cqframework/clinical_quality_language/Src/dotnet/readme.txt

Clinical Quality Language
.NET Tooling Support

This solution provides prototype implementations for:

* Visual Studio .NET 2013 Plugin to provide syntax highlighting for CQL libraries
* CQL-ELM Translator

For more information on these tools, refer to the Specification Overview document included with the specification materials.

Refer to the license.txt file for the license covering this software.
