cqframework/clinical_quality_language/Src/coffeescript/cql-execution/README.md

# New Location

The cql-execution framework has moved to its own repository.  You can now find the cql-execution framework here:
https://github.com/cqframework/cql-execution/
