cqframework/clinical_quality_language/Src/coffeescript/cql-execution/OVERVIEW.md

# New Location

The cql-execution framework has moved to its own repository.  You can now find the overview here:
https://github.com/cqframework/cql-execution/blob/master/OVERVIEW.md
