cqframework/clinical_quality_language/Documents/CQLUpdate_AllHands_20140904.pptx

## Clinical Quality Language Update

Clinical Quality Framework S&I Initiative
HL7 Clinical Decision Support
HL7 Clinical Quality Information
HL7 Implementable Technology Specifications

## Current Status

- CQL-ELM Translator
- Type Resolution
  - Model Info Structures
  - Primitive Type Resolution
  - Using Quick schema generated from UML
- Identifier Resolution
  - Libraries
  - Expressions
  - Functions
- Timing/Interval Operations
- Changes to ELM (from balloted spec) to match CQL

## Translation/Execution Overview

## Translation Example

exists ([Condition: "Chlamydia"])

<operand xsi:type="Exists">
<operand xsi:type="ClinicalRequest"
dataType="quick:ConditionOccurrence"
codeProperty="code" >
<codes name="Chlamydia" xsi:type="ValueSetRef"/>
</operand>
</operand>
