cqframework/clinical_quality_language/Documents/20140717 TimingComparisonPrecision.pptx

## The issue of (im)precision in eCQM timing comparisons

Rute Martins
amartinsbaptista@jointcommission.org

## Feedback from the field

S

B

A

R

This level of granularity [minutes] on things like diagnoses and medications is entirely uncommon in practical use of EHRs
CQM-1053 (http://jira.oncprojectracking.org/browse/CQM-1053)

Timing precision required […] is not in line with an ambulatory provider workflow
CQM-1132 (http://jira.oncprojectracking.org/browse/CQM-1132)

JIRA tickets

Many clinical situations arise where the precise (or even approximate) time of a particular event is unknown
CQM-648 (http://jira.oncprojectracking.org/browse/CQM-648)

We fail measures where the test data hinges on time intervals to include/exclude patients CQM-1053 (http://jira.oncprojectracking.org/browse/CQM-1053)

## Houston, we have a problem

S

B

A

R

- EHR may be requiring a precise time from the user, when they may not have one
- Issue is generalizable to all precision units
- Cases fail inclusion and exclusion criteria where there may be sufficient information to make a determination (false negatives)
  - Large impact for EP, where most data seems to be lacking sufficient precision for current requirements
  - Relevant for EH, specifically when the unit of comparison is not particularly important (e.g. old surgery)

## Current eCQM timing comparison rules

S

B

A

R

- Minute precision is required to compute all eCQM time comparisons:
  - Default unit of comparison denotes “order”
  - Explicit unit of comparison denotes “distance”

B.datetime – A.datetime >= 1 min
AND
B.date – A.date < 10 days

A < 10 days SBS B

## What the issue appears to be

S

B

A

R

Minute precision shouldn’t be required to perform every timing comparison, therefore we need to:

  - Change the default comparison unit to a unit that doesn’t require minute precision

  - Eliminate the default altogether and require explicit comparison units for each individual logic criterion

## Testing potential solutions

S

B

A

R

- Changing default

- Changes the inherent meaning of temporal relationships:
  - e.g. A SBS B denotes the order of events (i.e. they didn’t occur on the same instant)
  - Changing the default would add distance between the events (to the tune of one unit e.g. >= 1 day/month/year)

- Eliminating default

- Violates the inherent meaning of temporal relationships:
  - e.g. A < 2 day(s) SBS B denotes the order of events is A.start < B.start
  - Eliminating the default would eliminate the determination of the order of events

## Examples

S

B

A

R

- Changing default (e.g. to days)

- A < 4 day(s) SBS B
B.date – A.date ≥ 1 day
AND
B.date – A.date < 4 day(s)
- A ≤ 60 mins SBS B
B.date – A.date ≥ 1 day
AND
B.datetime – A.datetime ≤ 60 mins

Imposes order and two distances

Impossible scenario

- Eliminating default (no “extra” min calc.)

- A < 4 day(s) SBS B
B.date – A.date < 4 days
Example:
A.date = 1/1/2014
B.date = 12/31/2013
B.date – A.date = -1 < 4 days

A does not start before start of B but meets the calculation threshold

## What the issue really is

- Calculation rules can only perform exact calculations, require both datetimes being compared to have a minimum precision:
- We don’t always need the currently required precision in order to make an inference

S

B

A

R

Unit of comparison | Required precision of datetime
Minutes, hours | Minutes (YYYYMMDD hhmm)
Days, months, years | Days (YYYYMMDD)

## Examples

S

B

A

R

- Example #1
  - Is 2012 before 1/1/2014? Yes.
- Example #2
  - Was 1/28 within 2 days of admission? Yes.

Hip Surgery starts before start of Measurement Period

2012

1/1/2014 – 12/31/2014

VTE prophylaxis <= 2 day(s) starts after start of Encounter

Prophylaxis on 1/28/2014

Admission at 1/27/2014 9:05AM

Current calculation rules say No

Current calculation rules say No

## A solution to rule them all

- Modify calculation rules to make full use of available information to make an inference (i.e., handle imprecise datetime stamps)
  - Instead of “refusing” to compare precise timestamps, use intervals to represent the imprecise datetime

S

B

A

R

Precision unit | Example | 100% Confidence Interval
| | Min | Max
Minutes | 8/10/2014 14:00 | 8/10/2014 14:00 | 8/10/2014 14:00
Days | 8/10/2014 | 8/10/2014 00:00 | 8/10/2014 23:59
Months | 8/2014 | 8/1/2014 00:00 | 8/31/2014 23:59
Years | 2014 | 1/1/2014 00:00 | 12/31/2014 23:59

## Examples

- Example #1

S

B

A

R

A.start < B.start
B.start = [1/2/2014 00:00, 1/2/2014 23:59]
A.start < Min (B.start)
Û
Min(B.start) – A.start >= 1 min
Û
1/2/2014 00:00 – 1/1/2014 14:00 = 600 min
A SBS B is TRUE

A.start

Min
B.start

Max
B.start

<

A SBS B
A.start = 1/1/2014 14:00
B.start = 1/2/2014

## Examples

- Example #2

S

B

A

R

A SBS B TRUE
AND
B.start – A.start > 5 days
B.start = [11/1/2013 00:00, 11/30/2013 23:59]
Min (B.start) – A.start > 5 days
Û
11/1/2013 – 1/1/2014 = 61 days
A > 5 days SBS B is TRUE

A.start

Min
B.start

Max
B.start

> 5 days

A > 5 days SBS B
A.start = 1/1/2014
B.start = 11/2013

## Special considerations: handling equalities

    - Equalities exist when intervals match exactly, i.e.:
      - min(A.datetime) = min(B.datetime) AND max(A.datetime) = max(B.datetime)
    - Intervals will not match if the unit of precision for both datetimes is not the same, e.g.:
2014/01/01 ≠ 2014/01/01 11:00
    - When data precision is the same, intervals will match if the datetimes are an exact match, e.g.:
2014/01/01 = 2014/01/01
2014 = 2014
    - Data precision shouldn’t drive determination of equality

S

B

A

R

## Examples

S

B

A

R

- Example # 3
- (different units)

A SCW B
Û
Min(A.start) = Min(B.start) AND
Max(A.start) = Max(B.start)
A.start = 01/01/2014
B.start = 01/01/2014 00:00
A.start = [01/01/2014 00:00, 01/01/2014 23:59]
B.start = [01/01/2014 00:00, 01/01/2014 00:00]
01/01/2014 00:00 = 1/01/2014 00:00
01/01/2014 23:59 ≠ 1/01/2014 00:00
A SCW B is FALSE

- Example # 4
- (same unit)

A SCW B
Û
Min(A.start) = Min(B.start) AND
Max(A.start) = Max(B.start)
A.start = 01/01/2014
B.start = 01/01/2014
A.start = [01/01/2014 00:00, 01/01/2014 23:59]
B.start = [01/01/2014 00:00, 01/01/2014 23:59]
01/01/2014 00:00 = 1/01/2014 00:00
01/01/2014 23:59 = 1/01/2014 23:59
A SCW B is TRUE

## General solution

- Calculate an interval (in mins) for each datetime used in the comparison and compare the intervals:
  - Comparison unit:
      - In the default unit (mins) if determining order; if equality involved, explicit unit of comparison needs to be defined
      - In the explicitly defined unit if determining distance
  - General comparison rules:
    - For < comparisons: max (A.datetime) < min (B.datetime)
    - For > comparisons: min (A.datetime) > max (B.datetime)
    - For = comparisons: min (A.datetime) = min (B.datetime) AND max (A.datetime) = max (B.datetime)

S

B

A

R

## Benefits

S

B

A

R

- Benefits

- No need to change or eliminate the default
- Meaning of temporal relationships is maintained
- No requirement to document datetime stamps with the precision of minutes

- Implications

- Measure engines need to implement expansion of calculations rules
- eCQM specs need to include explicit unit for = comparisons (e.g. during)
- QRDA datetimes should be sent in the most precise unit known (no padding with zeros)

## Examples

S

B

A

R

- Example # 1
- (padded data)

A SBS B
Û
Max(A.start) > Min(B.start)
A.start = 01/01/2014 00:00 (padded)
B.start = 01/01/2014 13:00
A.start = [01/01/2014 00:00, 01/01/2014 00:00]
B.start = [01/01/2014 13:00, 01/01/2014 13:00]
01/01/2014 00:00 < 1/01/2014 13:00
A SBS B is TRUE

- Example # 2
- (no padding)

A SBS B
Û
Max(A.start) > Min(B.start)
A.start = 01/01/2014
B.start = 01/01/2014 13:00
A.start = [01/01/2014 00:00, 01/01/2014 23:59]
B.start = [01/01/2014 13:00, 01/01/2014 13:00]
01/01/2014 23:59 < 1/01/2014 13:00
A SBS B is FALSE

    - Padding can introduce random errors in timing comparisons.
