cqframework/clinical_quality_language/Documents/CQLUpdate_AllHands_20140604.pptx

## Clinical Quality Language (CQL)

Bryn Rhodes
Chris Moesel
Mark Kramer

## CQL Background

- Part of CQM-CDS harmonization project
- Objective is to define an author-friendly and human-readable language to define quality measures and decision support rules (QDM heritage)
- Must be computable and implementable (HeD heritage)
- Functional requirements defined in “Harmonization of Health Quality Artifact Reasoning and Expression Logic”

## Slide 3

Overview of CQL Conceptual Architecture

Initial Population Definition

Chlamydia Test Recommended

Defined by Rule/Measure authors using CQL

Probably Sexually Active

Intermediate inference

Concepts defined in Quality Logical Model (QUICK)

Condition, Occurrence

Patient

Medication Treatment, Ordered

Mappings from quality logical model to underlying data models

Integration with back-end data stores

FHIR Logic

FHIR API

EHR

…

Custom EHR Logic

EHR

…

CCDA Logic

CCDA Generator

EHR

REST API

e.g. SQL

## CQL File Structure

- Each library is a readable, plain text file
- May include other libraries by reference
- Logic in each file is potentially reusable by other libraries

Inputs
(parameters)

Declarations

Data Retrieval

Computation

May be comingled

Outputs

## CQL Declarations

- using declaration
  - Define the data model(s) in use in file
- include declaration
  - Define other libraries (CQL files) referenced
- context declaration
  - Define the overall context for the library (e.g. PATIENT or ENCOUNTER)
  - Anchors references in the file
- parameter declaration
  - Define available “inputs”
- valueset declaration
  - Define user-friendly labels for value sets within the library

## Simple Example

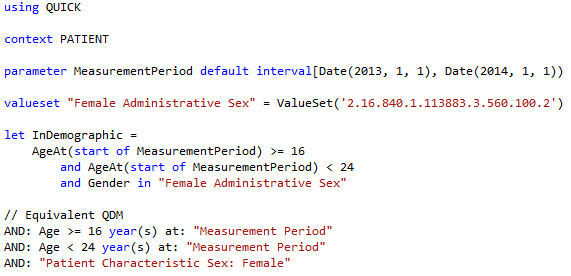
[picture p16: figure]

## Population Criteria

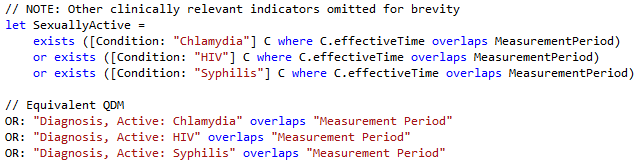
[picture p17: figure]

## Timing Phrases

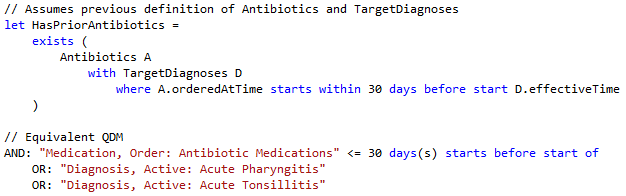
[picture p18: figure]

## Chlamydia Screening, CQM

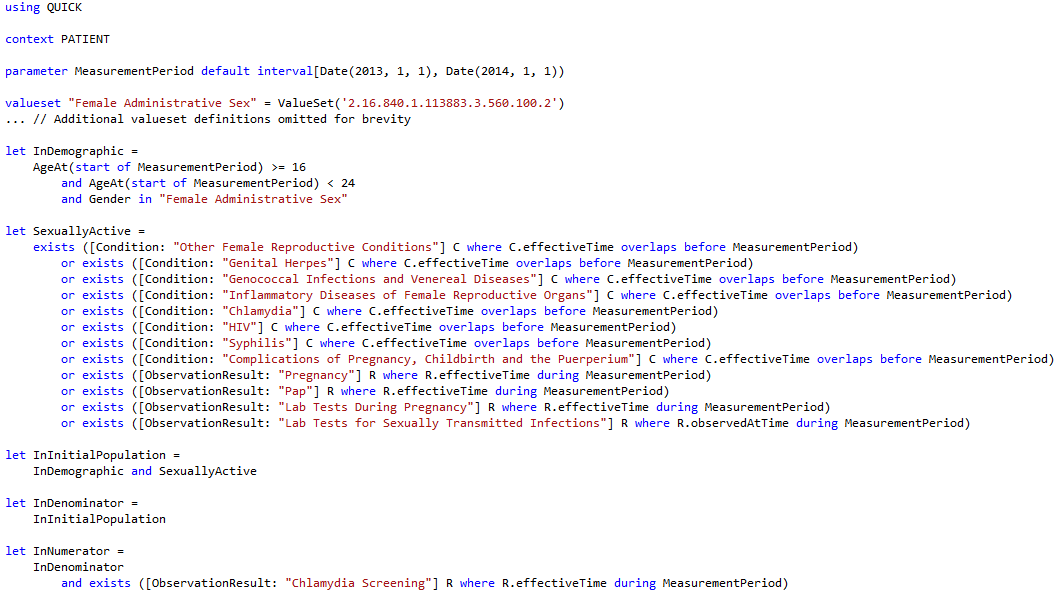
[picture p19: figure]

## Chlamydia Screening, CDS

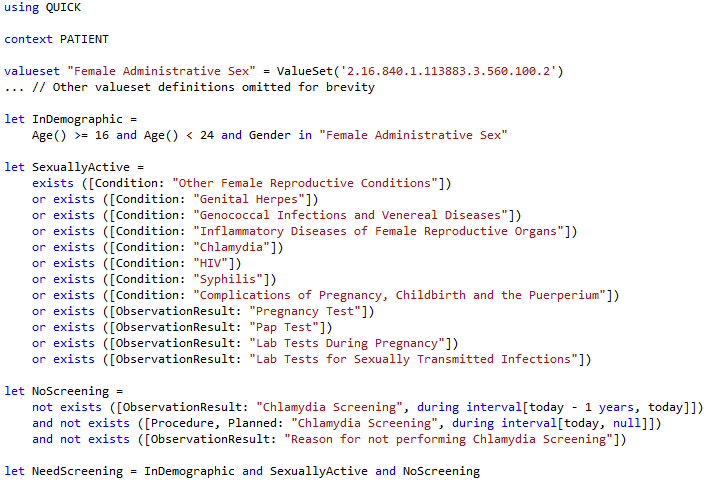
[picture p20: figure]

## Chlamydia Screening, Common


## Chlamydia Screening, CQM 2


## Chlamydia Screening, CDS 2


## Next Steps

- Still very much a work in progress
  - Completing/Refining the syntax
  - Mapping QUICK to FHIR
  - Performance/Implementation implications
  - Representation in XML artifacts
  - Clinical Quality Language Specification (ballot materials)
- Sub-team meets weekly, Wed 11:00 Eastern
  - https:// (https://global.gotomeeting.com/meeting/join/554237525)global.gotomeeting.com/meeting/join/554237525
  - Dial +1 770-657-9270, Participant Code: 6870541
- Using a common cqframework repository
  - https:// (https://github.com/cqframework/OneModel)github.com/cqframework/OneModel
