cqframework/clinical_quality_language/Documents/DataAccessSeparation_SideBySide.pptx

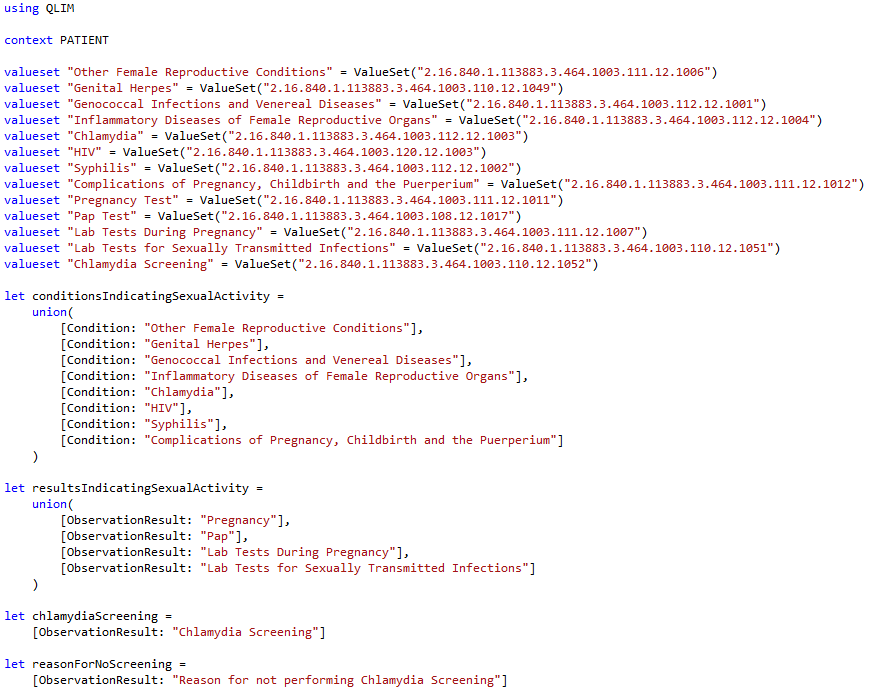
[picture p21: figure]

## Slide 2

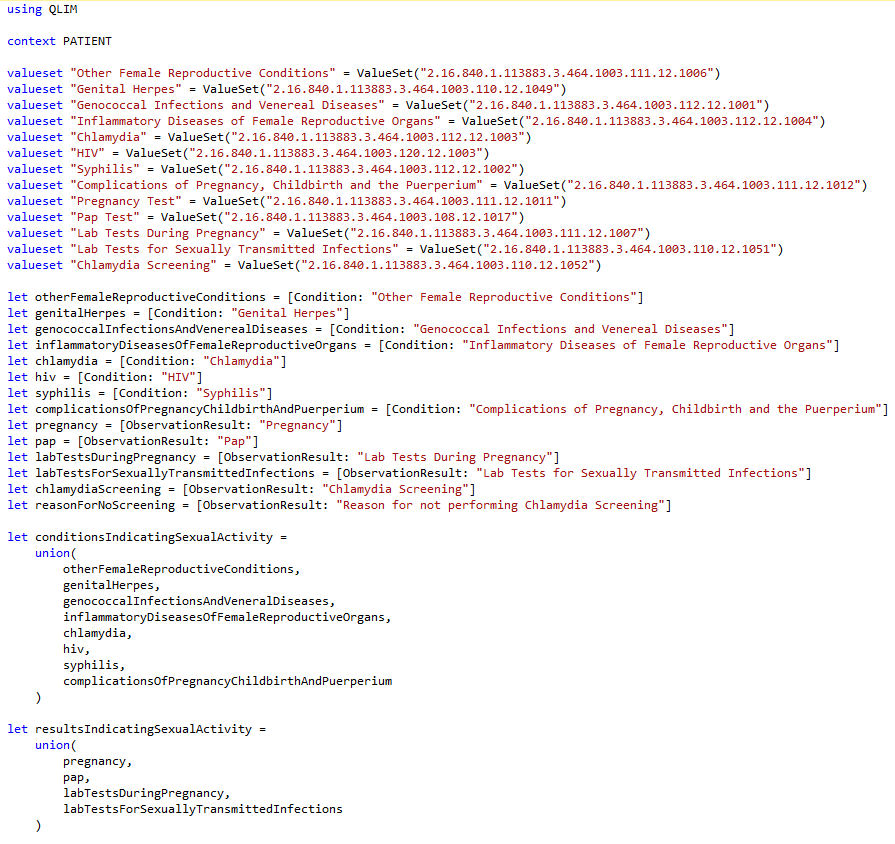
[picture p22: figure]
