cqframework/clinical_quality_language/Documents/WithAndCombine.pptx

## With Operator

The “with” filters the first operand (encounters in this case), by elements in the second operand (conditions) that match the criteria specified in the where. The result is the same type as the first operand (list<EncounterPerformed>).

## Combine Operator

The “combine” also returns only those rows that match in each operand, but it returns both sides of the operation.
So the result of this is of type list<tuple<E: Encounter, Performed, P: Condition>>
The problem is that because we don’t have a “select” clause we can’t name the attributes of the result, so we have to just use the aliases that were given in query. But that means…

## Subsequent Filtering

Subsequent operations have to deal with the “combined context” as it was labeled when the combine was defined. So in the first example, accessing the providerType attribute has to use E.E, instead of just E. We could allow implicit resolution, so the user could say E.providerType, but that would allow potentially ambiguous references.
In addition, we would have to make it illegal semantically to introduce an alias that was already present in a “combined context”, and we would have no way to perform a “rename” to get over that issue, it would force the users to understand this notion and write the queries accordingly. It’s not insoluble, I’m just concerned that it’s very complicated.

## Potential Solution

Allow an option “return” clause to be included in a query. This would allow the user to specify the names for each attribute.
If the clause was omitted, we would default the attribute names to the aliases used in the query.

## Potential Solution (cont.)

This would also allow a flattened result to be described as part of the query.
Thoughts?
