cqframework/clinical_quality_language/Documents/CQLUpdate_AllHands_20140529.pptx

## Clinical Quality Language

- Builds on functional requirements defined in:
  - Harmonization of Health Quality Artifact Reasoning and Expression Logic
- Leverages
  - Computability achieved by HeD
  - Measure Author understanding (QDM Heritage)
- Focus of the high-level syntax is on authoring
  - While providing a clear/automatic path to computable logic

## Slide 2

Underlying Language and Data Source are both variable

There are ways device use could be inferred - if not, return “unknown”

Some Population Definition

Chlamydia Test Recommended

BLUE = available concepts

DSL can reference high-level concept of “ChlamydiaTest”

In the same way that lower-level concepts can be referenced

Uses Device

Sexually Active

Condition

Procedure

Medication

Including the concepts explicitly defined in the “logical model”

e.g. Condition.evaluate (DataSource, Occurrence, Filter)

We implement at least this
e.g. as Java library

FHIR Logic

FHIR API

…

Custom EHR Logic

EHR

…

CCDA Logic

As well as Data Format Specific concepts that implement a common “data provider” interface in terms of the logical model

Back end data stores

REST API

e.g. SQL

## Anatomy of a Library

- using statements
  - Define the data model(s) in use by the library
- include statements
  - Define other libraries referenced by the library
- context definition
  - Define the overall context for the library (e.g. PATIENT or ENCOUNTER)
  - system-understood
  - in terms of the model
- parameter definitions
  - Define available “inputs”
- concept definitions
  - Define user-friendly labels for value sets within the library
- let statements
  - Define the expressions that are available within the library
  - Can be used by the containing artifact or other referencing libraries

## Simple Example

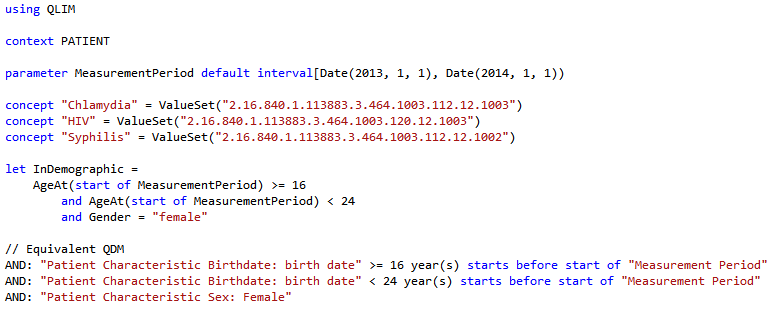
[picture p23: figure]

## Population Criteria

## Timing Phrases

## Chlamydia Screening, CQM

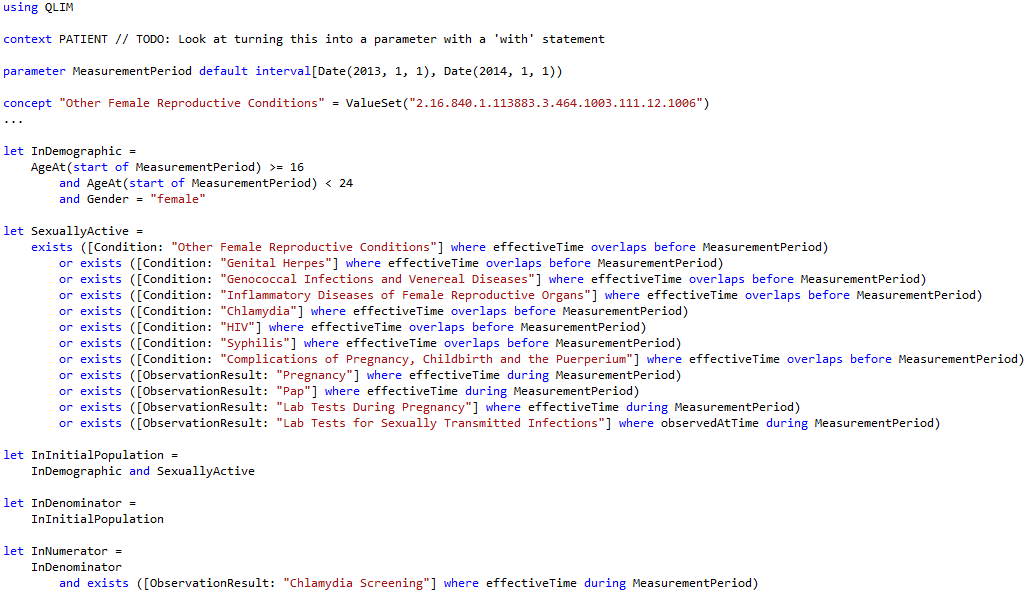
[picture p24: figure]

## Chlamydia Screening, CDS

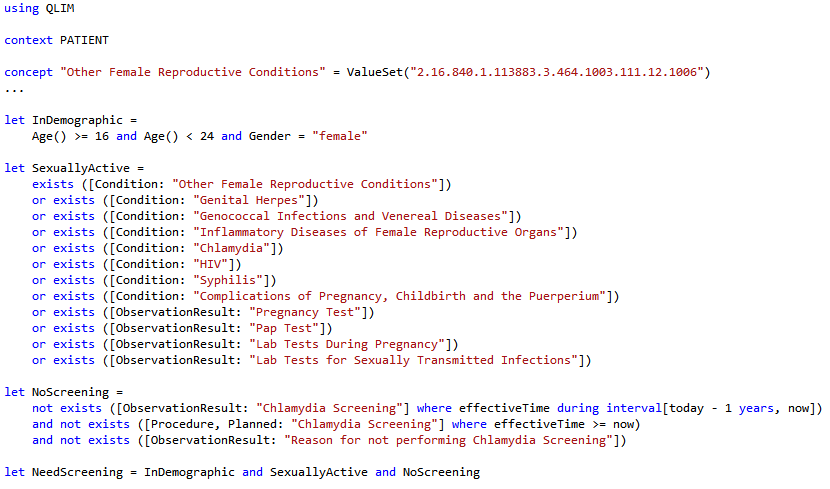
[picture p25: figure]

## Next Steps

- Still very much a work in progress
  - Completing/Refining the syntax
  - Mapping QLIM to FHIR
  - Performance/Implementation implications
  - Representation in XML artifacts
  - Clinical Quality Language Specification (ballot materials)
- Sub-team meets weekly, Wed 11:00 Eastern
- Will use the same Git repository as QLIM team
