cqframework/clinical_quality_language/engine-fhir/src/jvmTest/resources/org/opencds/cqf/cql/engine/fhir/data/EvaluatedResourcesMultiLibComplexDepsTest.md

# Test CQL Dependencies Flowchart

```mermaid
flowchart BT
    Level1A.cql --> Level2.cql
    Level1B.cql --> Level2.cql
    Level2.cql --> Level3A.cql
    Level3A.cql --> Level5.cql
    Level1B.cql --> Level3B.cql
    Level3B.cql --> Level4.cql
    Level4.cql --> Level5.cql
```
