cqframework/clinical_quality_language/(threads)

Thread 53 (2016-06-14):

need to specify version requirements for java files

ErichBSchulz, 2016-06-14:
in Src/java/README.md

ErichBSchulz, 2016-06-14:
fyi I just tried to build in java 6, 7, 8 and 9

6 and 7 both seemed to go furtherest but failed with

```:cql:test FAILED

FAILURE: Build failed with an exception.

* What went wrong:
Execution failed for task ':cql:test'.
> There were failing tests. See the report at: file:///usr/src/myapp/cql/build/repor
ts/tests/index.html

* Try:
Run with --stacktrace option to get the stack trace. Run with --info or --debug opti
on to get more log output.

BUILD FAILED
```

java8 failed with

```FAILURE: Build failed with an exception.

* Where:
Build file '/usr/src/myapp/elm/build.gradle' line: 12

* What went wrong:
Execution failed for task ':elm:generateSources'.
> unable to parse the schema. Error messages should have been provided
```

this was all using vanilla java dockers as specified here: https://hub.docker.com/_/java/

cmoesel, 2016-06-14:
As noted in the other issue (#54), JDK 1.8 is required -- and it's only been tested using the official Oracle JDK (not OpenJDK).  I wouldn't _expect_ OpenJDK to cause problems, but if we can't trace the problems to anything else, then it certainly _might_ be OpenJDK.

cmoesel, 2016-06-14:
I've updated the README to reflect that JDK 1.8 is required and to provide a link to the Oracle downloads for JDK 1.8.

ErichBSchulz, 2016-06-14:
thanks Chris - I'll see if I can get an oracle 1.8 Dockerfile up

worth noting [this](http://blog.takipi.com/running-java-on-docker-youre-breaking-the-law/) and the comments [here](https://hub.docker.com/_/java/) regarding oracle licencing tho.

ErichBSchulz, 2016-06-14:
fyi this is my dockerfile:

https://bitbucket.org/erichbschulz/cql_java/src/347dea68e43e69b54650c5fbd874a53ecbdef8e9/Dockerfile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

(because it was a shiny new docker vm this was a completely clean build)

I tried it again with the --info and --debug ...

this seems to be when the wheels fall off:

```
21:20:33.350 [DEBUG] [org.gradle.api.internal.project.ant.AntLoggingAdapter] Class com.sun.org.apac
he.xerces.internal.impl.dv.xs.SchemaDVFactoryImpl loaded from parent loader (parentFirst)
21:20:33.359 [DEBUG] [org.gradle.api.internal.project.ant.AntLoggingAdapter] Couldn't load Resource
Stream for META-INF/services/org.xml.sax.driver
21:20:33.360 [DEBUG] [org.gradle.api.internal.project.ant.AntLoggingAdapter] Couldn't load Resource
Stream for META-INF/services/org.xml.sax.driver
21:20:33.363 [ERROR] [org.gradle.api.internal.project.ant.AntLoggingAdapter] [ant:xjc] [ERROR] sche
ma_reference.4: Failed to read schema document 'file:/usr/src/cql-lm/schema/elm/library.xsd', becau
se 1) could not find the document; 2) the document could not be read; 3) the root element of the do
cument is not <xsd:schema>.
21:20:33.364 [ERROR] [org.gradle.api.internal.project.ant.AntLoggingAdapter] [ant:xjc] unknown loca
tion
21:20:33.364 [ERROR] [org.gradle.api.internal.project.ant.AntLoggingAdapter] [ant:xjc]
21:20:33.365 [INFO] [org.gradle.api.internal.project.ant.AntLoggingAdapter] [ant:xjc] failure in th
e XJC task. Use the Ant -verbose switch for more details
21:20:33.366 [DEBUG] [org.gradle.api.internal.tasks.execution.ExecuteAtMostOnceTaskExecuter] Finish
ed executing task ':elm:generateSources'
21:20:33.366 [LIFECYCLE] [class org.gradle.TaskExecutionLogger] :elm:generateSources FAILED
21:20:33.366 [INFO] [org.gradle.execution.taskgraph.AbstractTaskPlanExecutor] :elm:generateSources
(Thread[main,5,main]) completed. Took 3.439 secs.
21:20:33.367 [DEBUG] [org.gradle.execution.taskgraph.AbstractTaskPlanExecutor] Task worker [Thread[
main,5,main]] finished, busy: 4.23 secs, idle: 0.01 secs
21:20:33.373 [ERROR] [org.gradle.BuildExceptionReporter]
21:20:33.373 [ERROR] [org.gradle.BuildExceptionReporter] FAILURE: Build failed with an exception.

```

Closed 2016-06-14.

Thread 54 (2016-06-14):

build failing

ErichBSchulz, 2016-06-14:
I just tried to build in java 6, 7, 8 and 9 (using vanilla java dockers as specified here: https://hub.docker.com/_/java/)

6 and 7 both seemed to go furtherest but failed with

```
:cql:test FAILED

FAILURE: Build failed with an exception.

* What went wrong:
Execution failed for task ':cql:test'.
> There were failing tests. See the report at: file:///usr/src/myapp/cql/build/repor
ts/tests/index.html

* Try:
Run with --stacktrace option to get the stack trace. Run with --info or --debug opti
on to get more log output.

BUILD FAILED
```

java8 failed with

```
FAILURE: Build failed with an exception.

* Where:
Build file '/usr/src/myapp/elm/build.gradle' line: 12

* What went wrong:
Execution failed for task ':elm:generateSources'.
> unable to parse the schema. Error messages should have been provided
```

cmoesel, 2016-06-14:
We've never tested this using the Docker java, nor have we tested it using OpenJDK (which is what Docker is using).  It's possible that there's an issue somewhere in there, although it's hard to say.

It should work fine using the official Oracle Java SDK 1.8.0_x.  I am using 1.8.0_92 on Mac OS X and can build cleanly.  In addition, the [Travis builds](https://travis-ci.org/cqframework/clinical_quality_language) pass with Oracle JDK 1.8.0_31 (which actually run on a Linux Docker container of some sort).

I'd suggest you use 1.8 and try a clean build (in case there are build remnants messing things up):
```
./gradlew clean build
```

If it still doesn't work, might you be able to use a natively installed Oracle JDK rather than the dockerized OpenJDK?

ErichBSchulz, 2016-06-14:
Thanks Chris

I'm now on a dockerised oracle java 8 and I'm getting this:

```
:elm:generateSources FAILED

FAILURE: Build failed with an exception.

* Where:
Build file '/usr/src/myapp/elm/build.gradle' line: 12

* What went wrong:
Execution failed for task ':elm:generateSources'.
> unable to parse the schema. Error messages should have been provided

* Try:
Run with --stacktrace option to get the stack trace. Run with --info or --debug option to get more log output.

BUILD FAILED
```

`java -version ` gives:

```
java version "1.8.0_91"
Java(TM) SE Runtime Environment (build 1.8.0_91-b14)
Java HotSpot(TM) 64-Bit Server VM (build 25.91-b14, mixed mode)
```

brynrhodes, 2016-06-14:
Can you add the --debug option and see if we get more information about the error?

ErichBSchulz, 2016-06-14:
here we go:
```
23:37:16.124 [DEBUG] [org.gradle.api.internal.tasks.execution.ExecuteActionsTaskExecut
er                                                                                   ]
                                                                                     E
xecuting actions for task ':cql:compileJava'.
23:37:16.127 [INFO] [org.gradle.api.internal.changedetection.changes.RebuildIncrementa
lTaskInputs                                                                          ]
                                                                                     A
ll input files are considered out-of-date for incremental task ':cql:compileJava'.
23:37:16.136 [DEBUG] [org.gradle.api.internal.tasks.compile.NormalizingJavaCompiler] C
ompiler arguments: -d /usr/src/myapp/cql/build/classes/main -g -sourcepath /usr/src/my
app/cql/build/tmp/compileJava/emptySourcePathRef -classpath /root/.gradle/caches/modul
es-2/files-2.1/org.antlr/antlr4/4.5/af4a530e3cd7fa03636645d8077145eefac12907/antlr4-4.
5.jar:/root/.gradle/caches/modules-2/files-2.1/org.antlr/antlr4-runtime/4.5/29e48af049
f17dd89153b83a7ad5d01b3b4bcdda/antlr4-runtime-4.5.jar:/root/.gradle/caches/modules-2/f
iles-2.1/org.antlr/antlr-runtime/3.5.2/cd9cd41361c155f3af0f653009dcecb08d8b4afd/antlr-
runtime-3.5.2.jar:/root/.gradle/caches/modules-2/files-2.1/org.antlr/ST4/4.0.8/a1c55e9
74f8a94d78e2348fa6ff63f4fa1fae64/ST4-4.0.8.jar:/root/.gradle/caches/modules-2/files-2.
1/org.abego.treelayout/org.abego.treelayout.core/1.0.1/e31e79cba7a5414cf18fa69f3f0a2cf
9ee997b61/org.abego.treelayout.core-1.0.1.jar /usr/src/myapp/cql/src/main/java/org/cqf
ramework/cql/Main.java -XDuseUnsharedTable=true
23:37:16.136 [INFO] [org.gradle.api.internal.tasks.compile.JdkJavaCompiler] Compiling
with JDK Java compiler API.
23:37:16.333 [ERROR] [system.err] /usr/src/myapp/cql/src/main/java/org/cqframework/cql
/Main.java:6: error: package org.cqframework.cql.gen does not exist
23:37:16.333 [ERROR] [system.err] import org.cqframework.cql.gen.cqlLexer;
23:37:16.333 [ERROR] [system.err]                               ^
23:37:16.334 [ERROR] [system.err] /usr/src/myapp/cql/src/main/java/org/cqframework/cql
/Main.java:7: error: package org.cqframework.cql.gen does not exist
23:37:16.334 [ERROR] [system.err] import org.cqframework.cql.gen.cqlParser;
23:37:16.334 [ERROR] [system.err]                               ^
23:37:16.357 [ERROR] [system.err] /usr/src/myapp/cql/src/main/java/org/cqframework/cql
/Main.java:25: error: cannot find symbol
23:37:16.357 [ERROR] [system.err]         cqlLexer lexer = new cqlLexer(input);
23:37:16.357 [ERROR] [system.err]         ^
23:37:16.358 [ERROR] [system.err]   symbol:   class cqlLexer
23:37:16.358 [ERROR] [system.err]   location: class Main
23:37:16.358 [ERROR] [system.err] /usr/src/myapp/cql/src/main/java/org/cqframework/cql
/Main.java:25: error: cannot find symbol
23:37:16.358 [ERROR] [system.err]         cqlLexer lexer = new cqlLexer(input);
23:37:16.358 [ERROR] [system.err]                              ^
23:37:16.358 [ERROR] [system.err]   symbol:   class cqlLexer
23:37:16.358 [ERROR] [system.err]   location: class Main
23:37:16.359 [ERROR] [system.err] /usr/src/myapp/cql/src/main/java/org/cqframework/cql
/Main.java:27: error: cannot find symbol
23:37:16.360 [ERROR] [system.err]         cqlParser parser = new cqlParser(tokens);
23:37:16.360 [ERROR] [system.err]         ^
23:37:16.360 [ERROR] [system.err]   symbol:   class cqlParser
23:37:16.360 [ERROR] [system.err]   location: class Main
23:37:16.360 [ERROR] [system.err] /usr/src/myapp/cql/src/main/java/org/cqframework/cql
/Main.java:27: error: cannot find symbol
23:37:16.361 [ERROR] [system.err]         cqlParser parser = new cqlParser(tokens);
23:37:16.361 [ERROR] [system.err]                                ^
23:37:16.361 [ERROR] [system.err]   symbol:   class cqlParser
23:37:16.361 [ERROR] [system.err]   location: class Main
23:37:16.376 [ERROR] [system.err] 6 errors
23:37:16.378 [DEBUG] [org.gradle.api.internal.tasks.execution.ExecuteAtMostOnceTaskExe
cuter                                                                                ]
                                                                                     F
inished executing task ':cql:compileJava'
23:37:16.378 [LIFECYCLE] [class org.gradle.TaskExecutionLogger] :cql:compileJava FAILE
D
23:37:16.379 [INFO] [org.gradle.execution.taskgraph.AbstractTaskPlanExecutor] :cql:com
pileJava (Thread[main,5,main]) completed. Took 14.68 secs.
23:37:16.379 [DEBUG] [org.gradle.execution.taskgraph.AbstractTaskPlanExecutor] Task wo
rker [Thread[main,5,main]] finished, busy: 14.694 secs, idle: 0.002 secs
23:37:16.385 [ERROR] [org.gradle.BuildExceptionReporter]
23:37:16.385 [ERROR] [org.gradle.BuildExceptionReporter] FAILURE: Build failed with an
 exception.
23:37:16.386 [ERROR] [org.gradle.BuildExceptionReporter]
23:37:16.386 [ERROR] [org.gradle.BuildExceptionReporter] * What went wrong:
23:37:16.386 [ERROR] [org.gradle.BuildExceptionReporter] Execution failed for task ':c
ql:compileJava'.
23:37:16.386 [ERROR] [org.gradle.BuildExceptionReporter] > Compilation failed; see the
 compiler error output for details.
23:37:16.386 [ERROR] [org.gradle.BuildExceptionReporter]
23:37:16.387 [ERROR] [org.gradle.BuildExceptionReporter] * Try:
23:37:16.387 [ERROR] [org.gradle.BuildExceptionReporter] Run with --stacktrace option
to get the stack trace.
23:37:16.387 [LIFECYCLE] [org.gradle.BuildResultLogger]
23:37:16.388 [LIFECYCLE] [org.gradle.BuildResultLogger] BUILD FAILED
23:37:16.388 [LIFECYCLE] [org.gradle.BuildResultLogger]
```

ErichBSchulz, 2016-06-15:
here is full log of build in case you need that:

[build.txt](https://github.com/cqframework/clinical_quality_language/files/315193/build.txt)

brynrhodes, 2016-06-15:
It looks like the generateSources step didn't run for the cql project (that's where the Antlr4 generation is happening). That's the only thing I can see that would cause that error in the debug. Not sure why it wouldn't be running (and I don't see anything in the build.txt that indicates anything went wrong with downloading the Antlr dependency). Can you try running just the generateGrammarSource task? Maybe something's going wrong there that isn't showing up in the build logs here.

ErichBSchulz, 2016-06-15:
Happy too, but how do I do that?

Sent from pad please excuse brevity
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

ErichBSchulz, 2016-06-16:
ok different error now after manually firing `./gradlew generateGrammarSource`

```
00:04:45.892 [ERROR] [org.gradle.api.internal.project.ant.AntLoggingAdapte
r] [ant:xjc] [ERROR] schema_reference.4: Failed to read schema document 'f
ile:/usr/src/cql-lm/schema/elm/library.xsd', because 1) could not find the
 document; 2) the document could not be read; 3) the root element of the d
ocument is not <xsd:schema>.
00:04:45.894 [ERROR] [org.gradle.api.internal.project.ant.AntLoggingAdapte
r] [ant:xjc] unknown location
00:04:45.895 [ERROR] [org.gradle.api.internal.project.ant.AntLoggingAdapte
r] [ant:xjc]
00:04:45.903 [ERROR] [org.gradle.BuildExceptionReporter]
00:04:45.904 [ERROR] [org.gradle.BuildExceptionReporter] FAILURE: Build fa
iled with an exception.
00:04:45.904 [ERROR] [org.gradle.BuildExceptionReporter]
00:04:45.905 [ERROR] [org.gradle.BuildExceptionReporter] * Where:
00:04:45.905 [ERROR] [org.gradle.BuildExceptionReporter] Build file '/usr/
src/myapp/elm/build.gradle' line: 12
00:04:45.905 [ERROR] [org.gradle.BuildExceptionReporter]
00:04:45.905 [ERROR] [org.gradle.BuildExceptionReporter] * What went wrong
:
00:04:45.905 [ERROR] [org.gradle.BuildExceptionReporter] Execution failed
for task ':elm:generateSources'.
00:04:45.906 [ERROR] [org.gradle.BuildExceptionReporter] > unable to parse
 the schema. Error messages should have been provided
00:04:45.906 [ERROR] [org.gradle.BuildExceptionReporter]
00:04:45.906 [ERROR] [org.gradle.BuildExceptionReporter] * Try:
00:04:45.906 [ERROR] [org.gradle.BuildExceptionReporter] Run with --stackt
race option to get the stack trace.
```
[log1.txt](https://github.com/cqframework/clinical_quality_language/files/317416/log1.txt)

cmoesel, 2016-06-16:
Interesting.  It says it is not able to find the ELM XSD.  I remember seeing a previous error in one of your logs that looked like it couldn't find the CQL grammar.  So... it seems like it is having trouble finding some of the files in other source paths.  Is this possibly a docker thing with the file paths?

Did you checkout the whole _clinical-quality-language_ repository and leave it in-tact?  It looks like you may have modified some paths.  I noticed in the log above that it references a build file at `'/usr/
src/myapp/elm/build.gradle'`.   That's not a valid path in our repo (it _should_ be `'clinical-quality-language/Src/java/elm/build.gradle'`).  Are you trying to embed this code into a different codebase?  If so, that's probably your problem -- the elm module is expecting to find specific files and projects using relative paths within the _whole_ repo.  If you just copied out part of the repo, those parts of the build would fail.  Is that possibly what's going on?

Do you actually need/want to build the source code, or do you really just need to use it (unmodified) in your project?  If the latter, then you might be better off just using our jars from Maven Central: http://search.maven.org/#search%7Cga%7C1%7Cg%3A%22info.cqframework%22

ErichBSchulz, 2016-06-16:
ah thanks Chris - I just need to shift my mount point higher up the tree - I'm only mounting from Src/java down

standby :-)

cmoesel, 2016-06-16:
Great.  Let me know how it goes.  If successful, I wouldn't be surprised if you can also switch back to OpenJDK 8.  The mount point has probably been the problem all along.  Sorry I didn't notice it earlier!

ErichBSchulz, 2016-06-16:
ah that would be nice

its running now

would you like a nice docker image for the project to run in?

cmoesel, 2016-06-16:
Woot indeed!  Sorry it took so long to get here, but I'm glad we finally made it!  Thanks @brynrhodes for your help too!  Regarding a docker image, I'm (sadly) not really in this project much anymore -- so I'll let Bryn decide if he wants to pursue that.

I'm closing this issue, but please do come back and let us know if you try OpenJDK and it works!

ErichBSchulz, 2016-06-16:
all good - thanks for the help :-)

Closed 2016-06-16.

Thread 60 (2016-07-29):

Unable to Union different QDM Types

JSRankins, 2016-07-29:
Several eCQMs published in 2015 and 2016 have used "union" to group events that are of different types (CMS 100 v5, CMS 102 v5, CMS 107 v5, etc.). However, something like the following is causing an error to be thrown in the CQL-to-ELM validation:

define "Interventions":
      ["Intervention, Order"] union ["Intervention, Performed"]

The following error is being thrown:
Could not resolve call to operator Union with signature (list&lt;QDM.InterventionOrder&gt;,list&lt;QDM.InterventionPerformed&gt;).

Is this by design, or is this an issue in the current code?

cmoesel, 2016-07-29:
I believe that this is by design, in order to ensure type safety.  If you look at the signature for union in the appendix of the specification, you'll see:

```
union(left List<T>, right List<T>) List<T>
```

The arguments as well as the return are all lists of `T` -- meaning that the contained objects must have the same type.

It's probably worth looking at the measure to see if creating a union of these different types really is the best approach.  It may be that CQL provides a better path to achieve what the measure needs.  That's the first thing I'd do.

If that isn't possible, or if creating a union like this is really best, then you may be able to union these together by casting the list elements to `QDM.QDMBaseType` first.  I can't remember if you can cast a whole list at once, or if you'd have to use a query to transform the list into a list of casted objects.  Either way, you'd end up unioning two lists of `QDM.QDMBaseType`, resulting in a list of `QDM.QDMBaseType`.

JSRankins, 2016-07-29:
Thanks Chris. I'll try both approaches. Ultimately, I think the Measure Stewards are going to need to know this for their measures. It might be a good thing to send to @brynrhodes for one of the Cooking With CQL trainings. Bryn, what do you think?

brynrhodes, 2016-08-15:
Yep, this would be a great example for inclusion in a measure training, I'll add it to my list. As far as casting, there isn't a list-based cast, you'd have to do a query and return the resulting type. Another option is to shape each operand so that they both contain the same columns, then you wouldn't need to cast. Am I okay to close this issue?

JSRankins, 2016-08-15:
Yes.

>>> Bryn Rhodes <notifications@github.com> 8/15/2016 1:44 PM >>>

Yep, this would be a great example for inclusion in a measure training, I'll add it to my list. As far as casting, there isn't a list-based cast, you'd have to do a query and return the resulting type. Another option is to shape each operand so that they both contain the same columns, then you wouldn't need to cast. Am I okay to close this issue?

—
You are receiving this because you authored the thread.
Reply to this email directly, view it on GitHub, or mute the thread.

 {"api_version":"1.0","publisher":{"api_key":"05dde50f1d1a384dd78767c55493e4bb","name":"GitHub"},"entity":{"external_key":"github/cqframework/clinical_quality_language","title":"cqframework/clinical_quality_language","subtitle":"GitHub repository","main_image_url":"https://cloud.githubusercontent.com/assets/143418/17495839/a5054eac-5d88-11e6-95fc-7290892c7bb5.png","avatar_image_url":"https://cloud.githubusercontent.com/assets/143418/15842166/7c72db34-2c0b-11e6-9aed-b52498112777.png","action":{"name":"Open in GitHub","url":"https://github.com/cqframework/clinical_quality_language"}},"updates":{"snippets":[{"icon":"PERSON","message":"@brynrhodes in #60: Yep, this would be a great example for inclusion in a measure training, I'll add it to my list. As far as casting, there isn't a list-based cast, you'd have to do a query and return the resulting type. Another option is to shape each operand so that they both contain the same columns, then you wouldn't need to cast. Am I okay to close this issue?"}],"action":{"name":"View Issue","url":"https://github.com/cqframework/clinical_quality_language/issues/60#issuecomment-239890653"}}}

JSRankins, 2016-08-24:
Sorry for just responding. You can close this issue.

Closed 2016-08-18.

Thread 61 (2016-08-19):

Annotations in JSON

brynrhodes, 2016-08-19:
Annotations in XML work as expected because the content of the annotation is an html fragment. However, when the ELM is output as JSON, the rendering is very difficult to reconstruct. There needs to be a better way to communicate the content of the annotation when the output is formatted using JSON.

pkmitre, 2016-08-29:
The current XML annotation is difficult to represent in JSON because the XML uses mixed content, ie

    <annotation xsi:type="a:Annotation">
      <a:s r="27">
        define PatientAge:
        <a:s r="26">
          AgeInYearsAt(
          <a:s r="25">
            start of
            <a:s r="24">MeasurementPeriod</a:s>
          </a:s>
          )
        </a:s>
      </a:s>
    </annotation>

In the JSON, all of the text strings within a tag, regardless of ordering relationship to other neighbor tags, are simply represented as an array of strings, ie

                    "value": [
                      "AgeInYearsAt",
                      "(",
                      ")"
                    ]

The relationship of the strings to the other tags is not preserved. Would it work to simply avoid the use of mixed content? For example, something like

    <annotation xsi:type="a:Annotation">
      <a:s r="27">
        <a:s>define PatientAge:</a:s>
        <a:s r="26">
          <a:s>AgeInYearsAt(</a:s>
          <a:s r="25">
            <a:s>start of</a:s>
            <a:s r="24">MeasurementPeriod</a:s>
          </a:s>
          <a:s>)</a:s>
        </a:s>
      </a:s>
    </annotation>

This could be represented in unambiguous JSON.

brynrhodes, 2017-03-23:
This issue was corrected by pull request #94 and the fix will be included in the next release.

Closed 2017-03-23.

Thread 63 (2016-08-24):

QDM 5.0 Model Info

JSRankins, 2016-08-24:
Questions about the following file: https://github.com/cqframework/clinical_quality_language/tree/modelinfo-profiles/Src/java/qdm/src/main/resources/gov/healthit/qdm/qdm-modelinfo-5.0.xml

**First:** The file contains the following label values for the patient characteristic datatypes:

- Patient Characteristic: Birthdate
- Patient Characteristic: Clinical Trial Participant
- Patient Characteristic: Ethnicity
- Patient Characteristic: Expired
- Patient Characteristic: Payer
- Patient Characteristic: Race
- Patient Characteristic: Sex

Based on the draft QDM 5.0 document (https://ecqi.healthit.gov/system/files/qdm_5_0_draft_.pdf), none of these datatypes contain colons.

**Second:** It appears that the generic "Patient Characteristic" datatype is missing from the model info file. Since this datatype is part of QDM 5.0, how is this datatype being handled?

**Third:** There is a typo for the DeviceApplied element anatomialLocationSite - should be anatomi**c**alLocationSite

brynrhodes, 2016-09-06:
Agreed on all counts, thank you for the detailed review. These changes have been made to the 5.0 and 5.0.1 xsd and model info files.

Closed 2016-09-06.

Thread 65 (2016-08-30):

Minimum date test case

brynrhodes, 2016-08-30:
[Minimum Date Test Case CQLIT-17](https://oncprojectracking.healthit.gov/support/browse/CQLIT-17)

i note the spec says (p154):

Description:
The DateTime type represents date and time values with potential uncertainty within CQL.
CQL supports date and time values in the range @0001-01-01T00:00:00.0 to @9999-12-
31T23:59:59.999 with a 1 millisecond step size.

however there there is a test case defined which suggest this should throw:

define Predecessor_min_date: predecessor of DateTime(1900,01,01,0,0,0,0)

https://github.com/cqframework/clinical_quality_language/blob/master/Src/coffeescript/cql-execution/test/elm/arithmetic/test.coffee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

cmoesel, 2016-08-30:
I can't say for sure, but I suspect that this is due to the fact that the execution framework was written while the spec was still evolving.  Perhaps when this test was written (Dec 2014), the minimum date _was_ 1900.  At any rate, hopefully it's a single line fix here:

https://github.com/cqframework/clinical_quality_language/blob/dd0c71ce148652242ec0f6bc3493db1a07a30527/Src/coffeescript/cql-execution/src/util/math.coffee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

and here:

https://github.com/cqframework/clinical_quality_language/blob/dd0c71ce148652242ec0f6bc3493db1a07a30527/Src/coffeescript/cql-execution/src/datatypes/datetime.coffee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

(plus whatever tests need to be modified to compensate).

cmoesel, 2017-06-12:
Fixed in #121

Closed 2017-06-12.

Thread 76 (2016-09-28):

Issue with code declarations

jackcmeyer, 2016-09-28:
@brynrhodes When running the following file through the updated CQL-to-ELM translator, I get the following errors:

```
Translation failed due to errors:
[23:1, 23:63] Type name Code is ambiguous between Code and System.Code.
[25:1, 25:65] Type name Code is ambiguous between Code and System.Code.
[39:19, 39:60] Could not resolve identifier Dead in the current library.
[41:20, 41:68] Could not resolve identifier Birthdate in the current library.
```

```
library Test0709282016 version '0.0.000'

using QDM version '5.0'

codesystem "CDCREC:1.0": 'urn:oid:2.16.840.1.113883.6.238' version 'urn:hl7:version:1.0'

codesystem "AdministrativeGender:HL7V3.0_2014-08": 'urn:oid:2.16.840.1.113883.5.1' version 'urn:hl7:version:HL7V3.0_2014-08'

codesystem "SOP:5.0": 'urn:oid:2.16.840.1.113883.3.221.5' version 'urn:hl7:version:5.0'

codesystem "LOINC:2.46": 'urn:oid:2.16.840.1.113883.6.1' version 'urn:hl7:version:2.46'

codesystem "SNOMEDCT:2016-03": 'urn:oid:2.16.840.1.113883.6.96' version 'urn:hl7:version:2016-03'

valueset "ONC Administrative Sex": 'urn:oid:2.16.840.1.113762.1.4.1' codesystems {"AdministrativeGender:HL7V3.0_2014-08"}

valueset "Race": 'urn:oid:2.16.840.1.114222.4.11.836' codesystems {"CDCREC:1.0"}

valueset "Ethnicity": 'urn:oid:2.16.840.1.114222.4.11.837' codesystems {"CDCREC:1.0"}

valueset "Payer": 'urn:oid:2.16.840.1.114222.4.11.3591' codesystems {"SOP:5.0"}

code "Dead": '419099009' from "SNOMEDCT:2016-03" display 'Dead'

code "Birthdate": '21112-8' from "LOINC:2.46" display 'Birthdate'

parameter "Measurement Period" Interval<DateTime>

context Patient

define "SDE Ethnicity": ["Patient Characteristic Ethnicity": "Ethnicity"]

define "SDE Payer": ["Patient Characteristic Payer": "Payer"]

define "SDE Race": ["Patient Characteristic Race": "Race"]

define "SDE Sex": ["Patient Characteristic Sex": "ONC Administrative Sex"]

define "TestDef": ["Patient Characteristic Expired": "Dead"]

define "TestDef2": ["Patient Characteristic Birthdate": "Birthdate"]
```

Thoughts?

brynrhodes, 2016-09-29:
This error was due to an invalid type declaration in the QDM model info. It mistakenly included a "Code" type, which the compiler then confused with the "System.Code" type.

I've corrected the issue for both QDM 5.0 and 5.0.1 (and a few others), and am updating the snapshots now.

Closed 2016-09-29.

Thread 82 (2017-02-10):

Escaped chars not translated to ELM correctly?

cmoesel, 2017-02-10:
Given the following CQL:
```
define EscapeExample: 'Hello \'World\''
```
the CQL-to-ELM translator produces:
```json
{
  "name" : "EscapeExample",
  "context" : "Patient",
  "accessLevel" : "Public",
  "expression" : {
    "valueType" : "{urn:hl7-org:elm-types:r1}String",
    "value" : "Hello \\'World\\'",
    "type" : "Literal"
  }
}
```

Is this intentional?  I would have expected the ELM to remove the escape characters since they're no longer necessary (rather than double-escaping them).  In other words, I expected `"value" : "Hello 'World'"`, not `"value" : "Hello \\'World\\'"`.

brynrhodes, 2017-03-22:
So, this was quite the rabbit-hole :) Yes, the CQL-to-ELM translator was not correctly dealing with escape sequences in strings and identifiers, so I added logic to escape/unescape CQL literals and identifiers, and a unit test to verify it. Along the way, I found an issue with the CQL grammar itself, the way strings and identifiers are defined slightly too greedily, which results in an edge case with escape characters, specifically the backslash escape (`\\`) isn't handled properly. Because that's a specification change, I can't fix that until the grammar changes in the spec, so I've submitted an STU comment to address that, and until then, I've commented out the affected tests in the unit test.

However, having fixed all that and verified that escape sequences are being handled correctly for all possible escape sequences in both strings and identifiers, the output in the XML is still `Hello \'World\'` instead of the simpler `Hello 'World'`. In the JSON, the value is the simpler, but apparently, the escape logic for XML escapes single-quotes.

So I'm committing the fix I have so far, but leaving this issue open until the full fix can be applied based on the spec change.

cmoesel, 2017-03-22:
That's a reasonable approach.  Thanks for looking into this.  If it works in JSON, I'm happy for now!

brynrhodes, 2017-03-29:
Submitted CQL STU comment #1317 to address the STRING and QUOTEDIDENTIFIER lexical rules. (A similar fix was applied to the FHIRPath specification).

brynrhodes, 2017-03-29:
Released in v1.1.1-SNAPSHOT

Closed 2017-03-29.

Thread 88 (2017-03-06):

CQL-to-ELM DSTU2 translator fails with choice properties

nkarip, 2017-03-06:
CQL-to-ELM translator for DSTU2 Observation “Obs.effectiveDateTime” does not work, error is "Member effectiveDateTime not found for type FHIR.Observation". The parent choice element “Obs.effective" does not cause errors. The effectiveDateTime property exists in DSTU2 Observation and the equivalent path works in ELM.

brynrhodes, 2017-03-23:
Could not reproduce on 1.1 translator, will try with 1.2 translator.

brynrhodes, 2018-01-09:
@sotty, the patch you've proposed is for this issue. Can you post a reproduction for the specific issue you are seeing?

Thread 89 (2017-03-06):

FHIRHelpers source should be included by default as part of the FHIR model

nkarip, 2017-03-06:
CQL-to-ELM translation fails with error "Could not resolve library name FHIRHelpers" if library is not included in current working directory. Per Bryn, FHIRHelpers source should be included by default as part of the FHIR model so that the libraries don't have to be distributed.

brynrhodes, 2017-03-29:
Released in v1.1.1-SNAPSHOT

Closed 2017-03-29.

Thread 109 (2017-04-22):

Unintuitive interpretation of some interval operator phrases

brynrhodes, 2017-04-22:
There is an ambiguity in the specification related to the interpretation of timing relationships. Specifically, given this example:

    define Interval1: Interval[@2012-01-01T09:00:00.0, @2012-01-01T10:30:00.0]
    define Interval2: Interval[@2012-01-01T11:00:00.0, @2012-01-01T18:00:00.0]
    define Within1: Interval1 ends 1 hour or less before start of Interval2

The specification implies in the definition of timing relationships (2.5.5.3) that this should return `true`, but then describes in 5.5.3.2 that it should be interpreted as a duration between that would return `false`.

The problem is that there are two boundaries involved in the comparison "X 1 hour or less before Y":

1) The boundary specified by the "before", which is exclusive by the definition of the "before" operator.
2) The boundary specified by the relative qualifier, "1 hour or less", which is clearly inclusive.

In this particular case, those boundaries meet and so the interpretation is ambiguous. (In the case of "1 hour or more" the boundaries don't meet, so there is no ambiguity and you get the intuitive behavior).

The translator should be updated to provide the intuitively correct behavior by having the inclusive boundary of the relative qualifier override the exclusive boundary of the comparison operator.

An STU comment has been submitted to the specification to clarify the ambiguity:
http://www.hl7.org/dstucomments/showdetail_comment.cfm?commentid=1336

cmoesel, 2017-04-24:
If the inclusive boundary overrides the exclusive boundary, then does that mean that if `X` was _at the same exact time_ as `Y`, then `X 1 hour or less before Y` would be `true`?  I think that's _better_ than the current behavior, but now it violates the `before` part of the relationship (since happening at the same time is _not_ before).

A more correct translation might be a logical `and` of `X before Y` and `hours between X and Y <= 1`.  Its more complex, but I _think_ more semantically correct -- because we really mean to capture the interval from 1 hour before Y right up until (and including) the _millisecond before_ Y.  Would you agree?

brynrhodes, 2017-04-24:
So, I think that `X 1 hour or less before Y` _would_ be `true` if `X` is at the exact same time as `Y` (because I said an hour or less, and 0 hours is less than 1 hour). The more that I think about this case, the more that I think it overrides the exclusive definition of the before. In fact, I think it's even broader than I initially proposed above; consider `X 1 hour before Y`. Intuitively, if `X` is exactly 1 hour before `Y`, it should return true, but based on the exclusive definition of before, it should return false.

In other words, I think the relative qualifiers should override the exclusivity of the before/after comparison operator in all cases, not just where the two boundaries meet. Thoughts?

cmoesel, 2017-04-24:
I'm afraid I don't agree that if `X` is the same as `Y`, that `X 1 hour or less before Y` _should_ be true.  I see `1 hour or less` as a qualifier of `X before Y` ("how much before Y?").  It shouldn't change the general relationship of `X before Y`.  If you consider it a qualifier, then it follows that the set of `X` that fulfills `X 1 hour or less before Y` should be a _subset_ of the set of `X` that fulfills `X before Y`.  If we allow `X same as Y`, then that's not true.

I probably come with this set of assumptions because this is how QDM execution of timing relationships works.  _First_ it checks that the general relationship is true (`X before Y`) and _then_ it checks that the delta fits within the specified range.  This is described in section 3.8 of the QDM 4.3 specification:

> Note that when filtering out data elements that do not meet temporal constraints (Step 6), first the timing relationship is evaluated using minute granularity and then the delta (if specified) is evaluated using the granularity of the specified timing unit. For example, `< 3 day(s) starts before start of` would first evaluate if the `starts before start of` constraint is met. If so, it would then determine if the delta is less than 3 days.

In QDM, if you wanted to include the RHS (instead of excluding it), there is a special `or concurrent with` construct for that: `< 3 days(s) start before or concurrent with start of`.

brynrhodes, 2017-04-24:
So, I agree there ought to be a way to say `X before or at Y`, but I see that as a different issue, and I think it's both unintuitive and unnecessarily complicated to use that mechanism to get the desired behavior here; that would mean you'd have to say: 'X 1 hour or less before or at Y`, which feels pretty unnatural to me. If I say, I'll pick you up an hour or less before 8:00, would you be surprised if I showed up at 8:00 exactly?

cmoesel, 2017-04-24:
I might not be surprised if you showed up at 8:00, but I'd consider you late since you said you'd be here before 8:00. ;-)

I think that the expectation of things really depends on the use case.  But I expect there are many cases where authors really want to ensure the _order_ of things, and establish that X did occur _before_ y within a certain window.  For example, I want to ensure that a patient was diagnosed with `X` 6 weeks or less before Encounter `Y` -- if the patient is diagnosed _at_ Encounter `Y`, then the CQM/CDS does not apply.  If we make the `X 6 weeks or less before Y` _include_ `Y`, then an author would have to say:  `X before Y and X 6 weeks or less before Y`.  That's awkward as well (seemingly redundant to me).

Clearly there is room for interpretation here -- and we need to do whatever is most consistent with the rest of CQL and least surprising to authors.  I just happen to think that overriding an exclusive boundary is less consistent w/ the spec, and that it will be surprising to QDM authors who are familiar w/ how QDM works.  But perhaps it would make sense to bring this up with real authors who will use the spec?

This is a total aside, but it also strikes me that the current way ELM does duration (by counting _whole_ units of time) almost implies that the correct phrase would be "6 weeks or fewer" (since it's countable units) rather than "6 weeks or less" (which implies more of a continuum).  But now I'm just getting nerdy.

brynrhodes, 2017-04-24:
I didn't say "before" though, I said "an hour or less before" :)

I agree it would definitely be awkward to have to state the before again in the case where you really do want exclusive behavior.

I agree it needs discussion with the authors, it's on the agenda already for an upcoming meeting. I'll bring the results of that discussion back here.

brynrhodes, 2017-04-27:
Quite apart from whether the expression returns true for events occurring at the same time, the result that an event occurring 30 minutes before doesn't return true either is pretty surprising. So it seems worth revisiting, should "X 1 hour or less before Y" return true if X is 30 minutes before Y? You can get that behavior by saying "X 1 hour or less before minute of Y", of course, but then, what about if X is 30 seconds before Y? Thoughts?

cmoesel, 2017-04-27:
Oh -- I totally agree that "X 1 hour or less before Y" _should_ return `true` when X is 30 minutes before Y.  The way it currently works is definitely surprising.  I think it is because we think of time as a continuum -- so when I say "less than an hour", I mean _every single moment_ less than an hour.

brynrhodes, 2017-04-27:
So, looking through the specified interpretations, I think this can be corrected quite simply by saying the timing phrases should be interpreted in terms of comparison operators on the boundaries, rather than by using a duration calculation. Do you see any issues with that approach?

cmoesel, 2017-04-27:
So do you mean that `X 1 hour or less before Y` would be translated as `X same as or after (Y - 1 hour) and X before Y` -- or perhaps even `X in [Y - 1 hour, Y)`?

brynrhodes, 2017-04-27:
Yes, that's what I was thinking, and the in formulation is just a shorthand for the equivalent comparisons.

brynrhodes, 2017-04-27:
On this issue, feedback from the focus group today was that the before should always be interpreted exclusively and that there should be an additional "or on"/"on or" qualifier added to support the case where an inclusive boundary is needed. So the same as the "or concurrent with" qualifier in QDM (but hopefully a little more concise.

cmoesel, 2017-04-27:
What does the inclusive variety look like in the context of a full expression?  For example, how do I make `X 1 hour or less before Y` inclusive?  Also, was using "or same as"/"same as or" considered for consistency with existing CQL timing operators?

brynrhodes, 2017-05-17:
Sorry for the delay, so.... it looks like:

    X 1 hour or less on or before Y

Yes, we considered `same as` for consistency with the comparison phrasing, but it's very unnatural:

    X 1 hour or less same or before Y

No one would ever say that or intuit what it means.

brynrhodes, 2017-06-01:
CDS WG and measure developers all agreed with the change and it was approved as STU comment 1337 on Wednesday's call. The change has been applied to the specification and the translator.

Closed 2017-06-01.

Thread 112 (2017-05-08):

Compilation Error when imported the java-quickstart project into Eclipse

ishwaryaakkiah, 2017-05-08:
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

ishwaryaakkiah, 2017-05-08:
Please kindly provide solution for this. Couldn't find any related jar for these errors.

ishwaryaakkiah, 2017-05-10:
Hi noone to help for this issue? Seriously going hectic with this CQl.Please kndly provide some solution..How to execute CQL in eclipse? Please help out.

brynrhodes, 2017-05-10:
Hi @ishwaryaakkiah, I haven't tried to run the java quickstart from Eclipse, so I'm not sure what the error you are seeing is. Are you able to run the quickstart using just Gradle and following the readme [here](https://github.com/cqframework/clinical_quality_language/blob/master/Src/java-quickstart/README.md)?

ishwaryaakkiah, 2017-05-10:
Hi Bryn,
     I have tried today to run cqltoelm program in eclipse by using gradle
build system. Was able to convert the cql to json and XML..
Can I please know few details regarding CQL.
1). What is the flow for a complete project using CQL?
2). What is the input data provided for CQL? What format is the input?
3).How is the output (JSON/XML) from CQL is processed further??

Can you please help me out with this? I surfed through all sites,but
couldn't get exactly what I am searching for..

Looking forward from you..
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

ishwaryaakkiah, 2017-05-12:
Hi Bryn,
    Can I please know how to build custom data model for CQL? Please
provide me steps for the same. Really need your help.

Thanks & Regards

 Ishwarya Akkiah

Software Engineer, BORN

[image: Group GMG Logo]

2nd Floor, Hardy Tower, Ramanujan IT SEZ,

TRIL Infopark Limited, Taramani, Chennai - 600113

www.borngroup.com

On Wed, May 10, 2017 at 10:35 PM, Ishwarya Akkiah <
ishwarya.akkiah@borngroup.com> wrote:

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

cmoesel, 2017-05-12:
Hi Ishwarya,

If you haven't seen it already, the CQL specification may be able to clear up some of your questions: http://www.hl7.org/implement/standards/product_brief.cfm?product_id=400

Regarding your specific questions:

> What is the flow for a complete project using CQL?

I'm not entirely sure what you mean, but I guess an end-to-end flow might look like:
1. Usually eCQM/CDS is backed by evidence.  So the first step is to gather the evidence, determine feasibility, etc., and perhaps write pseudo code to prepare for more formal CQL authoring.
2. Write the CQL.  This is also when you need to choose a data model (FHIR 1.0.2, FHIR 3.0.0, QDM, etc).  The CQL author will likely want to use the CQL-to-ELM tool during authoring to ensure syntactic validity of the CQL.
3. Convert CQL to ELM.  As you already know we have a tool for this.  You can also use Gradle's `installDist` task to create a local script (bash or bat) to easily launch CQL-to-ELM at the commandline.  We convert to ELM for two reasons: (a) it verifies there are no syntactic errors in the CQL, and (b) CQL execution platforms usually execute against ELM, not CQL, because ELM is easier for machines to parse (it's essentially an Abstract Syntax Tree).
4. Testing.  Ideally, there would be tests to ensure the CQL works as expected -- perhaps passing in synthetic health records and verifying the CQL calculates the correct answers.  Of course, this requires a way to execute the CQL.  There are a couple of open source CQL interpreters/executors out there ([here](https://github.com/cqframework/clinical_quality_language/tree/master/Src/coffeescript/cql-execution) and [here](https://github.com/DBCG/cql_engine)).
5. Integration.  Finally, integrating it in a real environment.  How exactly this works will depend on the environment and may use some of the open source components available or may use a proprietary implementation of CQL.

> What is the input data provided for CQL? What format is the input?

CQL doesn't really say what format the input data must be in, but a CQL implementation will interact with the data using the form of the data model identified in the CQL.  For example, if the CQL uses the FHIR 3.0.0 data model, then the CQL will query and process data using FHIR 3.0.0 data types and attributes.  It's likely easiest if the data itself is in the FHIR 3.0.0 format, but it's possible to operate against data in a different format if there is an adaptor to do the translation.

The CQL spec doesn't really say much about how this should be implemented in a runtime.  For some implementations, input data might be retrieved in real time, _as the CQL is being processed_.  This required the implementation to know how to physically retrieve the data from the system.  Other implementations expect _all_ of the required data to be passed into the CQL implementation _with_ the CQL execution request -- so the CQL implementation doesn't need to know the details of the system that houses the data.

In the two open source CQL engines I linked above, I believe that one (the Java one) queries data from a FHIR database, and the other (the CoffeeScript one) expects all data to be provided as a JSON array of FHIR resources.

> How is the output (JSON/XML) from CQL is processed further?

That's up to the implementation -- but Section 5 in the CQL specification includes some guidance about implementation.

> Can I please know how to build custom data model for CQL?

In our reference implementations, we use what we call a _model-info_ file to describe the data model.  This _model-info_ can be passed into the CQL-to-ELM translator to be used during the translation.  It may also be used by the CQL execution implementation to assist in building and processing queries (although our CoffeeScript implementation does not do this).

Here's the schema for the model-info file:
* https://github.com/cqframework/clinical_quality_language/blob/master/Src/cql-lm/schema/elm/modelinfo.xsd

And here are a few examples:
* https://github.com/cqframework/clinical_quality_language/blob/master/Src/java/quick/src/main/resources/org/hl7/fhir/fhir-modelinfo-1.0.2.xml
* https://github.com/cqframework/clinical_quality_language/blob/master/Src/java/quick/src/main/resources/org/hl7/fhir/fhir-modelinfo-3.0.0.xml
* https://github.com/cqframework/clinical_quality_language/blob/master/Src/java/qdm/src/main/resources/gov/healthit/qdm/qdm-modelinfo-5.0.2.xml

If you use `gradle installDist` (from the cql-to-elm project root), then this is how you would pass your model into the cql-to-elm via the commandline:
```
./build/install/cql-to-elm/bin/cql-to-elm --input path/to/your/cql --model path/to/your/modelinfo.xml --format JSON
```
(The above works on Mac.  You might have to adjust a bit for Windows.)

Hopefully this information helps as you begin to work with CQL.

ishwaryaakkiah, 2017-05-13:
Thankssss a lottttt buddy :-)

ishwaryaakkiah, 2017-05-15:
Thanks a lotttttt Chris :-)

Thanks & Regards

 Ishwarya Akkiah

Software Engineer, BORN

[image: Group GMG Logo]

2nd Floor, Hardy Tower, Ramanujan IT SEZ,

TRIL Infopark Limited, Taramani, Chennai - 600113

www.borngroup.com

On Fri, May 12, 2017 at 7:49 PM, Chris Moesel <notifications@github.com>
wrote:

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

ishwaryaakkiah, 2017-05-26:
Hi Chris,
    Thanks for your valuable time. I really love working with CQL ,I am  learning new things everyday .Its really amazing. I have few more doubts in building up the model:
1).Can I please know do we have any database connectivity made ,to pull the data for executing the  CQL?
2).How data is being passed in CQL??

cmoesel, 2017-05-26:
I'm glad you're enjoying working with CQL!

The [CoffeeScript/JavaScript execution engine](https://github.com/cqframework/clinical_quality_language/tree/master/Src/coffeescript/cql-execution) does _not_ pull from any databases.  It expects patient data to be provided to it as an array of FHIR resources in JSON format.  Constructing that array of data (via a DB query or FHIR query) is outside of the scope of the CoffeeScript/JavaScript execution engine.

That said, the [Java-based execution engine](https://github.com/DBCG/cql_engine) can be used as a plugin to a HAPI server, in which case it pulls data from the HAPI database.  As an added bonus, at this point, my understanding is that the Java-based engine is more mature and feature-complete anyway.  If you need/want more information on the Java engine, I'd check with @brynrhodes.

ishwaryaakkiah, 2017-05-29:
Thank You Chris..

ishwaryaakkiah, 2017-05-30:
Hi Bryn,
   Thanks for your valuable time.I have done few testings before building
an engine to execute CQL. It's really amazing to work in new technology
like CQL. Can I please,know few details to proceed further :
   1).While analyzing,java based  engine for CQL execution, found that your
evaluating each expressions(defined in CQL - if I'm not wrong.) of the
cql..Can I please know the reason behind it? What will be the output for
this?
   *2).Can we please, get a sample output produced finally by the engine.*
   3).When we tried to execute the test file(TestFhirLibrary.java),we tried
to fetch the result,but it was empty and throws following exception:
           FhirClientConnectionException: Failed to retrieve the server
metadata statement during client initialization. URL used was
http://fhirtest.uhn.ca/baseDstu3/metadata
  Do we need to provide any input ? I tried changing the URL to*
http://fhirtest.uhn.ca/baseDstu2/
<http://fhirtest.uhn.ca/baseDstu2/>* , even throws exception.Can I ,please
know what output is returned?
  4).While analyzing, found that Data model's datatypes and attributes are
used to build a CQL - Please correct me if I am wrong. There are various
data models available like QDM,QUICK,FHIR - why do we use these data
models? Without using these data models can't we execute a CQL? Is CQL
dependent on data model?
  5).Can I please know do we have any database connectivity made ,to pull
the data for executing the CQL using data models?
  6).How data from the DB is passed in CQL?

Can you please help us, by sparing your valuable time.

Thanks & Regards

 Ishwarya Akkiah

On Wed, May 10, 2017 at 11:38 AM, Bryn Rhodes <notifications@github.com>
wrote:

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

brynrhodes, 2017-05-31:
Hi Ishwarya,

> 1).While analyzing,java based  engine for CQL execution, found that your
evaluating each expressions(defined in CQL - if I'm not wrong.) of the
cql..Can I please know the reason behind it? What will be the output for
this?

The CQL specification is designed to enable sharing of clinical knowledge like measures and decision support artifacts. The actual "sharing" portion of the specification is Expression Logical Model (ELM). The ELM can be used to evaluate the expression directly (which is what the Java-based and JavaScript-based engines are doing), or it can be the input to a translation step that converts the ELM into a format suitable for execution in a target environment (such as Drools or a SQL-based DBMS).

In the Java-based engine, each node in the ELM is represented by a class that knows how to implement the evaluation for that operator. Each node implements an "Evaluate" interface, and the ELM expression is then evaluated by calling Evaluate() on the root node.

> *2).Can we please, get a sample output produced finally by the engine.*

The unit tests in the engine provide example inputs and outputs. Are you able to use those?

> 3).When we tried to execute the test file(TestFhirLibrary.java),we tried
to fetch the result,but it was empty and throws following exception...

I'm not sure what's going on there, can you submit an issue to the cql-engine repository? The metadata retrieval link is working for me, so this may need more investigation.

> 4).While analyzing, found that Data model's datatypes and attributes are
used to build a CQL - Please correct me if I am wrong. There are various
data models available like QDM,QUICK,FHIR - why do we use these data
models? Without using these data models can't we execute a CQL? Is CQL
dependent on data model?

No, you don't need to specify a data model to use CQL, but if you don't specify one, then you are limited to working with literals and selectors. Whenever you need to retrieve data from a source (such as patient information), you need to specify a data model so that the translator understands what the structures in that model look like (i.e. the result type of the retrieve). CQL supports working with any data model, you just have to provide a model info file to describe it so the translator can validate the expressions you have written.

> 5).Can I please know do we have any database connectivity made ,to pull
the data for executing the CQL using data models?

We recently built a connector that uses JDBC to access a SqlLite database in the [CDC Opioid Logic](https://github.com/cqframework/opioid-cds-logic/tree/master/java/omtk-provider) repository.

> 6).How data from the DB is passed in CQL?

It's up to the implementation environment to define the physical representation of the data involved. In the Java-based implementation, for the FHIR model, for example, we use the HAPI FHIR classes directly. The DataProvider interface provides wrapper methods that the engine interacts with to access the data and attributes of the instances.

I hope this helps.

ishwaryaakkiah, 2017-06-05:
Hi Bryn,
   Thanks for your reply. Sorry to bother you. Still few more doubts arise
when I tried to understand your points.
      As you said in below points:

*           2).Can we please, get a sample output produced finally by the
engine.?*
           The unit tests in the engine provide example inputs and outputs.
Are you able to use those? -- Is the output returned as
                  BOOLEAN("boolean"),
                  CODE("code"),
                  DATE("date"),
                  INTEGER("integer"),
                  STRING("string"); which is defined in
OutputType.java?,Since in all test classes your evaluating the nodes
defined in CQL/ELM

4).While analyzing, found that Data model's datatypes and attributes are
used to build a CQL - Please correct me if I am wrong. There are various
data models available like QDM,QUICK,FHIR - why do we use these data
models? Without using these data models can't we execute a CQL? Is CQL
dependent on data model?

                 No, you don't need to specify a data model to use CQL, but
if you don't specify one, then you are limited to working with literals and
selectors. Whenever you need                  to retrieve data from a
source (such as patient information), you need to specify a data model so
that the translator understands what the structures in that model
         look like (i.e. the result type of the retrieve). CQL supports
working with any data model, you just have to provide a model info file to
describe it so the translator        can validate the expressions you have
written.

                     --- Here can I please know how customized data model
is integrated with the CQL? As per my analysis, existing model is
integrated to cql through xml schema and using JAXB it's converted into
java objects(please correct me if I'm wrong).

5).Can I please know do we have any database connectivity made ,to pull
the data for executing the CQL using data models?

                  We recently built a connector that uses JDBC to access a
SqlLite database in the CDC Opioid Logic
<https://github.com/cqframework/opioid-cds-logic/tree/master/java/omtk-provider>
 repository.

              Where is the input being passed for CQL? As per my analysis,
in TestFhirPath.java , loadTests() loads the tests-fhir-r3.xml , which
contains patient-example.xml,observation-example.xml as input file and this
input is passed to the cql mentioned in runTest() method. Can I please know
, whether I'm correct?
Thanks & Regards
 Ishwarya Akkiah

On Wed, May 31, 2017 at 9:00 AM, Bryn Rhodes <notifications@github.com>
wrote:
Hi Ishwarya,
1).While analyzing,java based engine for CQL execution, found that your
evaluating each expressions(defined in CQL - if I'm not wrong.) of the
cql..Can I please know the reason behind it? What will be the output for
this?
The CQL specification is designed to enable sharing of clinical knowledge
like measures and decision support artifacts. The actual "sharing" portion
of the specification is Expression Logical Model (ELM). The ELM can be used
to evaluate the expression directly (which is what the Java-based and
JavaScript-based engines are doing), or it can be the input to a
translation step that converts the ELM into a format suitable for execution
in a target environment (such as Drools or a SQL-based DBMS).
In the Java-based engine, each node in the ELM is represented by a class
that knows how to implement the evaluation for that operator. Each node
implements an "Evaluate" interface, and the ELM expression is then
evaluated by calling Evaluate() on the root node.
*2).Can we please, get a sample output produced finally by the engine.*
The unit tests in the engine provide example inputs and outputs. Are you
able to use those?
3).When we tried to execute the test file(TestFhirLibrary.java),we tried
to fetch the result,but it was empty and throws following exception...
I'm not sure what's going on there, can you submit an issue to the
cql-engine repository? The metadata retrieval link is working for me, so
this may need more investigation.
4).While analyzing, found that Data model's datatypes and attributes are
used to build a CQL - Please correct me if I am wrong. There are various
data models available like QDM,QUICK,FHIR - why do we use these data
models? Without using these data models can't we execute a CQL? Is CQL
dependent on data model?
No, you don't need to specify a data model to use CQL, but if you don't
specify one, then you are limited to working with literals and selectors.
Whenever you need to retrieve data from a source (such as patient
information), you need to specify a data model so that the translator
understands what the structures in that model look like (i.e. the result
type of the retrieve). CQL supports working with any data model, you just
have to provide a model info file to describe it so the translator can
validate the expressions you have written.
5).Can I please know do we have any database connectivity made ,to pull
the data for executing the CQL using data models?
We recently built a connector that uses JDBC to access a SqlLite database
in the CDC Opioid Logic
<https://github.com/cqframework/opioid-cds-logic/tree/master/java/omtk-provider>
repository.
6).How data from the DB is passed in CQL?
It's up to the implementation environment to define the physical
representation of the data involved. In the Java-based implementation, for
the FHIR model, for example, we use the HAPI FHIR classes directly. The
DataProvider interface provides wrapper methods that the engine interacts
with to access the data and attributes of the instances.
I hope this helps.
—
You are receiving this because you were mentioned.

Reply to this email directly, view it on GitHub
<https://github.com/cqframework/clinical_quality_language/issues/112#issuecomment-305072332>,
or mute the thread
<https://github.com/notifications/unsubscribe-auth/AbNIBqI8kv5u1JJCQHhoD2wLmHniyQzoks5r_N7SgaJpZM4NTl8s>
.

brynrhodes, 2017-06-06:
Hi Ishwarya,

No, the OutputType.java is part of the FHIRPath test harness.

Regards,
Bryn

ishwaryaakkiah, 2017-06-07:
Thanks a lot Bryn for sparing your valuable time.

Thanks & Regards

 Ishwarya Akkiah

Software Engineer, BORN

[image: Group GMG Logo]

2nd Floor, Hardy Tower, Ramanujan IT SEZ,

TRIL Infopark Limited, Taramani, Chennai - 600113

www.borngroup.com

On Wed, Jun 7, 2017 at 1:44 AM, Bryn Rhodes <notifications@github.com>
wrote:

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

Closed 2017-05-25.

Thread 115 (2017-06-01):

Operand result type is returning as the negated QDM type

jackcmeyer, 2017-06-01:
When using the following function in CQL, the operand for the function argument has a result type of the negated version of the QDM.

```
define function "func1"(AP "Assessment, Not Performed" ):
             true
```

This is inconsistent with other result type functionality.  For example, the following CQL definition returns the positive version of the QDM type

```
define "def1":
              ["Assessment, Not Performed"]
```

Thoughts?

brynrhodes, 2017-06-01:
So, this is an interesting one, and it really boils down to what you intended to do when you specified that the function takes a "Not Performed". Negation is accomplished through profiles in this way to enable the data access layer to communicate the profile information to the target system. If you look at the retrieve, you'll see the label of the profile is given as the template identifier in the retrieve.

But in the case of a function, we don't have that same need, and so if we dropped to the base type, we'd lose the fact that you declared the function to operator on "Not Performed". I'm inclined to say that since the profile is basically like a "marker interface", that we should leave it in the function and require the cast in order to use it as a negation, if that's what it is.

Does that make sense?

JSRankins, 2017-06-01:
Hi Bryn. We agree that the "Not Performed" information should be kept. We are saying that no provision of the baseType for the associated profile label means that there cannot be direct type comparison of a list of returned "Not Performed" elements in a population to a function's argument type. We could say that this is intended, and that a function should not contain an argument that has a type of "Not Performed", but the CQL-based HQMF IG does not set this restriction. The other difficulty is that when the following CQL is created, it passes the current CQL-to-ELM validation:

```
define "def":
    ["Assessment, Performed"] A
        where func(A)

define function "func"("AE" "Assessment, Not Performed" ): true
```

brynrhodes, 2017-06-01:
I think it makes sense to still allow functions to be declared based on the "Not Performed", but it should require a "Not Performed". We were careful to exclude that from the return type of the retrieve to avoid implementers having to deal with Not Performed types, and we could still make a recommendation that Not Performed functions be disallowed, but I think that would make more sense as a program-level convention, rather than something in the IG.

You're example above though did uncover a problem with the type resolution in that the translator is automatically casting the Assessment, Performed to an Assessment, Not Performed because they are "compatible" (meaning they have the same attributes). That behavior is both surprising and wrong, and I'm fixing that issue.

JSRankins, 2017-06-02:
Thanks Bryn. We'll check out the updated code. This appears to be created for CQL 1.2. When is the plan to push CQL 1.2 to master?

brynrhodes, 2017-06-03:
Once CQL 1.2 has been published we'll switch the branch to master and formally release a 1.2 version. In the meantime, I've been pushing snapshots to sonatype. I just pushed another version with this and the other issue addressed (1.2.3-SNAPSHOT).

Closed 2017-06-03.

Thread 127 (2017-06-16):

Sort Expressions Using Query Aliases

cmoesel, 2017-06-16:
I’m chasing down an issue in the coffeescript execution engine, but it’s led me to question some things regarding sort.

# The Problem

In the R1.1 spec, we introduce sort with this example:
```
[Encounter: “Inpatient”] E sort by start of period
```
I think this is the way sort by is intended to be used – directly referencing a property in each of the returned items.

That said, we also have some examples further on that do things like this:
```
First([Condition: "Acute Pharyngitis"] C sort by C.onsetDateTime desc)
```
Note the use of the `C` alias in the sort expression.  I’m not sure this is actually valid and it raises the question: **Can a query alias be referenced in a sort clause?**

At first glance, this seems OK – but when you really think about it, `C` is an alias used during the query execution.  The sort is defined to operate on the _results_ of the query – _after_ the execution has occurred – at which point `C` doesn’t really have meaning.

Looking at the CQL 1.1 spec, section 5.3.3 states:
> After the iterative clauses are executed for each element of the query source, the sort clause, if present, specifies a sort order for the final output.  This step simply involves sorting the output of the iterative steps…

Since the alias only holds meaning during the iterative clauses (and changes during each iteration), then if sort comes _after_ iteration, the alias has no meaning.  Section 5.3.4 makes this ordering even more clear when it lists out the steps to implementing a query: ForEach, Times, Filter, Distinct, Sort.  It seems that by the time you get to _Sort_, the alias shouldn't be in scope anymore.

Another reason it likely doesn’t make sense to reference an alias in the sort clause is that it introduces a possibility for ambiguity when the thing you’re sorting has a property with the same name as your alias.  Consider this:
```
({Tuple{E: 1}, Tuple{E: 3}, Tuple{E: 2}}) N sort by E
```
Like the first example above, this shows how sort is intended to work -- by referencing a _property_ in the returned items.  This is fine, but what happens when we do this instead:
```
({Tuple{E: 1}, Tuple{E: 3}, Tuple{E: 2}}) E sort by E
```
If we allow aliases in the sort expression, what does the `E` in the sort mean?  Is it the _property_ `E` or is it the item `E`?  It’s unclear.

# Where It's Currently Allowed

Despite the above, there are a few things that hint that using aliases in a sort clause is allowed:
* the spec has a number of examples where an alias is used in a sort clause
* the cql-to-elm translator _allows_ aliases in sort clauses (they become `AliasRef` instances)

If it's not really allowed, these will have to be fixed.

# A Further Issue / Limitation

That said, there are a few cases where we _do_ want to reference the returned _item_ in the sort clause rather than a _property_ of the item.  The use case that led me here is that I want to sort items by the result of a function that takes the item as a parameter.  A trivial example is:
```
({1,-3,2,-5,4}) N sort by Abs(N)
```
Now... if referencing an alias is not allowed, then what do I pass into the `Abs` function?  It seems we would need to have some sort of inferred variable, such as:
```
({1,-3,2,-5,4}) N sort by Abs($result)
```
Right now, I can use a workaround, but it is _ugly_:
```
(({1,-3,2,-5,4}) N return Tuple{num: N} sort by Abs(num)) N2 return N2.num
```

# So...

I guess that leaves the following questions:
* Should aliases be allowed in sort expressions?
   * If yes...
      * How do we reconcile that with the implementation guidance in the spec?
      * How do we specify the expected behavior in the ambiguous example I provided?
   * If no...
      * How do we support sort expressions that want to operate directly on the _result_?

brynrhodes, 2017-06-16:
You're right that this is somewhat ambiguous in the spec and should be clarified. Given that one of the primary targets of ELM is simplicity of implementation, we should be consistent with the implementation guidance and _not_ allow alias references in the sort. I checked the translator and it does incorrectly allow alias references, but that would be a challenge when it came to implementation because the source data isn't even available at that point in the query pipeline.

So, I propose that we use this issue to fix the translator so that it no longer allows references to aliases (which based on the implementation guidance is the intended interpretation for CQL), and that we submit STU comments against 1.2 to correct the examples that allow alias references as errors in the specification.

cmoesel, 2017-06-17:
That sounds good to me.  Any thoughts on how we would support referencing the returned item _as a whole_ in the sort clause?

My real-world use case is that when I sort FHIR `Observation`s by date, I want to sort by the "best" date I have for each -- so it's essentially a sort by `Coalesce(effectiveDateTime.value, effectivePeriod."end".value, effectivePeriod."start".value, issued.value)`.  This _works_, but there is other logic where I want to use this same _Coalesce_ expression on Observations, so I put it into a `FindObservationDate` function that takes the `Observation` as an argument.  Ideally I'd use `FindObservationDate` in my sort clause, but I can't since the argument is the full Observation item.

Make sense?

brynrhodes, 2017-06-17:
Yes, and sorry, I meant to address that in my response as well but forgot. I propose we use the nominated iteration variable $this that was introduced in 1.2. So within a sort clause expression, you'd be able to access the current item using $this.

cmoesel, 2017-06-21:
Merged in the fix with #129

brynrhodes, 2017-09-27:
Submitted comment [1436](http://www.hl7.org/dstucomments/showdetail_comment.cfm?commentid=1436)

Closed 2017-06-21.

Thread 144 (2017-06-28):

Case sensitivity and UCUM units

mulcahyk, 2017-06-28:
In section 2.5.4.1 of the R1.2 spec it says

> Note also that the UCUM time-period units can be used when expressing duration quantities.

section 2.4.2.1 it says

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

According to this site: http://download.hl7.de/documents/ucum/ucumdata.html there is something called a MegaSecond whose unit is `Ms`. There is also the MilliSecond with a unit of `ms`.  If you go with case insensitive units you could end up mixing these two units.

brynrhodes, 2017-07-14:
This should be submitted as an issue against the CQL specification so we can determine a general resolution in the specification. If that resolution does not address the ambiguity, then the issue will need to be considered as part of an implementation guide or potentially program-specific guidance for artifacts.

brynrhodes, 2017-09-28:
Submitted comment [1440](http://www.hl7.org/dstucomments/showdetail_comment.cfm?commentid=1440)

Closed 2017-09-28.

Thread 145 (2017-06-29):

Unexpected behavior with exists when list promotion is enabled

JSRankins, 2017-06-29:
@brynrhodes:
With list promotion turned on, a boolean that is fed into the exists operator is turned into a list. Doing this will always cause the exists operator to return 'true'. As a result, something like the following will always true:

`exists(exists(null))`

or

`exists(false)`

Hopefully an author would never do this, but if an author did, it would have unintended consequences.  Earlier versions of CQL-to-ELM prevented the above scenario from happening.
Is list promotion working as intended?

brynrhodes, 2017-06-29:
List promotion is implemented with a ToList() operator, which is explicitly handling the `null` case to return an empty list, so `exists(null)` would return false. I agree thought that `exists(false)` would return true, which may be a surprising result. Can you give some examples of where you were thinking it would have unintended consequences though?

JSRankins, 2017-06-29:
During testing, one of our QA people created a child library that did something like the following:

```
library child version '1.0.000'

using QDM version '5.0.2'

context Patient

define "hasEncounter":
    exists(["Encounter, Performed"])
```

They then used the child library in a parent library:

```
library parent version '1.0.000'

include child version '1.0.000' called ChildAlias

context Patient

using QDM version '5.0.2'

define "Initial Population":
    exists(ChildAlias.hasEncounter)
```

We expected this would return an error, but it did not. In this particular case, the author might think that this would only return true if the patient had an Encounter, but it would always return true and the patient would be included in the population even though the patient did not have an Encounter. If we allow this through list promotion, then we will have to be extra specially careful that we catch something like this during a review process.

brynrhodes, 2017-06-29:
I agree that's a potential issue. Strictly speaking, it is correct though. Is this a good case for a warning? It would be easy to add a warning when a Boolean-valued expression is promoted to a list.

JSRankins, 2017-06-29:
I think it would be a good use case for a warning message.

Closed 2017-06-30.

Thread 147 (2017-06-30):

CQL-To-ELM Annotations Parenthetical Logic Issue

alexanderelliott121, 2017-06-30:
I believe I've found an issue with cql-to-elm annotation parsing.
Occasionally, it will create annotations at the define level without any sub-clause details.

My attempts to diagnose the issue suggests that it is related statements that have multi-clause logic within parenthesies.

The following statements have all triggered this issue:

define "MDD Encounter": distinct (["Encounter, Performed": "Office Visit"] union ["Encounter, Performed": "Outpatient Consultation"] union ["Encounter, Performed": "Face-to-Face Interaction"] union ["Encounter, Performed": "Psych Visit - Diagnostic Evaluation"] union ["Encounter, Performed": "Psych Visit - Family Psychotherapy"] union ["Encounter, Performed": "Psych Visit - Psychotherapy"] union ["Encounter, Performed": "Psychoanalysis"]) Encounter
    where Encounter.relevantPeriod during "Measurement Period"

define “Anatomical Location Left”: [“Diagnosis”: “Left Unilateral Amputation Above or Below Knee”]
    union ([“Diagnosis”: “Unilateral Amputation Below or Above Knee, Unspecified Laterality”] Diagnosis
    where (Diagnosis.anatomicalLocationSite in “Left”))

define "Anatomical Location Right": ["Diagnosis": "Right Unilateral Amputation Above or Below Knee"]
    union (["Diagnosis": "Unilateral Amputation Below or Above Knee, Unspecified Laterality"] Diagnosis
    where (Diagnosis.anatomicalLocationSite in "Right"))

Measures used to test this were CMS177 and CMS123.

This continues to be a high priority issue for Bonnie. Do you happen to know what a timeline might be for this to be addressed? Is there anything the Bonnie team can do to help?

Thank you,
Alexander

alexanderelliott121, 2017-06-30:
I am currently unable to upload the relevant cql and elm files.  I'll try to attach them to the jira ticket I'm creating on our end, and will provide you with a link when I am able.

Closed 2017-07-03.

Thread 149 (2017-06-30):

Translation process not finishing

jackcmeyer, 2017-06-30:
In the following CQL file, the parser never finishes translating the libary.

```
library testagain version '0.0.000'

using QDM version '5.0.2'

codesystem "LOINC:2.46": 'urn:oid:2.16.840.1.113883.6.1' version 'urn:hl7:version:2.46'

codesystem "SNOMEDCT:2016-03": 'urn:oid:2.16.840.1.113883.6.96' version 'urn:hl7:version:2016-03'

valueset "ONC Administrative Sex": 'urn:oid:2.16.840.1.113762.1.4.1'

valueset "Race": 'urn:oid:2.16.840.1.114222.4.11.836'

valueset "Ethnicity": 'urn:oid:2.16.840.1.114222.4.11.837'

valueset "Payer": 'urn:oid:2.16.840.1.114222.4.11.3591'

code "Birthdate": '21112-8' from "LOINC:2.46" display 'Birth date'

code "Dead": '419099009' from "SNOMEDCT:2016-03" display 'Dead'

parameter "Measurement Period" Interval<DateTime>

context Patient

define "SDE Ethnicity": ["Patient Characteristic Ethnicity": "Ethnicity"]

define "SDE Payer": ["Patient Characteristic Payer": "Payer"]

define "SDE Race": ["Patient Characteristic Race": "Race"]

define "SDE Sex": ["Patient Characteristic Sex": "ONC Administrative Sex"]

define "Def1": exists( ["Device, Applied": "Encounter Inpatient"] ) or exists( ["Device, Applied": "Encounter Inpatient"] ) or exists( ["Device, Applied": "Encounter Inpatient"] ) or exists( ["Device, Applied": "Encounter Inpatient"] ) or exists( ["Device, Applied": "Encounter Inpatient"] ) or exist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
```

After some testing, it appears that it never returns from the `ParseTree tree = parser.library` call in the `translateELM()` method in the CqlTranslator class

jackcmeyer, 2019-01-08:
@brynrhodes we have run across this issue again during some testing. After 20+ minutes of execution, this library never finishes translating.

```
library testassociations version '0.0.000'

using QDM version '5.4'

codesystem "LOINC": 'urn:oid:2.16.840.1.113883.6.1'
codesystem "SNOMEDCT": 'urn:oid:2.16.840.1.113883.6.96'

valueset "Ethnicity": 'urn:oid:2.16.840.1.114222.4.11.837'
valueset "ONC Administrative Sex": 'urn:oid:2.16.840.1.113762.1.4.1'
valueset "Payer": 'urn:oid:2.16.840.1.114222.4.11.3591'
valueset "Race": 'urn:oid:2.16.840.1.114222.4.11.836'

code "Birth date": '21112-8' from "LOINC" display 'Birth date'
code "Dead (finding)": '419099009' from "SNOMEDCT" display 'Dead (finding)'
code "Duration (attribute)": '103335007' from "SNOMEDCT" display 'Duration (attribute)'
code "Patient data Document": '55188-7' from "LOINC" display 'Patient data Document'

parameter "Measurement Period" Interval<DateTime>

context Patient

define "SDE Ethnicity":
  ["Patient Characteristic Ethnicity": "Ethnicity"]

define "SDE Payer":
  ["Patient Characteristic Payer": "Payer"]

define "SDE Race":
  ["Patient Characteristic Race": "Race"]

define "SDE Sex":
  ["Patient Characteristic Sex": "ONC Administrative Sex"]

define "test1":
  exists ( ["Patient Characteristic": "Patient data Document"] Alias
      where ToDate(Alias.authorDatetime)= @2012-05-01
  )
    or exists ( ["Patient Characteristic": code in "Patient data Document"] )
    or exists ( ["Patient Characteristic": "Patient data Document"] Alias
        where Alias.id is not null
    )
    or exists ( ["Patient Characteristic": "Patient data Document"] Alias
        where Alias.recorder is not null
    )
    or exists ( ["Patient Characteristic": "Patient data Document"] Alias
        where Alias.reporter is not null
    )
    or exists ( ["Patient Characteristic Birthdate": "Birth date"] Alias
        where CalculateAgeInYearsAt(Alias.birthDatetime, start of "Measurement Period")> 21
    )
		// this line is where it looks like the issue is
        or CalculateAgeInYearsAt(Patient.birthDatetime, start of "Measurement Period")> 21
    or exists ( ["Patient Characteristic Birthdate": "Birth date"] Alias
        where Alias.id is not null
    )
    or exists ( ["Patient Characteristic Birthdate": "Birth date"] Alias
        where Alias.recorder is not null
    )
    or exists ( ["Patient Characteristic Birthdate": "Birth date"] Alias
        where Alias.reporter is not null
    )
    or exists ( ["Patient Characteristic Clinical Trial Participant": "Patient data Document"] Alias
        where Alias.id is not null
    )
    or exists ( ["Patient Characteristic Clinical Trial Participant": "Patient data Document"] Alias
        where Alias.reason is not null
    )
    or exists ( ["Patient Characteristic Clinical Trial Participant": "Patient data Document"] Alias
        where Alias.recorder is not null
    )
    or exists ( ["Patient Characteristic Clinical Trial Participant": "Patient data Document"] Alias
        where Alias.relevantPeriod is not null
    )
    or exists ( ["Patient Characteristic Clinical Trial Participant": "Patient data Document"] Alias
        where Alias.reporter is not null
    )
    or exists ( ["Patient Characteristic Ethnicity": "Ethnicity"] Alias
        where Alias.id is not null
    )
    or exists ( ["Patient Characteristic Ethnicity": "Ethnicity"] Alias
        where Alias.recorder is not null
    )
    or exists ( ["Patient Characteristic Ethnicity": "Ethnicity"] Alias
        where Alias.reporter is not null
    )
    or exists ( ["Patient Characteristic Expired": "Dead (finding)"] Alias
        where Alias.cause = "Duration (attribute)"
    )
    or exists ( ["Patient Characteristic Expired": "Dead (finding)"] Alias
        where Alias.expiredDatetime < @2012-06-01
    )
    or exists ( ["Patient Characteristic Expired": "Dead (finding)"] Alias
        where Alias.id is not null
    )
    or exists ( ["Patient Characteristic Expired": "Dead (finding)"] Alias
        where Alias.recorder is not null
    )
    or exists ( ["Patient Characteristic Expired": "Dead (finding)"] Alias
        where Alias.reporter is not null
    )
    or exists ( ["Patient Characteristic Payer": "Payer"] Alias
        where Alias.id is not null
    )
    or exists ( ["Patient Characteristic Payer": "Payer"] Alias
        where Alias.recorder is not null
    )
    or exists ( ["Patient Characteristic Payer": "Payer"] Alias
        where Alias.relevantPeriod during "Measurement Period"
    )
    or exists ( ["Patient Characteristic Payer": "Payer"] Alias
        where Alias.reporter is not null
    )
    or exists ( ["Patient Characteristic Race": "Race"] Alias
        where Alias.id is not null
    )
    or exists ( ["Patient Characteristic Race": "Race"] Alias
        where Alias.recorder is not null
    )
    or exists ( ["Patient Characteristic Race": "Race"] Alias
        where Alias.reporter is not null
    )
    or exists ( ["Patient Characteristic Sex": "ONC Administrative Sex"] Alias
        where Alias.id is not null
    )
    or exists ( ["Patient Characteristic Sex": "ONC Administrative Sex"] Alias
        where Alias.recorder is not null
    )
    or exists ( ["Patient Characteristic Sex": "ONC Administrative Sex"] Alias
        where Alias.reporter is not null
    )
    or exists ( ["Provider Characteristic": "Patient data Document"] Alias
        where Alias.authorDatetime = @2102-05-01T12:50
    )
    or exists ( ["Provider Characteristic": "Patient data Document"] Alias
        where Alias.id is not null
    )
    or exists ( ["Provider Characteristic": "Patient data Document"] Alias
        where Alias.recorder is not null
    )
    or exists ( ["Provider Characteristic": "Patient data Document"] Alias
        where Alias.reporter is not null
    )
```

Simply adding parenthesis around the problematic condition fixes the problem.
```
library testassociations version '0.0.000'

using QDM version '5.4'

codesystem "LOINC": 'urn:oid:2.16.840.1.113883.6.1'
codesystem "SNOMEDCT": 'urn:oid:2.16.840.1.113883.6.96'

valueset "Ethnicity": 'urn:oid:2.16.840.1.114222.4.11.837'
valueset "ONC Administrative Sex": 'urn:oid:2.16.840.1.113762.1.4.1'
valueset "Payer": 'urn:oid:2.16.840.1.114222.4.11.3591'
valueset "Race": 'urn:oid:2.16.840.1.114222.4.11.836'

code "Birth date": '21112-8' from "LOINC" display 'Birth date'
code "Dead (finding)": '419099009' from "SNOMEDCT" display 'Dead (finding)'
code "Duration (attribute)": '103335007' from "SNOMEDCT" display 'Duration (attribute)'
code "Patient data Document": '55188-7' from "LOINC" display 'Patient data Document'

parameter "Measurement Period" Interval<DateTime>

context Patient

define "SDE Ethnicity":
  ["Patient Characteristic Ethnicity": "Ethnicity"]

define "SDE Payer":
  ["Patient Characteristic Payer": "Payer"]

define "SDE Race":
  ["Patient Characteristic Race": "Race"]

define "SDE Sex":
  ["Patient Characteristic Sex": "ONC Administrative Sex"]

define "test1":
  exists ( ["Patient Characteristic": "Patient data Document"] Alias
      where ToDate(Alias.authorDatetime)= @2012-05-01
  )
    or exists ( ["Patient Characteristic": code in "Patient data Document"] )
    or exists ( ["Patient Characteristic": "Patient data Document"] Alias
        where Alias.id is not null
    )
    or exists ( ["Patient Characteristic": "Patient data Document"] Alias
        where Alias.recorder is not null
    )
    or exists ( ["Patient Characteristic": "Patient data Document"] Alias
        where Alias.reporter is not null
    )
    or exists ( ["Patient Characteristic Birthdate": "Birth date"] Alias
        where CalculateAgeInYearsAt(Alias.birthDatetime, start of "Measurement Period")> 21
    )

		// adding parenthesis around the condition seems to fix it
        or (CalculateAgeInYearsAt(Patient.birthDatetime, start of "Measurement Period")> 21)
    or exists ( ["Patient Characteristic Birthdate": "Birth date"] Alias
        where Alias.id is not null
    )
    or exists ( ["Patient Characteristic Birthdate": "Birth date"] Alias
        where Alias.recorder is not null
    )
    or exists ( ["Patient Characteristic Birthdate": "Birth date"] Alias
        where Alias.reporter is not null
    )
    or exists ( ["Patient Characteristic Clinical Trial Participant": "Patient data Document"] Alias
        where Alias.id is not null
    )
    or exists ( ["Patient Characteristic Clinical Trial Participant": "Patient data Document"] Alias
        where Alias.reason is not null
    )
    or exists ( ["Patient Characteristic Clinical Trial Participant": "Patient data Document"] Alias
        where Alias.recorder is not null
    )
    or exists ( ["Patient Characteristic Clinical Trial Participant": "Patient data Document"] Alias
        where Alias.relevantPeriod is not null
    )
    or exists ( ["Patient Characteristic Clinical Trial Participant": "Patient data Document"] Alias
        where Alias.reporter is not null
    )
    or exists ( ["Patient Characteristic Ethnicity": "Ethnicity"] Alias
        where Alias.id is not null
    )
    or exists ( ["Patient Characteristic Ethnicity": "Ethnicity"] Alias
        where Alias.recorder is not null
    )
    or exists ( ["Patient Characteristic Ethnicity": "Ethnicity"] Alias
        where Alias.reporter is not null
    )
    or exists ( ["Patient Characteristic Expired": "Dead (finding)"] Alias
        where Alias.cause = "Duration (attribute)"
    )
    or exists ( ["Patient Characteristic Expired": "Dead (finding)"] Alias
        where Alias.expiredDatetime < @2012-06-01
    )
    or exists ( ["Patient Characteristic Expired": "Dead (finding)"] Alias
        where Alias.id is not null
    )
    or exists ( ["Patient Characteristic Expired": "Dead (finding)"] Alias
        where Alias.recorder is not null
    )
    or exists ( ["Patient Characteristic Expired": "Dead (finding)"] Alias
        where Alias.reporter is not null
    )
    or exists ( ["Patient Characteristic Payer": "Payer"] Alias
        where Alias.id is not null
    )
    or exists ( ["Patient Characteristic Payer": "Payer"] Alias
        where Alias.recorder is not null
    )
    or exists ( ["Patient Characteristic Payer": "Payer"] Alias
        where Alias.relevantPeriod during "Measurement Period"
    )
    or exists ( ["Patient Characteristic Payer": "Payer"] Alias
        where Alias.reporter is not null
    )
    or exists ( ["Patient Characteristic Race": "Race"] Alias
        where Alias.id is not null
    )
    or exists ( ["Patient Characteristic Race": "Race"] Alias
        where Alias.recorder is not null
    )
    or exists ( ["Patient Characteristic Race": "Race"] Alias
        where Alias.reporter is not null
    )
    or exists ( ["Patient Characteristic Sex": "ONC Administrative Sex"] Alias
        where Alias.id is not null
    )
    or exists ( ["Patient Characteristic Sex": "ONC Administrative Sex"] Alias
        where Alias.recorder is not null
    )
    or exists ( ["Patient Characteristic Sex": "ONC Administrative Sex"] Alias
        where Alias.reporter is not null
    )
    or exists ( ["Provider Characteristic": "Patient data Document"] Alias
        where Alias.authorDatetime = @2102-05-01T12:50
    )
    or exists ( ["Provider Characteristic": "Patient data Document"] Alias
        where Alias.id is not null
    )
    or exists ( ["Provider Characteristic": "Patient data Document"] Alias
        where Alias.recorder is not null
    )
    or exists ( ["Provider Characteristic": "Patient data Document"] Alias
        where Alias.reporter is not null
    )
```

After a little bit of digging, it seems like it gets exponentially slower the more conditions there are. The problem isn't noticeable with 5 conditions, starts getting really noticeable at about 10 conditions, and never finishes executing with approximately 15+ conditions.

brynrhodes, 2019-03-01:
The issue here ends up being a known performance issue with the ANTLR4 parser in versions prior to 4.6. In 4.6, a [change](https://github.com/antlr/antlr4/issues/1398) was implemented to the way left-recursive parsing is done, which addresses this performance issue. However, in adding unit tests to verify the functionality, other impacts were found. This is also related to issue #343, see that issue for more details.

brynrhodes, 2019-06-21:
Verified in 1.4 releases that the translator correctly identifies this is as a syntax error.

Closed 2019-06-21.

Thread 150 (2017-06-30):

CQL Parsing issue

chinbaj, 2017-06-30:
We have a particular snippet of code which seems to be causing the parsing of the CQL to be stuck.
We are creating a definition from this snippet.

Please see the attached file for the code snippet.
[test.txt](https://github.com/cqframework/clinical_quality_language/files/1115732/test.txt)

Thanks,
Chinmay

chinbaj, 2017-06-30:
Jack submitted the same issue. Closing this one out.

Closed 2017-06-30.

Thread 151 (2017-06-30):

Includes Bug

cmoesel, 2017-06-30:
The `includes` operator is generally defined for lists and intervals.  In some cases, a non-list item may be _promoted_ to a list during CQL-to-ELM translation.

There is at least one case, however, where this promotion is not occurring, and CQL-to-ELM produces ELM that allows the `includes` operator to be executed on a single item that is not an interval or list (and is not promoted).  This happens when using a tuple returned from a multi-source query.

Example CQL:
```
library multisource_example

// The below multi-source query should return a list of tuples like this:
// { Odd: 1, Even: 2 },
// { Odd: 1, Even: 4 },
// { Odd: 3, Even: 2 },
// { Odd: 3, Even: 4 }
//
// This is because a multi-source query returns a cartesion product (as described in the spec).
define oddsAndEvens:
  from (List{1, 3}) Odd, (List{2, 4}) Even

// Since the value of Odd in each tuple is an integer (not a list), it should be promoted
// to a list, or CQL-to-ELM should produce an error.  But... it goes through unscathed!
define shouldNotBeAllowed:
  (oddsAndEvens) OE where OE.Odd includes 3
```

This produces ELM containing this snippet:
```xml
<def name="shouldNotBeAllowed" context="Patient" accessLevel="Public">
  <expression xsi:type="Query">
    <source alias="OE">
      <expression name="oddsAndEvens" xsi:type="ExpressionRef"/>
    </source>
    <where xsi:type="Contains">
      <operand path="Odd" scope="OE" xsi:type="Property"/>
      <operand valueType="t:Integer" value="3" xsi:type="Literal"/>
    </where>
  </expression>
</def>
```

In reality, the `Odd` property on `OE` is an `Integer`, so it is not valid as the first operand in `Contains`.

@mulcahyk has identified at least one eCQM that triggers this bug.  As a result of the invalid `Contains` operator in the ELM, that measure cannot be properly executed.

mulcahyk, 2017-06-30:
Here is the eCQM that causes this issue:
[CMS146_v5_2_Artifacts.zip](https://github.com/cqframework/clinical_quality_language/files/1116512/CMS146_v5_2_Artifacts.zip)

brynrhodes, 2017-07-02:
The problem is that the result type of the tuple was being incorrectly inferred by the translator. Odd and Even were being incorrectly considered Lists of Integers, which is why no error or list promotion was occurring. I corrected the type inference so that Odd and Even are now correctly integers, and the list promotion is now occurring as expected.

cmoesel, 2017-07-03:
I've tested it and merged it.  Thanks!

For those using the CoffeeScript execution engine (@mulcahyk), note that it will still not handle this fix well.  This fix uses the CQL-to-ELM promotion feature to promote the single value to a list (containing only the single value).  It uses the `ToList` operator, which is not yet implemented in the CoffeeScript CQL execution engine.  So... that will need to be added.

Closed 2017-07-03.

Thread 166 (2017-07-10):

Current project names syntax causing uploadArchives task to be skipped for formatter.

c-schuler, 2017-07-10:
The project name syntax tools:cql-formatter is not being published. I am not sure as to why this syntax is causing issues.... I propose a change to the project names which can be found in the formatter-publish branch of this repo.

The tools: qualifier shouldn't be necessary as Gradle will go through each project and subproject until the name is found.

c-schuler, 2017-07-11:
Resolved in the following pull request:
https://github.com/cqframework/clinical_quality_language/pull/167

Closed 2017-07-11.

Thread 174 (2017-07-12):

CQL being deleted when going through formatter

jackcmeyer, 2017-07-12:
When running a CQL file through the formatter, CQL code is being deleted when there are errors in the file.

For example, when running this CQL file:

```
library test version '0.0.000'

using QDM

notvalueset "Female Administrative Sex": '2.16.840.1.113883.3.560.100.2'
valueset "TestValueset": '1.1.111'

context Patient

define "TestDefinition":
	["Encounter, Performed": "TestValueset "]
```

The output of the formatter is

```
library test version '0.0.000'

using QDM

valueset "TestValueset": '1.1.111'

context Patient

define "TestDefinition":
	["Encounter, Performed": "TestValueset "]
```

Another example is, when running this CQL file:
```
library test version '0.0.000'

using QDM

valueset "TestValueset": '1.1.111'

context Patient

define "TestDefinition":
	['"Encounter, Performed": "TestValueset "]
```

The output of the formatter is:

```
library test version '0.0.000'

using QDM

valueset "TestValueset": '1.1.111'

context Patient

define "TestDefinition":
```

Thoughts on this?

brynrhodes, 2017-07-13:
Yes, when there is a syntax error in the input, the parser will not be able to construct a full parse tree, and since the formatter works by visiting the parse tree, any part of the parse tree that couldn't be constructed will be missed in the output.

We discussed this today and will add functionality to the formatter to detect the case that there are syntax errors resulting in partial parse trees and revert to just returning the input source, unformatted.

brynrhodes, 2017-07-31:
This fix is included in the 1.2.11-SNAPSHOT release.

Closed 2017-07-31.

Thread 178 (2017-07-14):

Add an optimization to remove no-op queries

brynrhodes, 2017-07-14:
Add a feature to the translator to remove no-op queries from the output ELM. For example:

    define "Current Diagnosis Atrial FibrillationFlutter":
      "Encounter with Principle Diagnosis of Ischemic Stroke" NonElectiveEncounter
        where NonElectiveEncounter.diagnosis in "Atrial Fibrillation/Flutter" CurrentAtrialFibrillationFlutter

Note the trailing alias `CurrentAtrialFibrillationFlutter`. Since the query has no additional clauses, the result of the query is the same as the result of the primary source `"Atrial Fibrillation/Flutter"`. Although this is conceptually valid, there are downstream consequences in this case in that the ELM outputs with an `In` instead of an `InValueSet` because the translator doesn't detect that the right operand to the `in` is a reference to a value set.

This optimization would correct that issue, but would also be a general enhancement to the resulting ELM, simplifying where possible.

cmoesel, 2017-07-14:
We should investigate the impact on annotations, in that there would be a more significant mismatch between the source CQL and the ELM.  For example, would it make sense to still tie the annotation for the now-optimized element to the full original source in the CQL?

brynrhodes, 2017-07-14:
Agreed, my thinking here was that when an optimization removes a node, it replaces the source references in the remaining node with the source references in the removed node. This _should_ result in the rewrite referencing the full source CQL.

Thread 179 (2017-07-14):

Add a feature to detect and/or prevent terminology materialization

brynrhodes, 2017-07-14:
The translator currently detects terminology membership tests and outputs them to ELM using the terminology-specific operators `InValueSet` and `InCodeSystem`. This pattern prevents materialization of a value set or code system at run-time. However, CQL does allow for materialization of terminology constructs, and some engines by design do not support that functionality.

As such, the translator should be extended to add a warning when a terminology materialization construct is detected and describe the potential run-time consequences.

In addition, the translator should be extended with an option to prevent the use of terminology materialization expressions.

Thread 184 (2017-07-16):

Considering Timezones in Difference Calculations

cmoesel, 2017-07-16:
Given two dates in _different_ timezones:
* `define A: 2017-12-31@18:00:00.0-05:00`
* `define B: 2018-01-01@00:00:00.0+00:00`

What is the expected result of `difference in years between A and B`?

If we _don't_ consider timezones, then the result is `1`, since `A` is in `2017` and `B` is in `2018`.

If we _do_ consider timezones, then we must normalize to a common timezone in order to count boundaries.

If we normalize both to the _first_ timezone (EST), then `B` becomes `2017-12-31@19:00:00.0+00:00` -- and the result is `0` (both `A` and `B` are  in `2017`).

If we normalize both to the _second_ timezone (GMT), then `A` becomes `2017-12-31@11:00:00.0+00:00` -- and the result is `1` (since `A` is in `2017` and `B` is in `2018`).

If we normalize to the timezone of the request stamp, which might be neither EST nor GMT, then... who knows?

brynrhodes, 2017-07-16:
It seems to me there are only two options for ensuring consistent behavior. 1) Normalize to UTC or 2) Normalize to the timezone of the request.

Given that the default timezone (i.e. the timezone used to construct date/time values if no timezone is specified in the selector) is the timezone of the request, I tend to lean towards option 2.

cmoesel, 2017-07-16:
I think that normalizing to UTC or any other timezone not related to the data itself might get weird.

Normalizing time zones changes where all of the boundaries are.  If we do that whenever date 1 and date 2 have different offsets, then it will happen a _lot_ for areas that observe daylight savings, since there will so often be comparisons between dates in different offsets.  That's my main concern...

brynrhodes, 2017-07-24:
But there's no basis for normalizing to one or the other operand of a binary expression, especially one that is supposed to be commutative. Identifying one operand as being given special consideration would break that property, tying the translators hands for optimization as well as translation to other systems. Seems like the worst option to me. So I still think that consistent with the Now() and Today() operators, we should normalize to the timezone of the request.

cmoesel, 2017-07-24:
OK -- I agree that this would break commutativity.  I hadn't thought of that.

That said, if we normalize to the timezone of the request, then we're in a situation where calculations will be different depending on the location.  For example, running Bonnie tests in San Fransisco might yield different results than running them in Boston.

Or worst, the results might be different depending on whether or not you are currently observing daylight savings time.  For example, running them in Boston on March 1 might yield different results than running them in Boston on Apr 1.

I guess it is a bit of a no-win situation either way.

Would you propose that the dates only be normalized when the timezones differ?  Or would we always normalize them?  I know this is a bit of an edge case, but if we only normalize when they differ, then we have an opportunity for this situation:
```
// request timestamp in GMT
define A: 2012-06-15T23:30:00.0-04:00
define B: 2012-06-16T00:30:00.0-04:00
define C: 2012-06-16T01:00:00.0-00:00
define AsameDayAsC: A same day as C // true
define BsameDayAsC: B same day as C // true
define AsameDayAsB: A same day as B // false
```
(BTW -- this seeming inconsistency would occur if we normalized to the first timezone as well, so it's relevant to either case if we only normalize when timezones differ).

brynrhodes, 2017-07-24:
I think given that there is no "right" answer, I'm hesitant to actually put anything prescriptive in the spec. I'd be comfortable suggesting an approach that always normalizes to the timezone of the request, and further suggesting that systems should record dates in UTC to begin with, but in the absence of that ideal, some flexibility in implementation is desirable to allow environments to select the most appropriate implementation strategy.

cmoesel, 2017-07-24:
OK -- so that would be more like "implementation guidance" than a normative requirement of the spec?  I think that probably makes the most sense.  Over here, we're all hoping that some day the world will go to a single unified time.  That would make things a lot easier!

brynrhodes, 2017-07-24:
Right, I'll take the action to log an STU comment on this.

cmoesel, 2017-07-24:
An STU comment to get the world to move to a unified time?  Excellent!  If HL7 can pull that off, I'll pay double-dues for the rest of my life!

But seriously... thanks.

brynrhodes, 2017-09-28:
Submitted comment [1441](http://www.hl7.org/dstucomments/showdetail_comment.cfm?commentid=1441)

Closed 2017-09-28.

Thread 192 (2017-07-18):

Age functions fail when a patient has a null or undefined birthDate

jgibson, 2017-07-18:
If you define a patient with no `birthDate` and execute the following CQL:

    define "MissingAge": AgeInYears() is null
Then it will fail with a stack trace:
```
TypeError: Cannot read property 'toJSDate' of null
      at CalculateAge.module.exports.CalculateAge.CalculateAge.exec (node_modules/cql-execution/lib/elm/clinical.js:262:33)
      at GreaterOrEqual.module.exports.Expression.Expression.execArgs (node_modules/cql-execution/lib/elm/expression.js:36:30)
      at GreaterOrEqual.module.exports.GreaterOrEqual.GreaterOrEqual.exec (node_modules/cql-execution/lib/elm/comparison.js:77:19)
      at And.module.exports.Expression.Expression.execArgs (node_modules/cql-execution/lib/elm/expression.js:36:30)
      at And.module.exports.And.And.exec (node_modules/cql-execution/lib/elm/logical.js:19:64)
      at ExpressionDef.module.exports.ExpressionDef.ExpressionDef.exec (node_modules/cql-execution/lib/elm/reusable.js:23:53)
      at Executor.module.exports.Executor.Executor.exec_patient_context (node_modules/cql-execution/lib/runtime/executor.js:62:71)
      at Executor.module.exports.Executor.Executor.exec (node_modules/cql-execution/lib/runtime/executor.js:41:24)
      at Context.testFunc (test/loadTestCases/index.js:138:36)
```

This is in version `cql-execution-0.0.6-011abcd0c243d017e47ed82e2c74bd0acc46841f`. I haven't test the `Age*At` functions, but they may have the same problem.

Fortunately this bug may already be fixed on the cql4bonnie branch by the changes to  `Src/coffeescript/cql-execution/src/elm/clinical.coffee` in 0ba67baebf3165f0d0fc2cbd2826d231c9593e9c.

jgibson, 2017-07-25:
I can confirm that this bug is fixed on the cql4bonnie branch.

brynrhodes, 2018-09-12:
This issue was moved to cqframework/cql-execution#45

Closed 2018-09-12.

Thread 195 (2017-07-21):

Validation of UCUM units

JSRankins, 2017-07-21:
The CQL Release 1.2 standard allows for the use of UCUM units when they are need for specifying certain criteria:

```
In addition, CQL supports any valid Unified Code for Units of Measure (UCUM) unit code using the string representation of the UCUM code immediately following the numeric value, as shown in the first example in this section. UCUM codes can be specified in the case-sensitive (c/s) or case-insenstive form (c/i).
```

These units are not currently validated within the CQL-to-ELM translator. The inaccurate spelling of a UCUM code can cause issues within an execution environment. Based on conversations with @brynrhodes, we are creating a ticket to get this validation added for authoring purposes, so users of the MAT or other authoring environments that use CQL-to-ELM translator can know when the provide incorrectly spelled codes.

brynrhodes, 2018-04-12:
This feature is included in release [1.2.19](https://github.com/cqframework/clinical_quality_language/releases/tag/v1.2.19).

Closed 2018-04-12.

Thread 197 (2017-07-25):

CQL-to-ELM translates 'overlaps day of' as 'OverlapsAfter'

cmoesel, 2017-07-25:
Given the following CQL:
```
library OverlapsBug

define Bug:
  Interval[@2001-01-01T00:00:00.0, @2001-02-01T12:34:56.789]
    overlaps day of Interval[@2001-02-01T23:45:56.789, @2001-03-01T00:00:00.0]
```

The CQL-to-ELM translator will incorrectly generate an `OverlapsAfter` operator rather than an `Overlaps` operator:

```xml
<?xml version="1.0" encoding="UTF-8"?>
<library xmlns="urn:hl7-org:elm:r1" xmlns:t="urn:hl7-org:elm-types:r1" xmlns:xsi="http://www.w3.org/2001/XMLSchema-instance" xmlns:xsd="http://www.w3.org/2001/XMLSchema" xmlns:fhir="http://hl7.org/fhir" xmlns:a="urn:hl7-org:cql-annotations:r1">
   <identifier id="OverlapsBug"/>
   <schemaIdentifier id="urn:hl7-org:elm" version="r1"/>
   <usings>
      <def localIdentifier="System" uri="urn:hl7-org:elm-types:r1"/>
   </usings>
   <statements>
      <def name="Bug" context="Patient" accessLevel="Public">
         <expression precision="Day" xsi:type="OverlapsAfter">
            <operand lowClosed="true" highClosed="true" xsi:type="Interval">
               <low xsi:type="DateTime">
                  <year valueType="t:Integer" value="2001" xsi:type="Literal"/>
                  <month valueType="t:Integer" value="1" xsi:type="Literal"/>
                  <day valueType="t:Integer" value="1" xsi:type="Literal"/>
                  <hour valueType="t:Integer" value="0" xsi:type="Literal"/>
                  <minute valueType="t:Integer" value="0" xsi:type="Literal"/>
                  <second valueType="t:Integer" value="0" xsi:type="Literal"/>
                  <millisecond valueType="t:Integer" value="0" xsi:type="Literal"/>
               </low>
               <high xsi:type="DateTime">
                  <year valueType="t:Integer" value="2001" xsi:type="Literal"/>
                  <month valueType="t:Integer" value="2" xsi:type="Literal"/>
                  <day valueType="t:Integer" value="1" xsi:type="Literal"/>
                  <hour valueType="t:Integer" value="12" xsi:type="Literal"/>
                  <minute valueType="t:Integer" value="34" xsi:type="Literal"/>
                  <second valueType="t:Integer" value="56" xsi:type="Literal"/>
                  <millisecond valueType="t:Integer" value="789" xsi:type="Literal"/>
               </high>
            </operand>
            <operand lowClosed="true" highClosed="true" xsi:type="Interval">
               <low xsi:type="DateTime">
                  <year valueType="t:Integer" value="2001" xsi:type="Literal"/>
                  <month valueType="t:Integer" value="2" xsi:type="Literal"/>
                  <day valueType="t:Integer" value="1" xsi:type="Literal"/>
                  <hour valueType="t:Integer" value="23" xsi:type="Literal"/>
                  <minute valueType="t:Integer" value="45" xsi:type="Literal"/>
                  <second valueType="t:Integer" value="56" xsi:type="Literal"/>
                  <millisecond valueType="t:Integer" value="789" xsi:type="Literal"/>
               </low>
               <high xsi:type="DateTime">
                  <year valueType="t:Integer" value="2001" xsi:type="Literal"/>
                  <month valueType="t:Integer" value="3" xsi:type="Literal"/>
                  <day valueType="t:Integer" value="1" xsi:type="Literal"/>
                  <hour valueType="t:Integer" value="0" xsi:type="Literal"/>
                  <minute valueType="t:Integer" value="0" xsi:type="Literal"/>
                  <second valueType="t:Integer" value="0" xsi:type="Literal"/>
                  <millisecond valueType="t:Integer" value="0" xsi:type="Literal"/>
               </high>
            </operand>
         </expression>
      </def>
   </statements>
</library>
```

If the `day of` phrase is removed from the CQL, it properly generates an `Overlaps` operator.

brynrhodes, 2017-07-31:
The fix for this issue is included in the 1.2.11-SNAPSHOT release.

Closed 2017-07-31.

Thread 210 (2017-08-08):

Comments inside expression causing unexpected formatting

jackcmeyer, 2017-08-08:
When using the CQL Formatter on the following CQL Library:

```
library Test version '0.0.000'

using QDM version '5.3'

parameter "Measurement Period" Interval<DateTime>

context Patient

define "Test":
	// some coment here
	 exists (
		 ["Laboratory Test, Performed"]E
		 	where E.result > @2016-05-06
	 )
```

results in:

```
library Test version '0.0.000'

using QDM version '5.3'

parameter "Measurement Period" Interval<DateTime>

context Patient

define "Test":

	// some coment here
	  exists (["Laboratory Test, Performed"]E where E.result > @2016-05-06 )
```

Similarly, multi line comments have the same issue.

```
library Test version '0.0.000'

using QDM version '5.3'

parameter "Measurement Period" Interval<DateTime>

context Patient

define "Test":

		/* some coment here
			and another comment here
			and one more
		 */
	  exists (
			["Laboratory Test, Performed"]E
				where E.result > @2016-05-06
		)
```

results in:

```
library Test version '0.0.000'

using QDM version '5.3'

parameter "Measurement Period" Interval<DateTime>

context Patient

define "Test":

		/* some coment here
			and another comment here
			and one more
		 */
	   exists (["Laboratory Test, Performed"]E where E.result > @2016-05-06 )
```

JSRankins, 2017-08-15:
@brynrhodes  and @c-schuler:
Pull Request https://github.com/cqframework/clinical_quality_language/pull/211 was pushed to correct this issue. However, the comment in the pull request is not consistent with what is in CQL if we understand the comment correctly. The comment in the pull request is below.

```
Comment support is limited (comments within expressions will cause syntax issues - keep comments above or below expressions).
```

We do not understand what is intended by this comment, but it seems to imply that comments internal to a definition are not supported. If this is the case, then it is not consistent with the CQL standard.

In addition, we have found that the use of a comments provided internally in a definition will sometimes cause an error to return even when the CQL syntax is correct. For example, when the formatter operates on this code...

```
library Test version '0.0.000'

using QDM version '5.3'

valueset "Dapsone and pyrimethamine": 'urn:oid:2.16.840.1.113883.3.464.1003.196.12.1202' version 'urn:hl7:version:eCQM%20Update%202017-05-05'
valueset "Leucovorin": 'urn:oid:2.16.840.1.113883.3.464.1003.196.12.1205' version 'urn:hl7:version:eCQM%20Update%202017-05-05'

parameter "Measurement Period" Interval<DateTime>

context Patient

define "CD4+ Count With Results and Medications 2":
                ["Medication, Order": "Leucovorin"] MOL
                                with ["Medication, Order": "Dapsone and pyrimethamine"] DapsoneOrder

                                // fdafds this statement
                                                such that DapsoneOrder.authorDatetime occurs 1 days or less after MOL.authorDatetime
                                with ["Medication, Order": "Dapsone and pyrimethamine"] MODP
                                                such that MODP.authorDatetime occurs 1 day or less after MOL.authorDatetime
                                where MOL.authorDatetime is not null

```

...the following output is received:

```
Encountered syntax errors:
[14:2]: mismatched input 'with' expecting {<EOF>, '<', '>', 'define', 'context', 'in', 'is', 'as', 'properly', 'between', 'and', '<=', '>=', '=', '!=', '~', '!~', 'contains', 'or', 'xor', 'implies', '|', 'union', 'intersect', 'except', 'less than', 'more than', 'on or', 'before', 'after', 'starts', 'ends', 'occurs', 'same', 'includes', 'during', 'included in', 'within', 'meets', 'overlaps', NUMBER}

Input CQL:
null
```

On the other hand, when the CQL expression is run through the CQL-to-ELM translator, it passes validation.

brynrhodes, 2017-08-22:
Addressed in v1.2.12-SNAPSHOT.

Closed 2017-08-22.

Thread 214 (2017-08-15):

Retrieve w/ code-valued expression errors if list-promotion is disabled

brynrhodes, 2017-08-15:
If list promotion is disabled, retrieves with a code-valued terminology target cannot resolve the membership operator:

    code "Emergency department patient visit (procedure)": '4525004' from "SNOMEDCT:2016-09" display 'Emergency department patient visit (procedure)'

    define "ED Visit": ["Encounter, Performed": "Emergency department patient visit (procedure)"]ED
      with ["Encounter, Order": "Decision to Admit to Hospital Inpatient"] Order
        such that Order.authorDatetime during ED.relevantPeriod

brynrhodes, 2017-08-22:
Addressed in v1.2.12-SNAPSHOT.

Closed 2017-08-22.

Thread 220 (2017-08-24):

CQL formatter appending error String in code.

chinbaj, 2017-08-24:
When creating a parameter with syntax error, the CQL parser is appending error String inside the CQL code.

ex:
`parameter "test param" Interval<DateTime`

returns

```
parameter "test param" [java.lang.Exception: [1:40]: missing '>' at '<EOF>']

 Interval<DateTime.
```

c-schuler, 2017-08-24:
Hmm. I am unable to reproduce this. When I run `parameter "test param" Interval<DateTime`, I am getting the following back:
```
[java.lang.Exception: [1:40]: missing '>' at '<EOF>']

parameter "test param" Interval<DateTime
```
Which is the expected behavior. Are you using the most recent version of the formatter?

JSRankins, 2017-08-24:
@c-schuler, @brynrhodes  and @chinbaj, I believe the concern is getting the java error message back, which would then have to be caught and disposed of in an authoring tool before the original CQL that was passed through can be resurfaced to the user. Is there a reason the method is concatenating the error message with the original CQL expression?

c-schuler, 2017-08-24:
@JSRankins: I currently have a listener that detects syntax errors in the CQL and simply returns the error messages along with the original input. The reasoning is because "correctly" formatting syntax errors is hard =). I am open to suggestions on improving that.

chinbaj, 2017-08-24:
Agree with Stan.
@c-schuler , Are you testing against just the one expression or a complete CQL library.
I believe when you try to send in a single expression, the "[java.lang.Exception: ..." is appended at the top.
When you send in the entire CQL library, it gets inserted with the expression.

Either ways, since it comes back as a part of the library, the authoring tool UI shows it back on screen and causes further errors/confusion.

c-schuler, 2017-08-24:
Still unable to reproduce.
Tested:
```
library test version '0.0.000'
using QDM
valueset "Female Administrative Sex": '2.16.840.1.113883.3.560.100.2'
valueset "TestValueset": '1.1.111'
parameter "test param" Interval<DateTime
context Patient
define "TestDefinition":
	["Encounter, Performed": "TestValueset "]
```
Returned:
```
[java.lang.Exception: [10:0]: missing '>' at 'context']
library test version '0.0.000'
using QDM
valueset "Female Administrative Sex": '2.16.840.1.113883.3.560.100.2'
valueset "TestValueset": '1.1.111'
parameter "test param" Interval<DateTime
context Patient
define "TestDefinition":
	["Encounter, Performed": "TestValueset "]
```
Perhaps you can provide the library so I can test that?

How would you prefer the formatter to handle syntax errors?

chinbaj, 2017-08-24:
> The reasoning is because "correctly" formatting syntax errors is hard

Couldn't agree more. :-)

I checked further and the error insertion within the logic seems to be a side effect of the authoring tool code. So that's my bad.

But the larger point is that a library author is sending in a CQL library String and then getting back some additional Java exception messages as a part of the library.

> How would you prefer the formatter to handle syntax errors?

Is it possible to have a flag that we can set on the formatter?
Based on the this flag being set/not-set, formatter can prepend/not-prepend syntax errors to the output.

c-schuler, 2017-08-24:
> Is it possible to have a flag that we can set on the formatter?

Yeah, I can do that. The output in that case (when syntax errors are encountered) would be the original input without formatting.

@brynrhodes: thoughts?

chinbaj, 2017-08-24:
@jackcmeyer : thoughts

jackcmeyer, 2017-08-25:
@chinbaj this sounds good to me

brynrhodes, 2017-08-25:
Yes, I like that solution, but I would want to verify that whether or not the error messages are included in the output, the errors are still available to the caller as structured exceptions, right?

chinbaj, 2017-08-25:
>  I would want to verify that whether or not the error messages are included in the output, the errors are still available to the caller as structured exceptions, right?

It would be nice If it could be done.

c-schuler, 2017-08-25:
Thanks for everyone's input. After discussion with Bryn, we believe the best solution is to return a structure like so:
Result(Errors[], input/output)

When there are errors in the CQL a list of errors will be returned with the original input. When no errors are encountered an empty error list will be returned with the formatted output.

If there aren't any objections, I will move forward with this implementation.

chinbaj, 2017-08-25:
Seems fine with me. Thanks a lot for making this change,

brynrhodes, 2017-08-28:
Addressed in v.1.2.13-SNAPSHOT

Closed 2017-08-28.

Thread 229 (2017-09-05):

Commented-out demographics function in CBP example

WilliamParker, 2017-09-05:
In the [CBP example](https://github.com/cqframework/clinical_quality_language/blob/master/Examples/library-cbp.cql) I see the following is commented out:

````
// TODO: Need to verify the demographic here
define "In Demographic":
    true
    //AgeInYearsAt(start of MeasurementPeriod) >= 40
````
This example seems to be distinct from the others in that it is using FHIR models.  Are there any known issues with age calculations on FHIR patient models that caused this to be commented out?  The following works for me when using QUICK but fails with an inability to find the FHIRHelpers library when using FHIR.  After some preliminary investigation I haven't found anything trying to load up the FHIRHelpers library based on debug statements around [addInclude](https://github.com/cqframework/clinical_quality_language/blob/v1.2.9-SNAPSHOT/Src/java/cql-to-elm/src/main/java/org/cqframework/cql/cql2elm/LibraryBuilder.java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) and, while I could easily be missing something as I haven't dug into the project too deeply yet, the commented-out example makes we wonder if I've stumbled onto an unsupported use-case.

````
define "InDemographic":
	AgeInYears() >= 16 and AgeInYears() < 24 and "Patient"."gender" = 'female'
````

WilliamParker, 2017-09-05:
Looking into this more, it seems that the CQL to ELM translation succeeds when I explicitly bring in FHIRHelpers like this:
````
include FHIRHelpers called FHIRHelpers
````

but not when I bring them in like this:

````
include FHIRHelpers
````

Right now it looks like my immediate issue has been resolved, but there may be relevant documentation and or error-handling work so I'll leave the issue open for now pending a decision by the maintainers of what to do with it.

brynrhodes, 2017-09-06:
Yeah, this example needs to be updated to the latest FHIR version, we're working on that on another repository and plan on updating this example once that's complete. The fact that it works when you include the "called" clause but not without it is surprising though, I'll take a look at that.

WilliamParker, 2017-09-21:
I revisited this today and I found I was able to get my query to compile regardless of whether I added a "called" clause.  I'm not sure what I had going on before - I suppose it is possible that there is some kind of nondeterminism at play, but it was more likely some kind of user error on my part.  I'll let you know if I'm able to reproduce the issue in the future.

brynrhodes, 2017-10-02:
Glad it's working, I'll close this issue then.

Closed 2017-10-02.

Thread 234 (2017-09-07):

Issue with comparing Quantities

rdingwell, 2017-09-07:
The following statement is taken from a measure that is currently being developed and highlights what I believe is an issue with the way the CQL spec currently handles comparisons of Quantities with incompatible units.
````
define "Pap Test with Results":
    ["Laboratory Test, Performed": "Pap Test"] LabTest
         where ( LabTest.result as Code in "Positive Result" )
	 or ( ( LabTest.result as Quantity ) < 100 '%' )
	 or ( ( LabTest.result as Quantity ) > 45 'mmol/L' )
	 or ( LabTest.result >= 30 )
````
According to the spec in a number of locations.

> For comparisons involving quantities, the dimensions of each quantity must be the same, but not necessarily the unit. For example, units of 'cm' and 'm' are comparable, but units of 'cm2' and 'cm' are not. Attempting to operate on quantities with invalid units will result in a run-time error.

In the case above the LabTest result can be coded either as a percentage or as millimoles per liter.  This presents a problem, if the result is a Quantity coded as mmol/L the initial comparison to a Quantity as a percentage is expected to throw a runtime error.

For instances where an expected Quantity can be coded in multiple, incompatible units there  does not appear to be a way to handle the situation without throwing a runtime error at some point.  I can see throwing exceptions for arithmetic operations on Quantities that are incompatible but think that something else needs to be considered for comparison operations.   Perhaps this could be handled by some sort of Uncertainty or possibly a qualifier of some sort that would allow for the comparison to be performed only if the units where compatible with each other.

cmoesel, 2017-09-07:
Another approach might be to leverage the three-valued logic that CQL supports and return `null` when comparisons are made using incompatible units.  Since `null` is basically equivalent to _maybe_ or _I don't know_, then this approach would essentially say _"Is 50 'mmol/L' < 100 '%'?  I don't know!"_

brynrhodes, 2017-09-08:
I agree that an error isn't the most friendly. I'm a little hesitant to return null, although I think it's probably the best answer. It's worth a comment to the STU, so I'll submit one related to this issue.

As a potential workaround though, you could test the unit:

    define "Pap Test with Results 2":
      ["Laboratory Test, Performed": "Pap Test"] LabTest
        where
          case
            when LabTest.result as Code in "Positive Result" then true
            when LabTest.result.unit = '%' then LabTest.result < 100 '%'
            when LabTest.result.unit = 'mmol/L' then LabTest.result > 45 'mmol/L'
            else LabTest.result >= 30
          end

rdingwell, 2017-09-08:
I thought about testing the units, and yes it would alleviate the issue with throwing an error but it comes with it's own problem.  Testing the units first requires them to be not just compatible but exactly the same so any units compatible with mmol/L, such as mmol/ml, will not be tested.

I agree with Chris that returning null seems to be the most appropriate thing to do.  I think that is what would happen if the result in the example was a Code that was not in the valueset specified in the first test anyway.  That would result in comparing a Code to Quantities and an Integer in subsequent tests.  If you say CQL can't tell whether a Code is greater than a Quantity or an Integer so return null then it seems the logical conclusion would be if units are incompatible return null.

brynrhodes, 2017-09-27:
Submitted as comment [1434](http://www.hl7.org/dstucomments/showdetail_comment.cfm?commentid=1434)

Closed 2017-09-27.

Thread 247 (2017-10-05):

installApp not working

doitviolet, 2017-10-05:
Current build throws an exception when using the the installApp option:

$ ./gradlew installApp

FAILURE: Build failed with an exception.

* What went wrong:
Task 'installApp' not found in root project 'cql-all'. Some candidates are: 'install'.

* Try:
Run gradlew tasks to get a list of available tasks. Run with --stacktrace option to get the stack trace. Run with --info or --debug option to get more log output.

* Get more help at https://help.gradle.org

BUILD FAILED in 1s

cmoesel, 2017-10-05:
In the most recent versions of gradle, `installApp` was deprecated.  Please use `installDist` instead:
```
$ ./gradlew installDist
```

I apologize for the confusion.  We'll update the README to reflect this.

Closed 2017-10-05.

Thread 258 (2017-11-21):

Retrieve library ELM XML from CQLTranslator

WilliamParker, 2017-11-21:
We have a use-case where we translate CQL queries to ELM XML programmatically.  This is being done via the CqlTranslator class, which has factory methods that take [input streams, strings, and files](https://github.com/cqframework/clinical_quality_language/blob/v1.2.16/Src/java/cql-to-elm/src/main/java/org/cqframework/cql/cql2elm/CqlTranslator.java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).  We can then invoke the [toXml method](https://github.com/cqframework/clinical_quality_language/blob/v1.2.16/Src/java/cql-to-elm/src/main/java/org/cqframework/cql/cql2elm/CqlTranslator.java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) to obtain the ELM AST that we then use to run the CQL query.  This works for queries that are entirely self-contained, but the XML returned does not contain the ELM for libraries referenced by the query.  This ELM is necessary for us to compile the query in its entirety.

The necessary information seems to be present in the LibraryManager class, specifically the [private libraries field](https://github.com/cqframework/clinical_quality_language/blob/v1.2.16/Src/java/cql-to-elm/src/main/java/org/cqframework/cql/cql2elm/LibraryManager.java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).  Libraries can be located via the [resolveLibrary method on LibraryManager](https://github.com/cqframework/clinical_quality_language/blob/v1.2.16/Src/java/cql-to-elm/src/main/java/org/cqframework/cql/cql2elm/LibraryManager.java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) but this method requires that the caller be searching for a particular library.  Additionally, the fact that it takes a list of CqlTranslatorException suggests to me that this may not be intended to be called by external users, but rather used in internal translation.

Would you consider adding/merging a PR to add a method on CqlTranslator like

````
public getLibrariesXmlById <String, String>(){

}
````

where the keys would be the library ID and the values would be the ELM XML for the corresponding libraries?

I think something like this could be accomplished at a user level by walking the AST and finding all libraries that need to be looked up, but this seems like unnecessary complication and still seems potentially problematic if resolveLibrary isn't intended to be called by users.  For an implementor, the cleanest architecture seems to me to be to segregate the translation into an AST into its own component and have the rest of the implementation work purely in terms of this AST, regardless of how that AST was generated.

Alternatively, is there something I'm missing about the API and the reasoning behind it?  Perhaps there is a way to accomplish these goals already that I'm missing.

brynrhodes, 2017-11-22:
Hi @WilliamParker , it's great to hear that you're using the translator! The translator was designed as a component to be usable within IDE-style environments, so it does have support for loading library sources and translating them as necessary, but you have to register a library source provider so the component know where to find the source. By default, we implement a library source provider that just loads from the current directory, but we've also implemented a loader that will pull source from a FHIR Library resource, for example.

In your environment, you would provide an implementation of the [LibrarySourceProvider](https://github.com/cqframework/clinical_quality_language/blob/master/Src/java/cql-to-elm/src/main/java/org/cqframework/cql/cql2elm/LibrarySourceProvider.java) that pulled the source from the appropriate place, and then register it with the following:

    libraryManager.getLibrarySourceLoader().clearProviders();
    libraryManager.getLibrarySourceLoader().registerProvider(new FooLibrarySourceProvider());

Then your class will be invoked whenever the translator needs the source for a library. You'll be given the library identifier and version. You can take a look at the [DefaultLibrarySourceProvider](https://github.com/cqframework/clinical_quality_language/blob/master/Src/java/cql-to-elm/src/main/java/org/cqframework/cql/cql2elm/DefaultLibrarySourceProvider.java) for details on how we use the identifier and version to resolve to a file name by default.

Please let me know if this doesn't address the question, or if there are other ways to improve this and make it easier to use, happy to make changes that would improve the developer experience for the translation components.

WilliamParker, 2017-11-22:
I don't think that addresses the question I had, although it is good to confirm that implementing LibrarySourceProvider is an expected use-case. I'll try to clarify.  I am providing a LibrarySourceProvider implementation and registering it; my debug statements prove that it is being called by CQFramework.  In Java (the actual code is in another JVM language), I'd be doing something like this:

````
public MyLibrarySourceProvider implements LibrarySourceProvider {
     String getLibrarySource(VersionedIdentifier){

     }
}
````

The issue I'm having is that when I want to retrieve the library, I need a VersionedIdentifier to access it through the [resolveLibrary method](https://github.com/cqframework/clinical_quality_language/blob/v1.2.16/Src/java/cql-to-elm/src/main/java/org/cqframework/cql/cql2elm/LibraryManager.java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).  What I'm trying to do is have a function in my code that takes a CQL query and returns the ELM for both it and all libraries it consumes, either directly or transitively.  I can accomplish this by accessing the libraries field, but obviously forcibly accessing a private field isn't ideal.  That is:

````
    // Reflect on the LibraryManager class and access the java.lang.reflect.Field object for the libraries field.
    Field librariesField LibraryManager.class.getDeclaredField("libraries");
    // Forcibly reset this field from private to public.
    librariesField.setAccessible(true)
    Map<String, String> libraries = librariesField.get(myLibraryManager);
    Map<String, String> idToElm = new HashMap<String, String>();
    for (String id : libraries.keySet()):
           String elm = myCqlTranslator.convertToXml(libraries.get(id).getLibrary());
           idToElm.put(id, elm);
````

This gives me the information I need to return a map of the information:

````
{"query" : cql-query-elm
 "libraries" : {"library-id" : library-elm}}
 ````

 which can then be used in my compiler to create an executable format.

 Essentially, I was wondering whether the libraries field needs to be private or if a public accessor doing the same could be created, or alternatively if I'm missing a better way to retrieve all the libraries's ELM.

It would certainly be possible to wait to resolve the libraries until our compiler walked the AST, or to create a custom walk of it to find all libraries inside it upfront, but it seems like a cleaner separation of concerns to create a single pure data representation of all relevant CQL logic and pass it along rather than having callbacks into cql2elm.

Thanks for this project and the help by the way - implementing this is much easier with an AST to work with.

brynrhodes, 2017-11-30:
Apologies for the delayed response here. Yes, that makes sense to provide a single method, and it would just be a convenient packaging of all the results. So looking at the translator methods now, given that the translator is instantiated on a particular string of source CQL, it seems like a method to retrieve the ELM for any referenced libraries would be ideal, so something like:

    public Map<String, Library> getReferences()

The result of this would be the unique set of libraries referenced by the source CQL, transitively.

Then I'd want to also include something like:

    public Map<String, String> getReferencesAsXml()
    public Map<String, String> getReferencesAsJson()

To support easily obtaining the ELM in a particular format. Does that make sense?

WilliamParker, 2017-12-06:
That should work for us @brynrhodes, thanks.  We may not have time to create a PR in December but hopefully we can get to it in the near future if it isn't otherwise addressed first.

cc @bdrillard

brynrhodes, 2019-04-19:
Adressed in [1.3.14](https://github.com/cqframework/clinical_quality_language/releases/tag/v1.3.14)

Closed 2019-04-19.

Thread 259 (2017-11-21):

Reduce nesting level in output ELM for binary operators such as union and intersect

brynrhodes, 2017-11-21:
When translating binary operators that can be chained such as union, intersect, and except, the translator will produce a right-deep tree. For long chains, this can result in a deeply nested ELM output.

Within ELM itself, this could potentially be addressed by defining these operators as nary instead of binary operators. That should be submitted as a comment against the CQL specification.

Within the translator, without changing ELM, the output should be changed to produce a bushy tree, rather than a right-deep tree as it currently does.

p9g, 2017-11-22:
See also http://www.hl7.org/dstucomments/showdetail_comment.cfm?commentid=1500

brynrhodes, 2018-04-23:
Included in the [1.3 CQL Ballot](https://github.com/cqframework/clinical_quality_language/releases/tag/v1.3.0-SNAPSHOT) release.

Closed 2018-04-23.

Thread 261 (2017-11-30):

Support generic equality/equivalent operators in Translator

duncand, 2017-11-30:
See the following example CQL code:

```
library TestGenericEqual
define Test: 24 = 'hello'
define Test: Equal(24,'hello')
```

This currently fails to translate citing no matching signature ```Equal(Integer, String)``` but each define should be resolving to an ```Equal(Any, Any)```.

CQL spec section "2.5.1 Comparison Operators" says: "the equality and inequality operators can be used on any type of value within CQL"

CQL spec section "3.4.1 System-Defined Types" says: "The maximal supertype is System.Any. All other types derive from System.Any, meaning that any value is of some type, and also ultimately of type System.Any."

Given that the CQL type system features sub-typing and Any includes all values of the type system, it is logical for Equal(Any,Any) to exist and it has well-defined semantics:  Equal(x,y) returns true if and only if x and y are the same value, full stop.  When x and y are members of mutually disjoint types, the result of Equal(x,y) is simply false.

And so, Equal(x,y) should ALWAYS succeed in translating, regardless of the types of x and y.

Everything said above also applies to the operator Equivalent(Any,Any) aka "~".

cmoesel, 2017-11-30:
This is an interesting topic.  To play devil's advocate -- what is the advantage of allowing a comparison that is _known to always be false_?  It seems to me that this would indicate a bug in the logic -- and perhaps is better surfaced at compile time than at run time.

Can you point to a case where the result may actually be true or false, but the compiler chokes on the `Equals` expression?

(Of course, to play devil's advocate to my own devil's advocate, the compiler _does_ allow `24 = 24`, which is known at compile time to always be true, and is also likely a bug in logic.)

duncand, 2017-11-30:
Trying to evaluate an expression with no free variables is not a logical error due to having no free variables and it should not fail to translate solely for that reason.  One can perform constant expression folding at compile time however if the goal is performance or conciseness, though the Translator itself shouldn't do this by default in order to preserve the user's original logical structure.

But a constant expression isn't the main use case here, rather it is a simplified example.

Normally one or both of the arguments would be an arbitrary expression or parameter of type Any, typically when one is wanting to define a generic function, like this for example:

```
define private function foo(x Any, y Any, message String):
    bar(x ~ y, message)
```

It is a core tenet of good programming language design that if you have a value expression that may take the name of a variable or parameter or variable sub-expression in a particular place, you can also use a literal or constant expression in the same place.  Its a basic principle of orthogonality and of least surprise.

brynrhodes, 2017-12-01:
Can you help me understand what you mean by the term _free variable_ in this context and how it applies to this case?

@cmoesel is suggesting, quite reasonably, that attempting to compare values of different types is a logical error that the compiler can help the author detect. That's the whole point of the type system in the first place, and exactly my concern with introducing a generic equal that would circumvent that capability. Yes, it would help with writing generic functions, but the ability to write generic functions is not the target use case for this language.

duncand, 2017-12-01:
My term "free variable" was meant in a logic/math sense as an input to an expression which could vary for each evaluation; this was the opposite of a constant; for example, in "42 + x * 3 - y" the x and y are the free variables.  In the narrower sense, a free variable is an input not known at parse or compile time, because it is a parameter to a function containing the expression that can change per function call; in the wider sense, it is ultimately derived from a library parameter or external resource known only at runtime.

The point of the type system is to formally define how we classify and operate on data such that operations considered valid have well-defined behaviours and operations considered invalid don't execute or compile.

There is a key difference between an action that isn't logically valid and an action that the author is performing by mistake, and the type system should be distinguishing these.  The first should produce a fatal error that stops compilation or execution while the latter should merely display a warning but proceed with compilation anyway, as the author may have done it on purpose.

Really, "errors" and "warnings" are completely distinct classes, and there are a lot of things which could be made to receive warnings in the future that currently compile as the compiler becomes smarter about guessing what may have been author mistakes.

For example, per @cmoesel comment, the compiler allows "25 = 25" or "25 = 72" even though those results are also known at compile time and are likely author errors, so a WARNING should be raised when this happens, but it should still compile, and "25 = 'hello'" should be the same.

Equal(X,Y) and Equivalent(X,Y) are two of a small number of operators where X and Y really could each be any value at all and and the behaviour is well defined and reasonable.  Other operators in that small group include type membership test operators.  This reflects the real world that a type system is meant to be modelling.  A person can pick up two arbitrary objects from a bag or off the ground and can evaluate "are these the same?" regardless of how the objects otherwise are classified.  The logic is quite simple, and is unlike most other operators.

I am NOT proposing that most other "comparison" operators be defined to work for {Any,Any}; operators like less-than and greater-than etc should still only be defined within more specific types and not in general because it is more clear in the general case that there is no native way to order some things relative to each other, and if the author wanted to impose such an ordering they would do so pairwise declaring a function for each type that might be used together.

It is true that consistency across the language is important and so behaviour of Equal and Equivalent would or should correspond to behaviour of operators for generic collections such as the Contains() operator.

```
define a1: List<Any>{5,'hello',true}
define a2: a1 contains 5
define a3: a1 contains 'hello'
define a4: a1 contains 7
```

Here we have a List with a mixture of member types and the above code compiles and executes, resulting in true for a2 and a3 and doesn't result in true for a4.  Asking if X = Y is logically equivalent to asking if a set containing only X contains Y; currently the former doesn't compile while the latter does.

The ability to write generic functions is important even for CQL as that makes it easier to for library authors to factor their logic into reusable pieces.  There may be generic operations that a library author wants to perform but for which there is no corresponding operator built-in to the language.  The fact that CQL already has functions and a type hierarchy and generic types and operators built-in implies that these are desired features.  Extensibility is important as it means the core language doesn't have to be everything to everyone and authors can define their own functions to cover gaps without those having to be in the core.

CQL already defines the Any type for a reason.  It would be a shame to go to the trouble to include that type without actually exploiting its existence in reasonably useful ways.

duncand, 2017-12-02:
For those who find difficulty with my argument and like = Equal() to be strict to particular subtypes of Any to help catch user mistakes, I propose a middle ground that might be better for everyone.

I propose that only ~ Equivalent() is altered the way I propose and that Equal() is left alone.

The way I see it, the use cases wanting to easily compare that any 2 given things are the same value would most likely be wanting to use Equivalent() anyway.

Equivalence() is already the "fundamental sameness test" whose semantics are what all the collection type operators already use such as Contains() or Includes() or Intersect() and so on.  And operators like those are what I am trying to get better semantics matches with, and they already allow collections of mixed types.

Whereas, Equal() is more of a friendly wrapper for Equivalence() for the most common use cases that fits along with less-than or basic normal author logic rather than using Equivalence() directly.

So I modify my proposal such that only Equivalent() and NotEquivalent() are modified to successfully translate when given {Any,Any} such as Equivalent(42,'hello') and Equal() can continue to die with such.

brynrhodes, 2018-04-23:
In addressing #287, it's clear that we already support this in the translator, at least implicitly, with expressions like:

    { 1, 2, 3 } = { 'a', 'b', 'c' }

So I made several improvements to the translator overall to address this and that issue:

1. Added type constraints to the generic instantiation mechanism
2. Added common super type determination to generic instantiation
3. Changed Equal and Equivalent signatures to (Any, Any) rather than generics

These changes resolve the inconsistency, which was the most significant issue, but the changes also mean that `5 = 'a'` now translates without errors. Although I think there was value in the compile-time detection of a comparison that would always be false, I think the consistency of definitions between simple values and lists outweighs it.

Included in the [1.3 CQL Ballot](https://github.com/cqframework/clinical_quality_language/releases/tag/v1.3.0-SNAPSHOT) release.

duncand, 2018-04-23:
Thank you for making this translator change; it truly is serious usability improvement.

Closed 2018-04-23.

Thread 268 (2017-12-18):

Unexpected behavior for return clauses in a query

JSRankins, 2017-12-18:
CQL R1, STU 2 has the following description for return clauses:

```
The return clause of a CQL query allows the results of the query to be shaped. In most cases, the results of a query will be of the same type as the primary source of the query. However, some scenarios involve the need to extract only specific elements or to perform computations on the data involved in each element.
```

Based on this, the understanding is that items associated to the specified retrieve may be returned or the result of a function that is operating on something within the retrieve.
It does not appear that items that are foreign to the actual retrieve should be able to be returned. For example:

    ["Intervention, Performed"] I
        return ["Procedure, Performed"]

However, CQL-to-ELM appears to be supporting

    ["Intervention, Performed": "Referral"] I
        return ["Procedure, Performed": "Laparoscopy"]

Is this by design?

brynrhodes, 2017-12-19:
This is legal CQL, yes. The expression in a return is allowed to be any arbitrary expression. In this case, it's hard to see how that would be useful, and the result would be the same as just invoking `["Procedure, Performed": "Laparoscopy"]`. There are, however, valid use cases for returning an expression that is not related to the source, such as:

    ["Procedure, Performed": "Laparoscopy"] P
      return 'There are Laparoscopy Procedures for this Patient'

JSRankins, 2017-12-19:
In the example provided, I would think you would want to check for the nullness of P before returning that there were Laparoscopy procedures.

For example,

["Procedure, Performed": "Laparoscopy"] P
  return if P.code is not null then 'There are Laparoscopy Procedures for this Patient'

In that case, that would not violate what I'm suggesting, because the return is based on something specifically associated to an item in the retrieved set.
If you are suggesting that the return does not have to be associated with anything in the retrieve, I think that could cause an issue in CQL-based HQMF, because the HQMF's data criteria section would show up with an entry based on the retrieve in the CQL definition, which may never get used anywhere. For example, if I had done something like the following, the Intervention would should show up in the corresponding HQMF's data criteria because of rules in CQL-based HQMF, even in the case where the Intervention was not used anywhere else in the logic:

["Intervention, Performed": "Referral"] I
    return ["Procedure, Performed": "Laparoscopy"]

The presence of that data criteria entry could have an impact on what gets reported for the measure.

brynrhodes, 2017-12-19:
> In the example provided, I would think you would want to check for the nullness of P before returning that there were Laparoscopy procedures.

Well, checking that the Code is not null isn't quite checking for the "nullness of P". You could have a Procedure, Performed that didn't have a Code, and it would still be a Procedure, Performed. I think what you're saying is that you'd want to make sure that there was at least one Procedure, Performed in the result, which is what the constant return does, because of the fact that the return of a query is distinct. If there are no Procedure, Performed elements, then the result of the query will be an empty list:

    { }

If there are any Procedure, Performed elements, then the result of the query will be:

    { 'There are Laparoscopy Procedures for this Patient' }

JSRankins, 2017-12-19:
Thanks Bryn. I agree in theory, but I don't expect that unknown procedures would actually be recorded. Even if they were, I have a difficult time seeing where it would be useful to capture them. It's possible. At any rate, this does not really address the issue from a CQL-based HQMF side that I'm trying to bring up. Perhaps this is more specific CQL-based HQMF 'issue' is a discussion for another forum though. Thoughts?

brynrhodes, 2017-12-19:
Yeah, from the base CQL specification perspective, the return clause is by design any expression and I wouldn't want to limit that flexibility. I can see it maybe being guidance in the CQL-Based HQMF IG, or even style-guide type material though.

Closed 2018-03-04.

Thread 272 (2017-12-27):

Ambiguous conversion error when resolving choice types

brynrhodes, 2017-12-27:
The logic for implicitly converting a choice type to a value type will fail if multiple paths from the choice type to the target type can be found. For example, both FHIR.date and FHIR.dateTime can be implicitly converted to a System.DateTime, so a choice that includes both will result in an error. Worse still, the error is tangential because it is encountered while attempting to resolve the best conversion path for an operator, so it arises in apparently unrelated contexts:

    library TestChoiceTypes
    using FHIR version '3.0.0'
    include FHIRHelpers version '3.0.0' called FHIRHelpers
    context Patient
    define TestChoice:
      [QuestionnaireResponse] Q
        with Q.item i1
          such that (i1.answer[0].value) > 18

The best behavior, however, is clearly to allow both choices to be converted, inserting a runtime test for the type to determine the appropriate conversion path.

brynrhodes, 2018-01-12:
Included in release 1.2.18

Closed 2018-01-12.

Thread 286 (2018-01-23):

hasValue() is not resolving in FHIRPath expressions

brynrhodes, 2018-01-23:
The following constraint evaluation from the FHIR specification fails to translate:

    library "ele-1"
    using FHIR version '3.0.0'
    parameter Context Patient
    define Constraint: Context.select(hasValue() | (children().count() > id.count()))

The error given is "could not resolve method hasValue()"

brynrhodes, 2018-04-12:
This feature is included in release [1.2.19](https://github.com/cqframework/clinical_quality_language/releases/tag/v1.2.19)

Closed 2018-04-12.

Thread 288 (2018-01-26):

Indexed Accessors in Retrieve Code Properties

bdrillard, 2018-01-26:
I've noticed that the `codeProperty` of a `retrieve` apparently cannot be resolved if that path makes use of an indexer. For [Encounter](https://www.hl7.org/fhir/encounter.html), `type` is a CodeableConcept field of cardinality 0..1. We expect the following queries to compile correctly (and they do):

```
define EncounterPriorityRetrieve: exists([Encounter: priority in "ValueSet"])
define EncounterPriorityQuery: exists([Encounter] E where E.priority.coding[0].code = 'value')
```
Encounter also has the `type` field of cardinality 0..*. This query compiles as expected,

```
define EncounterTypeQuery: exists([Encounter] E where E.type[0].coding[0].code = 'value')
```

but if we attempt to use an indexed accessor that would evaluate to a single CodeableConcept in the retrieve, we get the ELM semantic warnings, `"Could not resolve code path type[0] for the type of the retrieve FHIR.Encounter."` and `"Could not resolve membership operator for terminology target of the retrieve."`:

```
define EncounterTypeRetrieve: exists([Encounter: "type[0]" in "ValueSet"])
```

In the ELM, the `codeProperty` on the retrieve is simply `"type[0]"`.

Should CQL have retrieve path behavior defined against indexed fields where the index would resolve to a single CodeableConcept to check against a ValueSet, or is perhaps a CQL author expected to filter lists of CodeableConcepts against a valueset in a different way? If the former, should the `codeProperty` field have more AST information attached than just a string of the field name and array index, or should an implementation against the AST parse out the necessary index operation from that `codeProperty` string?

brynrhodes, 2018-01-26:
Hi @bdrillard, the translator will resolve paths through list-valued properties, so you don't provide the indexer in the path. However, because the code path is resolved with either an `in` or an `=`, the code path will be "demoted" to a singleton if it's list-valued. In other words, the translator will assume that the data access layer will "decide" which index of the list to use, where the most reasonable approach is to say that if the intersection is non-empty. This is actually the subject of an STU comment as well, and we plan to introduce an overload of "in" that can work in this way, specifically to support the use of List-valued code properties. Does that help?

bdrillard, 2018-01-29:
Thanks @brynrhodes for the clarification. I see we should just use `type` in this case, and let the compiler discover how to handle the field. Since as you say the field gets "demoted" to a _singleton_ (which I can also see with the semantic warning that's thrown), but that reasonable behavior is to check if the code/ValueSet intersection is non-empty, do you suggest we address the CodeableConcept array at index 0, or that we scan across the CodeableConcept array for the first instance having a Coding in the ValueSet?

A formally overloaded `in` would be very useful. At the moment, it appears from the perspective of the generated ELM, there's nothing to distinguish a retrieve against an array of CodeableConcept from a single CodeableConcept (the generated `Retrieve` node has the same form with a string `codeProperty` and no other type information in either case), so for a CQL runtime implementation, it seems we can't statically determine whether we should be addressing an array of CodeableConcept or a scalar CodeableConcept, but would have to check if the field is an array or scalar at runtime.

brynrhodes, 2018-03-04:
STU comment [#1447](http://www.hl7.org/dstucomments/showdetail_comment.cfm?commentid=1447) will add an overload for `in` to take a list of `CodeableConcept` as the first argument.

Closed 2018-03-04.

Thread 294 (2018-01-31):

coffeescript execution framework example throws exception

twilson650, 2018-01-31:
I followed the example in the README.md here

https://github.com/cqframework/clinical_quality_language/tree/master/Src/coffeescript/cql-execution

And when I ran the simple age example I got the following error. I suspect the sample patient format might be wrong, as it's trying to access an "entry" object that doesn't exist:

$ node age-execute
Library {
  source:
   { library:
      { identifier: [Object],
        schemaIdentifier: [Object],
        usings: [Object],
        parameters: [Object],
        statements: [Object] } },
  usings: [ { name: 'QUICK', version: undefined } ],
  parameters:
   { MeasurementPeriod:
      ParameterDef {
        name: 'MeasurementPeriod',
        default: [Interval],
        parameterTypeSpecifier: undefined } },
  codesystems: {},
  valuesets: {},
  codes: {},
  concepts: {},
  expressions:
   { Patient:
      ExpressionDef {
        name: 'Patient',
        context: 'Patient',
        expression: [SingletonFrom] },
     InDemographic: ExpressionDef { name: 'InDemographic', context: 'Patient', expression: [And] } },
  includes: {} }
/Users/tomwilson/github/clinical_quality_language/Src/coffeescript/cql-execution/lib/cql-patient.js:126
    filtered = this.entry().filter(function(e) {
                           ^

TypeError: Cannot read property 'filter' of undefined
    at Bundle.FHIR.Bundle.findRecords (/Users/tomwilson/github/clinical_quality_language/Src/coffeescript/cql-execution/lib/cql-patient.js:126:28)
    at Bundle.FHIR.Bundle.findRecord (/Users/tomwilson/github/clinical_quality_language/Src/coffeescript/cql-execution/lib/cql-patient.js:141:17)
    at PatientSource.nextPatient (/Users/tomwilson/github/clinical_quality_language/Src/coffeescript/cql-execution/lib/cql-patient.js:239:79)
    at new PatientSource (/Users/tomwilson/github/clinical_quality_language/Src/coffeescript/cql-execution/lib/cql-patient.js:228:12)
    at Object.<anonymous> (/Users/tomwilson/github/clinical_quality_language/Src/coffeescript/cql-execution/lib/age-execute.js:15:13)
    at Object.<anonymous> (/Users/tomwilson/github/clinical_quality_language/Src/coffeescript/cql-execution/lib/age-execute.js:37:4)
    at Module._compile (module.js:660:30)
    at Object.Module._extensions..js (module.js:671:10)
    at Module.load (module.js:573:32)
    at tryModuleLoad (module.js:513:12)

cmoesel, 2018-01-31:
Thanks for reporting this.  We'll take a look at it and get back to you.  Last time I checked it was working, but some things may have changed since then.

cmoesel, 2018-02-02:
It looks like the example in the `Src/coffeescript/cql-execution/src/example` folder was up-to-date, but the corresponding walk-through in the `README.md` was _not_.  There were several issues which it seems you must have already run into and figured out, but the biggest issue was that the format of the patient data was incorrect -- it needed to be formatted as FHIR bundles.  It should work if you update your code to use the following `psource` definition:

```coffee
psource = new cql.PatientSource [ {
    "resourceType": "Bundle",
    "id": "example1",
    "meta": {
      "versionId": "1",
      "lastUpdated": "2014-08-18T01:43:30Z"
    },
    "base": "http://example.com/base",
    "entry" : [{
        "resource": {
        "id" : "1",
        "meta" :{ "profile" : ["patient-qicore-qicore-patient"]},
        "resourceType" : "Patient",
        "identifier": [{ "value": "1" }],
        "name": {"given":["John"], "family": ["Smith"]},
        "gender": "M",
        "birthDate" : "1980-02-17T06:15"}
        }
    ]
  }, {
    "resourceType": "Bundle",
    "id": "example1",
    "meta": {
      "versionId": "1",
      "lastUpdated": "2014-08-18T01:43:30Z"
    },
    "base": "http://example.com/base",
    "entry" : [{
        "resource": {
        "id" : "2",
        "meta" :{ "profile" : ["patient-qicore-qicore-patient"]},
        "resourceType" : "Patient",
        "identifier": [{ "value": "2" }],
        "name": {"given":["Sally"], "family": ["Smith"]},
        "gender": "F",
        "birthDate" : "2007-08-02T11:47"}
        }
    ]
  } ]
```

I've updated the README in the Pull Request linked above this comment.

Thanks for reporting this, and I apologize for the inconvenience!

twilson650, 2018-02-02:
Thank you, yes, I figured it was the FHIR bundle format. The script is running without error, however it looks like it's returning both patients in the results when it should only be returning one (age between 2 and 18).

twilson650, 2018-02-02:
Okay now I see the inDemographic attribute, and it is being populated correctly. Closing this.

Closed 2018-02-02.

Thread 298 (2018-02-02):

Could not resolve membership operator for terminology target of the retrieve.

cmoesel, 2018-02-02:
When compiling CQL against FHIR 1.0.2, most retrieves cause a warning.  For example, given the following simple CQL:
```
library Test version '1'
using FHIR version '1.0.2'
valueset "Systolic Blood Pressure": '2.16.840.1.113762.1.4.1104.2'
context Patient
define SBP: [Observation: "Systolic Blood Pressure"]
```
the following warning is emitted:
```
Warning:[5:13, 5:52] Could not resolve membership operator for terminology target of the retrieve.
```

I confirmed that `Observation` does define a `primaryCodeProperty`.  Might the problem be that the `primaryCodeProperty` (which is `code`) is a `FHIR.CodeableConcept` instead of a `System.CodeableConcept`?

brynrhodes, 2018-02-16:
Hi @cmoesel , yes, that's the problem. If you include FHIRHelpers, with this line:

    include FHIRHelpers version '1.0.2' called FHIRHelpers

Then it translates successfully because the implicit conversion from FHIR.CodeableConcept to System.Concept will be used.

cmoesel, 2018-02-16:
Thanks, Bryn!  I will give it a try!

cmoesel, 2018-02-19:
I can now confirm that including `FHIRHelpers` resolved the issue.  Thanks for the tip.

Closed 2018-02-19.

Thread 303 (2018-02-28):

Missing references to logic in annotations

brynrhodes, 2018-02-28:
In the following excerpt, the annotations included in the ELM output do not contain references to all the components. In particular, the else portion of the conditional expressions in the final two terms of the union:

    define "Age Dependent Combination Risk Factors":
    	"Combination Risk Factors Applicable Any Time"
    		union "Combination Risk Factors From Patient History"
    		union "Osteopenia Before Measurement Period"
    		union "Current Tobacco User"
    		union "Average of Two Drinks Per Drinking Day"
    		union ( if "Glucocorticoid Medication Duration Greater Than or Equal to 90 Days" then { true } else { } )
    		union ( if "First BMI in Measurement Period" is not null then { "First BMI in Measurement Period" } else { } )

brynrhodes, 2018-04-27:
Note that this issue is related to at least [BONNIE-452](https://oncprojectracking.healthit.gov/support/browse/BONNIE-452). Re-expressing criteria using a different approach that does not require the if/then works around the issue, so this issue is being addressed as part of 1.3 Ballot Support.

brynrhodes, 2019-04-19:
Adressed in [1.3.14](https://github.com/cqframework/clinical_quality_language/releases/tag/v1.3.14)

Closed 2019-04-19.

Thread 305 (2018-03-02):

Use of Retrieve and Query in a Parameter

bdrillard, 2018-03-02:
The `expression.xsd` file describes a `ParameterDef` as taking a possible `default` attribute, which is defined as an arbitrary `expression`. Things like

```
parameter IntParameter default 0
parameter DateTimeParameter default DateTime(2018, 1, 1, 0, 0, 0)
```

make enough sense, but the spec doesn't seem to imply that a query or retrieve _wouldn't_ be acceptable. At least, they seem permissible to the compiler:

```
library Query version '1'

using FHIR version '3.0.0'

include FHIRHelpers called FHIRHelpers

parameter RetrieveParameter default [Condition]
parameter QueryParameter List<FHIR.Condition> default ([Condition] C where C.clinicalStatus = 'active')

context Patient

define GetRetrieveParameter: RetrieveParameter
define GetQueryParameter: QueryParameter
```

`RetrieveParameter` appears to compile without any warning. `QueryParameter` however, throws "Internal translator error" annotations starting at the default value, but still seems to compile into an AST just fine. Interestingly, if the type is removed from `QueryParameter`, the query still compiles as well as if it was there, but another "semantic" annotation error is thrown saying that the compiler "Could not determine parameter type for parameter QueryParameter", which seems anomalous since the AST appears to have gotten all the correct type information in the node `resultTypeSpecifiers`.

The big question is that since parameters have no notion of their `Context`, (assuming a Retrieve in a parameter is acceptable) it would seem we would only know whether it should pull all resources for one patient, or for all patients based on _where_ the parameter is _accessed_. I suppose this would mean a single parameter could have two different meanings depending not on the way the value expression is declared, but depending on where that value expression is evaluated.

Since it also seems that parameters can reference previously defined parameters in their default values, this would seem to imply parameters would have to lazily evaluate, since their values in some instances are dependent on the calling context.

What are some of the expected semantics of Retrieves and Queries in parameter default values, and how should those expected to be evaluated against differing Contexts?

cmoesel, 2018-03-02:
That's a great question, and a great analysis of the implications of having _retrieves_ as default parameter values.  @brynrhodes should confirm, but I don't think we ever intended for _retrieves_ to be used as default values.  While the specification is not clear about this, I think that default parameter values are intended to be static values, with perhaps the exception of the system functions: `Today()` and `Now()`.

Is there a strong use case for using a _retrieve_ as a default value?  As you noted, supporting such a thing would introduce significant implementation burden.  I believe that you could accomplish the same thing via other means.  For example, see below for an alternate approach to accomplishing what you described below:

```
library Query version '1'

using FHIR version '3.0.0'

include FHIRHelpers version '3.0.0' called FHIRHelpers

parameter RetrieveParameter List<FHIR.Condition> default null
parameter QueryParameter List<FHIR.Condition> default null

context Patient

define GetRetrieveParameter:
  if RetrieveParameter is not null then RetrieveParameter
  else [Condition]

define GetQueryParameter:
  if QueryParameter is not null then QueryParameter
  else [Condition] C where C.clinicalStatus = 'active'
```
This approach works today (I was able to successfully compile it without errors).

bdrillard, 2018-03-02:
Thanks for the response @cmoesel. I can't personally think of a case where using a `retrieve` in a default value expression would be necessary, or at least any more desirable than the approach you lay out. My main concern was whether an implementation would have to support such expressions. If we don't have to, then as you say, it'll remove a major implementation concern.

If @brynrhodes confirms your assumption, it might help to log a clarifying issue to STU that requests updated doc stating parameters' default values can only be constructed from static values, or to perhaps even to log an issue to the CQL-to-ELM compiler that explicitly rejects `retrieve` in a parameter (just a suggestion on that one though, open to more discussion).

brynrhodes, 2018-03-03:
Hi @bdrillard, thank you for the detailed discussion. I agree with @cmoesel, parameters are intended to be "evaluable at compile-time", so they shouldn't be allowed to access retrieves, or expressions defined in the library, or other parameters. But you're right, the spec is not clear on this. I've logged an STU comment [#1553](http://www.hl7.org/dstucomments/showdetail_comment.cfm?commentid=1553) to address this issue.

Can you both take a look when you get a chance and let me know if you agree with the proposal there?

cmoesel, 2018-03-05:
Bryn -- the change looks good.  The only thing I thought of considering was if we should allow `Today()` or `Now()` as valid default values.  That seems like something for which there might be use cases.

That said, drawing the line at compile-time evaluation makes the line very clear -- and probably simplifies implementation further -- so I'm OK w/ _not_ supporting `Today()` or `Now()` (especially since that use case can still be accomplished via expressions in the CQL).

bdrillard, 2018-03-05:
Thanks for submitting the STU comment, @brynrhodes. I think the definition you recommend is the proper one (purely evaluable at compile-time). I also agree with @cmoesel in that it makes sense to _not_ allow `Today()` and `Now()` in parameters, since a DRY-enough pattern can be written using regular CQL expressions when `Today()` and `Now()` are necessary. For authors who might discover this thread later, an example is probably something like,

```
...

// This parameter can be overridden by the User
parameter MyYearInterval Interval<DateTime> default null

context Patient

// This expression provides the 'default', and can be used throughout the library
define DefaultYearInterval:
    Interval[DateTime((year from Today()) - 1, 1, 1, 0, 0, 0), DateTime((year from Today()), 1, 1, 0, 0, 0)]

define MyOtherExpression:
    if MyYearInterval is not null then MyYearInterval else DefaultYearInterval ...

...
```

Closed 2018-04-12.

Thread 311 (2018-03-19):

Use of Date Ranges in a Retrieve

bdrillard, 2018-03-19:
The July 2017 CQL spec states in section 4.17

> In addition, the Retrieve introduces the ability to specify optional criteria for the request. The available criteria are intentionally restricted to the set of codes involved, and the date range involved.

A closer look at the CQL grammar (linked here as the [`antlr`](https://github.com/cqframework/clinical_quality_language/blob/master/Src/grammar/cql.g4#L208) grammar for `retrieve`, but the same can be seen in section 8.4 of the spec) seems to indicate no syntax yet exists for specifying a "date range" as a filtering criterion in a `retrieve`.

Do retrieve operations only support filtering by valuesets at the moment?

cmoesel, 2018-03-19:
I agree that it is not directly exposed in the grammar.  Instead, the CQL-to-ELM translator supports a special _date range optimization_ feature.  When this feature is on, if the CQL-to-ELM translator detects a date range clause in the `where` statement, it will automagically translate it into an ELM `Retrieve` with a `dateRange` and `dateProperty`.  I don't think this feature is on by default, but I've just tested that it does work when enabled.

Given this CQL:
```
library DateFilter version '1'
using QDM version '5.3'
context Patient
define JanProcedures: ["Procedure, Performed"] P where P.incisionDatetime in Interval[@2018-01-01T00:00:00.0, @2018-02-01T00:00:00.0)
```
the date-range-optimization enabled CQL-to-ELM produced this ELM XML:
```xml
<?xml version="1.0" encoding="UTF-8"?>
<library xmlns="urn:hl7-org:elm:r1" xmlns:t="urn:hl7-org:elm-types:r1" xmlns:xsi="http://www.w3.org/2001/XMLSchema-instance" xmlns:xsd="http://www.w3.org/2001/XMLSchema" xmlns:fhir="http://hl7.org/fhir" xmlns:qdm43="urn:healthit-gov:qdm:v4_3" xmlns:qdm53="urn:healthit-gov:qdm:v5_3" xmlns:a="urn:hl7-org:cql-annotations:r1">
   <identifier id="DateFilter" version="1"/>
   <schemaIdentifier id="urn:hl7-org:elm" version="r1"/>
   <usings>
      <def localIdentifier="System" uri="urn:hl7-org:elm-types:r1"/>
      <def localIdentifier="QDM" uri="urn:healthit-gov:qdm:v5_3" version="5.3"/>
   </usings>
   <statements>
      <def name="Patient" context="Patient">
         <expression xsi:type="SingletonFrom">
            <operand dataType="qdm53:Patient" templateId="Patient" xsi:type="Retrieve"/>
         </expression>
      </def>
      <def name="JanProcedures" context="Patient" accessLevel="Public">
         <expression xsi:type="Query">
            <source alias="P">
               <expression dataType="qdm53:PositiveProcedurePerformed" templateId="PositiveProcedurePerformed" dateProperty="incisionDatetime" xsi:type="Retrieve">
                  <dateRange lowClosed="true" highClosed="false" xsi:type="Interval">
                     <low xsi:type="DateTime">
                        <year valueType="t:Integer" value="2018" xsi:type="Literal"/>
                        <month valueType="t:Integer" value="1" xsi:type="Literal"/>
                        <day valueType="t:Integer" value="1" xsi:type="Literal"/>
                        <hour valueType="t:Integer" value="0" xsi:type="Literal"/>
                        <minute valueType="t:Integer" value="0" xsi:type="Literal"/>
                        <second valueType="t:Integer" value="0" xsi:type="Literal"/>
                        <millisecond valueType="t:Integer" value="0" xsi:type="Literal"/>
                     </low>
                     <high xsi:type="DateTime">
                        <year valueType="t:Integer" value="2018" xsi:type="Literal"/>
                        <month valueType="t:Integer" value="2" xsi:type="Literal"/>
                        <day valueType="t:Integer" value="1" xsi:type="Literal"/>
                        <hour valueType="t:Integer" value="0" xsi:type="Literal"/>
                        <minute valueType="t:Integer" value="0" xsi:type="Literal"/>
                        <second valueType="t:Integer" value="0" xsi:type="Literal"/>
                        <millisecond valueType="t:Integer" value="0" xsi:type="Literal"/>
                     </high>
                  </dateRange>
               </expression>
            </source>
         </expression>
      </def>
   </statements>
</library>
```

bdrillard, 2018-03-19:
Is the FHIR 3.0.0 model not supported at this time?

With the optimization enabled over the query

```
library Query version '1'

using FHIR version '3.0.0'

include FHIRHelpers called FHIRHelpers

define ConditionsInterval: [Condition] C
    where C.onset in Interval[@2017-01-01T00:00:00.0, @2018-01-01T00:00:00.0)
```

I receive this [elm](https://gist.github.com/bdrillard/0068d94a59f50126d2b4ca586f92d067) as output. Is this perhaps because the left-hand-side of the `In` operation requires wrapping with a FhirHelpers `ToDateTime` operation, and cannot evaluate simply to a CQL dateTime-typed path?

cmoesel, 2018-03-19:
I expect you're right -- the requirement to wrap the FHIR date in a CQL function (to get it to a system date) is causing the optimization to not get triggered.

The ELM `Retrieve` works via `dateRange` and `dateProperty` selectors.  It requires the `dateProperty` to to be of the type `System.DateTime`, but the FHIR model expresses date properties using FHIR types.

This same problem actually already exists for codes, because the `codeProperty` is expected to be a `System.Concept`, but the code properties in the FHIR model are FHIR `CodeableConcept` (or `Coding` or `code`).  So... we seem to have an exception for the `codeProperty` already.  It may be possible to make a similar exception for `dateProperty` and update the optimization code to recognize that opportunity.  But... I don't know how much work that would involve, and really, I think @brynrhodes would need to support the idea (and probably implement it too!).

brynrhodes, 2018-03-20:
Yes, the conversions between the FHIR system-defined types and the CQL system types are causing the optimization to be missed. It should be relatively easy to detect and correct, so I'm marking this as an enhancement request.

bdrillard, 2018-03-20:
Thanks for the clarifications, @cmoesel, @brynrhodes!

brynrhodes, 2020-03-25:
Addressed in 1.4.9-SNAPSHOT

brynrhodes, 2021-09-09:
Addressed by the new DataRequirementsProcessor, included in the 1.5.4 release.

Thread 338 (2018-06-21):

QDM 5.4 Model Info Issues in v13 Branch

JSRankins, 2018-06-21:
1.	The ‘method’ attribute was removed from the 'Assessment, Performed' datatype in the model info file, but it still exists in QDM 5.4 for that datatype
2.	No Positive and Negative profiles are in the Model Info file for the new 'Assessment, Order' datatype

Closed 2018-06-22.

Thread 1089 (2018-07-17):

FileBasedFhirProvider not accounting for possible Coding type during validation

c-schuler, 2018-07-17:
From Raman Srinivasan:
I’m looking for ED encounters using
`define EDEncs: [Encounter : class in EmerEncConcept]`

Where EmerEncConcept is defined as:
```
define EmerEncConcept:
  Concept {
    codes: {
       Code {system: 'http://hl7.org/fhir/v3/ActCode', code: 'EMER', display: 'emergency encounter'}
    }
}
```
Retrieve doesn’t bring back any encounters even though there are multiple ED encounter resources
Based on some debugging, it looks like we’re missing the case when resCodes is an instance of Coding(in FileBasedFhirProvider/retrieve)

Closed 2019-03-25.

Thread 343 (2018-07-24):

Dependency Refresh for Antlr4

brynrhodes, 2018-07-24:
Antlr4 tooling has new versions. Note that there may be an issue with the new version that results in incorrect parse trees for negation. See [CQLIT-154](https://oncprojectracking.healthit.gov/support/browse/CQLIT-124) for more.

brynrhodes, 2019-03-01:
Regression testing with the 4.7.2 ANTLR changes uncovered other issues with the way the updated ANTLR parser resolves potential ambiguities in the CQL. The ticket that initially spawned this issue (CQLIT-154) is an example. Several different resolution approaches are possible, but none of them within the required timeframe for the 1.3 Maintenance release, so this issue will be pulled from 1.3 Maintenance, and resolved as part of the 1.4 Ballot release.

Specifically, the tooling currently uses ANTLR version 4.5. The 4.6 version introduced a significant [change](https://github.com/antlr/antlr4/issues/1398) to the way left-recursive grammars are parsed, which dramatically improves performance (addressing issue #149), but introduces various regression failures and other difficulties due to differences in the resulting parse trees.

The most significant issue is that with ANTLR 4.6+, the following:

    define Test: { 1, 2, 3 } A bunch of gobbledygook that ANTLR ignores

This should result in a failure, but ANTLR parses the list selector and ignores the rest of the input, failing silently.

brynrhodes, 2020-03-21:
Note that changes to the 1.4 grammar around the specification of keywords and reserved words addressed the performance issue, and likely addresses the issues with switching to 4.6.

alexanderkiel, 2020-09-24:
It would be nice to have this fixed, because I have real-world queries with long chains of boolean logic. I currently use v1.4.9 with an ANTLR 4.6 runtime. Although this works for me, it seems a bit hacky.

Closed 2021-03-22.

Thread 351 (2018-08-29):

Switch default behavior for interval promotion/demotion support

brynrhodes, 2018-08-29:
Interval promotion and demotion can produce some unexpected results and so the translator switches controlling that behavior should default to having to enable the behavior, rather than the current default of having to disable it. This change is related to supported STU3#167.

brynrhodes, 2018-09-12:
Addressed in 1.3.4-SNAPSHOT

Closed 2018-09-12.

Thread 360 (2018-09-12):

List promotion/demotion is not occurring for in

brynrhodes, 2018-09-12:
We noticed a couple of the tests that involve list promotion are failing in the cql-execution repo with the new cql-to-elm translator (1.3.4).

    define FiveInFive: 5 in 5

Running that line through the cql-to-elm translator results in:

Translation Error(s):
[4:20, 4:25] Could not resolve call to operator In with signature (System.Integer,System.Integer).

It seems like List Promotion is now disabled by default, when we expect it to be enabled. We tried adding the flag to enable Interval Promotion, which seemed to turn List Promotion back on.

brynrhodes, 2018-09-12:
Addressed in 1.3.5-SNAPSHOT

Closed 2018-09-12.

Thread 362 (2018-09-14):

Same week as still translated despite no longer being supported

losborne, 2018-09-14:
> Note specifically that due to variability in the way week numbers are determined, comparisons involving weeks are not supported.
https://github.com/HL7/cql/blob/master/spec/09-b-cqlreference.adoc#812-same-as

We are still seeing same week as being translated with the 1.3.6 snapshot:

`define SameWeek: DateTime(2000, 3, 15, 13, 30, 25, 200, +1.0) same week as DateTime(2000, 11, 23, 8, 14, 47, 500, +1.0)`

Translates to:

```
{
  "localId" : "41",
    "name" : "SameWeek",
    "context" : "Patient",
    "accessLevel" : "Public",
    "expression" : {
      "localId" : "40",
      "precision" : "Week",
      "type" : "SameAs",
      "operand" : [ {
        "localId" : "30",
        "type" : "DateTime",
        "year" : {
          "localId" : "22",
          "valueType" : "{urn:hl7-org:elm-types:r1}Integer",
          "value" : "2000",
          "type" : "Literal"
        },
        "month" : {
          "localId" : "23",
          "valueType" : "{urn:hl7-org:elm-types:r1}Integer",
          "value" : "3",
          "type" : "Literal"
        },
        "day" : {
          "localId" : "24",
          "valueType" : "{urn:hl7-org:elm-types:r1}Integer",
          "value" : "15",
          "type" : "Literal"
        },
        "hour" : {
          "localId" : "25",
          "valueType" : "{urn:hl7-org:elm-types:r1}Integer",
          "value" : "13",
          "type" : "Literal"
        },
        "minute" : {
          "localId" : "26",
          "valueType" : "{urn:hl7-org:elm-types:r1}Integer",
          "value" : "30",
          "type" : "Literal"
        },
        "second" : {
          "localId" : "27",
          "valueType" : "{urn:hl7-org:elm-types:r1}Integer",
          "value" : "25",
          "type" : "Literal"
        },
        "millisecond" : {
          "localId" : "28",
          "valueType" : "{urn:hl7-org:elm-types:r1}Integer",
          "value" : "200",
          "type" : "Literal"
        },
        "timezoneOffset" : {
          "localId" : "29",
          "valueType" : "{urn:hl7-org:elm-types:r1}Decimal",
          "value" : "1.0",
          "type" : "Literal"
        }
      }, {
        "localId" : "39",
          "type" : "DateTime",
          "year" : {
            "localId" : "31",
            "valueType" : "{urn:hl7-org:elm-types:r1}Integer",
            "value" : "2000",
            "type" : "Literal"
          },
          "month" : {
            "localId" : "32",
            "valueType" : "{urn:hl7-org:elm-types:r1}Integer",
            "value" : "11",
            "type" : "Literal"
          },
          "day" : {
            "localId" : "33",
            "valueType" : "{urn:hl7-org:elm-types:r1}Integer",
            "value" : "23",
            "type" : "Literal"
          },
          "hour" : {
            "localId" : "34",
            "valueType" : "{urn:hl7-org:elm-types:r1}Integer",
            "value" : "8",
            "type" : "Literal"
          },
          "minute" : {
            "localId" : "35",
            "valueType" : "{urn:hl7-org:elm-types:r1}Integer",
            "value" : "14",
            "type" : "Literal"
          },
          "second" : {
            "localId" : "36",
            "valueType" : "{urn:hl7-org:elm-types:r1}Integer",
            "value" : "47",
            "type" : "Literal"
          },
          "millisecond" : {
            "localId" : "37",
            "valueType" : "{urn:hl7-org:elm-types:r1}Integer",
            "value" : "500",
            "type" : "Literal"
          },
          "timezoneOffset" : {
            "localId" : "38",
            "valueType" : "{urn:hl7-org:elm-types:r1}Decimal",
            "value" : "1.0",
            "type" : "Literal"
          }
      } ]
    }
}
```

brynrhodes, 2018-09-17:
Addressed in 1.3.7-SNAPSHOT

Closed 2018-09-17.

Thread 363 (2018-09-15):

Product(List<System.Quantity>) not supported

jbradl11, 2018-09-15:
The CQL example:

define QuantityProduct: Product({ 1.0 ‘mg’, 2.0 ‘mg’, 3.0 ‘mg’, 4.0 ‘mg’ })

Creates an error  when running it through the CQL-to-ELM translator:

<data.coffee#Product[5:25, 5:75]> Could not resolve call to operator Product with signature (list<System.Quantity>).

brynrhodes, 2018-09-17:
Addressed in 1.3.7-SNAPSHOT

Closed 2018-09-17.

Thread 1080 (2018-10-03):

Without filter not operating correctly with ...<precision>... between

jscherer-motivemi, 2018-10-03:
The without filter does now work correctly with an hours between filter parameter. The statement that is failing is as follows:

define ClaimWithQualifiyingPOSWithoutEncounter: ClaimWithQualifyingPOS C without InpatientEncounters E such that hours between C.billablePeriod."start" and E.period."start" <= 24

The context for this logic is available in the attached docu
[mmi_cql-issue_without_filter_not_working.txt](https://github.com/DBCG/cql_engine/files/2444325/mmi_cql-issue_without_filter_not_working.txt)
ment:

Closed 2019-08-15.

Thread 368 (2018-10-03):

Without filter not functioning correctly with hours between

jscherer-motivemi, 2018-10-03:
The without filter does now work correctly with an hours between filter parameter. The statement that is failing is as follows:

define ClaimWithQualifiyingPOSWithoutEncounter: ClaimWithQualifyingPOS C without InpatientEncounters E such that hours between C.billablePeriod."start" and E.period."start"  <= 24

The context for this logic is available in the attached doducment:
[mmi_cql-issue_without_filter_not_working.txt](https://github.com/cqframework/clinical_quality_language/files/2444074/mmi_cql-issue_without_filter_not_working.txt)

cmoesel, 2018-10-03:
Hi @jscherer-motivemi. Is this an issue against one of the execution engines?  If so, which one?

jscherer-motivemi, 2018-10-03:
Hi @cmoesel. I am not sure that I know. We use the CQL java engine version 1.2 currently. Let me know if you need additional information.

cmoesel, 2018-10-03:
OK.  In that case I'd recommend you file these against that specific project here:
https://github.com/DBCG/cql_engine

(FYI @brynrhodes)

Closed 2018-10-03.

Thread 369 (2018-10-03):

Distinct operator does not work with resources

jscherer-motivemi, 2018-10-03:
If you have duplicated resources in a list and apply the distinct operator, the duplicates are not removed.

cmoesel, 2018-10-03:
Hi @jscherer-motivemi. Is this an issue against one of the execution engines?  If so, which one?

jscherer-motivemi, 2018-10-03:
Hi @cmoesel. I am not sure that I know. We use the CQL java engine version 1.2 currently. Let me know if you need additional information.

cmoesel, 2018-10-03:
OK.  In that case I'd recommend you file these against that specific project here:
https://github.com/DBCG/cql_engine

(FYI @brynrhodes)

jscherer-motivemi, 2018-10-03:
@cmoesel, Thank you, I will do that.

Closed 2018-10-03.

Thread 372 (2018-10-23):

ConvertsTo* expression type

losborne, 2018-10-23:
`define Converts: ConvertsToBoolean(‘y’)`

is translated to a FunctionRef:
```
"expression" : {
    "localId" : "3",
    "name" : "ConvertsToBoolean",
    "type" : "FunctionRef",
    "operand" : [ {
        "localId" : "2",
        "valueType" : "{urn:hl7-org:elm-types:r1}String",
        "value" : "y",
        "type" : "Literal"
    } ]
}
```

Should this be `“type” : “ConvertsToBoolean”` instead?  The FunctionRef is throwing an error because ConvertsToBoolean is not defined in any library.

brynrhodes, 2019-04-19:
Adressed in [1.3.14](https://github.com/cqframework/clinical_quality_language/releases/tag/v1.3.14)

Closed 2019-04-19.

Thread 1078 (2018-10-29):

Add FHIR Query Options for queries that return FHIR results

MikeRileyGTRI, 2018-10-29:
When doing CQL queries for FHIR resources, it would be nice to be able to handle some extra options when searching. http://hl7.org/fhir/stu3/search.html

The possible search options you could add are:
_sort
_count
_include
_revinclude
_summary
_elements
_contained
_containedType

Mainly the big one is the _include and _revinclude, as only having to make one query to the server for referenced documents is a good practice for large-scale operations.

Much like what happens in BaseFhirDataProvider.java when we need to determine the patient reference key

    protected String getPatientSearchParam(String dataType) {

        switch (dataType) {

            case "Coverage":

                return "beneficiary";

            case "Patient":

                return "_id";

            case "Observation":

            case "RiskAssessment":

                return "subject";

            default: return "patient";

        }

    }
Instead of just an internal process to generate keys, maybe we could have a user keyword exposed to do the same thing within a certain Context? Like a "Patient-Include-All" Context?

Thread 379 (2019-01-09):

Choice-based primaryCodePaths for FHIR STU3

cmoesel, 2019-01-09:
The model-info for FHIR STU3 has several `primaryCodePath` values that are unresolvable by CQL-to-ELM.  These cause warnings like this to be emitted:
```
Could not resolve code path medicationCodeableConcept for the type of the retrieve FHIR.MedicationRequest.
```
and
```
Could not resolve membership operator for terminology target of the retrieve.
```

This seems to happen when the primaryCodePath refers to a choice.  In the model-info, the `primaryCodePath` uses the full name of the choice (as it would appear in the JSON) rather than the property name as defined in the model-info (e.g., it uses `medicationCodeableConcept` rather than `medication`).

Affected classes:

Class | Current primaryCodePath | Actual property name
--- | --- | ---
DeviceRequest | codeCodeableConcept | code
MedicationDispense | medicationCodeableConcept | medication
MedicationRequest | medicationCodeableConcept | medication
MedicationAdministration | medicationCodeableConcept | medication
MedicationStatement | medicationCodeableConcept | medication
MedicationDispense | medicationCodeableConcept | medication

I think the model-info should be updated to reflect the true property name.  In cases where a different choice is used (e.g., a `Reference`), engines should detect that the value is not a concept and ignore it.

If there is agreement, I can submit a PR with the necessary fixes.

brynrhodes, 2019-01-11:
@cmoesel, completely agree, these should be corrected.

brynrhodes, 2019-04-19:
Adressed in [1.3.14](https://github.com/cqframework/clinical_quality_language/releases/tag/v1.3.14)

Closed 2019-04-19.

Thread 382 (2019-01-28):

Implicit Use of FHIRHelpers Functions

bdrillard, 2019-01-28:
I'm noticing there seems to be a change in how the CQL-to-ELM project handles use of FHIRHelpers functions between versions 1.2.x and 1.3.x for FHIR 3.0.0.

The FHIR enumerated fields have their own types, but underneath are often represented as simple Strings nested in a "value". In CQL-to-ELM for 1.2.x, a FHIRHelper function was inferred and would then wrap any property call to such a field. However, the CQL-to-ELM compiler for version 1.3.x no longer seems to apply this implicit FHIRHelper function call. Taking `fhir:AdministrativeGender` as an example:

CQL

```
library Query version '1'
using FHIR version '3.0.0'

include FHIRHelpers version '3.0.0' called FHIRHelpers

context Patient

define GetGender: Patient.gender = 'female'
```

CQL-to-ELM v1.2.16 yields

```
      <def resultTypeName="t:Boolean" name="GetGender" context="Patient" accessLevel="Public">
         <expression resultTypeName="t:Boolean" xsi:type="Equal">
            <operand name="ToString" libraryName="FHIRHelpers" xsi:type="FunctionRef">
               <operand resultTypeName="fhir:AdministrativeGender" path="gender" xsi:type="Property">
                  <source resultTypeName="fhir:Patient" name="Patient" xsi:type="ExpressionRef"/>
               </operand>
            </operand>
            <operand resultTypeName="t:String" valueType="t:String" value="female" xsi:type="Literal"/>
         </expression>
      </def>
```

but CQL-to-ELM v1.3.10 yields

```
      <def resultTypeName="t:Boolean" name="GetGender" context="Patient" accessLevel="Public">
         <expression resultTypeName="t:Boolean" xsi:type="Equal">
            <operand resultTypeName="fhir:AdministrativeGender" path="gender" xsi:type="Property">
               <source resultTypeName="fhir:Patient" name="Patient" xsi:type="ExpressionRef"/>
            </operand>
            <operand resultTypeName="t:String" valueType="t:String" value="female" xsi:type="Literal"/>
         </expression>
      </def>
```

where the difference is the lack of a wrapping function call to `FHIRHelpers.ToString`.

I wondered if the definition of `Equal` was meant to capture the type-unwrapping here, but the [definition](https://github.com/cqframework/clinical_quality_language/blob/v1.3.10/Src/cql-lm/schema/elm/expression.xsd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) doesn't seem to say anything about that.

My questions here are

1. what change eliminated the implicit wrapping of certain FHIRHelpers functions over these special FHIR types?
2. what was the thinking behind the change?

I ask because the definition of functions like [`ToString`](https://github.com/cqframework/clinical_quality_language/blob/v1.3.10/Src/java/quick/src/main/resources/org/hl7/fhir/FHIRHelpers-3.2.0.cql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) when dispatched over an enumerated value type like AdministrativeGender "unwrapped" the value nesting in the FHIR structure. Without the implicit call as realized in the ELM, I'm not sure it's clear anymore how a runtime implementation will have to unwrap the FHIR structure.

**Also**: Given that `ReferralRequest.status` is also an example of an enumerated field like `Patient.AdministrativeGender`, I think this question is related to #371.

bdrillard, 2019-01-28:
Given that `ReferralRequest.status` is also an example of an enumerated field like `Patient.AdministrativeGender`, I think this question is related to #371.

brynrhodes, 2019-01-29:
Thank you for the report, I'm looking into this, it certainly seems like the wrong behavior.

rdingwell, 2019-01-29:
@brynrhodes I'm curious as to which you consider to be the wrong behavior?  Looking at the generated ELM it seems very odd to me that the inclusion of a CQL library would effect the output the way it does in the first example and unless there is something explicitly in the spec that says that's possible that would be the output that is incorrect.

bdrillard, 2019-01-30:
Some earlier context here -- it's been the case since #89 that the FHIRHelpers library is included by default any time FHIR is used for the data model.

I think the need here is that all of FHIR's enumerated types, as well as some of its special string types, like `UriType`, are actually structures having a `value` field holding a simple String. Since FHIRHelpers is pulled in by default, the compiler could infer the correct function usage (or at least it did previously).

Agreed there's some ambiguity here. At the moment, I don't think the CQL spec says anything about this special, type-based function inference in the context of FHIR models, so that may surprise an implementor to see it in the generated ELM.

I will say once that inferencing is understood, it does make the job of a CQL **author**, since the author doesn't have to explicitly call `ToString` over FHIR values that they see to functionally just be Strings (even though the FHIRModels think of them in implementation as enumerators).

I'd say the inferred function use is also easier on an **implementor** because if we're consuming data to their FHIRModels' specs, these enumerated values and other special types _will_ be wrapped in a "value" field. It's helpful for the ELM to indicate at least in some manner that the structure needs to be "unwrapped" to get at the FHIR data's String value when necessary.

brynrhodes, 2019-01-30:
@bdrillard, that's a fantastic summary of the background, thank you for that. @rdingwell, it's not the inclusion of the FHIRHelpers library that causes the implicit conversions to occur, it's the fact that the conversions are defined in the FHIR model info. The [Implicit Conversions](https://cql.hl7.org/03-developersguide.html#implicit-conversions) topic in the specification allows for data models to introduce their own implicit conversions, but to do so, the conversion definitions need to reference a function, which has to be defined in a library. So in order to take advantage of the conversions defined in FHIR, you have to include the FHIRHelpers library. To make that easier, the translator includes FHIRHelpers as a packaged resource, but I stopped short of automatically adding the include.

rdingwell, 2019-01-30:
@brynrhodes thanks for the clarification.  I understand the intention behind the idea of the implicit conversions but I think you probably recall that I'm not a huge fan of such magic at times.  I believe this sort of thing can become a bit problematic when doing conversions on coded values as well.  Coded values are bound to code systems and allowing matching on just the value of the code without any acknowledgement of the code system that it is expected to be from seems a bit wrong.

I see that the spec supports implicit conversions but feel the way that that functionality is defined could be a bit clearer.   From what I've seen I believe that the modelInfo.xsd is part of the specification, or at least included in the spec.  I think it needs to be very clear that using that XSD is the way to declare models across all implementations of CQL.   I also think that the ConversionInfo element is a bit vague, or at least there isn't any documentation on it that I have found.    The part that really bothers me about it is the function called for the conversion.  Is this supposed to be called from a helper library, if so, where is that library defined in the model, if it's not why not, it really seems important.

Overall, I just think there needs to be more documentation around defining data models and maybe that would provide enough guidance as to how this is all supposed to work within an implementation. However,  I think it would be more beneficial to provide a data modeling capability directly within the language itself.  This would provide a way for models, helper functions and conversion methods to all be defined in a single location that all implementations could make use of without the need of a separate modeling technology.   I think this would actually assist authors a bit better than the current approach as well because all of the documentation about the model would be defined in a single file in a format that they understand as opposed to some xml file squirreled away somewhere.

Just some thoughts.

brynrhodes, 2019-01-31:
@rdingwell , this is a great suggestion and you're highlighting the fact that there's a disconnect between the model definition and the library definition. This was an early design decision in CQL based on the fact that we didn't want the scope of the language to include model definition. If we had model definition constructs in CQL, then we could include those in the library and "models" would just be part of libraries. Then the conversion info wouldn't have to reference a library name magically.

However, that's a pretty significant scope increase for CQL, have you considered submitting that as an STU comment? This would be a great thing to get in front of the community and see whether there's support for the idea.

bdrillard, 2019-02-05:
Is there any word on confirming this issue? We'd like to upgrade to the latest version of the project, but this is a blocker for us. If the issue is confirmed, we'd wonder if either there's a fix just hiding in configuration somewhere, if there's a workaround, or if a fix would get slotted to a later release.

bdrillard, 2019-02-06:
Thanks @brynrhodes, that would be ideal!

rdingwell, 2019-02-28:
@brynrhodes finally found some time to get back to this, STU comment submitted.

brynrhodes, 2019-02-28:
@rdingwell, I don't see a comment for this on the STU page: http://www.hl7.org/dstucomments/showdetail.cfm?dstuid=233

I want to make sure it's captured, where did you submit the STU comment?

bdrillard, 2019-03-07:
I see the work done to resolve the initial reproducing test case:

```
library Query version '1'
using FHIR version '3.0.0'

include FHIRHelpers version '3.0.0' called FHIRHelpers

context Patient

define GetGender: Patient.gender = 'female'
```

which appears to have been to more parameterize the possible function arguments for equal/equivalent. Thanks for this.

It seems like this issue may apply to numerous operators. `SameAs` was an operator that previously could infer a `FHIR.dateTime` would need conversion to an appropriate System type, but this operator still fails after the changes to `equal`/`equivalent`.

bdrillard, 2019-03-07:
I see the work done to resolve the initial reproducing test case:

```
library Query version '1'
using FHIR version '3.0.0'

include FHIRHelpers version '3.0.0' called FHIRHelpers

context Patient

define GetGender: Patient.gender = 'female'
```

which appears to have been to more parameterize the possible function arguments for equal/equivalent. Thanks for this.

It seems like this issue may still apply to a few [clinical operators](https://github.com/cqframework/clinical_quality_language/blob/6ff4a1ba4683aa6dc71cee0228e836afc6777035/Src/java/cql-to-elm/src/main/java/org/cqframework/cql/cql2elm/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), e.g. `AgeInYearsAt`. Consider

```
library Query version '1'
using FHIR version '3.0.0'

include FHIRHelpers version '3.0.0' called FHIRHelpers

context Patient

define TestSameAs: AgeInYearsAt(Patient.deceased)
```

which yields

```
CompilerException clojure.lang.ExceptionInfo: Errors encountered while parsing the query:
startLine: 8
startChar: 20
endLine: 8
endChar: 49
message: Expected an expression of type 'choice<FHIR.boolean,FHIR.dateTime>', but found an expression of type 'System.Date'.
errorType: semantic
errorSeverity: error
```

brynrhodes, 2019-03-08:
@bdrillard, I think this is actually a different issue. The problem here is that the AgeInYearsAt function has two overloads (Date) and (DateTime), and because the actual ELM being called is CalculateAgeInYearsAt, the translator tries to use the type of the AgeInYearsAt argument to determine whether to call the "CalculateAgeInYearsAt(Date)" or "CalculateAgeInYearsAt(DateTime)". So to do that, it tries to force convert the Patient.birthDate to the type of the argument to the overload. So what's happening is the translator is trying to convert "Patient.birthDate" to a type of "Choice<FHIR.boolean, FHIR.dateTime>", and since there is no conversion path there, it fails (there is a path, but it requires two hops, and CQL does not support transitive implicit conversion). The reason it worked in the previous translator was that there was only a CalculateAgeInYearsAt(DateTime, DateTime) and so both arguments could be converted in one hop to DateTime. So to get this to work with the way this is defined, you have to say:

    AgeInYearsAt(FHIRHelpers.ToDateTime(Patient.deceased as FHIR.dateTime))

Which is not pretty, so I'm mulling this. Do you have any other examples that behave unexpectedly (and that don't involve the Age calculation functions)?

brynrhodes, 2019-03-08:
@bdrillard, just pushed a commit that adds the expected behavior for `AgeInYearsAt(Patient.deceased)`. It will now implicitly convert the Patient.deceased to a DateTime and then use the DateTime overload of `CalculateAgeInYearsAt`.

bdrillard, 2019-03-13:
I tested against a snapshot build, I can confirm both the issues discussed in this thread (application of implicit conversions, `AgeInYearsAt` FHIR dispatch) are fixed.

Thanks for the attention to them!

brynrhodes, 2019-04-19:
Adressed in [1.3.14](https://github.com/cqframework/clinical_quality_language/releases/tag/v1.3.14)

Closed 2019-04-19.

Thread 383 (2019-01-31):

Hinting of Resources and Fields

bdrillard, 2019-01-31:
A potentially powerful optimization would be having the CQL-to-ELM compiler hint resources and, more granularly, resource fields referenced by the CQL query. The benefit here would be to expose information supporting programmatic construction of data selection statements that would limit data pulled from the store to only those fields required.

Although this kind of static analysis would be possible in a backend implementation over the compiled ELM, I feel similar logic would be quite at home on the compiler frontend, where the resource & field information could be exposed towards the top of the ELM, somewhere just above the `statements` definition.

An optimization like this could be optional, turned on via a flag, like some of the other compiler optimizations. I feel like it could be greatly valuable when considering current implementations realistically have to pull in full, quite nested resources, where much of the data may not even be referenced by the query, but would still have an impact on the computational resources available in the query runtime (Claims data, for example).

I'm curious if devs here would welcome an optional optimization like this.

If so, there would be some design questions to discuss, e.g. how "deep" or "shallow" across nested structs the should field hinting be? If "deep", should hinting just be for chained `property` calls, or also included `index` calls? A first pass of an optimization like this may be "shallow" just for ease of implementation.

brynrhodes, 2019-01-31:
Hi @bdrillard, I think this would be a great addition, a sort of summary of the retrieves. It's also some of the same infrastructure that could enable this feature: #79, which would be very useful as well (though it would require some modeling support to identify mustSupport attributes in the first place).

brynrhodes, 2021-07-30:
Included in 1.5.4-SNAPSHOT (via the ElmDataRequirementsVisitor and the elm-fhir package)

Closed 2021-07-30.

Thread 384 (2019-02-06):

Support for Extensions & Contained Resources

bdrillard, 2019-02-06:
There are instances where we'd like to model relationships between certain FHIR resources using [Provenance](https://www.hl7.org/fhir/provenance.html) resources, for example, to indicate which Claim a Condition or Procedure may have originated from.

It can sometimes be the case that such resources are directly "[contained](https://www.hl7.org/fhir/references.html#contained)" within the referring FHIR Resource, e.g. a Procedure directly "contains" a Provenance resource that refers to a Claim.

The CQL spec has no specific discussion of Contained resources (we might not expect it to, since it's quite a FHIR-specific thing), but since all FHIR resources that inherit from [DomainResource](https://www.hl7.org/fhir/stu3/domainresource.html#DomainResource) have a `contained` field (which also exists in the [fhir-modelinfo](https://github.com/cqframework/clinical_quality_language/blob/v1.3.10/Src/java/quick/src/main/resources/org/hl7/fhir/fhir-modelinfo-3.0.0.xml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), using the current v1.3.10 CQL-to-ELM compiler, it should be possible to do something like

```
library Query version '1'
using FHIR version '3.0.0'
include FHIRHelpers version '3.0.0' called FHIRHelpers

context Patient

define GetProvenance: (First([Procedure]).contained) P where P is FHIR.Provenance return P as FHIR.Provenance
```

We'd expect `GetProvenance` to have a type List<FHIR.Provenance> given the return cast.

This query fails to compile, giving a type error:

```
Translation failed due to errors:
Error:[7:90, 7:114] Expression of type 'FHIR.ResourceContainer' cannot be cast as a value of type 'FHIR.Provenance'.
```

The CQL spec implies other forms of "down-cast" are viable in its section on [Casting](https://cql.hl7.org/03-developersguide.html#casting) (e.g. Procedure to ImageProcedure), so I'm not sure if this error in casting from FHIR.ResourceContainer to FHIR.Provenance is expected behavior or a bug.

I think similar questions would arise with how CQL handles FHIR Extensions, but I haven't dug into that as much.

brynrhodes, 2019-03-03:
Hi @bdrillard, looking at this it should be possible, but contained element is actually modeled in the FHIR XML Schema as a "ResourceContainer", which has elements for each of the possible resource types,
so that structure will be reflected directly in the FHIR ModelInfo:

https://github.com/cqframework/clinical_quality_language/blob/master/Src/java/quick/src/main/resources/org/hl7/fhir/fhir-modelinfo-3.0.0.xml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

So this should work to access the contained resources:

    define GetProvenance:
      (First([Procedure]).contained) C
        where C.Provenance is not null
        return C.Provenance

And yes, extensions work similarly, there is an extension element, based on the FHIR XML schema, so you can access those as well. We have used extensions successfully, but we have not yet tried accessing contained elements.

bdrillard, 2019-04-02:
Hi @brynrhodes, thanks for this guidance. Do you think you could tell me which version of the CQFramework project supports this access pattern?

brynrhodes, 2019-06-21:
Hi @bdrillard , apologies for the delay, I didn't see this question. I just verified that the proposed query I posted above works in the latest 1.3 translator against FHIR STU3. Are you seeing different behavior?

bdrillard, 2019-12-31:
I can verify this access pattern works for the latest translator you mention, @brynrhodes! Gonna close this question.

Closed 2019-12-31.

Thread 399 (2019-03-13):

FHIRHelpers and ToString for FHIR.code

bdrillard, 2019-03-13:
FHIRHelpers version 3.0.0 previously included a [`ToString`](https://github.com/cqframework/clinical_quality_language/blob/master/Src/java/quick/src/main/resources/org/hl7/fhir/FHIRHelpers-3.0.0.cql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) implementation for FHIR.code, which just extracted the code value of the Code as a String.

The latest [FHIRHelpers](https://github.com/cqframework/clinical_quality_language/blob/master/Src/java/quick/src/main/resources/org/hl7/fhir/FHIRHelpers-3.0.1.cql) for R3, 3.0.1, no longer includes that function, so

```
library Query version '1'
using FHIR version '3.0.1'
include FHIRHelpers version '3.0.1' called FHIRHelpers

context Patient

define Encounters: [Encounter] E where E.priority.coding[0].code = 'value'
```

will no longer infer the use of ToString against the code. The original behavior can be achieved via

```
library Query version '1'
using FHIR version '3.0.1'
include FHIRHelpers version '3.0.1' called FHIRHelpers

context Patient

[Encounter] E where E.priority.coding[0].code.value = 'value'
```

I suppose I'm wondering what the rationale was for removing `ToString`, because it is _useful_, but the uplift isn't all that challenging. I can understand extracting just the code, without the system, to compare against an arbitrary string, could be considered semantically odd behavior. Although, arguably we do something like that when we apply `ToString` against types like FHIR AdministrativeGender that appear as codes in the HL7 doc, but are slightly different (enumerations vs. codes). We can do a comparison like,

```
Patient.gender = 'Female'
```

and `ToString` will be dispatched against the enum type.

The one thing I do want to note is that the current behavior does have one surprising aspect, i.e. both the code and the String being compared against now get promoted to lists for the equals comparison via the `ToList` operator:

```
      <def name="Encounters" context="Patient" accessLevel="Public">
         <resultTypeSpecifier xsi:type="ListTypeSpecifier">
            <elementType name="fhir:Encounter" xsi:type="NamedTypeSpecifier"/>
         </resultTypeSpecifier>
         <expression xsi:type="Query">
            <resultTypeSpecifier xsi:type="ListTypeSpecifier">
               <elementType name="fhir:Encounter" xsi:type="NamedTypeSpecifier"/>
            </resultTypeSpecifier>
            <source alias="E">
               <resultTypeSpecifier xsi:type="ListTypeSpecifier">
                  <elementType name="fhir:Encounter" xsi:type="NamedTypeSpecifier"/>
               </resultTypeSpecifier>
               <expression dataType="fhir:Encounter" xsi:type="Retrieve">
                  <resultTypeSpecifier xsi:type="ListTypeSpecifier">
                     <elementType name="fhir:Encounter" xsi:type="NamedTypeSpecifier"/>
                  </resultTypeSpecifier>
               </expression>
            </source>
            <where resultTypeName="t:Boolean" xsi:type="Equal">
               <operand xsi:type="ToList">
                  <operand resultTypeName="fhir:code" path="code" xsi:type="Property">
                     <source resultTypeName="fhir:Coding" xsi:type="Indexer">
                        <operand path="coding" xsi:type="Property">
                           <resultTypeSpecifier xsi:type="ListTypeSpecifier">
                              <elementType name="fhir:Coding" xsi:type="NamedTypeSpecifier"/>
                           </resultTypeSpecifier>
                           <source resultTypeName="fhir:CodeableConcept" path="priority" scope="E" xsi:type="Property"/>
                        </operand>
                        <operand resultTypeName="t:Integer" valueType="t:Integer" value="0" xsi:type="Literal"/>
                     </source>
                  </operand>
               </operand>
               <operand xsi:type="ToList">
                  <operand resultTypeName="t:String" valueType="t:String" value="value" xsi:type="Literal"/>
               </operand>
            </where>
         </expression>
      </def>
```

Is this expected behavior?

brynrhodes, 2019-03-28:
Thank you for the detailed report and reproduction, this is definitely an oversight in the 3.0.1 model. We are working on a new toolchain to produce modelinfo from FHIR Profiles and the only difference between 3.0.0 and 3.0.1 is the toolchain that was used to produce it. It looks like all the FHIRHelpers for string-valued FHIR Primitives were missed, so I've added them in here, and that should address the issue.

As far as the list promotion behavior, that is an undesirable byproduct of the list promotion behavior, since it can't find a way to do the equality comparison directly, the translator is looking to see if it can find a signature by promoting the arguments to lists, and it ends up finding list equality. There is a disableListPromotion flag to disable that behavior, and the QDM-based artifact authors typically run with that setting.

brynrhodes, 2019-04-19:
Adressed in [1.3.14](https://github.com/cqframework/clinical_quality_language/releases/tag/v1.3.14)

Closed 2019-04-19.

Thread 400 (2019-03-14):

FHIR Code & Concept Conversion Ambiguity

bdrillard, 2019-03-14:
[`InValueSet`](https://github.com/cqframework/clinical_quality_language/blob/master/Src/cql-lm/schema/elm/clinicalexpression.xsd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) is defined as checking code membership against a specified ValueSet. Although the function is only documented for `Code` types, it appears to have worked for `Concept` types as well in previous versions of the CQL-to-ELM project. Consider

```
library Query version '1'

using FHIR version '3.0.1'
include FHIRHelpers version '3.0.1' called FHIRHelpers

valueset "OurValueSet": '0.0.0.0.0.0.0.0.0.0'

context Patient

define TestInValueSet: [Observation] O where O.code in "OurValueSet"
```

which currently fails to compile with,

```
startLine: 10
startChar: 44
endLine: 10
endChar: 66
message: Ambiguous implicit conversion from FHIR.CodeableConcept to System.Concept or System.Concept.
errorType: semantic
errorSeverity: error

startLine: 10
startChar: 38
endLine: 10
endChar: 66
message: Expected an expression of type 'System.Boolean', but found an expression of type '<unknown>'.
errorType: semantic
errorSeverity: error
```

It appears the usage of a `FHIRHelpers.ToConcept` fails to be inferred. The code successfully compiles if the FHIRHelper function is applied directly, i.e.

```
define TestInValueSet: [Observation] O where FHIRHelpers.ToConcept(O.code) in "OurValueSet"
```

1. Should the documentation for `InValueSet` be amended to indicate the function is overloaded for the `Concept` type as well as `Code`? That might be its own sort of action item here.
2. Is this a new bug in implicit applications of FHIRHelpers functions?

brynrhodes, 2019-03-28:
Thank you for the detailed report! This issue is caused by an incorrect additional implicit conversion declaration in the 3.0.1 model info. I've addressed this in the same push for #399.

As far as the documentation question, yes, that should definitely be clarified, and I will submit a ballot comment on 1.4 to correct it.

brynrhodes, 2019-04-19:
Adressed in [1.3.14](https://github.com/cqframework/clinical_quality_language/releases/tag/v1.3.14)

Closed 2019-04-19.

Thread 1069 (2019-04-04):

Contained resources support

c-schuler, 2019-04-04:
Currently the engine does not support contained resources:

For example, the following snippet
```
define GetProvenance:
  (First([Condition]).contained) C
    where C.Provenance is not null
    return C.Provenance
```
results in the error "Unable to resolve path Provenance for Provenance"

The issue is that HAPI, for some reason, does not support the ResourceContainer type as specified in the FHIR 3.0.0 modelinfo. Therefore, the contained resources are returned as a List<Resource>. The task here is to find a  workaround in order to support contained resources.

Closed 2019-07-09.

Thread 1063 (2019-05-16):

JpaDataProvider should be able to handle the case where it is passed a string rather than a code

okeefm, 2019-05-16:
In the VTE-1 measure on cqf-ruler, the `EncounterDiagnosis` function in `MatGlobalCommonFunctions` returns an array of `String`s that are IDs of `Condition` elements from the `diagnosis` field on a given `Encounter`. When these are passed to the `JpaDataProvider` for retrieval, it treats them as an array of `Code` objects instead, and the server throws a `java.lang.ClassCastException` because it is unable to automatically convert a `String` to a `Code`. Bryn said that this case would need to be accommodated in cqf-ruler/cql_engine, and asked me to post a ticket here.

Full stacktrace is attached to the issue below.
[cqfr_error_2.txt](https://github.com/DBCG/cql_engine/files/3186651/cqfr_error_2.txt)

Closed 2019-07-09.

Thread 423 (2019-05-20):

Issues with current QDM 5.5 Model Info

JSRankins, 2019-05-20:
A review of the QDM 5.5 Model Info file against the recently published QDM 5.5 reveals a number of issues. Please see below.

- In QDM 5.5, relevant period was removed for Adverse Event, but it is still in the model info file.

- The model info file establishes a base Entity type that it uses as the foundation for all entities - patient, care partner, practitioner and organization. This base Entity type contains two attributes - id and identifier.

    <ns4:typeInfo xsi:type="ns4:ClassInfo" name="QDM.Entity" baseType="System.Any" retrievable="false">
        <ns4:element name="id" type="System.String"/>
        <ns4:element name="identifier" type="QDM.Identifier"/>
    </ns4:typeInfo>

QDM does not mention the id attribute for the entity types - just identifier. Other than the types used for these attributes in the model info file (String for id and Identifier for identifier), it is not clear what the semantic difference is between id and identifier. Is having the extra id attribute available for all entity attributes by design, or is this a bug? If it is by design, can clarification be provided on how these are supposed to be used, since QDM does not mention Entity.id?

- In the QDM 5.4 Model Info File, id in the QDMBaseType was typed to QDM.Id. QDM.Id allowed for namingSystem and value attributes. The QDM 5.5 Model Info File updated the QDM.Id type to QDM.Identifier. However, instead of pointing to this modified name, the QDM 5.5 Model Info File now types id to a String, which does not allow for the level of specificity that QDM.Id used to. Is there a reason for the change?

- The patientId attribute in the QDMBaseType is not listed in QDM. Based on e-mails a couple years ago with ESAC and MITRE, the patientId attribute was being used for Health Record Field. The Health Record Field has been removed with QDM 5.5. Is there a reason for keeping this attribute? If it remains, is there a reason its type was changed from QDM.Id to String?

- Entity attributes are using a choice type that includes the Patient datatype. We believe this should be the PatientEntity datatype instead. As is, any entity attribute can use birthDatetime. For example, the following runs successfully against the translator:

`define "X":
	["Adverse Event"] AE
		where AE.recorder is Patient
			and AE.recorder.birthDatetime > @2012-01-02`

- For "Assessment, Performed": In the QDM 5.4 Model Info File, relatedTo was typed to List<QDM.Id>. QDM.Id allowed for namingSystem and value. The QDM 5.5 Model Info File updated the QDM.Id type to QDM.Identifier. However, instead of pointing to this modified name, the QDM 5.5 Model Info File now types relatedTo to a List<String>, which does not allow for the level of specificity that QDM.Id used to. Is there a reason for the change?

- The Model Info File is using "recorder" instead of "requester" for "Assessment, Order". Per QDM, it should be "requester".

- For "Care Goal" - In the QDM 5.4 Model Info File, relatedTo was typed to List<QDM.Id>. QDM.Id allowed for namingSystem and value. The QDM 5.5 Model Info File updated the QDM.Id type to QDM.Identifier. However, instead of pointing to this modified name, the QDM 5.5 Model Info File now types relatedTo to a List<String>, which does not allow for the level of specificity that QDM.Id used to. Is there a reason for the change?

- Sections 3.6, 4.1.5 (Care Goal Datatype table) and 4.2 (Table 25) in QDM list the attribute "status date" for "Care Goal". However, section B.1 has the attribute listed as "status datetime". Which is correct? If it should be "status date", then the Model Info File needs to be updated.

- For "Care Goal" - Sections 2.4.1, 4.1.5 (Care Goal Datatype table) and 4.2 (Table 25) in QDM list the attribute "performer" for "Care Goal". However, there is a parentheical comment in  Table 25 for Care Goal - "ExpressedBy". The Model Info File has the attribute as expressedBy. Which is correct? If it should be "performer", then the Model Info File needs to be updated.

- For "Communication Performed" - In the QDM 5.4 Model Info File, relatedTo was typed to List<QDM.Id>. QDM.Id allowed for namingSystem and value. The QDM 5.5 Model Info File updated the QDM.Id type to QDM.Identifier. However, instead of pointing to this modified name, the QDM 5.5 Model Info File now types relatedTo to a List<String>, which does not allow for the level of specificity that QDM.Id used to. Is there a reason for the change?

- QDM 5.5 added a participant attribute for "Encounter, Performed". This attribute is missing in the Model Info File.

- QDM has "relationships" as an attribute for "Family History". The Model Info File has this attribute as "relationship" (i.e., singular, not plural). Which is correct?

- The Model Info File has "relevantPeriod" and "relevantDatetime" for "Immunization, Administered". QDM only lists "relevantDatetime". Which is correct?

- The Model Info File has "prescriberId" for "Medication, Order". The "prescriberId" attribute was removed with QDM 5.5 with the addition of "prescriber".

- The Model Info File has "relevantDatetime" for "Medication, Order". The "relevantPeriod" attribute does not exist in QDM for this datatype in the "Medication, Order" datatype table (pg. 42), but section 3.1 (pg. 18), table 2 (pg. 21) and the attribute table (pg. 70) list this attribute for this datatype . Which is correct?

- The relationship attribute needs to be added for Related Person in QDM 5.5 Model Info File.

- QDM 5.5 states that code is allowed for all datatypes except 'Related Person'. The QDM 5.5 Model Info File allows for code to provided for Related Person.

- The Model Info File has an "identifier" attribute for the new "Related Person" datatype, as well as and id attribute. QDM lists two attributes for this datatype in the "Related Person" datatype table (pg. 50): id and relationship. However, since "Related Person" is supposed to be the equivalent of the carePartner entity, which has an identifier attribute, we are wondering what is correct. If "Related Person" should have both the id and identifier attributes, it is not clear what the difference is between these two attributes. Please clarify.

- QDM 5.5 added a relevantPeriod attribute for "Substance, Order". This attribute is missing in the Model Info File.

- Entity.id is not mentioned in QDM. Identifier is. Is there a reason for having the Entity.id attribute in addition to the identifier attribute?

FEisenberg, 2019-05-21:
From a QDM perspective, I'd like to hear feedback from Bryn. We can discuss on the Friday CQL-based HQMF call but that is 3 days away.

- Entity.id - correct that QDM does not specify it - if needed, it is an easy "fix" in errata documentation but need to know if it needs QDM documentation or just assumptions for the model info.

- Immunization, Administered only has Relevant dateTime (not Relevant Period) as actual times -this is intentional to stay aligned with FHIR Immunization

- QDM Family History assumed that only 1 relationship is relevant for each instance - based on discussions

- Medication, Order includes author dateTime for the time the order is written, and Relevant Period to address the time period when the order is to FHIR MedicationRequest validity period - i.e., the time period the order is authorized to be dispensed. Section 3.1 (page 18) includes Relevant Period as applied to Medication, Order as does the attribute table (page 80) - but the Medication, Order section specifically defines it as noted. Thus, Relevant dateTime does not exist for Medication, Order - only Relevant Period and that refers to the validity period as expressed in FHIR Resources. Hopefully that helps.  In the QDM document, the specific QDM datatype defines how each Relevant Period is to be specified for that QDM datatype.

- For QDM 5.5 Related Person the lack of "identifier" was not intentional and it is more of an errata if it is needed. It should be modeled the same as Care Partner.  We need to discuss how to do that from the QDM publication perspective.

I think that addresses the specific QDM questions but I look forward to further discussion.

brynrhodes, 2019-05-27:
Thank you for the detailed review, very much appreciated. I have addressed the issues as follows:

* Removed relevantPeriod from AdverseEvent

* The id attribute of the Entity base type is meant to serve the same purpose as the id attribute in the QDM base type, it provides an instance id, whereas the identifier attribute is a logical (or business) identifier. Instance ids are used by the underlying systems to represent the unique, system-specific identifier for an item, and as such don't need the naming system. Whereas business identifiers can potentially contain external identifiers and so need a naming system to establish the authority for the identifier. For cases where entities are used to capture information that is completely dependent, there will not be an instance identifier, since the entity only has meaning in the context of the containing instance. But for cases where entities are capturing a reference to another underlying instance (CarePartner or Practitioner, for example), the id is used to represent the system id for the item.

* The change from QDM.Id to QDM.Identifier solidifies the design pattern of using Id for instance identity, and Identifier for business identifiers (that can be both internal and external).

* The patientId attribute in the QDMBaseType establishes the patient context for all data types. It is necessary in the implementation to allow the underlying data to represent the relationships between the QDM data elements and the patient instance. Especially with the addition of related-context retrieve, being able to represent the patient for which this data is applicable is critical.

* Fixed all Entity choices that referenced Patient to reference PatientEntity

* The change to "Assessment, Performed".relatedTo from List<QDM.Id> to List<String> is recognizing that the relationship is represented using instance ids, not business identifiers.

* Changed "Assessment, "Order".recorder to requester

* The change to "Care Goal".relatedTo from List<QDM.Id> to List<String> is recognizing that the relationship is represented using instance ids, not business identifiers.

* "Care Goal".statusDatetime, I would suggest statusDatetime is the more useful, since it can capture both Datetime and Date, but defer to @FEisenberg for the correct attribute name.

* "Care Goal".expressedBy, I defer to @FEisenberg for the correct attribute name.

* The change to "Communication, Performed".relatedTo from List<QDM.Id> to List<String> is recognizing that the relationship is represented using instance ids, not business identifiers.

* Added participant entity attribute to "Encounter, Performed"

* "Family History", I used the name from the Attributes table (singular), and recommend singular because the cardinality is 0..1, but defer to @FEisenberg for the correct attribute name.

* Corrected Immunization, Administered to only list relevantDatetime

* Removed prescriberId from Medication, Order

* Removed relevantDatetime from Medication, Order

* RelatedPerson already has a code attribute, by virtue of being a QDM data type, and so we should use that for the "relationship", consistent with the use of code to establish types. @FEisenberg , this would need an errata in QDM.

* The id attribute in CarePartner and RelatedPerson establishes instance identity, whereas the identifier attribute is a logical, or business identifier.

* Added relevantPeriod to Substance, Order

* Entity.id serves the same purpose as QDMBaseType.id, providing an internal instance identity. In cases where the entity "maps" to a data type, the instance identities would be the same.

brynrhodes, 2019-06-21:
Included in 1.4.2-SNAPSHOT

Closed 2019-10-29.

Thread 424 (2019-06-05):

DefaultLibrarySourceLoader throws an exception when multiple instances of a library are found

JPercival, 2019-06-05:
Here's the relevant code:

https://github.com/cqframework/clinical_quality_language/blob/master/Src/java/cql-to-elm/src/main/java/org/cqframework/cql/cql2elm/DefaultLibrarySourceLoader.java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

I think the ideal behavior is that the SourceLoader returns either the first (or closest in the case of versions) match based on the order the SourceProviders are registered. This would enable scenarios where you prioritize loading a library from a local cache, and fall back to a remote server if needed.

JPercival, 2019-08-14:
Resolved by #430

Closed 2019-08-14.

Thread 1056 (2019-06-20):

Improve Engine Error Reporting

c-schuler, 2019-06-20:
Suggest enhancement to current evaluate interface to implement the following:

- Custom CQL-specific Exceptions for common scenarios implemented in evaluators
- Catch-all in base evaluate method
  - Transform to CQL-specific Exceptions with as much additional information as possible

Closed 2019-07-09.

Thread 434 (2019-06-20):

Issue with using end of in an interval operator phrase in 1.4.5-SNAPSHOT

jackcmeyer, 2019-06-20:
using the following CQL:

```
define "test":
  ["Encounter, Performed"] e
    where e.relevantPeriod 3 years or less before
    end of "Measurement Period"
```

I am receiving the error: `Error:[17:9, 17:10] Could not resolve identifier of in the current library.`.

This statement has successfully translated in prior versions of the translator.

It appears that the parser is not recognizing the time boundary operator on the right hand side of the interval operator phrase expression. Here is the parse tree:

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

brynrhodes, 2019-06-21:
Confirmed the issue, working on a root cause now.

Closed 2019-06-21.

Thread 1046 (2019-08-07):

From filter with 3 lists cannot resolve reference to the 3rd item

jscherer-motivemi, 2019-08-07:

Closed 2019-08-13.

Thread 449 (2019-08-21):

Namespace - Missing Library identifier.system

JSRankins, 2019-08-21:
CQL R1 STU4 added namespace capability. Based on a read of CQL, it appears that the library identifier in the ELM XML and JSON should have a property named system that is the URI for the namespace. For reference, see the [RelatedContextRetrieve ](http://build.fhir.org/ig/HL7/cql/examples/Example.RelatedContextRetrieve-0.1.0.xml) library example in CQL that uses an Example namespace. The identifier for the library in the ELM XML file has the following:

`
<identifier id="Example.RelatedContextRetrieve" system="http://example.org/measures" version="0.1.0"/>
`

In fact, volume 2 of CQL-based HQMF IG R1 STU4 provides the following:

> This example declares a library named Common in the CMS namespace. Per the CQL specification, the namespace for a library is included in the ELM, along with a URI that provides a globally unique, stable identifier for the namespace. For example, the URI for the CMS namespace would be https://ecqi.healthit.gov/ecqm/measures

However, when using the CQL-to-ELM Translator to transform a library containing a namespace, the system property is not provided in the ELM XML and JSON output. For example:

**CMS.Common.1.0.000.cql**

`library CMS.Common version ‘1.0.000’ ...`

**ELM XML CMS.Common.1.0.000.xml**

`
<library>
   <identifier id="CMS.Common" version="1.0.000"/>
    ...
</library>
`      

**ELM JSON CMS.Common.1.0.000.json**

      "identifier" : {
         "id" : "CMS.Common",
         "version": "1.0.000"
      }

In addition, there does not appear to be a way to provide the respective URI for the respective namespace.

Am I missing something?

brynrhodes, 2019-10-29:
Because the namespace is broader than a library, CQL does not provide a namespace declaration. The translator needs the namespace uri to be provided as a parameter.

brynrhodes, 2020-06-21:
Addressed in 1.4.9 release

lscott15, 2020-08-03:
> Because the namespace is broader than a library, CQL does not provide a namespace declaration. The translator needs the namespace uri to be provided as a parameter.

I feel like I'm missing something, how would I actually specify a namespace in practice? It sounds like it's a parameter to the cql>elm translation but I don't see it as one of the parameters to the CLI client or as a setting in the Atom plugin.

brynrhodes, 2020-08-04:
You're right, there is no command-line parameter for setting the namespace information, but it is a parameter to the translator component. If you need it exposed on the command-line, feel free to submit an issue request.

As of today, the only way to set the namespace is through the FHIR IG publisher, using the Adjunct Binary File loader and CQL processing: https://confluence.hl7.org/pages/viewpage.action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

Within a FHIR IG, the `packageId` of the IG is the namespaceName, and the `canonicalBaseUrl` of the IG is the namespaceUri. See the [sample-ig](https://github.com/FHIR/sample-ig/blob/master/input/cql/example.cql) and [sample-content-ig](https://github.com/cqframework/sample-content-ig/blob/master/input/cql/DependencyExample.cql) for an example of referencing a CQL Library from a dependent IG.

We are currently working to expose this same capability to the Atom plugin, see CQF-Tooling issue [101](https://github.com/cqframework/cqf-tooling/issues/101).

Closed 2020-06-21.

Thread 450 (2019-08-28):

CQL-to-ELM Translator 1.4.6 - Internal Translator Error

JSRankins, 2019-08-28:
When provided the attached libraries, the CQL-to-ELM Translator results in, among other errors, an internal translator error that has no locator:

Error:[n/a] Internal translator error.

This makes it difficult for a tool using the Translator to provide users feedback on where the applicable error occurs.

Is this an error in the translator, or was it intended by design?

Note: We had to attach the files as .txt files, since github does not support the attachment of .cql files.

[NCQA_Common-5.0.000.txt](https://github.com/cqframework/clinical_quality_language/files/3552721/NCQA_Common-5.0.000.txt)
[DMS_HEDIS_2020-3.0.002.txt](https://github.com/cqframework/clinical_quality_language/files/3552722/DMS_HEDIS_2020-3.0.002.txt)

brynrhodes, 2019-09-03:
Thank you for the reproduction, I was able to easily reproduce the problem.

The root cause is that the library being included is declared to use QDM version 5.4, but the main library is declared to use QDM version 5.5. When the included library is translated, it errors (correctly) when trying to load QDM 5.4 because 5.5 is already in use. However, because the error is encountered while loading the data model, the Patient context creation logic doesn't complete, leaving a partially constructed Patient expression. This partial Patient context results in an internal NullPointerException when the Patient context is referenced later in the included library. An internal error like that would normally be tagged with the location in the source code causing the error, but because the Patient expression isn't complete, the translator doesn't have a link to the parse tree to obtain that information.

I have a fix ready to apply, and will discuss with the impacted teams the best approach to getting the fix applied to the repository.

brynrhodes, 2020-01-24:
Addressed in 1.3.19-SNAPSHOT and 1.4.8-SNAPSHOT

Closed 2020-01-24.

Thread 458 (2019-10-29):

Apply ambiguous implicit conversion fix for FHIR R4 to 1.4

brynrhodes, 2019-10-29:
The following library:

```
library Query version '1'
using FHIR version '4.0.0'
include FHIRHelpers version '4.0.0' called FHIRHelpers

context Patient

define TestMedicationOrders:
  ["MedicationRequest"] M
	  where M.doNotPerform is true
```

Produces the error "Ambiguous implicit conversion between System.Boolean and System.Boolean"

This issue is to apply the fix for #445 to the 1.4 release

Closed 2020-01-23.

Thread 1017 (2019-11-21):

Unable to resolve Code in a different library

sliver007, 2019-11-21:
A retrieve with a where clause that references a Code in another library fails with "Could not resolve code reference 'blah'"

Attached file is a .json file (change the extension from .zip to .json to use it) - .json was not a supported file type here.

[resolvecoderepro_bundle.zip](https://github.com/DBCG/cql_engine/files/3877204/resolvecoderepro_bundle.zip)

Closed 2020-02-03.

Thread 468 (2020-01-22):

Bug/Inconsistent behavior in handling Retrieve statements when using FHIR

rdingwell, 2020-01-22:
There is an inconsistent behavior in translating CQL to ELM when using FHIR.   Take the following setup for a library that defines codes and concepts that will be used in retrieve statements for filtering.

```
library mCODE version '1'

using FHIR version '4.0.0'
include FHIRHelpers version '4.0.0' called FHIRHelpers

codesystem "LOINC": 'http://loinc.org'

code "ECOG performance code": '89262-0' from "LOINC" display 'ECOG Performance Status [Interpretation]
code "Karnofsky performance code": '89245-5' from "LOINC" display 'Karnofsky Performance Status [Interpretation]

concept "ECOG performance score" : { "ECOG performance code"}
concept "Karnofsky performance score" : { "Karnofsky performance code"}
```

Depending on how the codes and concepts are used within retrieve statements in the library will produce different elm outputs.

First consider the case that the library only contains definitions that use the codes and not the concepts that wrap them such as the following:

```
define "ECOG Performance":
    [Observation:  "ECOG performance code"]

define "Karnofsky Performance":
    [Observation: "Karnofsky performance code"]
```

The resulting translation for each of theses is the following:

 ```
{
            "name" : "ECOG Performance",
            "context" : "Patient",
            "accessLevel" : "Public",
            "expression" : {
               "dataType" : "{http://hl7.org/fhir}Observation",
               "codeProperty" : "code",
               "type" : "Retrieve",
               "codes" : {
                  "type" : "ToList",
                  "operand" : {
                     "name" : "ECOG performance code",
                     "type" : "CodeRef"
                  }
               }
            }
         }, {
            "name" : "Karnofsky Performance",
            "context" : "Patient",
            "accessLevel" : "Public",
            "expression" : {
               "dataType" : "{http://hl7.org/fhir}Observation",
               "codeProperty" : "code",
               "type" : "Retrieve",
               "codes" : {
                  "type" : "ToList",
                  "operand" : {
                     "name" : "Karnofsky performance code",
                     "type" : "CodeRef"
                  }
               }
            }
         }
```
This will produce a result with warnings contained within the annotations stating that "Could not resolve membership operator for terminology target of the retrieve."  There is an annotation warning for each of the statements but there is also an elm expression for each as obvious from the output.

If the statements are defined as follows with the first retrieve using a code and the second using a concept

```
define "ECOG Performance":
    [Observation:  "ECOG performance code"]

define "Karnofsky Performance":
    [Observation: "Karnofsky performance score"]
```
This results in the following elm.

```
{
            "name" : "ECOG Performance",
            "context" : "Patient",
            "accessLevel" : "Public",
            "expression" : {
               "dataType" : "{http://hl7.org/fhir}Observation",
               "codeProperty" : "code",
               "type" : "Retrieve",
               "codes" : {
                  "type" : "ToList",
                  "operand" : {
                     "name" : "ECOG performance code",
                     "type" : "CodeRef"
                  }
               }
            }
         }, {
            "name" : "Karnofsky Performance",
            "context" : "Patient",
            "accessLevel" : "Public",
            "expression" : {
               "dataType" : "{http://hl7.org/fhir}Observation",
               "codeProperty" : "code",
               "type" : "Retrieve",
               "codes" : {
                  "type" : "ToList",
                  "operand" : {
                     "name" : "Karnofsky performance score",
                     "type" : "ConceptRef"
                  }
               }
            }
         }
```
In this case there is a single warning as described above for the first statement that is still using the code for filtering in the retrieve.  So concept seems to work here as a replacement for code to work around warnings.

However, if you write the same statements as follows, with the concept filtering first and the code filtering after that things get a bit odd.

```
define "ECOG Performance":
    [Observation:  "ECOG performance score"]

define "Karnofsky Performance":
    [Observation: "Karnofsky performance code"]

```

This results in the following elm.
```
{
            "name" : "ECOG Performance",
            "context" : "Patient",
            "accessLevel" : "Public",
            "expression" : {
               "dataType" : "{http://hl7.org/fhir}Observation",
               "codeProperty" : "code",
               "type" : "Retrieve",
               "codes" : {
                  "type" : "ToList",
                  "operand" : {
                     "name" : "ECOG performance score",
                     "type" : "ConceptRef"
                  }
               }
            }
         }, {
            "name" : "Karnofsky Performance",
            "context" : "Patient",
            "accessLevel" : "Public",
            "expression" : {
               "dataType" : "{http://hl7.org/fhir}Observation",
               "codeProperty" : "code",
               "type" : "Retrieve",
               "codes" : {
                  "type" : "ToList",
                  "operand" : {
                     "type" : "ToConcept",
                     "operand" : {
                        "name" : "Karnofsky performance code",
                        "type" : "CodeRef"
                     }
                  }
               }
            }
         }
```

The first thing to note is that there are no annotation warnings in this case.  You can also notice that the code filtering retrieve is now converted differently, there is a ToConcept type conversion for the CodeRef contained in this example that is not included in the previous examples.

This will also effect all code base filtering in retrieves that happen after the first concept based filtering in a retrieve.  The basic situation appears that using codes in a retrieve will cause warnings for all statements before using a concept in a retrieve and thereafter will not produce warnings and will have a different elm conversion.

So if we had the following statements:

```
define "ECOG1":
    [Observation:  "ECOG performance code"]

define "ECOG2":
    [Observation:  "ECOG performance code"]

define "ECOG3":
    [Observation:  "ECOG performance score"]

define "ECOG4":
    [Observation:  "ECOG performance code"]

define "ECOG5":
    [Observation:  "ECOG performance code"]

```

In this case ECOG1 and ECOG2 would produce warnings and not contain the ToConcept conversion.   The statements ECOG4 and ECOG5 that appear after the concept filtering in ECOG3 will not produce warnings and will contain the ToConcept conversion.

This also raises the question about the validity of the elm that is produced if concepts are not used.  Will the resulting elm that does not contain the ToConcept conversion execute as intended.  I understand that there are warnings associated with the conversion but it does still produce elm that can be executed. Whether the result is as expected is another question.

brynrhodes, 2020-01-28:
@rdingwell , thank you for the detailed reproduction, it looks like the use of the concept is instantiating a conversion that is then available (because it's cached) for use when referencing the code. The behavior is definitely inconsistent and unexpected, I will track down why the use of code doesn't work to instantiate the conversion.

brynrhodes, 2020-03-25:
Addressed in 1.4.9-SNAPSHOT

rdingwell, 2020-06-05:
Hey @brynrhodes , will you be doing a formal 1.4.9 release sometime soon, it is still in SNAPSHOT?

brynrhodes, 2020-06-05:
Yes, it is still a snapshot, we are working towards a release, We are trying to address all the critical outstanding issues, and there are a few more to address. Can you give me a sense for the urgency of having a release?

brynrhodes, 2020-06-21:
Addressed in 1.4.9 release

Closed 2020-06-21.

Thread 486 (2020-03-13):

CQL-to-ELM date range optimization doesn't work for Choice Types nor Dates

ntlanglois, 2020-03-13:
The CQL-to-ELM date range optimization works for Period type, but only if it's not a Choice Type.  It doesn't work for Date type, seemingly except for a strange workaround of introducing an additional CQL define expression occurring prior to the target CQL define expression where both expressions use the same FHIR Resource.  I'm not sure if these issues are overlapping or distinct, but I'm open to splitting into 2 issues if needed.

For context, I am setting the date range optimization option, and it is currently working (returning dateRange and dateProperty) for examples where I use non-ChoiceType Period (e.g. [Encounter.period](https://www.hl7.org/fhir/STU3/encounter-definitions.html#Encounter.period)).  I have not applied the enable interval promotion option, but have tried a few times and saw no difference to these issues.

Example CQL demonstrating issue:
```
library Query version '1'

using FHIR version '3.0.0'

include FHIRHelpers version '3.0.0' called FHIRHelpers

parameter MeasurementPeriod default Interval[DateTime(2014, 1, 1, 0, 0, 0), DateTime(2014, 12, 31, 23, 59, 59))

context Patient

define DateCondition: [Condition] C where C.assertedDate during MeasurementPeriod
define ChoiceTypePeriodCondition: [Condition] C where C.onset as FHIR.Period during MeasurementPeriod
```

Returned ELM contains neither dateRange nor dateProperty, and this remains true even when I remove either one of the defines.

When I simply switch the order of the defines (ChoiceTypePeriodCondition 1st, then DateCondition 2nd), then the returned ELM contains dateRange and dateProperty, but only for DateCondition.

I expected the original example to produce ELM with 2 dateRange and 2 dateProperty occurrences; 1 for each define.  I also expected that each define would produce its corresponding dateRange and dateProperty in the ELM regardless of the presence of other defines.

Thanks for reading, and please let me know if additional information is needed.

brynrhodes, 2020-03-17:
@ntlanglois , thank you for the detailed report, it's likely that the date range optimization logic isn't correctly accounting for the choice type case, we'll take a look and get this addressed.

brynrhodes, 2020-03-25:
Addressed in 1.4.9-SNAPSHOT

brynrhodes, 2020-06-21:
Addressed in 1.4.9 release

Closed 2020-06-21.

Thread 1102 (2020-03-15):

Detect and prevent duplicate release versions

brynrhodes, 2020-03-15:
In the event the PR into master would produce a duplicate of a released version, it's not yet caught at the PR stage. I think I can add a check for "no release of the same version" into the enforcer plugin.

Thread 505 (2020-04-14):

FHIRHelpers doesn't show up in the correct namespace

brynrhodes, 2020-04-14:
The FHIRHelpers library should be implicitly defined in the FHIR namespace, not the current namespace: FHIR: http://hl7.org/fhir

brynrhodes, 2020-06-21:
Addressed in 1.4.9 release

Closed 2020-06-21.

Thread 515 (2020-04-21):

Default library source provide incorrectly resolves similarly named libraries

brynrhodes, 2020-04-21:
With libraries named:
* `Common.cql`
* `CommonConfig.cql`

The DefaultLibrarySourceProvider will incorrectly resolve CommonConfig when a reference to Common is provided, due to the way the filter looks for libraries.

brynrhodes, 2020-06-21:
Addressed in 1.4.9 release

Closed 2020-06-21.

Thread 522 (2020-04-23):

Additional regression testing on JSON/JXSON serialization differences

brynrhodes, 2020-04-23:
The JXSON format type was introduced to support using Jackson to serialize JSON ELM. A different format is being used to ensure backwards compatibility. This issue is to track that the JXSON format should be regression tested with the JSON format to verify complete backwards compatibility, and then the JSON format deprecated.

Thread 524 (2020-05-06):

Human readable generation issue in cql-to-elm v1.4.6

adongare, 2020-05-06:
Hello,

We are using cql-to-elm v1.4.6 in Measure Authoring Tool. We are facing an issue where one of the cql definitions is missing from Human Readable(measure name is `Elective Delivery` CMS113). Because of some reason cql-to-elm translator thinks that the definition is not being used however the definition is used in denominator. CQL definitions:
```
define "Denominator":
  "Delivery Encounter Near Term"

define "Delivery Encounter Near Term":
  "Delivery Encounter With Calculated Gestational Age"
    union "Delivery Encounter With Estimated Gestational Age Assessment"
```
The missing definition from Human Readable is` Delivery Encounter With Calculated Gestational Age`

To filter out all the used definitions, we use following code:

```
// prepare cqlFilter
MATCQLFilter cqlFilter = new MATCQLFilter(parentLibraryString, childrenLibraries , parentExpressions, translator, translatedLibraries);
// call filter
cqlFilter.filter();
// get used definitions
cqlFilter.getUsedDefinitions() // "Delivery Encounter With Calculated Gestational Age" not being returned in list
```
When I change denominator to use this definition directly as:
```
define "Denominator":
  "Delivery Encounter With Calculated Gestational Age"
    union "Delivery Encounter With Estimated Gestational Age Assessment"
```

`cqlFilter.getUsedDefinitions()` returns the definition correctly.

Original ticket that was created by our user is: https://oncprojectracking.healthit.gov/support/browse/BONNIEMAT-646
I can also provide original cql lib if needed.

Thank you!

brynrhodes, 2020-05-19:
Hi @adongare , my guess is that something in the MATCqlFilter class is not traversing the ELM tree, is there a way I can see what's happening in that code?

adongare, 2020-05-19:
Thank you @brynrhodes! I can walk you through the code. Please let me know when you get some time. I can setup meeting invite.

adongare, 2020-05-21:
Hi @brynrhodes, sorry to bother you again, just followup to our earlier conversation. Please let me know your thoughts on this. Thank you!

yanyanhu2, 2020-06-01:
Hi @adongare @brynrhodes, Just wanted to follow up on this issue. The Joint Commission is going to publish our eCQMs for 2020AU soon, including CMS113 and CMS334. We hope this issue could be resolved by MAT tool completely so that we can have issue-free eCQMs published.  Thank you both!

brynrhodes, 2020-06-01:
@adongare , apologies for the delay here, I'll reach out directly to set up a time to chat.

mparenzan, 2020-06-09:
Can I get an update on this issue?   We would like to publish this measure next week.  Thank you.

adongare, 2020-06-09:
Hi @mparenzan, we met with Bryn and he helped us to figure out the issue. Issue is not in this code. It's in another MAT dependency which uses this code. MAT team is working on it. We'll provide you the status on Jira ticket. Thanks!

mparenzan, 2020-06-09:
Do you have an EDC?

adongare, 2020-06-23:
This was an issue in MAT wrapper around CQLtoELM translator and not the original CQLtoELM translator. Thank you so much @brynrhodes for your help on this. I'm closing this issue.

Closed 2020-06-23.

Thread 540 (2020-06-25):

NutritionOrder missing from QICore Model Info File

JSRankins, 2020-06-25:
The qicore-modelinfo-4.0.0.xml appears not to have the NutritionOrder resource in it. Is this file still being developed?

JSRankins, 2022-06-02:
@brynrhodes This appears to be the case in QI-Core model info 4.1.1 as well. Is this intentional?

Thread 976 (2020-06-30):

NullReferenceException in Quantity.toString

brynrhodes, 2020-06-30:
If the value element of a Quantity is null, the toString results in a NullReferenceException:
https://github.com/DBCG/cql_engine/blob/master/cql-engine/src/main/java/org/opencds/cqf/cql/runtime/Quantity.java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

It's not clear how a Quantity with a null element got in there, that's a different issue, but this toString should be resilient to that case.

Closed 2020-07-09.

Thread 544 (2020-07-02):

CQL to ELM translator, removes certain expressions when date range optimization is enabled

amarvakul, 2020-07-02:
With the optimization hints enhancements from [1], the translator produces "dateProperty" and "dateRange" hints but it removes the other parts of the ELM which we rely on for functional correctness.

Example CQL
`define "Filtered Claims": [Claim] C where C.billablePeriod during "Default Claim Period"`

ELM generated with DateRangeOptimization turned ON

> <def name="Filtered Claims" context="Patient" accessLevel="Public">
         <resultTypeSpecifier xsi:type="ListTypeSpecifier">
            <elementType name="fhir:Claim" xsi:type="NamedTypeSpecifier"/>
         </resultTypeSpecifier>
         <expression xsi:type="Query">
            <resultTypeSpecifier xsi:type="ListTypeSpecifier">
               <elementType name="fhir:Claim" xsi:type="NamedTypeSpecifier"/>
            </resultTypeSpecifier>
            <source alias="C">
               <resultTypeSpecifier xsi:type="ListTypeSpecifier">
                  <elementType name="fhir:Claim" xsi:type="NamedTypeSpecifier"/>
               </resultTypeSpecifier>
               <expression dataType="fhir:Claim" dateProperty="billablePeriod" xsi:type="Retrieve">
                  <resultTypeSpecifier xsi:type="ListTypeSpecifier">
                     <elementType name="fhir:Claim" xsi:type="NamedTypeSpecifier"/>
                  </resultTypeSpecifier>
                  <dateRange name="Default Claim Period" xsi:type="ExpressionRef">
                     <resultTypeSpecifier xsi:type="IntervalTypeSpecifier">
                        <pointType name="t:DateTime" xsi:type="NamedTypeSpecifier"/>
                     </resultTypeSpecifier>
                  </dateRange>
               </expression>
            </source>
         </expression>
</def>

ELM generated with DateRangeOptimization turned OFF

> <def name="Filtered Claims" context="Patient" accessLevel="Public">
         <resultTypeSpecifier xsi:type="ListTypeSpecifier">
            <elementType name="fhir:Claim" xsi:type="NamedTypeSpecifier"/>
         </resultTypeSpecifier>
         <expression xsi:type="Query">
            <resultTypeSpecifier xsi:type="ListTypeSpecifier">
               <elementType name="fhir:Claim" xsi:type="NamedTypeSpecifier"/>
            </resultTypeSpecifier>
            <source alias="C">
               <resultTypeSpecifier xsi:type="ListTypeSpecifier">
                  <elementType name="fhir:Claim" xsi:type="NamedTypeSpecifier"/>
               </resultTypeSpecifier>
               <expression dataType="fhir:Claim" xsi:type="Retrieve">
                  <resultTypeSpecifier xsi:type="ListTypeSpecifier">
                     <elementType name="fhir:Claim" xsi:type="NamedTypeSpecifier"/>
                  </resultTypeSpecifier>
               </expression>
            </source>
            <where resultTypeName="t:Boolean" xsi:type="IncludedIn">
               <signature xsi:type="IntervalTypeSpecifier">
                  <pointType name="t:DateTime" xsi:type="NamedTypeSpecifier"/>
               </signature>
               <signature xsi:type="IntervalTypeSpecifier">
                  <pointType name="t:DateTime" xsi:type="NamedTypeSpecifier"/>
               </signature>
               <operand name="ToInterval" libraryName="FHIRHelpers" xsi:type="FunctionRef">
                  <signature name="fhir:Period" xsi:type="NamedTypeSpecifier"/>
                  <operand resultTypeName="fhir:Period" path="billablePeriod" scope="C" xsi:type="Property"/>
               </operand>
               <operand name="Default Claim Period" xsi:type="ExpressionRef">
                  <resultTypeSpecifier xsi:type="IntervalTypeSpecifier">
                     <pointType name="t:DateTime" xsi:type="NamedTypeSpecifier"/>
                  </resultTypeSpecifier>
               </operand>
            </where>
         </expression>
      </def>

Expectations : Preserve the original ELM structure that includes "where" (really all original ELM content) expression and also add "dateProperty"/"dateRange" information.

[1] https://github.com/cqframework/clinical_quality_language/issues/311

brynrhodes, 2021-09-09:
This is addressed by the new DataRequirementsProcessor, included in the 1.5.4 release, in that the DataRequirements analysis does not remove the expressions from the ELM, it only reports them to support query planning.

Closed 2021-09-09.

Thread 547 (2020-07-14):

Internal translator error

brynrhodes, 2020-07-14:
The following library results in an Internal Translator Error:

```
library Scratchpad

using FHIR version '4.0.1'

include FHIRHelpers version '4.0.1'

context Patient

define Conditions: singleton from [Condition]
```

brynrhodes, 2021-03-23:
Addressed in the 1.5.2 release

Closed 2021-03-23.

Thread 959 (2020-07-28):

Condition retrieve with filter on category not working

sliver007, 2020-07-28:
A Condition retrieve with a filter on category, like the following, results in an exception - "Error: CodeableConcept incompatible with org.opencds.cqf.cql.engine.runtime.Code":

[Condition: category in Common."US Core Condition Category Codes"] C

Repro is attached.

[condition-category-retrieve.zip](https://github.com/DBCG/cql_engine/files/4991434/condition-category-retrieve.zip)

Closed 2020-08-04.

Thread 553 (2020-08-11):

Apply the change from STU4B#35 to the 1.3 translator

brynrhodes, 2020-08-11:
Ballot comment STU4B#35 deals with the potential for a timing phrase that includes an offset and an or less clause to result in a translation that does not account for the possibility that the right argument to the timing phrase is null. In this case, the resulting translation compares the left argument of the timing phrase to an interval with null and closed boundaries, effectively resulting in true for all possible values of the left argument.

This issue is to apply the changes made to address this issue in the 1.4 translator to the 1.3 branch.

brynrhodes, 2020-09-14:
Included in the 1.3.21 release

Closed 2020-09-14.

Thread 555 (2020-08-13):

CQL to ELM translator - annotations of function signatures can generate invalid XML

lscott15, 2020-08-13:
Annotations generated for function definitions that use generic types (Interval, List) don't escape ">" properly, leading to invalid XML.

For example:

```
library LAS_Invalid version '1.0'

using QDM version '5.5'
context Patient

define function "MyFunction"(range Interval<Date>):
  duration in days of range
```

Generates the XML (notice how "<" becomes "&lt" but ">" is left as is):
```
<annotation xsi:type="a:Annotation">
            <a:s r="6">
               <a:s>define function &quot;MyFunction&quot;(range </a:s>
               <a:s r="3">
                  <a:s>Interval&lt;</a:s>
                  <a:s r="2">
                     <a:s>Date</a:s>
                  </a:s>
                  <a:s>></a:s>
               </a:s>
               <a:s>):&#xd;
  </a:s>
               <a:s r="5">
                  <a:s r="5">
                     <a:s>duration in days of </a:s>
                     <a:s r="4">
                        <a:s>range</a:s>
                     </a:s>
                  </a:s>
               </a:s>
            </a:s>
         </annotation>
```

brynrhodes, 2020-08-17:
We use a third party library to do the encoding, and we have researched this issue before in another context, and per specifications, the greater than symbol is not required to be encoded (since it is not a beginning token in XML). There are some encoders that do, and some that don't, but we don't have any control over that. Is this causing issues in your environment?

lscott15, 2020-08-18:
Ah, I didn't realize the XML spec allowed that. I'll follow up internally to look at removing the ">" escaping requirement in our XML deserializer. Thanks!

Closed 2020-08-18.

Thread 564 (2020-09-10):

Observation.value in "ValueSet" is selecting string overload

brynrhodes, 2020-09-10:
Given this library:

```
library TestStringInValueSet

using FHIR version '4.0.1'

include FHIRHelpers version '4.0.1'

valueset "Admit Inpatient": 'TBD'

context Patient

define Observations:
  [Observation] O
    where O.value in "Admit Inpatient"
```

This is most likely due to conversions involving primitives receiving conversion precedence over conversions involving complex types (see [Conversion Precedence](https://cql.hl7.org/03-developersguide.html#conversion-precedence)), but it is surprising behavior. Verify the translation is correct, and consider a way to address this, it leads to surprising results for a very common use case.

brynrhodes, 2020-09-18:
Looking into this a bit more, this has also surfaced in some FHIRPath testing, where the same issue occurs, but in trying to compare to a decimal. This is a consequence of resolving choice types too aggressively, and can be handled much more effectively by allowing choice types to participate in the operator resolution process, rather than just the conversion process.

Another example of the behavior:
````
library TestFHIRPath
using FHIR version '4.0.0'
include FHIRHelpers version '4.0.0' called FHIRHelpers
parameter Observation Observation
define Test: Observation.value.value > 0
````

In this case, the resolution of the "value.value" property accessor applies to several choices, including "boolean", "decimal", "string", and "Quantity", and again the preference for simple types resolves to the decimal type, rather than the intended Quantity type. The proposed solution would allow the resolution of choice types to be carried through operator resolution, so that this would be interpreted as:

````
case
  when Observation.value is decimal then (Observation.value as decimal).value > 0
  when Observation.value is Quantity then (Observation.value as Quantity).value > 0
  else null
end
````

brynrhodes, 2020-09-22:
@cmoesel , I'm considering this as a solution, but practically speaking, what it will mean is that operator resolutions involving choice type arguments will start to have `is` and `as` operators output in the ELM, which will effectively mean run-time JS evaluation errors when using the translator with FHIR models. There would be a workaround (using "custom casting operators"), but I'd like to get your thoughts on this proposed approach, when you get a chance.

cmoesel, 2020-09-22:
Hi @brynrhodes.  We're actually working on implementing `Is` and `As` now, so it seems the timing is good.  Regarding the first example:
```
define Observations:
  [Observation] O
    where O.value in "Admit Inpatient"
```
Would this become:
```
define Observations:
  [Observation] O
    where FHIRHelpers.ToConcept(O.value as FHIR.CodeableConcept) in "Admit Inpatient"
```
or
```
define Observations:
  [Observation] O
    where O.value is FHIR.CodeableConcept
    and FHIRHelpers.ToConcept(O.value as FHIR.CodeableConcept) in "Admit Inpatient"
```
or something else?

brynrhodes, 2020-09-22:
Hi @cmoesel , it will actually look something like this:

````
define Observations:
  [Observation] O
    where
      case
        when O.value is FHIR.string
          then FHIRHelpers.ToString(O.value as FHIR.string) in "Admit Inpatient"
        when O.value is FHIR.CodeableConcept
          then FHIRHelpers.ToConcept(O.value as FHIR.CodeableConcept) in "Admit Inpatient"
        else null
      end
````
Does that help?

cmoesel, 2020-09-22:
Yes, that does help.  Thanks.  So... this will definitely render the current `cql-execution` implementation completely broken, but as I noted, we're working on support for `Is`/`As` now.  What is your timeline?

The approach seems reasonable to me.  I suppose the only real alternative is to force users to say what they mean, right?  E.g., to require them to perform casts in order to use type-specific operators? Honestly, I'm kind of a fan of making people be explicit about some things -- because in the example above, the author probably really only _intended_ for it to work w/ `CodeableConcept`, but in our attempt to make it easier for them, we end up representing it as the broadest possible interpretation.  Same for the example before that -- the author likely had either `decimal` or `quantity` in mind when they wrote it, but in allowing them to be lazy about it, we lose the precision of their actual intent.

But I'm guessing that requiring this type of explicit indication in potentially ambiguous situations has already been deemed unacceptable to CQL authors, right?

brynrhodes, 2020-09-22:
The timeline for this is the 1.5 translator release, which I'm hoping to wrap up as quickly as possible. Given the impact (and the fact that it's still a "correct" interpretation either way, it's just tricky to figure out what happened in some cases), would it make sense to introduce this as a translator option?
As far as being explicit, yes, you can always make it explicit (and that would still be true even with this new behavior), but the fact that you have to be explicit is really an artifact of the flexibility of the underlying model, and ideally, profile-informed authoring views of the model will eliminate the need entirely (i.e. a CodeableObservation profile would limit the available choices for value, so the choice-based resolution isn't necessary).

cmoesel, 2020-09-23:
I don't know if it should be an option or not.  I don't want to force additional complexity on the implementation.  So, if it does make for a fair amount of complexity, I'm OK _not_ making it an option.  But if it's just a few lines or code or a simple switch statement then perhaps it makes sense for people who want to force authors to be more explicit.

Thread 566 (2020-09-11):

Inconsistency in primaryCodePath when Choice Types Involved

JSRankins, 2020-09-11:
Currently, DeviceRequest in FHIR Model Info file 4.0.1 has primaryCodePath as codeCodeableConcept.

`
<ns4:typeInfo xsi:type="ns4:ClassInfo" namespace="FHIR" name="DeviceRequest" identifier="http://hl7.org/fhir/StructureDefinition/DeviceRequest" label="DeviceRequest" retrievable="true" primaryCodePath="codeCodeableConcept" baseType="FHIR.DomainResource">
`

Although the codeCodeableConcept attribute does not exist in the DeviceRequest resource, the flavor of it does, since CodeableConcept is part of the applicable choice type.

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

We are not certain if (1) the use of codeCodeableConcept is an error or (2) a way of setting which type should be used for the primaryCodePath for DeviceRequest. If the latter, then we are wondering why the other primary code paths that are choice typed do not set the type that should be used within the related choice type. One example of this would be GuidanceResponse, which has a primaryCodePath of module.

`
<ns4:typeInfo xsi:type="ns4:ClassInfo" namespace="FHIR" name="GuidanceResponse" identifier="http://hl7.org/fhir/StructureDefinition/GuidanceResponse" label="GuidanceResponse" retrievable="true" primaryCodePath="module" baseType="FHIR.DomainResource">
`

The attribute module has a few different choices available - among them, moduleCodableConcept. There are other primarycodePath attributes that do the same thing. If possible, we would like to request that the primaryCodePath type be set when the primaryCodePath corresponds to a choice type. Thoughts?

brynrhodes, 2020-09-25:
Agreed, the code path should be in terms of the attributes of the model, this is incorrect and should be fixed.

brynrhodes, 2020-11-20:
In addition to this, updates for other missing or incorrect primary code paths should be applied:

DeviceRequest -> code
DetectedIssue -> code
BodyStructure -> location
PractitionerRole -> code
RelatedPerson -> relationship
AdverseEvent -> event
Location -> type

See https://github.com/cqframework/cqf-tooling/issues/160 for where this was applied to generation tooling.

brynrhodes, 2020-12-08:
Included in 1.5.1 Release

Closed 2020-12-08.

Thread 568 (2020-09-18):

cql-to-elm --input . --verify fails inside Examples/ folder

mbaroody, 2020-09-18:
I am using jdk1.8.0
Assuming that I've run the following from `Src/java`:
```
./gradlew build
./gradlew :cql-to-elm:installDist
export PATH=$PATH:`pwd`/cql-to-elm/build/install/cql-to-elm/bin/
```

I can now go into the `Examples/` folder and run:
```
cql-to-elm --input . --verify
```

This gives me:

```
================================================================================
TRANSLATE ./ChlamydiaScreening_CDS_UsingCommon.cql

================================================================================
TRANSLATE ./ChlamydiaScreening_CDS.cql

================================================================================
TRANSLATE ./CMS153.cql
Translation failed due to errors:
Error:[92:2, 92:7] Could not resolve identifier gender in the current library.
Error:[98:17, 98:80] Could not resolve type name Encounter, Performance.
Error:[111:97, 111:111] Member effectiveTime not found for type QUICK.Condition.
Error:[125:17, 125:101] Could not resolve type name MedicationTreatment, Performance.
Error:[138:17, 138:94] Could not resolve type name MedicationTreatment, Order.
Error:[151:14, 151:74] Could not resolve type name LaboratoryTest, Order.
Error:[164:17, 164:83] Could not resolve type name LaboratoryTest, Order.
Error:[184:13, 184:84] Could not resolve type name Procedure, Performance.
Error:[196:9, 196:43] Could not validate reference to expression HasHadMedicationForSexualActivity because its definition contains errors.
Error:[208:9, 208:18] Could not validate reference to expression IsFemale because its definition contains errors.
Error:[219:9, 219:18] Could not validate reference to expression IsFemale because its definition contains errors.
Error:[236:17, 236:94] Could not resolve type name SimpleObservationOccurence.
Error:[246:9, 246:31] Could not validate reference to expression InStratum1Denominator because its definition contains errors.
Error:[250:9, 250:31] Could not validate reference to expression InStratum2Denominator because its definition contains errors.
Error:[253:1, 253:18] Could not resolve context name POPULATION in model QUICK.
Error:[258:53, 258:75] Could not validate reference to expression InStratum1Denominator because its definition contains errors.
Error:[259:51, 259:71] Could not validate reference to expression InStratum1Numerator because its definition contains errors.
Error:[261:53, 261:75] Could not validate reference to expression InStratum2Denominator because its definition contains errors.
Error:[262:51, 262:71] Could not validate reference to expression InStratum2Numerator because its definition contains errors.

================================================================================
TRANSLATE ./CMS146v2_QDM_MS.cql
Translation failed due to errors:
Error:[25:9, 25:53] Specified data type EncounterPerformed does not support retrieval.
Error:[47:5, 47:19] Could not validate reference to expression EncounterData because its definition contains errors.
Error:[50:28, 50:37] Could not validate reference to expression IPPCount because its definition contains errors.
Error:[53:5, 53:19] Could not validate reference to expression EncounterData because its definition contains errors.
Error:[59:5, 59:19] Could not validate reference to expression EncounterData because its definition contains errors.

================================================================================
TRANSLATE ./CMS26v2_CQM.cql
Translation failed due to errors:
Error:[63:1, 63:18] Could not resolve context name Population in model QUICK.

================================================================================
TRANSLATE ./ChlamydiaScreening_CQM.cql
Translation failed due to errors:
Error:[3:1, 3:25] Could not resolve model info provider for model QUICK, version 1.6.
Error:[22:1, 22:15] Could not resolve context name Patient in model System.
Error:[25:2, 25:41] Could not resolve identifier Patient in the current library.
Error:[29:10, 29:62] Could not resolve type name Condition.
Error:[43:2, 43:16] Could not validate reference to expression InDemographic because its definition contains errors.
Error:[49:10, 49:52] Could not resolve type name DiagnosticReport.
Error:[51:1, 51:18] Could not resolve context name Population in model System.
Error:[53:31, 53:37] Could not validate reference to expression Patient because its definition contains errors.

================================================================================
TRANSLATE ./CMS55v1_NQF0495.cql
Translation failed due to errors:
Error:[71:1, 71:18] Could not resolve context name Population in model QUICK.

================================================================================
TRANSLATE ./CMS55v1_QDM.cql
Translation failed due to errors:
Error:[71:1, 71:18] Could not resolve context name Population in model QDM.

================================================================================
TRANSLATE ./EH_CMS9v4_NQF0480_BF_ExclusiveBreastFeed/CMS9v4_QDM.cql
Translation failed due to errors:
Error:[30:26, 30:42] Member admissionDatetime not found for type Encounter, Performed.
Error:[34:3, 34:58] Could not resolve identifier Gestational Age At Birth in the current library.
Error:[52:10, 52:48] Could not validate reference to expression $Gestational Age at Birth <= 37 weeks because its definition contains errors.
Error:[60:3, 60:52] Could not validate reference to expression $Live Birth Infants without Parenteral Nutrition because its definition contains errors.
Error:[67:3, 67:25] Could not validate reference to expression $Initial Population 1 because its definition contains errors.
Error:[75:13, 75:28] Member facilityLocation not found for type Encounter, Performed.
Error:[93:47, 93:59] Member startDatetime not found for type Substance, Administered.
Error:[113:3, 113:52] Could not validate reference to expression $Live Birth Infants without Parenteral Nutrition because its definition contains errors.
Error:[125:59, 125:71] Member startDatetime not found for type Patient Characteristic Birthdate.
Error:[132:13, 132:83] Could not resolve type name Communication: From Patient to Provider.
Error:[142:11, 142:41] Could not validate reference to expression $Intention Not To Breast Feed because its definition contains errors.
Error:[149:3, 149:16] Could not validate reference to expression $Numerator 1 because its definition contains errors.

================================================================================
TRANSLATE ./CMS179v2_CQM.cql
Translation failed due to errors:
Warning:[19:31, 19:81] Could not resolve code path medication.code for the type of the retrieve QUICK.MedicationAdministration.
Warning:[19:31, 19:81] Could not resolve membership operator for terminology target of the retrieve.
Error:[130:1, 130:18] Could not resolve context name Population in model QUICK.

================================================================================
TRANSLATE ./CMS146v2_QDM.cql

================================================================================
TRANSLATE ./CMS179v2_QDM.cql
Translation failed due to errors:
Error:[164:1, 164:18] Could not resolve context name Population in model QDM.

================================================================================
TRANSLATE ./CMS154v1_NQF0069.cql
Translation failed due to errors:
Warning:[117:39, 117:90] Could not resolve code path medication.code for the type of the retrieve QUICK.MedicationPrescription.
Warning:[117:39, 117:90] Could not resolve membership operator for terminology target of the retrieve.
Error:[119:1, 119:18] Could not resolve context name Population in model QUICK.
Warning:[121:52, 121:64] Boolean-valued expression was promoted to a list.
Warning:[121:52, 121:64] Boolean-valued expression was promoted to a list.

================================================================================
TRANSLATE ./CMS135_QDM.cql

================================================================================
TRANSLATE ./Zika/v3.0.0/zika-virus-intervention-logic.cql
Translation failed due to errors:
Error:[57:16, 57:16] Could not resolve identifier O in the current library.
Error:[61:3, 61:35] Could not validate reference to expression Zika Exposure Assessment Result because its definition contains errors.
Error:[79:5, 79:47] Could not validate reference to expression Zika Exposure Assessment Result because its definition contains errors.
Error:[87:5, 87:47] Could not validate reference to expression Zika Exposure Assessment Result because its definition contains errors.
Error:[94:5, 94:47] Could not validate reference to expression Zika Exposure Assessment Result because its definition contains errors.
Error:[101:5, 101:47] Could not validate reference to expression Zika Exposure Assessment Result because its definition contains errors.
Error:[108:5, 108:47] Could not validate reference to expression Zika Exposure Assessment Result because its definition contains errors.
Error:[114:12, 114:44] Could not validate reference to expression Time Since Returned From Travel because its definition contains errors.
Error:[118:5, 118:47] Could not validate reference to expression Zika Exposure Assessment Result because its definition contains errors.
Error:[124:3, 124:49] Could not validate reference to expression Resident of or Frequent Traveler to Zika Area because its definition contains errors.
Error:[133:16, 133:16] Could not resolve identifier S in the current library.
Error:[137:42, 137:61] Could not validate reference to expression Zika Symptom Onset because its definition contains errors.
Error:[140:8, 140:37] Could not validate reference to expression Has Zika Exposure Assessment because its definition contains errors.
Error:[143:4, 143:31] Could not validate reference to expression Has Possible Zika Exposure because its definition contains errors.
Error:[147:4, 147:31] Could not validate reference to expression Has Possible Zika Exposure because its definition contains errors.
Error:[152:4, 152:31] Could not validate reference to expression Has Possible Zika Exposure because its definition contains errors.
Error:[156:3, 156:31] Could not validate reference to expression Planned Travel to Zika Area because its definition contains errors.

================================================================================
TRANSLATE ./EH_CMS9v4_NQF0480_BF_ExclusiveBreastFeed/CMS9v4_FHIRv16_CQM.cql
Translation failed due to errors:
Error:[3:1, 3:24] Could not load model information for model FHIR, version 1.8 because version 1.6 is already loaded.
Error:[5:35, 5:45] Could not resolve model name FHIR
Error:[5:1, 6:54] org.hl7.elm.r1.Null cannot be cast to org.hl7.elm.r1.TypeSpecifier
Error:[8:37, 8:49] Could not resolve model name FHIR
Error:[8:1, 9:78] org.hl7.elm.r1.Null cannot be cast to org.hl7.elm.r1.TypeSpecifier
Error:[11:34, 11:43] Could not resolve model name FHIR
Error:[11:1, 12:59] org.hl7.elm.r1.Null cannot be cast to org.hl7.elm.r1.TypeSpecifier
Error:[14:31, 14:41] Could not resolve model name FHIR
Error:[14:1, 20:5] org.hl7.elm.r1.Null cannot be cast to org.hl7.elm.r1.TypeSpecifier
Error:[22:35, 22:54] Could not resolve model name FHIR
Error:[22:1, 26:5] org.hl7.elm.r1.Null cannot be cast to org.hl7.elm.r1.TypeSpecifier
Error:[28:32, 28:40] Could not resolve model name FHIR
Error:[28:1, 28:54] org.hl7.elm.r1.Null cannot be cast to org.hl7.elm.r1.TypeSpecifier
Error:[29:32, 29:62] Could not resolve model name FHIR
Error:[29:1, 29:76] org.hl7.elm.r1.Null cannot be cast to org.hl7.elm.r1.TypeSpecifier
Error:[30:32, 30:56] Could not resolve model name FHIR
Error:[30:1, 30:70] org.hl7.elm.r1.Null cannot be cast to org.hl7.elm.r1.TypeSpecifier
Error:[31:32, 31:47] Could not resolve model name FHIR
Error:[31:1, 31:61] org.hl7.elm.r1.Null cannot be cast to org.hl7.elm.r1.TypeSpecifier
Error:[32:32, 32:47] Could not resolve model name FHIR
Error:[32:1, 32:61] org.hl7.elm.r1.Null cannot be cast to org.hl7.elm.r1.TypeSpecifier
Error:[33:32, 33:62] Could not resolve model name FHIR
Error:[33:1, 33:76] org.hl7.elm.r1.Null cannot be cast to org.hl7.elm.r1.TypeSpecifier
Error:[34:32, 34:50] Could not resolve model name FHIR
Error:[34:1, 34:64] org.hl7.elm.r1.Null cannot be cast to org.hl7.elm.r1.TypeSpecifier
Error:[35:32, 35:57] Could not resolve model name FHIR
Error:[35:1, 35:71] org.hl7.elm.r1.Null cannot be cast to org.hl7.elm.r1.TypeSpecifier
Error:[36:32, 36:57] Could not resolve model name FHIR
Error:[36:1, 36:71] org.hl7.elm.r1.Null cannot be cast to org.hl7.elm.r1.TypeSpecifier
Error:[37:32, 37:49] Could not resolve model name FHIR
Error:[37:1, 37:63] org.hl7.elm.r1.Null cannot be cast to org.hl7.elm.r1.TypeSpecifier
Error:[38:32, 38:57] Could not resolve model name FHIR
Error:[38:1, 38:71] org.hl7.elm.r1.Null cannot be cast to org.hl7.elm.r1.TypeSpecifier
Error:[39:32, 39:59] Could not resolve model name FHIR
Error:[39:1, 39:73] org.hl7.elm.r1.Null cannot be cast to org.hl7.elm.r1.TypeSpecifier
Error:[40:32, 40:51] Could not resolve model name FHIR
Error:[40:1, 40:65] org.hl7.elm.r1.Null cannot be cast to org.hl7.elm.r1.TypeSpecifier
Error:[41:32, 41:59] Could not resolve model name FHIR
Error:[41:1, 41:73] org.hl7.elm.r1.Null cannot be cast to org.hl7.elm.r1.TypeSpecifier
Error:[42:32, 42:53] Could not resolve model name FHIR
Error:[42:1, 42:67] org.hl7.elm.r1.Null cannot be cast to org.hl7.elm.r1.TypeSpecifier
Error:[43:32, 43:54] Could not resolve model name FHIR
Error:[43:1, 43:68] org.hl7.elm.r1.Null cannot be cast to org.hl7.elm.r1.TypeSpecifier
Error:[44:32, 44:63] Could not resolve model name FHIR
Error:[44:1, 44:77] org.hl7.elm.r1.Null cannot be cast to org.hl7.elm.r1.TypeSpecifier
Error:[45:32, 45:52] Could not resolve model name FHIR
Error:[45:1, 45:66] org.hl7.elm.r1.Null cannot be cast to org.hl7.elm.r1.TypeSpecifier
Error:[46:32, 46:58] Could not resolve model name FHIR
Error:[46:1, 46:72] org.hl7.elm.r1.Null cannot be cast to org.hl7.elm.r1.TypeSpecifier
Error:[47:32, 47:60] Could not resolve model name FHIR
Error:[47:1, 47:74] org.hl7.elm.r1.Null cannot be cast to org.hl7.elm.r1.TypeSpecifier
Error:[48:32, 48:68] Could not resolve model name FHIR
Error:[48:1, 48:82] org.hl7.elm.r1.Null cannot be cast to org.hl7.elm.r1.TypeSpecifier
Error:[49:32, 49:58] Could not resolve model name FHIR
Error:[49:1, 49:72] org.hl7.elm.r1.Null cannot be cast to org.hl7.elm.r1.TypeSpecifier
Error:[50:32, 50:46] Could not resolve model name FHIR
Error:[50:1, 50:60] org.hl7.elm.r1.Null cannot be cast to org.hl7.elm.r1.TypeSpecifier
Error:[51:32, 51:55] Could not resolve model name FHIR
Error:[51:1, 51:69] org.hl7.elm.r1.Null cannot be cast to org.hl7.elm.r1.TypeSpecifier
Error:[52:32, 52:63] Could not resolve model name FHIR
Error:[52:1, 52:77] org.hl7.elm.r1.Null cannot be cast to org.hl7.elm.r1.TypeSpecifier
Error:[53:34, 53:45] Could not resolve model name FHIR
Error:[53:1, 53:59] org.hl7.elm.r1.Null cannot be cast to org.hl7.elm.r1.TypeSpecifier
Error:[54:34, 54:46] Could not resolve model name FHIR
Error:[54:1, 54:60] org.hl7.elm.r1.Null cannot be cast to org.hl7.elm.r1.TypeSpecifier
Error:[55:34, 55:42] Could not resolve model name FHIR
Error:[55:1, 55:56] org.hl7.elm.r1.Null cannot be cast to org.hl7.elm.r1.TypeSpecifier
Error:[56:32, 56:48] Could not resolve model name FHIR
Error:[56:1, 56:62] org.hl7.elm.r1.Null cannot be cast to org.hl7.elm.r1.TypeSpecifier
Error:[57:32, 57:57] Could not resolve model name FHIR
Error:[57:1, 57:71] org.hl7.elm.r1.Null cannot be cast to org.hl7.elm.r1.TypeSpecifier
Error:[58:32, 58:46] Could not resolve model name FHIR
Error:[58:1, 58:60] org.hl7.elm.r1.Null cannot be cast to org.hl7.elm.r1.TypeSpecifier
Error:[59:32, 59:45] Could not resolve model name FHIR
Error:[59:1, 59:59] org.hl7.elm.r1.Null cannot be cast to org.hl7.elm.r1.TypeSpecifier
Error:[60:32, 60:47] Could not resolve model name FHIR
Error:[60:1, 60:61] org.hl7.elm.r1.Null cannot be cast to org.hl7.elm.r1.TypeSpecifier
Error:[61:32, 61:59] Could not resolve model name FHIR
Error:[61:1, 61:73] org.hl7.elm.r1.Null cannot be cast to org.hl7.elm.r1.TypeSpecifier
Error:[62:32, 62:55] Could not resolve model name FHIR
Error:[62:1, 62:69] org.hl7.elm.r1.Null cannot be cast to org.hl7.elm.r1.TypeSpecifier
Error:[63:32, 63:63] Could not resolve model name FHIR
Error:[63:1, 63:77] org.hl7.elm.r1.Null cannot be cast to org.hl7.elm.r1.TypeSpecifier
Error:[64:33, 64:48] Could not resolve model name FHIR
Error:[64:1, 64:62] org.hl7.elm.r1.Null cannot be cast to org.hl7.elm.r1.TypeSpecifier
Error:[65:32, 65:55] Could not resolve model name FHIR
Error:[65:1, 65:69] org.hl7.elm.r1.Null cannot be cast to org.hl7.elm.r1.TypeSpecifier
Error:[66:32, 66:60] Could not resolve model name FHIR
Error:[66:1, 66:74] org.hl7.elm.r1.Null cannot be cast to org.hl7.elm.r1.TypeSpecifier
Error:[67:32, 67:58] Could not resolve model name FHIR
Error:[67:1, 67:72] org.hl7.elm.r1.Null cannot be cast to org.hl7.elm.r1.TypeSpecifier
Error:[68:32, 68:51] Could not resolve model name FHIR
Error:[68:1, 68:65] org.hl7.elm.r1.Null cannot be cast to org.hl7.elm.r1.TypeSpecifier
Error:[69:32, 69:52] Could not resolve model name FHIR
Error:[69:1, 69:66] org.hl7.elm.r1.Null cannot be cast to org.hl7.elm.r1.TypeSpecifier
Error:[70:32, 70:52] Could not resolve model name FHIR
Error:[70:1, 70:66] org.hl7.elm.r1.Null cannot be cast to org.hl7.elm.r1.TypeSpecifier
Error:[71:32, 71:53] Could not resolve model name FHIR
Error:[71:1, 71:67] org.hl7.elm.r1.Null cannot be cast to org.hl7.elm.r1.TypeSpecifier
Error:[72:32, 72:42] Could not resolve model name FHIR
Error:[72:1, 72:56] org.hl7.elm.r1.Null cannot be cast to org.hl7.elm.r1.TypeSpecifier
Error:[73:32, 73:50] Could not resolve model name FHIR
Error:[73:1, 73:64] org.hl7.elm.r1.Null cannot be cast to org.hl7.elm.r1.TypeSpecifier
Error:[74:32, 74:49] Could not resolve model name FHIR
Error:[74:1, 74:63] org.hl7.elm.r1.Null cannot be cast to org.hl7.elm.r1.TypeSpecifier
Error:[75:32, 75:55] Could not resolve model name FHIR
Error:[75:1, 75:69] org.hl7.elm.r1.Null cannot be cast to org.hl7.elm.r1.TypeSpecifier
Error:[76:32, 76:57] Could not resolve model name FHIR
Error:[76:1, 76:71] org.hl7.elm.r1.Null cannot be cast to org.hl7.elm.r1.TypeSpecifier
Error:[77:32, 77:59] Could not resolve model name FHIR
Error:[77:1, 77:73] org.hl7.elm.r1.Null cannot be cast to org.hl7.elm.r1.TypeSpecifier
Error:[78:32, 78:66] Could not resolve model name FHIR
Error:[78:1, 78:80] org.hl7.elm.r1.Null cannot be cast to org.hl7.elm.r1.TypeSpecifier
Error:[79:32, 79:62] Could not resolve model name FHIR
Error:[79:1, 79:76] org.hl7.elm.r1.Null cannot be cast to org.hl7.elm.r1.TypeSpecifier
Error:[80:32, 80:49] Could not resolve model name FHIR
Error:[80:1, 80:63] org.hl7.elm.r1.Null cannot be cast to org.hl7.elm.r1.TypeSpecifier
Error:[81:32, 81:60] Could not resolve model name FHIR
Error:[81:1, 81:74] org.hl7.elm.r1.Null cannot be cast to org.hl7.elm.r1.TypeSpecifier
Error:[82:32, 82:60] Could not resolve model name FHIR
Error:[82:1, 82:74] org.hl7.elm.r1.Null cannot be cast to org.hl7.elm.r1.TypeSpecifier
Error:[83:32, 83:49] Could not resolve model name FHIR
Error:[83:1, 83:63] org.hl7.elm.r1.Null cannot be cast to org.hl7.elm.r1.TypeSpecifier
Error:[84:32, 84:52] Could not resolve model name FHIR
Error:[84:1, 84:66] org.hl7.elm.r1.Null cannot be cast to org.hl7.elm.r1.TypeSpecifier
Error:[85:32, 85:61] Could not resolve model name FHIR
Error:[85:1, 85:75] org.hl7.elm.r1.Null cannot be cast to org.hl7.elm.r1.TypeSpecifier
Error:[86:32, 86:51] Could not resolve model name FHIR
Error:[86:1, 86:65] org.hl7.elm.r1.Null cannot be cast to org.hl7.elm.r1.TypeSpecifier
Error:[87:32, 87:49] Could not resolve model name FHIR
Error:[87:1, 87:63] org.hl7.elm.r1.Null cannot be cast to org.hl7.elm.r1.TypeSpecifier
Error:[88:32, 88:55] Could not resolve model name FHIR
Error:[88:1, 88:69] org.hl7.elm.r1.Null cannot be cast to org.hl7.elm.r1.TypeSpecifier
Error:[89:32, 89:50] Could not resolve model name FHIR
Error:[89:1, 89:64] org.hl7.elm.r1.Null cannot be cast to org.hl7.elm.r1.TypeSpecifier
Error:[90:32, 90:57] Could not resolve model name FHIR
Error:[90:1, 90:71] org.hl7.elm.r1.Null cannot be cast to org.hl7.elm.r1.TypeSpecifier
Error:[91:32, 91:56] Could not resolve model name FHIR
Error:[91:1, 91:70] org.hl7.elm.r1.Null cannot be cast to org.hl7.elm.r1.TypeSpecifier
Error:[92:32, 92:38] Could not resolve model name FHIR
Error:[92:1, 92:52] org.hl7.elm.r1.Null cannot be cast to org.hl7.elm.r1.TypeSpecifier
Error:[93:32, 93:47] Could not resolve model name FHIR
Error:[93:1, 93:61] org.hl7.elm.r1.Null cannot be cast to org.hl7.elm.r1.TypeSpecifier
Error:[94:32, 94:59] Could not resolve model name FHIR
Error:[94:1, 94:73] org.hl7.elm.r1.Null cannot be cast to org.hl7.elm.r1.TypeSpecifier
Error:[95:32, 95:50] Could not resolve model name FHIR
Error:[95:1, 95:64] org.hl7.elm.r1.Null cannot be cast to org.hl7.elm.r1.TypeSpecifier
Error:[96:32, 96:52] Could not resolve model name FHIR
Error:[96:1, 96:66] org.hl7.elm.r1.Null cannot be cast to org.hl7.elm.r1.TypeSpecifier
Error:[97:32, 97:55] Could not resolve model name FHIR
Error:[97:1, 97:69] org.hl7.elm.r1.Null cannot be cast to org.hl7.elm.r1.TypeSpecifier
Error:[98:32, 98:52] Could not resolve model name FHIR
Error:[98:1, 98:66] org.hl7.elm.r1.Null cannot be cast to org.hl7.elm.r1.TypeSpecifier
Error:[99:32, 99:53] Could not resolve model name FHIR
Error:[99:1, 99:67] org.hl7.elm.r1.Null cannot be cast to org.hl7.elm.r1.TypeSpecifier
Error:[100:32, 100:54] Could not resolve model name FHIR
Error:[100:1, 100:68] org.hl7.elm.r1.Null cannot be cast to org.hl7.elm.r1.TypeSpecifier
Error:[101:32, 101:55] Could not resolve model name FHIR
Error:[101:1, 101:69] org.hl7.elm.r1.Null cannot be cast to org.hl7.elm.r1.TypeSpecifier
Error:[102:32, 102:61] Could not resolve model name FHIR
Error:[102:1, 102:75] org.hl7.elm.r1.Null cannot be cast to org.hl7.elm.r1.TypeSpecifier
Error:[103:32, 103:51] Could not resolve model name FHIR
Error:[103:1, 103:65] org.hl7.elm.r1.Null cannot be cast to org.hl7.elm.r1.TypeSpecifier
Error:[104:32, 104:57] Could not resolve model name FHIR
Error:[104:1, 104:71] org.hl7.elm.r1.Null cannot be cast to org.hl7.elm.r1.TypeSpecifier
Error:[105:32, 105:62] Could not resolve model name FHIR
Error:[105:1, 105:76] org.hl7.elm.r1.Null cannot be cast to org.hl7.elm.r1.TypeSpecifier
Error:[106:32, 106:59] Could not resolve model name FHIR
Error:[106:1, 106:73] org.hl7.elm.r1.Null cannot be cast to org.hl7.elm.r1.TypeSpecifier
Error:[107:32, 107:56] Could not resolve model name FHIR
Error:[107:1, 107:70] org.hl7.elm.r1.Null cannot be cast to org.hl7.elm.r1.TypeSpecifier
Error:[108:32, 108:55] Could not resolve model name FHIR
Error:[108:1, 108:69] org.hl7.elm.r1.Null cannot be cast to org.hl7.elm.r1.TypeSpecifier
Error:[109:32, 109:57] Could not resolve model name FHIR
Error:[109:1, 109:71] org.hl7.elm.r1.Null cannot be cast to org.hl7.elm.r1.TypeSpecifier
Error:[110:32, 110:48] Could not resolve model name FHIR
Error:[110:1, 110:62] org.hl7.elm.r1.Null cannot be cast to org.hl7.elm.r1.TypeSpecifier
Error:[111:33, 111:44] Could not resolve model name FHIR
Error:[111:1, 111:58] org.hl7.elm.r1.Null cannot be cast to org.hl7.elm.r1.TypeSpecifier
Error:[112:32, 112:51] Could not resolve model name FHIR
Error:[112:1, 112:65] org.hl7.elm.r1.Null cannot be cast to org.hl7.elm.r1.TypeSpecifier
Error:[113:32, 113:59] Could not resolve model name FHIR
Error:[113:1, 113:73] org.hl7.elm.r1.Null cannot be cast to org.hl7.elm.r1.TypeSpecifier
Error:[114:32, 114:48] Could not resolve model name FHIR
Error:[114:1, 114:62] org.hl7.elm.r1.Null cannot be cast to org.hl7.elm.r1.TypeSpecifier
Error:[115:32, 115:72] Could not resolve model name FHIR
Error:[115:1, 115:86] org.hl7.elm.r1.Null cannot be cast to org.hl7.elm.r1.TypeSpecifier
Error:[116:32, 116:47] Could not resolve model name FHIR
Error:[116:1, 116:61] org.hl7.elm.r1.Null cannot be cast to org.hl7.elm.r1.TypeSpecifier
Error:[117:32, 117:46] Could not resolve model name FHIR
Error:[117:1, 117:60] org.hl7.elm.r1.Null cannot be cast to org.hl7.elm.r1.TypeSpecifier
Error:[118:32, 118:51] Could not resolve model name FHIR
Error:[118:1, 118:65] org.hl7.elm.r1.Null cannot be cast to org.hl7.elm.r1.TypeSpecifier
Error:[119:32, 119:60] Could not resolve model name FHIR
Error:[119:1, 119:74] org.hl7.elm.r1.Null cannot be cast to org.hl7.elm.r1.TypeSpecifier
Error:[120:32, 120:57] Could not resolve model name FHIR
Error:[120:1, 120:71] org.hl7.elm.r1.Null cannot be cast to org.hl7.elm.r1.TypeSpecifier
Error:[121:32, 121:46] Could not resolve model name FHIR
Error:[121:1, 121:60] org.hl7.elm.r1.Null cannot be cast to org.hl7.elm.r1.TypeSpecifier
Error:[122:32, 122:57] Could not resolve model name FHIR
Error:[122:1, 122:71] org.hl7.elm.r1.Null cannot be cast to org.hl7.elm.r1.TypeSpecifier
Error:[123:32, 123:59] Could not resolve model name FHIR
Error:[123:1, 123:73] org.hl7.elm.r1.Null cannot be cast to org.hl7.elm.r1.TypeSpecifier
Error:[124:32, 124:58] Could not resolve model name FHIR
Error:[124:1, 124:72] org.hl7.elm.r1.Null cannot be cast to org.hl7.elm.r1.TypeSpecifier
Error:[125:32, 125:50] Could not resolve model name FHIR
Error:[125:1, 125:64] org.hl7.elm.r1.Null cannot be cast to org.hl7.elm.r1.TypeSpecifier
Error:[126:32, 126:58] Could not resolve model name FHIR
Error:[126:1, 126:72] org.hl7.elm.r1.Null cannot be cast to org.hl7.elm.r1.TypeSpecifier
Error:[127:32, 127:48] Could not resolve model name FHIR
Error:[127:1, 127:62] org.hl7.elm.r1.Null cannot be cast to org.hl7.elm.r1.TypeSpecifier
Error:[128:32, 128:62] Could not resolve model name FHIR
Error:[128:1, 128:76] org.hl7.elm.r1.Null cannot be cast to org.hl7.elm.r1.TypeSpecifier
Error:[129:32, 129:44] Could not resolve model name FHIR
Error:[129:1, 129:58] org.hl7.elm.r1.Null cannot be cast to org.hl7.elm.r1.TypeSpecifier
Error:[130:32, 130:65] Could not resolve model name FHIR
Error:[130:1, 130:79] org.hl7.elm.r1.Null cannot be cast to org.hl7.elm.r1.TypeSpecifier
Error:[131:32, 131:57] Could not resolve model name FHIR
Error:[131:1, 131:71] org.hl7.elm.r1.Null cannot be cast to org.hl7.elm.r1.TypeSpecifier
Error:[132:32, 132:58] Could not resolve model name FHIR
Error:[132:1, 132:72] org.hl7.elm.r1.Null cannot be cast to org.hl7.elm.r1.TypeSpecifier
Error:[133:32, 133:52] Could not resolve model name FHIR
Error:[133:1, 133:66] org.hl7.elm.r1.Null cannot be cast to org.hl7.elm.r1.TypeSpecifier
Error:[134:32, 134:52] Could not resolve model name FHIR
Error:[134:1, 134:66] org.hl7.elm.r1.Null cannot be cast to org.hl7.elm.r1.TypeSpecifier
Error:[135:32, 135:47] Could not resolve model name FHIR
Error:[135:1, 135:61] org.hl7.elm.r1.Null cannot be cast to org.hl7.elm.r1.TypeSpecifier
Error:[136:32, 136:62] Could not resolve model name FHIR
Error:[136:1, 136:76] org.hl7.elm.r1.Null cannot be cast to org.hl7.elm.r1.TypeSpecifier
Error:[137:32, 137:54] Could not resolve model name FHIR
Error:[137:1, 137:68] org.hl7.elm.r1.Null cannot be cast to org.hl7.elm.r1.TypeSpecifier
Error:[138:32, 138:53] Could not resolve model name FHIR
Error:[138:1, 138:67] org.hl7.elm.r1.Null cannot be cast to org.hl7.elm.r1.TypeSpecifier
Error:[139:32, 139:53] Could not resolve model name FHIR
Error:[139:1, 139:67] org.hl7.elm.r1.Null cannot be cast to org.hl7.elm.r1.TypeSpecifier
Error:[140:32, 140:63] Could not resolve model name FHIR
Error:[140:1, 140:77] org.hl7.elm.r1.Null cannot be cast to org.hl7.elm.r1.TypeSpecifier
Error:[141:32, 141:57] Could not resolve model name FHIR
Error:[141:1, 141:71] org.hl7.elm.r1.Null cannot be cast to org.hl7.elm.r1.TypeSpecifier
Error:[142:32, 142:44] Could not resolve model name FHIR
Error:[142:1, 142:58] org.hl7.elm.r1.Null cannot be cast to org.hl7.elm.r1.TypeSpecifier
Error:[143:32, 143:53] Could not resolve model name FHIR
Error:[143:1, 143:67] org.hl7.elm.r1.Null cannot be cast to org.hl7.elm.r1.TypeSpecifier
Error:[144:32, 144:47] Could not resolve model name FHIR
Error:[144:1, 144:61] org.hl7.elm.r1.Null cannot be cast to org.hl7.elm.r1.TypeSpecifier
Error:[145:32, 145:56] Could not resolve model name FHIR
Error:[145:1, 145:70] org.hl7.elm.r1.Null cannot be cast to org.hl7.elm.r1.TypeSpecifier
Error:[146:32, 146:47] Could not resolve model name FHIR
Error:[146:1, 146:61] org.hl7.elm.r1.Null cannot be cast to org.hl7.elm.r1.TypeSpecifier
Error:[147:32, 147:57] Could not resolve model name FHIR
Error:[147:1, 147:71] org.hl7.elm.r1.Null cannot be cast to org.hl7.elm.r1.TypeSpecifier
Error:[148:32, 148:56] Could not resolve model name FHIR
Error:[148:1, 148:70] org.hl7.elm.r1.Null cannot be cast to org.hl7.elm.r1.TypeSpecifier
Error:[149:33, 149:44] Could not resolve model name FHIR
Error:[149:1, 149:58] org.hl7.elm.r1.Null cannot be cast to org.hl7.elm.r1.TypeSpecifier
Error:[150:32, 150:63] Could not resolve model name FHIR
Error:[150:1, 150:77] org.hl7.elm.r1.Null cannot be cast to org.hl7.elm.r1.TypeSpecifier
Error:[151:32, 151:40] Could not resolve model name FHIR
Error:[151:1, 151:54] org.hl7.elm.r1.Null cannot be cast to org.hl7.elm.r1.TypeSpecifier
Error:[152:32, 152:55] Could not resolve model name FHIR
Error:[152:1, 152:69] org.hl7.elm.r1.Null cannot be cast to org.hl7.elm.r1.TypeSpecifier
Error:[153:32, 153:59] Could not resolve model name FHIR
Error:[153:1, 153:73] org.hl7.elm.r1.Null cannot be cast to org.hl7.elm.r1.TypeSpecifier
Error:[154:32, 154:56] Could not resolve model name FHIR
Error:[154:1, 154:70] org.hl7.elm.r1.Null cannot be cast to org.hl7.elm.r1.TypeSpecifier
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

Thread 950 (2020-09-30):

Json formatted CQL fails to deserialize via JsonCqlLibraryReader

csandersdev, 2020-09-30:
I am running on latest from the develop branch. When I try to use JsonCqlLibraryReader to deserialize ELM in JSON format, I get  the exception below. Looking at the generated JSON and comparing it to the sample JSON-formatted CQL in the test resources, there is clearly a difference of missing "type" properties in several places in the newly generated JSON.

Attached is a test patch that will reproduce the problem.
[test-patch.txt](https://github.com/DBCG/cql_engine/files/5305871/test-patch.txt)

```
com.fasterxml.jackson.databind.exc.InvalidTypeIdException: Missing type id when trying to resolve subtype of [simple type, class org.cqframework.cql.elm.execution.Library]: missing type id property 'type' (for POJO property 'library')
 at [Source: (StringReader); line: 40, column: 4] (through reference chain: org.opencds.cqf.cql.engine.elm.execution.LibraryWrapper["library"])
	at com.fasterxml.jackson.databind.exc.InvalidTypeIdException.from(InvalidTypeIdException.java:43)
	at com.fasterxml.jackson.databind.DeserializationContext.missingTypeIdException(DeserializationContext.java:1768)
	at com.fasterxml.jackson.databind.DeserializationContext.handleMissingTypeId(DeserializationContext.java:1297)
	at com.fasterxml.jackson.databind.jsontype.impl.TypeDeserializerBase._handleMissingTypeId(TypeDeserializerBase.java:299)
	at com.fasterxml.jackson.databind.jsontype.impl.AsPropertyTypeDeserializer._deserializeTypedUsingDefaultImpl(AsPropertyTypeDeserializer.java:164)
	at com.fasterxml.jackson.databind.jsontype.impl.AsPropertyTypeDeserializer.deserializeTypedFromObject(AsPropertyTypeDeserializer.java:105)
	at com.fasterxml.jackson.databind.deser.BeanDeserializerBase.deserializeWithType(BeanDeserializerBase.java:1178)
	at com.fasterxml.jackson.databind.deser.impl.MethodProperty.deserializeAndSet(MethodProperty.java:138)
	at com.fasterxml.jackson.databind.deser.BeanDeserializer.vanillaDeserialize(BeanDeserializer.java:288)
	at com.fasterxml.jackson.databind.deser.BeanDeserializer.deserialize(BeanDeserializer.java:151)
	at com.fasterxml.jackson.databind.ObjectMapper._readMapAndClose(ObjectMapper.java:4202)
	at com.fasterxml.jackson.databind.ObjectMapper.readValue(ObjectMapper.java:3218)
	at org.opencds.cqf.cql.engine.execution.JsonCqlLibraryReader.read(JsonCqlLibraryReader.java:27)
	at org.opencds.cqf.cql.engine.execution.CqlEngineTests.readJson(CqlEngineTests.java:74)
	at org.opencds.cqf.cql.engine.execution.CqlEngineTests.toLibrary(CqlEngineTests.java:62)
	at org.opencds.cqf.cql.engine.execution.CqlEngineTests.toLibrary(CqlEngineTests.java:53)
	at org.opencds.cqf.cql.engine.execution.CqlEngineTests.test_simpleLibraryJson_returnsResult(CqlEngineTests.java:119)
	at sun.reflect.NativeMethodAccessorImpl.invoke0(Native Method)
	at sun.reflect.NativeMethodAccessorImpl.invoke(NativeMethodAccessorImpl.java:95)
	at sun.reflect.DelegatingMethodAccessorImpl.invoke(DelegatingMethodAccessorImpl.java:55)
	at java.lang.reflect.Method.invoke(Method.java:508)
	at org.junit.runners.model.FrameworkMethod$1.runReflectiveCall(FrameworkMethod.java:50)
	at org.junit.internal.runners.model.ReflectiveCallable.run(ReflectiveCallable.java:12)
	at org.junit.runners.model.FrameworkMethod.invokeExplosively(FrameworkMethod.java:47)
	at org.junit.internal.runners.statements.InvokeMethod.evaluate(InvokeMethod.java:17)
	at org.junit.runners.ParentRunner.runLeaf(ParentRunner.java:325)
	at org.junit.runners.BlockJUnit4ClassRunner.runChild(BlockJUnit4ClassRunner.java:78)
	at org.junit.runners.BlockJUnit4ClassRunner.runChild(BlockJUnit4ClassRunner.java:57)
	at org.junit.runners.ParentRunner$3.run(ParentRunner.java:290)
	at org.junit.runners.ParentRunner$1.schedule(ParentRunner.java:71)
	at org.junit.runners.ParentRunner.runChildren(ParentRunner.java:288)
	at org.junit.runners.ParentRunner.access$000(ParentRunner.java:58)
	at org.junit.runners.ParentRunner$2.evaluate(ParentRunner.java:268)
	at org.junit.runners.ParentRunner.run(ParentRunner.java:363)
	at org.eclipse.jdt.internal.junit4.runner.JUnit4TestReference.run(JUnit4TestReference.java:89)
	at org.eclipse.jdt.internal.junit.runner.TestExecution.run(TestExecution.java:41)
	at org.eclipse.jdt.internal.junit.runner.RemoteTestRunner.runTests(RemoteTestRunner.java:542)
	at org.eclipse.jdt.internal.junit.runner.RemoteTestRunner.runTests(RemoteTestRunner.java:770)
	at org.eclipse.jdt.internal.junit.runner.RemoteTestRunner.run(RemoteTestRunner.java:464)
	at org.eclipse.jdt.internal.junit.runner.RemoteTestRunner.main(RemoteTestRunner.java:210)
```

Thread 577 (2020-10-19):

Support multi-cardinality terminology targets

brynrhodes, 2020-10-19:
When the cardinality of the code path for a terminology target is plural, the translator cannot resolve the membership operation:

```
library Test

using FHIR version '4.0.1'

include FHIRHelpers version '4.0.1'

codesystem "CONDCATEGORY": 'http://terminology.hl7.org/CodeSystem/condition-category'
codesystem "US-CONDCATEGORY": 'http://hl7.org/fhir/us/core/CodeSystem/condition-category'

code "Condition Problem List Item code": 'problem-list-item' from "CONDCATEGORY" display 'Problem List Item'
code "Condition Encounter Diagnosis code": 'encounter-diagnosis' from "CONDCATEGORY" display 'Encounter Diagnosis'
code "Condition Health Concern code": 'health-concern' from "US-CONDCATEGORY" display 'health concern'

concept "Condition Problem List Item":
  { "Condition Problem List Item code" } display 'Problem List Item'
concept "Condition Encounter Diagnosis":
  { "Condition Encounter Diagnosis code" } display 'Encounter Diagnosis'
concept "Condition Health Concern":
  { "Condition Health Concern code" } display 'Health Concern'

context Patient

define ProblemListItems:
  [Condition: category ~ "Condition Problem List Item"]

define EncounterDiagnoses:
  [Condition: category ~ "Condition Encounter Diagnosis"]

define HealthConcerns:
  [Condition: category ~ "Condition Health Concern"]
```

This is potentially a more general issue, because you should maybe be able to say:

```
[Condition] C where C.category ~ "Condition Problem List Item"
```

brynrhodes, 2021-03-02:
Multi-cardinality terminology targets work with value sets and code systems because the terminology membership operator is specifically overridden to support List-valued arguments on the left-hand side of the operator:

```
define ConditionCategoryCodes:
  [Condition: category in "Condition Category Codes"]

define ConditionCategoryCodesLongHand:
  [Condition] C
    where C.category in "Condition Category Codes"
```

However, the analogous overloads don't exist for the singular case (i.e. when the terminology expression is a direct-reference code or concept)

```
define ProblemListItems:
  [Condition: category ~ "Condition Problem List Item"] // warning: terminology target...
```

The analogous long-hand here is "contains", and that would require the introduction of a new terminology comparator in the retrieve. As a result, this need to be raised as a CQL issue to add the ability to use "contains" as a terminology comparator.

```
define ProblemListItemsLongHand:
  [Condition] C
    where C.category contains "Condition Problem List Item"
```

Logged a CQL tracker here: https://jira.hl7.org/browse/FHIR-31392

brynrhodes, 2021-03-23:
Addressed in the 1.5.2 release

Closed 2021-03-23.

Thread 584 (2020-11-05):

USCore modle info missing target, targetUrl, targetVersion in latest commit

msargentibm, 2020-11-05:
The USCore model info has dropped some information in the latest commit. At the metadata level, `targetUrl` and `targetVersion` are no longer present in the model info. https://github.com/cqframework/clinical_quality_language/commit/0fa511996c760d8b754357f81c8abb4d498cf4a1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.

Likewise, some of the resources dropped their `target` attribute in this commit. https://github.com/cqframework/clinical_quality_language/commit/0fa511996c760d8b754357f81c8abb4d498cf4a1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. The attribute previously contained the mapping information needed to identify the base FHIR type (ex: `target="Patient"` for `PatientProfile`).

It seems that without these fields, CQL to ELM translation is producing  an ELM file that will not work with the CQL engine. Example CQL:
```
library "Test" version '1.0.0'
using "USCore" version '3.1.0'

context Patient
```

Resulting ELM:
```
<?xml version="1.0" encoding="UTF-8"?>
<library xmlns="urn:hl7-org:elm:r1" xmlns:t="urn:hl7-org:elm-types:r1" xmlns:xsi="http://www.w3.org/2001/XMLSchema-instance" xmlns:xsd="http://www.w3.org/2001/XMLSchema" xmlns:fhir="http://hl7.org/fhir" xmlns:qdm43="urn:healthit-go
v:qdm:v4_3" xmlns:qdm53="urn:healthit-gov:qdm:v5_3" xmlns:a="urn:hl7-org:cql-annotations:r1">
   <annotation translatorOptions="" xsi:type="a:CqlToElmInfo"/>
   <identifier id="Test" version="1.0.0"/>
   <schemaIdentifier id="urn:hl7-org:elm" version="r1"/>
   <usings>
      <def localIdentifier="System" uri="urn:hl7-org:elm-types:r1"/>
      <def localIdentifier="USCore" uri="http://hl7.org/fhir/us/core" version="3.1.0"/>
   </usings>
   <contexts>
      <def name="Patient"/>
   </contexts>
   <statements>
      <def name="Patient" context="Patient">
         <expression xsi:type="SingletonFrom">
            <operand xmlns:ns0="http://hl7.org/fhir/us/core" dataType="ns0:PatientProfile" templateId="http://hl7.org/fhir/us/core/StructureDefinition/us-core-patient" xsi:type="Retrieve"/>
         </expression>
      </def>
   </statements>
</library>
```

The ELM still contains `PatientProfile` for the `dataType` and has no mapping back to the base FHIR spec. This causes the CQL engine to break with this error: `ca.uhn.fhir.parser.DataFormatException: Unknown resource name "PatientProfile" (this name is not known in FHIR version "R4")`

With  the previous version of model info for USCore, the ELM instead was mapped back  to base FHIR (the USCore uri was the base FHIR uri, and  the data type was for `Patient`). The resulting ELM worked with the CQL engine.

This has left me with a couple questions:
* Was removing `targetUrl`,  `targetVersion`, and `target` for resources intentional?
* If so, is there a way to make the CQL to ELM translation layer still know how to map back to the base FHIR spec?

Thanks!

brynrhodes, 2020-11-06:
Hi @msargentibm , apologies for the delays here. It wasn't so much an intentional removal as a level set to get the 1.5.0 initial release out. The "profile-informed ModelInfo" project is still in progress, and the USCore and QICore model infos are part of that. It's a high priority item we've been working on, and current state is that most things are working, but there are some cases where the slicing maps don't work as expected, and that results in the translator producing incorrect ELM.

msargentibm, 2020-11-09:
Thanks for the information. Is it safe to say that the intention is to eventually populate the  `target*` fields in the model info again? I'm happy to patch my local copy of model info for the time being to enable testing if that's part of the plan going forward. I mostly did not want to rely on fields if they were disappearing for good.

brynrhodes, 2020-11-09:
Hi @msargentibm , yes, definitely safe to say that's the proposed approach. The idea is that the ELM that is actually output from the translator will produce "pure FHIR" ELM (with profile references), so that systems can deal only with FHIR directly.

msargentibm, 2020-11-09:
Thanks! That takes care of my questions. I'll close this issue out.

Closed 2020-11-09.

Thread 598 (2021-02-09):

Add a "warning" when case-mismatching an identifier

brynrhodes, 2021-02-09:
If an identifier does not resolve but differs only in case from an existing identifier, include a mention of the case-insensitive match as a potential resolution.

JP: A failed resolution is a compile-time error, so the implementation of this story needs to enhance that error message. The current message doesn't include any message to potentially matching identifiers.

Luke:  The solution is to use conditional logic to select the error message depending on whether the identifiers were a case-insensitive match or didn't match at all.

lukedegruchy, 2023-11-01:
Related or potentially related tickets:

https://github.com/cqframework/clinical_quality_language/issues/426
https://github.com/cqframework/clinical_quality_language/issues/607
https://github.com/cqframework/clinical_quality_language/issues/721
https://github.com/cqframework/clinical_quality_language/issues/1254

Closed 2024-08-30.

Thread 605 (2021-03-02):

Request CQL translator to accept UCUM definite-duration units

pjiangtjc, 2021-03-02:
For below eCQM PC measures' logic, CQL uses calendar duration keywords “weeks”, while the data source QRDA I, uses UCOM unit “wk”.   It’s expected that the implementers follow CQL Specification Author's Guide and map the “weeks’ to “wk” to ensure proper eCQM evaluation.

/*
Define “Single Live Birth Encounter With Gestational Age 37 Weeks or More”
	“Single Live birth Encounter” SingleLiveBirthEncounter
		With [“Assessment, Performed”: “Gestational age—at birth”] GestationaAlge
			Such that GestationalAge.result >= 37 **weeks**
				And Global.”Earliestof” (GestationalAge.relevantDatetime, GestationalAge.relevantPerfiod ) during SingleLiveVirthEncounter.relevantPeriod
*/

We like to request if possible, for CQL Translator, which is used by data receivers in their QRDA processing engines, to accept these UCUM units in patient data.
This helps to avoid inconsistency and confusion among various QRDA data receivers. Also it helps measure developers to be able to use the CQL expressions and units in their CQL logics.

An ONC JIRA ticket is created: [https://oncprojectracking.healthit.gov/support/browse/CQLIT-260]

brynrhodes, 2021-03-02:
FYI, transferred this to the CQL translator as it is an issue with the translator capability, not the formatting and usage wiki.

brynrhodes, 2021-04-13:
This would effectively be a "Normalize calendar duration units where possible" option in the translator.

cmoesel, 2021-04-14:
Is this proposal to:
1. Convert _data_ to CQL units where necessary?  (e.g., `GestationalAge.result >= 37 weeks` becomes `ConvertQuantity(GestationalAge.result, 'week') >= 37 weeks`)
2. Convert CQL literal units where necessary? (e.g., `GestationalAge.result >= 37 weeks` becomes `GestationalAge.result >= 37 'wk'`)
3. Or either, as appropriate?

Thread 609 (2021-03-03):

QDM 5.6 Model Info Discrepancies with QDM 5.6 Model Documentation

JSRankins, 2021-03-03:
After comparing the current QDM 5.6 Model Info File in Master to the QDM 5.6 documentation on eCQI, the following discrepancies have been found:

- Location entity type needs to be added for Prescriber attribute for two datatypes:
  -	MedicationDischarge
  -	MedicationOrder
- DeviceApplied datatype is still in Model Info File, though it was removed from QDM 5.6
- Recorder attribute is still in Model Info File for Participation datatype, though it was removed from QDM 5.6
- Priority attribute is still in Model Info File for ProcedurePerformed datatype, though it was removed from QDM 5.6
- NegativeEncounterPerformed profile is still in Model Info File, but negationRationale was removed for "Encounter, Performed" datatype with QDM 5.6
- The negationRationale attribute is still available for the EncounterPerformed datatype in Model Info File, though it was removed with QDM 5.6.

brynrhodes, 2021-03-23:
Addressed in the 1.5.2 release

Closed 2021-03-23.

Thread 616 (2021-03-30):

Translator is not validating case-sensitivity of UCUM units

brynrhodes, 2021-03-30:
The expression 5 'G/DL' should give an invalid unit, but doesn't

brynrhodes, 2021-12-11:
Included in 1.5.5 Release

Closed 2021-12-11.

Thread 620 (2021-04-05):

CQL translator fails to compile "interval1 begins interval2"

csandersdev, 2021-04-05:
Table 2-P under <a href="https://cql.hl7.org/02-authorsguide.html#comparing-intervals">5.5.2 Comparing Intervals</a> in the CQL author's guide says that CQL authors should be able to write an ``interval1 begins interval2`` comparison. When we try this in the sample below, it fails to compile. I think this is because the translator expects "starts" instead of "begins". This is probably just a documentation issue in the author's guide, but I'm calling it out here in case the author's guide is correct and the translator is wrong.

```cql
 library "IntervalBeginsInterval" version '1.0.0'

 define LHS:
 	Interval[@2020-07-04T12:00:00.000-05:00, @2021-07-04T12:00:00.000-05:00]

 define RHS:
 	Interval[@2020-07-04T12:00:00.000-05:00, @2022-07-04T12:00:00.000-05:00]

 define "LHS Begins RHS":
 	LHS begins RHS
```

brynrhodes, 2021-04-13:
Hi @csandersdev , yes, this is an error in that diagram in the documentation, the grammar uses `starts` (it used to use `begins` when that diagram was actually created way back before the first ballot). So this is an issue with the specification. I'll log a tracker for it.

brynrhodes, 2021-04-13:
Logged as [FHIR-31883](https://jira.hl7.org/browse/FHIR-31883)

Closed 2021-04-13.

Thread 624 (2021-04-09):

Expose cacheLibrary method on LibraryManager

brynrhodes, 2021-04-09:
The translator does not cache the results of translating the current library to the LibraryManager. For downstream usage, this results in re-translation of the primary library. Expose a cache method to enable downstream usage to avoid the additional translation step.

brynrhodes, 2021-04-19:
Addressed in 1.5.3 release

Closed 2021-04-19.

Thread 640 (2021-05-10):

Support JSON as a serialization format for ModelInfo

brynrhodes, 2021-05-10:
The translator currently only supports XML deserialization of model info, which means there is not a good story for deserialization of model info files in the Android space, which effectively prevents the translator from being used in an Android environment.

fredhersch, 2022-01-21:
@brynrhodes Is this still open? Or now resolved?

brynrhodes, 2022-05-02:
Hi @vitorpamplona , we can't abandon it but we can restructure the dependencies, that's the next step here, to separate out the "hardcoded" nature of the modelinfo loading and make sure we can do it dynamically. One easy thing we can try (and I just haven't yet) is to see if the Jackson library actually can deserialize the XML modelinfo. Modelinfo is a much simpler structure, so it may just work (The reason we can't use the ELM XML is because it has the JAXB dependencies, not because we can't deserialize XML at all, right?)

vitorpamplona, 2022-05-03:
I am happy to report that it largely works. But I am having a hard time figuring out what is wrong with the USCore and QICore packages.

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

vitorpamplona, 2022-05-04:
All good! PR #745 is ready for a review.

Noticed that:
1 - There were types on the modelinfo files: `primaryCocdePath` and `primaryCOdePath` (Jackson XML is case sensitive)
2 - There is a bug that requires `xsi:type` to be the first property on XML elements with polymorphic nested objects.

Closed 2022-05-20.

Thread 908 (2021-06-14):

DebugResultEntry currently doesn't do anything

csandersdev, 2021-06-14:

Closed 2021-06-18.

Thread 645 (2021-06-16):

Error attempting to use today in a coalesce in a sort

brynrhodes, 2021-06-16:
The following Library results in an error attempting to resolve the Today() function:

```
library TodayIssue

using FHIR version '4.0.1'

include FHIRHelpers version '4.0.001'

context Patient

define "Most recent physical home address":
  First(
    Patient.address A
      where A.use = 'home'
        and A.type = 'physical'
      sort by Coalesce(end of period, Today()) desc
  )
```

dsesac, 2022-08-15:
Replaced include FHIRHelpers version '4.0.001' with include FHIRHelpers version '4.0.1' called FHIRHelpers
and file validates without error.
Need further info..

Thread 647 (2021-06-22):

Enable alternate resolution of well-known namespaces

brynrhodes, 2021-06-22:
Well-known namespaces and libraries enable the loading of libraries that are embedded as resources within the translator. However, in cases where a library that has the same name as a well-known library is resolvable in the current context, the well-known behavior overrides the dependency in the current context. This needs to be corrected to allow for cases where the current context has its own copy of well-known content and needs to resolve to the local content.

brynrhodes, 2021-07-30:
Included in 1.5.4-SNAPSHOT

Closed 2021-07-30.

Thread 905 (2021-07-01):

Add cache for FhirModelResolver type-to-class resolution

msargentibm, 2021-07-01:
I recently hit an issue when evaluating CQL where the engine spent multiple hours resolving FHIR types with `R4FhirModelResolver.resolveType()`. I was able to patch my code locally to cache the results of `resolveType()`, and then the same CQL evaluated in about 20 seconds. This issue is to request the addition caching for the method `public Class<?> resolveType(String typeName)` in either the `R4FhirModelResolver` or the base `FhirModelResolver` class.

I noticed the FhirModelResolver class has a TODO to add caching for some of its operations:
https://github.com/DBCG/cql_engine/blob/master/engine.fhir/src/main/java/org/opencds/cqf/cql/engine/fhir/model/FhirModelResolver.java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.

I'd be happy to try PR a change, but I was wondering if someone would be able to offer some guidance into the sort of caching the team had in mind for this situation. Is there a caching strategy that is typically used in this project (something like Spring/JCache), or would a simple Map suffice in this case?

Closed 2021-07-13.

Thread 665 (2021-09-07):

FHIR R5 Support

JPercival, 2021-09-07:
Currently, the translator doesn't work for FHIR R5 (version 4.6.0)

```cql
using FHIR '4.6.0'

include FHIRHelpers version '4.6.0'
```

To add this support ModelInfos and FHIRHelpers need to be created for 4.6

Thread 698 (2021-12-03):

Address commons.lang3.text issues

brynrhodes, 2021-12-03:
Current build has several warnings related to commons.lang3.text being deprecated. Address these warnings by using whatever is recommended to replace the deprecated functions.
Careful with dependencies here though, verify that we don't switch to something that wouldn't be supported in Android (including relatively old versions of Android), like <= 7.0.

Thread 699 (2021-12-03):

Don't allow errors generating ELM requirements to prevent library packaging

brynrhodes, 2021-12-03:
Currently, errors generating ELM requirements prevent library packaging. If the ELM translated successfully, errors encountered attempting to generate the ELM data requirements should only result in additional warning/error messages being added to the ELM output, it shouldn't prevent library packaging overall.

Thread 896 (2021-12-22):

ValueSetRef evaluator logic is incorrect

brynrhodes, 2021-12-22:
Current implementation of the ValueSetRef node returns a ValueSetDef, which subsequently results in errors because the engine doesn't know what a ValueSetDef is:

https://github.com/DBCG/cql_engine/blob/master/engine/src/main/java/org/opencds/cqf/cql/engine/elm/execution/ValueSetRefEvaluator.java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

The implementation should be using the terminology provider to expand the ValueSet and return the list of codes.

Closed 2022-01-07.

Thread 710 (2022-01-03):

Add support for identifying context paths in output ELM

brynrhodes, 2022-01-03:
Right now, the translator leaves context determination entirely up to the implementation, so when something like the following is evaluated in a `Patient` context:

```
define Allergies: [AllergyIntolerance]
```

it's not clear whether that should include allergies that the patient `reported` as the "compartment" definition in FHIR seems to imply.
To remove this ambiguity, the translator should make use of the new `context`, `contextProperty` and `contextSearch` elements of the Retrieve to make the context relationship explicit for resources that are not the "context" resource.

To ensure the translator can always make an unambiguous determination, this should include introducing a `primaryContextPath` attribute in the model info to allow the "primary" relationship to be specified as configuration in the model info.

vitorpamplona, 2022-09-29:
The `primaryContextPath` idea is quite limiting.

How would you do retrieves for different behaviors? This is a need.

Something like:

```
context Patient

define AllergiesOfPatient: [AllergyIntolerance] // uses .patient
define AllergiesRecordedByPatient: [AllergyIntolerance] // uses .recorder
define AllergiesAssertedByPatient: [AllergyIntolerance] // uses .asserter
```

brynrhodes, 2022-10-03:
This is currently handled in CQL with related context retrieves: https://cql.hl7.org/03-developersguide.html#related-context-retrieves

Thread 891 (2022-01-18):

Could not resolve function call

deepkumar-1, 2022-01-18:
Execution of this below CQL against a patient resulted in "Could not resolve call to operator" error

=========================================
library L3MeasureShortName version '1'
using FHIR version '4.0.1'
include FHIRHelpers version '4.0.1' called FHIRHelpers
valueset "Acute Bronchitis": '37139'
valueset "ED": '37802'
valueset "Observation": '37804'
valueset "Online Assessments": '37807'
valueset "Outpatient": '37805'
valueset "Telephone Visits": '37806'

context Patient

define Test: "VS Cast Function"("ED")

define function "VS Cast Function"(VSet System.ValueSet):
  (
    ( cast { "VSet", 1 }[0] as Tuple {  codes List<System.Code>  }).codes
  )
=========================================

Stack-trace
------------

2022-01-18 08:51:02,016 [http-nio-8080-exec-9] - JSF - 9709ef46-a0ee-4047-9f0e-49a88ee1bf65 - ERROR CQLExecutionManager:414 - Caught a runtime exception during rule execution. Details: org.opencds.cqf.cql.engine.exception.CqlException: Could not resolve call to operator 'VS Cast Function(java.util.List)' in library 'L3MeasureShortName'.
	at org.opencds.cqf.cql.engine.execution.Context.resolveFunctionRef(Context.java:610)
	at org.opencds.cqf.cql.engine.elm.execution.FunctionRefEvaluator.internalEvaluate(FunctionRefEvaluator.java:23)
	at org.opencds.cqf.cql.engine.elm.execution.Executable.evaluate(Executable.java:18)
	at com.abc.common.cql.CQLExecutionManager.getResultsBuildResponse(CQLExecutionManager.java:381)

Thread 726 (2022-02-16):

Library names with dashes

brynrhodes, 2022-02-16:
CQL supports quoted library identifiers that include dashes, however when using this feature, the translator failed to include the referenced library correctly.

See this Zulip thread for a reproduction:
https://chat.fhir.org/#narrow/stream/179220-cql/topic/CQL.20Translator.201.2E5.2E6.20Release

Thread 727 (2022-02-17):

Incorrect data requirements analysis

brynrhodes, 2022-02-17:
Some data requirements analysis of expressions involving coalesce with date elements is incorrect, resulting in an error that `toFhirValue` is not implemented for specific expression types when extracting data requirements for the measure.

Specific test cases that produce these issues:

```cql
library TestCase10

using FHIR version '4.0.1'

include FHIRHelpers version '4.0.1'

valueset "ESRD Diagnosis": 'http://fakeurl.com/ersd-diagnosis'

context Patient

/*
10a. Date Filter
Stated DataRequirement: ERSD Observations
type: Observation
codeFilter: { path:  code, valueSet:  'http://fakeurl.com/ersd-diagnosis' }
dateFilter: { path: issued, value: Interval[@2022-02-15, null] }
*/

define "ESRD Observations":
  [Observation: "ESRD Diagnosis"] O
    where O.issued same day or after @2022-02-15

/*
10b. Date filter with coalesce
type: Observation
codeFilter: { path: code, valueSet: 'http://fakeurl.com/ersd-diagnosis' }
dateFilter: { path: effective, value: Interval[@2022-02-15, null] }

type: Observation
codeFilter: { path: code, valueSet: 'http://fakeurl.com/ersd-diagnosis' }
dateFilter: { path: effective, value: null } // Not sure we can say this, or if it's even useful to do so...
dateFilter: { path: issued, value: Interval[@2022-02-15, null] }
 */

define "ESRD Observations":
  [Observation: "ESRD Diagnosis"] O
    where Coalesce(O.effective, O.issued) same day or after @2022-02-15

/*
TODO: Handle coalesce as a short-hand for disjunction:
// This is short-hand for:
define "ESRD Observations":
  [Observation: "ESRD Diagnosis"] O
    where O.effective same day or after @2022-02-15
      or (O.effective is null and O.issued same day or after @2022-02-15)

*/

/*
10c. Date Filter on choice
Stated DataRequirement: ERSD Observations
type: Observation
codeFilter: { path:  code, valueSet:  'http://fakeurl.com/ersd-diagnosis' }
dateFilter: { path: effective, value: Interval[@2022-02-15, null] }

NOTE: property reference is a case...
*/

define "ESRD Observations":
  [Observation: "ESRD Diagnosis"] O
    where O.effective same day or after @2022-02-15

/*
define "ESRD Observations":
  [Observation: "ESRD Diagnosis"] O
    where O.effective as dateTime same day or after @2022-02-15
  union
  [Observation: "ESRD Diagnosis"] O
    where O.effective as instant same day or after @2022-02-15
 */
```

brynrhodes, 2022-04-22:
Included in v1.5.7

Closed 2022-04-22.

Thread 729 (2022-02-24):

Improve selector capability with FHIR

brynrhodes, 2022-02-24:
Consider the following expression:

```cql
define TestQuestionnaireResponse:
  QuestionnaireResponse {
    "id": id('phq-9-questionnaireresponse'),
    "questionnaire": canonical('http://somewhere.org/fhir/uv/mycontentig/Questionnaire/phq-9-questionnaire'),
    "status": QuestionnaireResponseStatus('completed'),
    "subject": Reference {
      "reference": string('Patient/example')
    },
    "authored": dateTime(@2021-09-13T16:29:00-07:00),
    "item": {
      FHIR.QuestionnaireResponse.Item {
        "linkId": string('LittleInterest'),
        "text": string('Little interest or pleasure in doing things'),
        "answer": {
          FHIR.QuestionnaireResponse.Item.Answer {
            "value": Coding {
              "system": uri('http://loinc.org'),
              "code": code('LA6568-5'),
              "display": string('Not at all')
            }
          }
        }
      },
      FHIR.QuestionnaireResponse.Item {
        "linkId": string('TotalScore'),
        "text": string('Total score'),
        "answer": {
          FHIR.QuestionnaireResponse.Item.Answer {
            "value": integer(3)
          }
        }
      }
    }
  }
```

1. The helper functions should not be required, determine why the defined implicit conversions are not working as expected
2. Tuple compatibility rules should allow for the components to be constructed as anonymous tuples, rather than requiring the sub-component type name

brynrhodes, 2022-02-24:
Full library for reference:
```cql
library QuestionnaireResponse

using FHIR version '4.0.1'

include FHIRHelpers version '4.0.1'

context Patient

define QuestionnaireResponse:
  QuestionnaireResponse {
    "id": id('phq-9-questionnaireresponse'),
    "questionnaire": canonical('http://somewhere.org/fhir/uv/mycontentig/Questionnaire/phq-9-questionnaire'),
    "status": QuestionnaireResponseStatus('completed'),
    "subject": Reference {
      "reference": string('Patient/example')
    },
    "authored": dateTime(@2021-09-13T16:29:00-07:00),
    "item": {
      FHIR.QuestionnaireResponse.Item {
        "linkId": string('LittleInterest'),
        "text": string('Little interest or pleasure in doing things'),
        "answer": {
          FHIR.QuestionnaireResponse.Item.Answer {
            "value": Coding {
              "system": uri('http://loinc.org'),
              "code": code('LA6568-5'),
              "display": string('Not at all')
            }
          }
        }
      },
      FHIR.QuestionnaireResponse.Item {
        "linkId": string('FeelingDown'),
        "text": string('Feeling down, depressed, or hopeless'),
        "answer": {
          FHIR.QuestionnaireResponse.Item.Answer {
            "value": Coding {
              "system": uri('http://loinc.org'),
              "code": code('LA6569-3'),
              "display": string('Several days')
            }
          }
        }
      },
      FHIR.QuestionnaireResponse.Item {
        "linkId": string('TroubleSleeping'),
        "text": string('Trouble falling or staying asleep'),
        "answer": {
          FHIR.QuestionnaireResponse.Item.Answer {
            "value": Coding {
              "system": uri('http://loinc.org'),
              "code": code('LA6569-3'),
              "display": string('Several days')
            }
          }
        }
      },
      FHIR.QuestionnaireResponse.Item {
        "linkId": string('FeelingTired'),
        "text": string('Feeling tired or having little energy'),
        "answer": {
          FHIR.QuestionnaireResponse.Item.Answer {
            "value": Coding {
              "system": uri('http://loinc.org'),
              "code": code('LA6569-3'),
              "display": string('Several days')
            }
          }
        }
      },
      FHIR.QuestionnaireResponse.Item {
        "linkId": string('BadAppetite'),
        "text": string('Poor appetite or overeating'),
        "answer": {
          FHIR.QuestionnaireResponse.Item.Answer {
            "value": Coding {
              "system": uri('http://loinc.org'),
              "code": code('LA6568-5'),
              "display": string('Not at all')
            }
          }
        }
      },
      FHIR.QuestionnaireResponse.Item {
        "linkId": string('FeelingBadAboutSelf'),
        "text": string('Feeling bad about yourself - or that you are a failure or have let yourself or your family down'),
        "answer": {
          FHIR.QuestionnaireResponse.Item.Answer {
            "value": Coding {
              "system": uri('http://loinc.org'),
              "code": code('LA6568-5'),
              "display": string('Not at all')
            }
          }
        }
      },
      FHIR.QuestionnaireResponse.Item {
        "linkId": string('TroubleConcentrating'),
        "text": string('Trouble concentrating on things, such as reading the newspaper or watching television'),
        "answer": {
          FHIR.QuestionnaireResponse.Item.Answer {
            "value": Coding {
              "system": uri('http://loinc.org'),
              "code": code('LA6568-5'),
              "display": string('Not at all')
            }
          }
        }
      },
      FHIR.QuestionnaireResponse.Item {
        "linkId": string('MovingSpeaking'),
        "text": string('Moving or speaking so slowly that other people could have noticed. Or the opposite - being so fidgety or restless that you have been moving around a lot more than usual'),
        "answer": {
          FHIR.QuestionnaireResponse.Item.Answer {
            "value": Coding {
              "system": uri('http://loinc.org'),
              "code": code('LA6568-5'),
              "display": string('Not at all')
            }
          }
        }
      },
      FHIR.QuestionnaireResponse.Item {
        "linkId": string('TotalScore'),
        "text": string('Total score'),
        "answer": {
          FHIR.QuestionnaireResponse.Item.Answer {
            "value": integer(3)
          }
        }
      },
      FHIR.QuestionnaireResponse.Item {
        "linkId": string('Difficulty'),
        "text": string('If you checked off any problems, how difficult have these problems made it for you to do your work, take care of things at home, or get along with other people'),
        "answer": {
          FHIR.QuestionnaireResponse.Item.Answer {
            "value": Coding {
              "system": uri('http://loinc.org'),
              "code": code('LA6568-5'),
              "display": string('Not at all')
            }
          }
        }
      }
    }
  }

define function id(value System.String):
  id { value: value }

define function canonical(value System.String):
  canonical { value: value }

define function string(value System.String):
  string { value: value }

define function uri(value System.String):
  uri { value: value }

define function code(value System.String):
  code { value: value }

define function integer(value System.Integer):
  integer { value: value }

define function QuestionnaireResponseStatus(value System.String):
  QuestionnaireResponseStatus { value: value }

define function dateTime(value System.DateTime):
  dateTime { value: value }

```

Thread 730 (2022-03-04):

Investigate JSONSchema for ELM

brynrhodes, 2022-03-04:
Source of truth for ELM is currently expressed as a set of XSDs. Can we use those to produce JSON Schema files for ELM?

See the discussion [here](https://github.com/cqframework/cql-execution/issues/266) for more.

Thread 732 (2022-03-14):

Correct result type of .extension() functions in FHIRHelpers

brynrhodes, 2022-03-14:
.extension functions in FHIRHelpers currently specify return type of List<Element>, but could be the more specific type List<Extension>

brynrhodes, 2022-04-22:
Included in v1.5.7

Closed 2022-04-22.

Thread 887 (2022-04-01):

Union of lists with a null is incorrect

brynrhodes, 2022-04-01:
The following expression:
```
define Test: null union { 4, 5 } // Should be  // { 4, 5 }
```
Currently evaluates to `null`, but should evaluate to `{ 4, 5}`

Correct the issue and a test to cover the case.

Note carefully that union with intervals _does_ propagate nulls:
```
define Test: null union Interval[4, 5] // Should be null
```
Ensure that there is a test case covering this as well and that this fix does not break that test.

Closed 2023-08-08.

Thread 746 (2022-05-04):

Extract CqlCompiler from CqlTranslator

vitorpamplona, 2022-05-04:
The idea is simple: CQL to ELM compilation should be a separate class from all the other formats (JSON/JXSON/XML/COFFEE) available in the translator. The translator then should be moved out of the current module, taking the dependencies of import and export as well as the utility `main` function with it.

In that way, the Android app can declare a dependency on [cql-to-elm](https://mvnrepository.com/artifact/info.cqframework/cql-to-elm/) without having to manually remove the JAXB/Moxy components.

Pros:
- Simpler dependency chain
- `CqlTranslator` will use a `CqlCompiler` internally. Most, if not all, of the CQL Translator interface and way of use will remain the same.

Cons:
- Good amount of work to rename/reorganize current tests between Compilation or Translation.
- The widespread renaming of classes, enums, and exceptions might require users to have to manually upgrade their code to the newest versions.

vitorpamplona, 2022-05-06:
I have a branch ready to go: https://github.com/Path-Check/clinical_quality_language/tree/compiler-from-translator-separation

Closed 2022-06-02.

Thread 751 (2022-05-23):

Dynamic model info loading

brynrhodes, 2022-05-23:
ModelInfo is currently loaded statically, refactor this to support dynamic loading using the ServiceLoader pattern.

vitorpamplona, 2022-05-27:
Also, we need a solution for [this](https://github.com/FasterXML/jackson-dataformat-xml/issues/525) before loading dynamic model infos.

JPercival, 2022-06-09:
Also needed for profile-informed authoring. This would allow authors of an IG to define StructureDefinitions to represent the specific types and properties they need for their use case.

brynrhodes, 2022-09-08:
Included in v2.0.0

Closed 2022-09-08.

Thread 878 (2022-05-27):

Fails to check the max of milliseconds

horsetriboulders, 2022-05-27:

Thread 756 (2022-06-13):

Allow same libraries with different versions to resolve

csenn, 2022-06-13:
Hey, thanks again for this library, it's been a great learning experience going through this source.

I am working on a project that uses namespaces. And in the case of:

```
library name_space_one.LibraryOne version 0.0.1

include cq_core.FHIRHelpers version '4.0.1' called FHIRHelpers
include name_space_two.LibraryTwo
```

Closed 2022-06-13.

Thread 758 (2022-06-13):

Allow same libraries with different versions to resolve

csenn, 2022-06-13:
Hey, thanks again for this library, it's been a great Java learning experience going through this source.

I am working on a project that uses namespaces. When trying to resolve different versions of the same library there is a conflict in the LibraryManager class. Here is an example:

```
// First Library
library name_space_one.LibraryOne version '0.0.1'
include name_space_two.LibraryTwo version '0.0.1'
include name_space_three.LibraryThree version '0.0.1'

// Second Library
library name_space_two.LibraryTwo version '0.0.1'
include name_space_three.LibraryThree version '1.1.1'

// Third Library
library name_space_three.LibraryThree version '0.0.1'
define "My Def": 1 + 2

// Third Library - Later Version
library name_space_three.LibraryThree version '1.1.1'
define "My Def": 11 + 22
```

The issue is that name_space_three.LibraryThree is included in 2 separate namespaces, but with different versions. Then if LibraryOne uses LibraryTwo, there is a run time error.

When dealing with a group of libraries in a single namespace, there probably should not be a case where two libraries use a different version of a library. But let's say there is a namespace that has some utility functions that many other libraries use. In that case it's possible that two namespaces will both use the same utility library, but different versions of it. And then if one of those libraries requires the other, there will be two different versions of the same library in the resolution stack.

[Here is a PR](https://github.com/cqframework/clinical_quality_language/pull/757/files) that seems to fix the issue in my wrapper around the CQL to ELM translation service. Does this solution make sense? Would this be useful to anyone else, or is this not a common use case?

JPercival, 2022-07-05:
Hi @csenn!

The CQL specification currently prohibits referencing more than one version of a given Library:

https://cql.hl7.org/03-developersguide.html#libraries-1

(the relevant text is near the end of that section)

Discussion about the CQL specification happens in HL7 FHIR Workgroups periodically, and on the FHIR Zulip in the `#cql` channel. Here's a link:

https://chat.fhir.org/#streams/179220/cql

Feel free to raise questions or suggest changes to the CQL spec on that channel.

csenn, 2022-07-05:
Hey @JPercival, there it is in the docs ha. I appreciate the pointer and the workgroups. I'll bring it up sometime, I wonder if it would be a useful feature to anyone else.

cmoesel, 2022-07-06:
I've actually said before that I think it would be a useful feature -- and one that seems like it could be fairly easily supported.  But... I think the primary question is if it's useful enough to justify the complication it might introduce for implementers.  Even if it seems technically easy to me (and my CQL implementations), maybe it isn't in some systems -- and there definitely is extra cognitive load in trying to mentally keep track of multiple versions of the same library in a single CQL entrypoint (or even callstack).

csenn, 2022-07-06:
Definitely makes sense @cmoesel. Our need mostly arises from the use of namespaces, where different namespaces have different owners and it would not make sense to force all CQL Libraries in the execution stack to point to the exact same version of say a utility library.

The choice to not deal with circular dependencies seems nice because even though possibly useful in some cases it could also end up very complicated. But since a CQL/ELM file is essentially already a specific CQL Library Version, multiple versions of the same library throughout the execution graph would probably not have huge issues with collision during resolution. Maybe if the versions had different Data Models such as FHIR 4.1 and FHIR 4.3 that could be a problem, but that's probably always an issue with any lib in the graph.

Another semi-related idea that could be interesting would be something like:

```
include external_space.PatientUtils version '^0.0.1'
```
where you use ^ or ~ to include the latest [patch or minor](https://blog.npmjs.org/post/115305091285/introducing-the-npm-semantic-version-calculator.html) versions of a lib. But that's probably a whole other beast.

Thread 759 (2022-06-15):

Support different serialization frameworks for ModelInfo and ELM

brynrhodes, 2022-06-15:
The current translator uses the JAXB serialization framework for reading ModelInfo as well as for writing ELM for both XML and JSON formats. It can also use the Jackson framework for writing ELM using the made-up JXSON format specifier.

There are known issues with the JAXB JSON format that prevent it from being deserialized by a Jackson reader. In addition, the JAXB serialization framework is not supported on Android.

To better support usage of the translator in different environments, refactor the usage of serialization frameworks to use a service provider pattern so that the dependencies of different serialization frameworks can be isolated to separate packages.

brynrhodes, 2022-09-08:
Included in v2.0.0

Closed 2022-09-08.

Thread 761 (2022-06-16):

Use of now() and today() in an interating context fails

brynrhodes, 2022-06-16:
The following Library:

```cql
library FHIRPathTest

using FHIR version '4.0.1'

include FHIRHelpers version '4.0.1'

context Patient

define Encounters: [Encounter]

define Test: Encounters.where(status = 'in-progress' and period.end <= today() - 72 hours)
```

Gives the error:

```
Could not resolve call to operator Today with signature (FHIR.Encounter).
```

The translator is trying to resolve the reference to `today()` as a fluent function with the current iteration scope as the this argument.

Thread 868 (2022-06-28):

Map ELM to Evaluator ELM without export/import into JSON/XML

vitorpamplona, 2022-06-28:
Currently, the engine uses a JSON mapper to compile CQL into evaluation-ready elm classes. All tests run a similar line to this:

```java
CqlTranslator translator = CqlTranslator.fromFile(cqlFile, .... );
JsonCqlLibraryReader.read(translator.toJxson());
```

We have to find a way to directly compile CQL into evaluation classes to improve performance and memory use.

JPercival, 2023-10-27:
No longer needed, engine and compiler share ELM graph

Closed 2023-10-27.

Thread 775 (2022-07-28):

CQL to ELM conversion main method not found

nehaghub, 2022-07-28:
Hi,

I have configured project and performed all required steps before CQL to ELM conversion.
When i am executing below command
**C:\Documents\HDE\clinical_quality_language-master\clinical_quality_language-master\Src\java> ./cql-to-elm/build/install/cql-to-elm/bin/cql-to-elm --format=JSON --input ../../../../cql-execution-master/examples/node/age.cql --output ../../../../cql-execution-master/customCQL**

I am getting this error

**Error: Main method not found in class org.cqframework.cql.cql2elm.CqlTranslator, please define the main method
as:
public static void main(String[] args)
or a JavaFX application class must extend javafx.application.Application**

Please let me know how to resolve this error .

Thank you.

brynrhodes, 2022-07-29:
Hi @nehaghub we moved the translator main class to the cql-to-elm-cli package, and it looks like we didn't reflect that change in the instructions here. I'll mark this as a bug and get that fixed. In the meantime, if you switch to the v15 branch, you should still be able to run following these instructions.

Apologies for the mixup, we're refactoring the translator so that it can be run on Android devices and we're having to move some things around.

nehaghub, 2022-08-01:
Thank you Brynrhodes for this useful information.

nehaghub, 2022-08-03:
Hi,
I run this using branch v15. It is converting cql to elm json format. But, with this json format we can't ingest in FHIR store.
Do you have any idea how can we do mapping from elm json to fhir json.

Thanks!

brynrhodes, 2022-09-08:
Apologies for the delay here, ELM json is represented in FHIR using the FHIR Library resource as the content element. For an example, see the CQF libraries here: http://fhir.org/guides/cqf/common/Library-FHIRCommon.html
The FHIR IG publisher will package CQL libraries this way using the binary-adjunct-files parameter, or you can use the CQF Tooling, as described in this walkthrough: https://github.com/cqframework/content-ig-walkthrough#content-ig-walkthrough

Closed 2022-09-08.

Thread 800 (2022-09-06):

Possible translator issue 1.5.8

DaisyWinters, 2022-09-06:
QI Core 4.1.1 profile  observation-heartrate (possibly others) not working correctingusing CQL plug-in and translator 1.5.8. Referencing this is returning all test case observations without filtering per loinc code

brynrhodes, 2022-10-03:
Included in 1.5.12 and 2.2.0

Closed 2022-10-03.

Thread 860 (2022-09-27):

Handle FhirBundleCursor underflow

brynrhodes, 2022-09-27:
The FhirBundleCursor may encounter cases where the first page of results is entirely filtered out by terminology or profile filtering. This case is currently not handled by the logic.

Thread 817 (2022-10-04):

Sort logic definitions by libraryName then name

bryantaustin13, 2022-10-04:
ESAC has a request to sort logic definitions by libraryName and then name so they appear more organized on the html page. It is not possible to do this with Liquid templates in the Publisher. A suggested solution would be:
In Src/java/elm-fhir/src/main/java/org.cqframework.cql.elm.requirements.fhir.DataRequirementsProcessor.java
    private List<Extension> extractLogicDefinitions(ElmRequirementsContext context, ElmRequirements requirements)
    ...
    return result;
Just before the return add a sort for extension.getExtensionByUrl(“libraryName”) and then sort by extension.getExtensionByUrl(“name”)

Thread 827 (2022-10-20):

Identifier containing escaped double-quotes does not resolve

sliver007, 2022-10-20:
References to a CQL expression identifier that contains escaped double quotes, will not resolve unless the definition is above/before the reference. Rearranging the CQL seems to be a possible workaround, but will not work in our particular case - we are using automation that generates the CQL as part of a transform from a proprietary representation.

# Reproduction

### Environment

###### Machine/OS
MacBook Pro M1 Max (ARM) chip.
macOS Monterey 12.0.1

###### IDE
Visual Studio Code
Version: 1.72.2

Extension: Clinical Quality Language (CQL)
version 0.4.0 'Preview'

This following code fails with the exception:
"org.opencds.cqf.cql.engine.exception.CqlException: Translation of library Test failed with the following message: Could not resolve identifier This is the "referenced" expression in the current library.
	at org.opencds.cqf.cql.evaluator.engine.execution.TranslatingLibraryLoader.translate(TranslatingLibraryLoader.java:134)..."

```
library Test

using FHIR version '4.0.1'

context Patient

define "Referencing Expression":
    "This is the \"referenced\" expression"

define "This is the \"referenced\" expression":
    'The reference resolved!'
```

The following code works (note the order of the two expressions is modified such that the referenced expression is defined before it is referenced:

```
library Test

using FHIR version '4.0.1'

context Patient

define "This is the \"referenced\" expression":
    'The reference resolved!'

define "Referencing Expression":
    "This is the \"referenced\" expression"
```

Closed 2023-10-31.

Thread 839 (2022-11-07):

[Help Wanted] Updating cql-translation-service to use 2.3.0 stack

mgramigna, 2022-11-07:
Hi @brynrhodes  @JPercival,

I am trying to update https://github.com/cqframework/cql-translation-service to use the latest 2.3.0 stack of cql-to-elm (and dependencies). I was specifically hoping for some insight on the new Model Info loading logic for 2.3.0 and where I might be going wrong in my approach.

 The changes that I made in the service can be viewed here: https://github.com/mgramigna/cql-translation-service/commit/ee28aa5bf807f0f9c1dcd9296bc06ba67f2c8b77. Specifically, [this line](https://github.com/mgramigna/cql-translation-service/commit/ee28aa5bf807f0f9c1dcd9296bc06ba67f2c8b77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) is what I want to inquire about, which I modeled after a [similar line in the cql-to-elm-cli project](https://github.com/cqframework/clinical_quality_language/blob/master/Src/java/cql-to-elm-cli/src/main/java/org/cqframework/cql/cql2elm/cli/CqlTranslator.java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).

Interestingly, I am seeing the following behavior:

* When running the translation service locally with `mvn exec:java`, I have no issues translating any CQL
* When building the jar with `mvn package` and running `java -jar target/cqlTranslationServer-2.3.0-jar-with-dependencies.jar`, I get a 400 Bad request with the following error:

```
{
  "libraryId": "Test",
  "startLine": 3,
  "startChar": 1,
  "endLine": 3,
  "endChar": 26,
  "message": "Could not resolve model info provider for model FHIR, version 4.0.1.",
  "errorType": "semantic",
  "errorSeverity": "error",
  "type": "CqlToElmError"
}
```

Here is the request used to replicate:

```
curl --request POST \
  --url 'http://localhost:8080/cql/translator?annotations=true&=' \
  --header 'Content-Type: application/cql' \
  --header 'accept: application/elm+json' \
  --data 'library Test

using FHIR version '\''4.0.1'\''

context Patient

define "Example":
  [Encounter]'
```

In addition, I found the following to be of interest:

``` Java
// WORKS LOCALLY
// DOES NOT WORK IN JAR
modelManager.getModelInfoLoader().registerModelInfoProvider(new DefaultModelInfoProvider(cql.toPath().getParent()));

// WORKS LOCALLY
// WORKS IN JAR
modelManager.getModelInfoLoader().registerModelInfoProvider(new FhirModelInfoProvider());
modelManager.getModelInfoLoader().registerModelInfoProvider(new QICoreModelInfoProvider());
// ...
```

If I load the `ModelInfoProvider`s manually, there are no issues at all. I wonder if there is something weird going on with file paths in the jar in the case of `DefaultModelInfoProvider`

NOTE: I am testing locally with Java 11, and the `.jar` is built targeting Java 11 as well

**The Question**:

Can you think of anything (perhaps related to file paths or something) with the default model info loading behavior that would potentially cause the translator to not be able to resolve the model info specifically in an "uber-jar" environment packaged with the `maven-assembly-plugin`? Am I missing something obvious?

Any thoughts would be appreciated!

JPercival, 2022-11-07:
The cql-translator was recently refactored to load ModelInfo providers at runtime via ServiceLoaders. This was done to make supporting loading different serializers dynamically on Android and other platforms. The short version is that you need to explicitly add dependencies to the packages that contain the ModelInfos you want to load, and to a serializaton library appropriate for your platform. The standard jaxb serializers out to work on the translation service. Something like this out to do the trick:

```
  <dependency>
            <groupId>info.cqframework</groupId>
            <artifactId>model-jaxb</artifactId>
    </dependency>
    <dependency>
        <groupId>info.cqframework</groupId>
        <artifactId>elm-jaxb</artifactId>
    </dependency>
    <dependency>
        <groupId>org.eclipse.persistence</groupId>
        <artifactId>org.eclipse.persistence.moxy</artifactId>
    </dependency>
     <dependency>
            <groupId>info.cqframework</groupId>
            <artifactId>quick</artifactId>
    </dependency>
 ```

JPercival, 2022-11-07:
For reference:

https://github.com/cqframework/clinical_quality_language/pull/770
https://github.com/cqframework/clinical_quality_language/issues/751

mgramigna, 2022-11-07:
🤦 Thanks, @JPercival! I was missing `org.eclipse.persistence.moxy`, which seemed to finally do the trick (I must've had it locally or something that didn't cause errors... no idea.

Closing

mgramigna, 2022-11-07:
Whoops, I initially closed because I thought this had fixed it, but I still had code locally that loaded the ModelInfo providers individually.

My `pom.xml` does have the above and allows it to work locally, it's just this dang `.jar` :/

What strategy does the dynamic ModelInfo loading take? Can you think of any reason the smart resolution wouldn't work in a mvn packaged jar?

mgramigna, 2023-05-01:
We resolved this over in https://github.com/cqframework/cql-translation-service/pull/34. Closing this as it is no longer an issue

Closed 2023-05-01.

Thread 840 (2022-11-08):

ExpandValueSet is called aggressively

EvanMachusak, 2022-11-08:
Consider this CQL:

```
define function "code in value set"(code Code, codes List<Code>):
    code in codes
```

When this function is called with a value set, e.g.:

```
valueset "Value set": 'url'
define "call it":
    "code in value set"(Errors."Unit mismatch", "Value set")
```

The operand in the ELM to the "code in value set" call is an ExpandValueSet.

The value set does not in fact need to be expanded, because this is valid:
```
define function "example"(code Code):
    code in "Value set"
```
The expression of "example" is an InValueSet.

Eagerly expanding the value set ahead of time introduces a performance penalty for this pattern.

It's possible to declare the parameter as a System.ValueSet which will avoid the ExpandValueSet operand, but because of the automatic expansion of value sets with this usage, these two signatures become ambiguous:

```
define "call it":
    "overload"(Errors."Unit mismatch", "Value set")

define function "overload"(code Code, codes List<Code>):
    code in codes

define function "overload"(code Code, valueSet System.ValueSet):
    code in valueSet
```

CQL-to-ELM picks the second overload in this case.  That's probably correct, but unintuitive.

We use the pattern of passing value sets to functions taking a List<Code> often.  It's a more flexible signature since it lets us pass either a value set or a manually constructed list of codes.

This is a significant performance penalty when run on the CQF ruler as prematurely expanding value sets which can be large (50k+ rows) results in linear checking of a list of codes instead of an optimized hash lookup of valueset membership.

brynrhodes, 2024-02-07:
I think it's important to call out here that `code in List<Code>` is a different operator than `code in ValueSet`, and that there's a really important distinction there. I wonder if it would make more sense to always use the `ValueSet` overload, and to support a way to convert a List<Code> to a ValueSet, so something like:

define fluent function toValueSet(List<Code>): ValueSet

Then you can 1) always use the optimization of lazy expansion, and 2) ensure that you're always using terminology semantics for the `in` operator.

brynrhodes, 2024-02-07:
Having said that, there is, by design, no way to construct a ValueSet with the codes that it contains. So let me ask the question, why not have first-class value set definitions for all the lists of codes you want to support?

EvanMachusak, 2024-03-08:
Because we can implicitly convert a `ValueSetRef` to a `List<Code>`, it makes `List<Code>` the more attractive choice for all APIs because we can either do:
```
define function Foo(codes List<Code>): ...`

define Bar: Foo("My ValueSet")
define Baz: Foo({ "DRC1", "DRC2" })
```
The issue I raised here is related to the fact that `ExpandValueSet` is an expensive operation.  Because there's an implicit conversion, the programmer isn't aware it's happening.

In our SDK, we implemented an implicit conversion between `ValueSet` to `List<Code>` in such a way that we preserve the fact that the source object is still a ValueSet, e.g. you can think of it like our ValueSet representation implements `IList<Code>` so we can use it anywhere that a `List<Code>` is expected.  We actually do this with composition and a facade, but it amounts to the same result.

This lets us implement the `In` operator for CQL's `List<Code>` more efficiently if that `List<Code>` is actually a ValueSet.

We currently don't implement `ExpandValueSet` the way I think it's intended to be (e.g., you reach out to the terminology server and ask for an expansion).  We don't support terminology servers in general at the moment, because HEDIS measures would never allow you to expand your own value sets.  We provide the explicit expansion that you must use, and you are not allowed to use any other codes.

Thread 841 (2022-11-14):

Translator (2.3.0) Unions Same Retrieve With Itself

cmoesel, 2022-11-14:
Given the following CQL:
```
library Example version '1.0.0'
using FHIR version '4.0.1'
valueset "Opioid Pain Medications": 'https://cts.nlm.nih.gov/fhir/ValueSet/2.16.840.1.113762.1.4.1032.34'
define MyRetrieve: [MedicationRequest: "Opioid Pain Medications"]
```
the CQL-to-ELM Translator 2.3.0 produces the following definition:
```json
{
   "name" : "MyRetrieve",
   "context" : "Patient",
   "accessLevel" : "Public",
   "expression" : {
      "type" : "Union",
      "operand" : [ {
         "dataType" : "{http://hl7.org/fhir}MedicationRequest",
         "templateId" : "http://hl7.org/fhir/StructureDefinition/MedicationRequest",
         "codeProperty" : "medication",
         "codeComparator" : "in",
         "type" : "Retrieve",
         "codes" : {
            "name" : "Opioid Pain Medications",
            "preserve" : true,
            "type" : "ValueSetRef"
         }
      }, {
         "dataType" : "{http://hl7.org/fhir}MedicationRequest",
         "templateId" : "http://hl7.org/fhir/StructureDefinition/MedicationRequest",
         "codeProperty" : "medication",
         "codeComparator" : "in",
         "type" : "Retrieve",
         "codes" : {
            "name" : "Opioid Pain Medications",
            "preserve" : true,
            "type" : "ValueSetRef"
         }
      } ]
   }
}
```

As you can see, it took the retrieve (`[MedicationRequest: "Opioid Pain Medications"]`) and unioned it with itself.

If I had to guess, I'd guess that the translator is trying to be smart and union a retrieve using `medicationCodeableConcept` and another retrieve using `medicationReference` -- but it's not doing it right.

Although the end result is logically equivalent (since duplicates are removed), it probably isn't great for performance, especially when the retrieves are large.

BTW -- changing the retrieve to `[MedicationRequest: medication in "Opioid Pain Medications"]` gives the expected definition even though it's basically just an explicit way of saying what the other retrieve said implicitly (since the `primaryCodePath` is `medication`):

```json
{
   "name" : "MyRetrieve",
   "context" : "Patient",
   "accessLevel" : "Public",
   "expression" : {
      "dataType" : "{http://hl7.org/fhir}MedicationRequest",
      "templateId" : "http://hl7.org/fhir/StructureDefinition/MedicationRequest",
      "codeProperty" : "medication",
      "codeComparator" : "in",
      "type" : "Retrieve",
      "codes" : {
         "name" : "Opioid Pain Medications",
         "preserve" : true,
         "type" : "ValueSetRef"
      }
   }
}
```

As far as I can tell, this only happens for some resources (like `MedicationRequest` and `MedicationStatement`), hence my guess that it has to do with the `primaryCodePath` pointing to a choice element.

brynrhodes, 2023-10-11:
@cmoesel , this took a long time to get to, but you're right, that's what the translator was trying to do, it now does it correctly, although it is sort of a hack the way that it does it (since it is specifically looking for this pattern). Generally, we will need to expand ModelInfo to support declaration of references in order to do this properly, but as a stop gap, the latest translator will output the correct ELM for this case. See issue #1146 for more detail.

I'm going to leave this ticket open as the way to address the larger issue, but it's going to require some additional ModelInfo information.

cmoesel, 2025-05-23:
@brynrhodes - This bug is back. Using the latest translator, the following code is producing a union of two identical retrieves:
```
library TestCQL version '1.2.3'
using QICore version '6.0.0'

valueset "My ValueSet": 'http://example.org/vs/MyVS'

context Patient

define MedOne: [MedicationRequest: "My ValueSet"]
```
As was the case before, changing `[MedicationRequest: "My ValueSet"]` to `[MedicationRequest: medication in "My ValueSet"]` fixes it, but this shouldn't be required since `medication` is the `primaryCodePath` for `MedicationRequest` in QICore 6.0.

Thread 843 (2022-11-21):

Consider groups of translator options based on use case for ELM

brynrhodes, 2022-11-21:
Currently, translatorOptionsMatch is built to include any change in CQL behavior and/or ELM output. Consider more fine-grained controls to support different use cases for ELM usage:

Master option:

EnableAnnotations
Language Features:

DisableListTraversal
DisableListDemotion
DisableListPromotion
EnableIntervalDemotion
EnableIntervalPromotion
DisableMethodInvocation
RequireFromKeyword
Annotated Helpers for Interpreters:

EnableResultTypes - function overloads
SignatureLevel - function overloads
Dependency Loader Control:

EnableCqlOnly - Doesn't load pre-compiled ELM (JSON or XML) dependencies
CompatibilityLevel - Compatibility level for the translator, valid values are 1.3, 1.4, and 1.5
Debbuging Information for Language Servers.

EnableLocators - Find source of errors
ErrorLevel - Error, Warnings, Info, etc.
EnableDetailedErrors -
EnableResultTypes - Code completion
I think the most difficult one is CompatibilityLevel, which is currently used in the dependency library loader but in a way that only loads libraries that declare exactly the same compatibility level value the loader is expecting as opposed to just using the option in the compiler to check if the library is compatible with that version (removing the need to compare the annotations themselves)

mdnazmulkarim, 2023-04-20:
https://github.com/cqframework/clinical-reasoning/pull/286

Closed 2023-04-20.

Thread 848 (2022-11-28):

FhirDal needs a way to return the created id

brynrhodes, 2022-11-28:
Currently the result of the create and update methods in the FhirDal interface is a void, which means there is no way to know what the id of the created resource is. Need to define a structure to support reporting the results of the operation.

https://github.com/cqframework/clinical_quality_language/blob/master/Src/java/cqf-fhir/src/main/java/org/cqframework/fhir/api/FhirDal.java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

Consider the MethodOutcome structure in HAPI?

Note that the final resting place of this API is still up in the air, but the direction is sufficiently aligned that if we use MethodOutcome to achieve return id, we can move forward with the translator FHIRDal in anticipation of taking the FHIRRepository approach once that's finalized and available.

brynrhodes, 2022-12-19:
The repository create does update the id of the resource in memory, so it can be done with the repository API as is, it's just not part of the API directly so not obvious how to get that use case accomplished.

Closed 2022-12-19.

Thread 850 (2022-11-28):

Optimize CQL expression datetime restriction into DataRequirement DateFilter

brynrhodes, 2022-11-28:
In data requirement analysis, when detecting date time terms of sargeable conditions, ensure that datetime restriction is reflected in the resulting data requirements as a DateFilter.

For example:
```cql
define “cxInjury”:
  (CommonEl.“Get Active Confirmed Conditions”([Condition])) C
    where C.code in CommonCx.“rc_cervicalSpineInjury”
      and FHIRCommon.ToInterval(C.onset) starts 30 days or less before Today()
```

JPercival, 2023-09-27:
Resolved by #1111

Closed 2023-09-27.

Thread 855 (2022-12-03):

need help : Trying to understand how the engine works with QDM data model

developerNovo, 2022-12-03:
Hi,

I am new in the cql technology, I am trying to understand how to use QDM data model to send patient data in the cql engine. I am not trying to do anything with the FHIR part, my usecase is to set a data model with multiple patient data and then send that to the engine to retrive matched patients. It seems I can not understand how I can achive that. Till now I am able to generate the elm json file successfully and then initialize the Library with the elm json file. Next I am trying to understand how to set the patient data and send that in to the cql engine. I have already went over the engine testcases and was able to run them successfully, but If I am missing anything, can you please point me to a direction that can help me take the next step.

Thank you for your time !

@brynrhodes : I went over some of your answers, very good details. If you can help me with the above question or any direction will really help !

brynrhodes, 2023-03-28:
CQL defines contexts that facilitate authoring logic from different perspectives in the data model. The most common one (and best supported one) so far is the Patient context. It is up to the evaluation environment to provide the patient context to the engine, and if population level evaluation for patient context logic is needed, to run the logic for each patient in the source data. For example measures are written in Patient context, and the evaluation environment typically runs the measure logic for each patient in the source data. See the measure evaluation logic in the evaluator for an example of this, but the upshot is that the evaluating environment is responsible for ranging over the patients in the source data and running the evaluation for each one.

brynrhodes, 2023-03-28:
Patient information is provided via the "context" to the engine: https://github.com/cqframework/clinical_quality_language/blob/master/Src/java/engine/src/main/java/org/opencds/cqf/cql/engine/execution/Context.java

So part of setting up the engine evaluation is establishing the context where you provide the id of the current patient.

JPercival, 2023-11-03:
Closed due to lack of activity

Closed 2023-11-03.

Thread 1109 (2023-01-06):

cql-to-elm translator comment newlines being lost in some cases

nmorasb, 2023-01-06:
We are using the cql-to-elm library and have observed that when combining styles of comments the newline after the last comment is lost, causing issues with downstream consumers of the generated ELM.
CQL:
```
library ObsTestN1 version '0.0.000'

using FHIR version '4.0.1'

include FHIRHelpers version '4.1.000' called FHIRHelpers

parameter "Measurement Period" Interval<DateTime>

context Patient

/* Multi-line works fine */
// Single-line comment does not work
define "boolIpp":
  exists ["Encounter"] E where E.period.start during "Measurement Period"
```

Here are some screenshots of the issue as observed after passing the ELM to fqm-execution:
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

The issue is not observed when comment styles are not mixed:
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

The issue is also not observed if a multi-line comment comes after the single-line comments:
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

These screenshots were all coming from fqm-execution library output, but we can see here the actual cql-to-elm output where the newline character is being lost:
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

versus what appears when we only use single-line comment style:
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

Adding @JSRankins here as well

brynrhodes, 2023-10-06:
Included in 2.11.0

Closed 2023-10-06.

Thread 1115 (2023-01-26):

DataRequirements test failures

Capt-Mac, 2023-01-26:

amc514, 2024-02-04:
I am also seeing some unexpected behavior from the DataRequirementProcessor (currently using version 3.5.1).  It would appear that something has changed between versions 3.1.0 and 3.2.0.  If I use this small CQL file, I can replicate the behavior:
```
library "Test-Rule" version '0.0.1'
using FHIR version '4.0.0'
include FHIRHelpers version '4.0.0'
valueset "Test MedicationRequest VS": 'fake.medrequest.vs'
context Patient
define "Matching MedicationRequests": [MedicationRequest: "Test MedicationRequest VS"]
```
On version 3.1.0, the return value from `gatherDataRequirements` includes:
1. a requirement for MedicationRequest containing a code filter for my value set
2. a requirement for Patient

On version 3.2.0, repeating the same steps as above, I get:
1. a requirement for MedicationRequest containing a code filter for my value set
2. a requirement for MedicationRequest with ***no code filter*** attached
3. a requirement for ***Medication*** with no code filter attached
4. a requirement for Patient

The second and third requirements from version 3.2.0+ are unexpected to me.  I tried up to version 3.6.0 and still see the same behavior from the DataRequirementProcessor.

JPercival, 2024-02-06:
Whats happening here is that `Medication.medication` is a choice type. It can be either a `CodeableConcept` or a `Reference`. In cases where it's a `Reference`, there's an implied requirement for `Medication` since you're referencing one directly by id.

The two other unfiltered data requirements fall out from that. Essentially, since you're referencing `Medication` by id but you don't know the ids ahead of time (it could whatever is stored in the `medication` `Reference`, you need all the `Medications`.

You can rewrite the last line as:
```
define "Matching MedicationRequests": ["MedicationRequest"] MR where MR.medication as CodeableConcept in "Test MedicationRequest VS"
```

And you'll see the behavior you're expecting.

amc514, 2024-02-06:
@JPercival the `Medication.medication` property is a reference in the case of our FHIR implementation.  What I'm hoping to infer from the data requirements is that the `Medication` requirement is originating from this `MedicationRequest` requirement, such that I can add the `_include=MedicationRequest:medication` parameter to the MedicationRequest search request and not separately fetch all `Medication` resources.

I understand why it is logical to include some indication that this artifact depends on `Medication` due to the choice type of `Medication.medication` and the possibility of it being a reference, but is it possible to report it in such a way that it could be differentiated from an explicit dependency on the `Medication` resource from the CQL?

On the other hand, I don't understand why the `MedicationRequest` data requirement without a code filter is a logical data requirement for this artifact.

JPercival, 2024-02-06:
> but is it possible to report it in such a way that it could be differentiated from an explicit dependency on the Medication resource from the CQL?

Based on my understanding of data requirements that's not how they are intended to be used. Rather, it's a way to share metadata about all possible data the CQL might access. This is useful for things like access-control. "User A can see MedicationRequests, but not Medications".

In this case, which particular Medications are read depend on the data stored within the MedicationRequests, which is not known ahead of time. The narrowest it could be scoped and still work for all cases is an unfiltered Medication.

> On the other hand, I don't understand why the MedicationRequest data requirement without a code filter is a logical data requirement for this artifact.

The data requirements processor can see that some Medications will be filtered by a ValueSet (those that have a CodeableConcept for `medication`). But other Medications that have a reference can not be filtered by a ValueSet. It's unable to distinguish in this particular context that you only care about those with CodeableConcept, so it gives you an unfiltered Medication to ensure those that have a reference are also captured. The explicit `as CodeableConcept` in the example I gave you is the clue it needs to remove that additional unfiltered Medication. "I know I'm talking about `medication`, which may be a `Reference` or a `CodeableConcept`, but I explicitly only care about the ones with a `CodeableConcept`, which precludes Medicaitons." It may be possible to enhance the inference there to doesn't add that additional unfiltered MedicaitonRequest. I'll have to look into that.

amc514, 2024-02-07:
> Based on my understanding of data requirements that's not how they are intended to be used. Rather, it's a way to share metadata about all possible data the CQL might access. This is useful for things like access-control. "User A can see MedicationRequests, but not Medications".

This interpretation seems to conflict with the discussion here: https://cql.hl7.org/05-languagesemantics.html#artifact-data-requirements

It discusses in detail how to combine/collapse data requirements in order to produce "the minimum initial data requirements for the artifact, with any overlapping requests for the same type of data collapsed into a single request descriptor."  Additionally, the presence of elements like `codeFilter` and `dateFilter` on the `DataRequirement` resource would indicate to me that they are meant to be used for optimal data fetching rather than primarily for access control.

The discussion in section 1.3 of the CQL Language Semantics guide is effectively exactly what we're trying to achieve, though we aren't bothering with the date filtering optimization at the moment, only the code filter so far.  For this specific example of the MedicationRequest referencing a Medication, it'd seem the *Includes* component of the retrieve data requirement is most relevant.  From that excerpt of the CQL guide:
> Include elements for the clinical data. For data models that define relationships between data types, this element allows data matching the include relationships to be returned as part of the retrieve as well. Implementations that support this capability must ensure that included data returned is accessible via the related retrieve statements.

Though, I don't see a way to represent the `include` information in the FHIR resource for `DataRequirement`, so perhaps this is a gap with the resource definition?  I'm far from a FHIR expert, though.

JPercival, 2024-02-07:
> Based on my understanding of data requirements that's not how they are intended to be used.

> This interpretation seems to conflict with the discussion here: https://cql.hl7.org/05-languagesemantics.html#artifact-data-requirements
> It'd seem the Includes component of the retrieve data requirement is most relevant. From that excerpt of the CQL guide:
> Though, I don't see a way to represent the include information in the FHIR resource for DataRequirement, so perhaps this is a gap with the resource definition? I'm far from a FHIR expert, though.

I'm referring to the FHIR data requirements returned by the DataRequirements processor in question, not artifact data requirements in the CQL spec. These are two separate and distinct specifications, despite the conceptual overlap and shared nomenclature. As you've pointed out, there's not a way to do includes in the FHIR data requirements.

> with any overlapping requests for the same type of data collapsed into a single request descriptor

Currently with the CQL compiler you have to set `collapseDataRequirements` to true on the `CqlCompilerOptions` to opt-in to the collapsing behavior, though in this case it would not help.

amc514, 2024-02-07:
> These are two separate and distinct specifications, despite the conceptual overlap and shared nomenclature.

I see, thank you for clearing up that source of confusion!

If we take the `DataRequirementProcessor` and FHIR out of the question, is it currently possible to implement the logic described in the CQL spec I referenced above?  We're using the `cql2elm` package to compile our CQL, which to my understanding utilizes the `Cql2ElmVisitor` class that was updated in #1228.  Is that also going to prevent us from accurately analyzing and collapsing the ELM data requirements as described in the CQL spec?

JPercival, 2024-02-07:
Yes, the logic for that analysis is partially implemented internally and is the source for the FHIR data requirements. Here's the package for that. In particular the ElmRequirementsVisitor may be of interest to you:

https://github.com/cqframework/clinical_quality_language/blob/master/Src/java/elm-fhir/src/main/java/org/cqframework/cql/elm/requirements/

We've yet to come up with a public API or serialization format for the ELM requirements, and includes have yet to be implemented, but you may find something useful there. We're definitely interested in support includes here it just hasn't bubbled up the backlog yet.

Thread 1128 (2023-02-10):

Add signature consideration to FunctionRefEvaluator

brynrhodes, 2023-02-10:
The FunctionRefEvaluator currently considers only the declared and runtime signatures for function resolution. Update the evaluator to take advantage of the signature element if it is present (representing the compile-time resolution of the function).

This is related to this translator issue: https://github.com/cqframework/clinical_quality_language/issues/1127
And this evaluator issue: https://github.com/cqframework/clinical-reasoning/issues/244

mdnazmulkarim, 2023-10-03:
Done

Closed 2023-10-03.

Thread 1131 (2023-02-22):

Issue with ELM annotations during comparison operators to literals

mgramigna, 2023-02-22:
Identified during an investigation for https://github.com/projecttacoma/fqm-execution/issues/202

I wanted to clarify/potentially report an issue on the expected structure of ELM annotations for certain CQL expressions. fqm-execution relies on these annotations in order to assemble measure logic highlighting HTML shown in the linked issue.

Consider the following simplified case from the issue:

``` cql
/* snipped library def and other expression referenced */

define "Example":
  "Expression That Returns Number" >= 66
```

Generates the following ELM with annotation:

``` json
{
  "localId": "8",
  "name": "Example",
  "context": "Patient",
  "accessLevel": "Public",
  "annotation": [
    {
      "type": "Annotation",
      "s": {
        "r": "8",
        "s": [
          {
            "value": ["", "define ", "\"Example\"", ":\n  "]
          },
          {
            "r": "7",
            "s": [
              {
                "r": "5",
                "s": [
                  {
                    "value": ["\"Expression That Returns Number\""]
                  }
                ]
              },
              {
                "r": "6",
                "value": [" ", ">=", " ", "66"]
              }
            ]
          }
        ]
      }
    }
  ],
  "expression": {
    "localId": "7",
    "type": "GreaterOrEqual",
    "operand": [
      {
        "localId": "5",
        "name": "Expression That Returns Number",
        "type": "ExpressionRef"
      },
      {
        "localId": "6",
        "valueType": "{urn:hl7-org:elm-types:r1}Integer",
        "value": "66",
        "type": "Literal"
      }
    ]
  }
}
```

Of note is that the `>=` string gets roped into the annotation for the literal `66`, corresponding to localId `"6"` in the ELM. Gut feeling causes me to think that the `>=` annotation be on its own in the annotation not tied to the literal expression. A slight modification of the CQL produces the desired annotation:

``` cql
/* snipped library def and other expressions referenced */

define "Example":
  "Expression That Returns Number" >= "Other Expression That Returns Number"
```

Generates the following very similar ELM, but with the desired annotation:

``` json
{
  "localId": "10",
  "name": "Example",
  "context": "Patient",
  "accessLevel": "Public",
  "annotation": [
    {
      "type": "Annotation",
      "s": {
        "r": "10",
        "s": [
          {
            "value": ["", "define ", "\"Example\"", ":\n  "]
          },
          {
            "r": "9",
            "s": [
              {
                "r": "5",
                "s": [
                  {
                    "value": ["\"Expression That Returns Number\""]
                  }
                ]
              },
              {
                "value": [" ", ">=", " "]
              },
              {
                "r": "8",
                "s": [
                  {
                    "value": ["\"Other Expression That Returns Number\""]
                  }
                ]
              }
            ]
          }
        ]
      }
    }
  ],
  "expression": {
    "localId": "9",
    "type": "GreaterOrEqual",
    "operand": [
      {
        "localId": "5",
        "name": "Expression That Returns Number",
        "type": "ExpressionRef"
      },
      {
        "localId": "8",
        "name": "Other Expression That Returns Number",
        "type": "ExpressionRef"
      }
    ]
  }
}
```

Here, the `>=` string is on its own in the annotation, and is not tied to the localId `"8"` ExpressionRef. The unexpected behavior only seems to happen when the LHS or RHS of a comparison expression is a literal, not an ExpressionRef or other more complex ELM expression.

**Main Question:** Is it an issue or is it expected behavior that the annotation for a comparison operator is not separated out from a literal when comparison is done to that literal?

If it is expected that the `>=` is tied to the literal, perhaps the `"r"` value should actually correspond to the "localId" of the `GreaterOrEqual` expression, not the `Literal`?

JPercival, 2023-11-23:
Duplicate of #1279

Closed 2024-01-05.

Thread 1136 (2023-03-10):

QI-Core 4.1.1 MedicationNotRequested Reason Code Mapping

JSRankins, 2023-03-10:
After discussion with @brynrhodes and @mgramigna, there is agreement that there is an issue in how reasonCode is getting mapped to ELM for the MedicationNotRequested datatype in QI-Core 4.1.1. The [QI-Core Model Info File 4.1.1](https://github.com/cqframework/clinical_quality_language/blob/master/Src/java/quick/src/main/resources/org/hl7/fhir/qicore-modelinfo-4.1.1.xml) restricts reasonCode to cardinality of 1..1 for MedicationNotRequested based on the [QICoreMedicationNotRequested ](http://hl7.org/fhir/us/qicore/StructureDefinition-qicore-mednotrequested.html) profile. However, the MedicationRequest resource's reasonCode normally has cardinality of 0..*.

Since ELM is supposed to contain FHIR equivalent as if FHIR is what was being used to author in, reasonCode output should be similar between MedicationRequest v MedicationNotRequested when similar structures are used. They aren't. Refer to the CQL and ELM in the attached zip.

**@mgramigna's findings**
My take on the issue is that I think Stan’s instincts are correct. I believe that when restricting something that is 0..* to 1..1, the property still must be an array, but it will only have one element (this can be verified using the IG publisher and looking at the examples in the QI Core IG). It looks like the translator/ModelInfo thinks that “reasonCode” on a “MedicationNotRequested” is just a CodeableConcept rather than a list of CodeableConcepts. Here are some CQL snippets and data types from the cql language server that I created to confirm this:

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

reasonCode is a list of Concepts as expected. Now for MedicationNotRequested:

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

In the MedicationNotRequsted case, the ModelInfo thinks that reasonCode is just one Concept, whereas I think it should be a list of just one Concept? (not sure how the communication between the cardinality constraint and the ModelInfo works in this instance).

**@brynrhodes feedback**
Looking at the output ELM, yes, that is correct, the translator is considering the reasonCode a singular element, rather than a list of one. Can you submit this as an issue to the CQL translator repository and I will get it addressed.

Stan, you are correct, the ELM engines should be able to run profile-informed CQL without needing to consider the profiles (other than the profile markers in the resources at the data access layer), so this is something that the translator should be accounting for.

[ABCTest.zip](https://github.com/cqframework/clinical_quality_language/files/10946050/ABCTest.zip)

mgramigna, 2023-03-10:
Likely relevant parts of ModelInfo:

[MedicationRequest reasonCode](https://github.com/cqframework/clinical_quality_language/blob/c1e1beefe119200a04a71543797f5f10601e28f9/Src/java/quick/src/main/resources/org/hl7/fhir/qicore-modelinf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) has a `ListTypeSpecifier`

[MedicationNotRequested reasonCode](https://github.com/cqframework/clinical_quality_language/blob/c1e1beefe119200a04a71543797f5f10601e28f9/Src/java/quick/src/main/resources/org/hl7/fhir/qicore-modelinf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) doesn't

brynrhodes, 2023-03-29:
Fixed in 2.7.0

Closed 2023-03-29.

Thread 1137 (2023-03-14):

Inconsistent Casting in Unions

cmoesel, 2023-03-14:
I've discovered inconsistent translation behavior in CQL-to-ELM when a function that returns a list of `Any` is involved in a `union`. In short:

If you have CQL that only does `ListOfIntegers union ToList('MyString')`, then the translator will cast each item in `ToList('MyString')` to an `Integer` (resulting in nulls).

If, however, you put a definition that does the reverse order first (e.g., `ToList('MyString') union ListOfIntegers`) -- and _then_ you do `ListOfIntegers union ToList('MyString')` -- this time the translator will not attempt the cast at all (in either case).

I think the latter behavior (no cast) is preferred, as `ListOfIntegers union ToList('MyString')` does not setup any expectation that it should be a singly-typed list -- so a I expect a list of mixed types back.

**Specific Details (for Reproducing)**

Consider the following CQL:
```
define function "ToList"(Object "Any"):
  if Object is null then List{} else List{Object}

define Foo:
  Tuple{ Bar: 'Baz', Boo: null as Integer }

define NumsUnionFoo:
  List{1, 2, 3} union ToList(Foo)
```

When run through CQL-to-ELM, the translator attempts to cast `ToList(Foo)` to an `Integer` in `NumsUnionFoo`:
```json
{
  "name": "NumsUnionFoo",
  "context": "Patient",
  "accessLevel": "Public",
  "expression": {
    "type": "Union",
    "operand": [
      {
        "type": "List",
        "element": [
          {
            "valueType": "{urn:hl7-org:elm-types:r1}Integer",
            "value": "1",
            "type": "Literal"
          },
          {
            "valueType": "{urn:hl7-org:elm-types:r1}Integer",
            "value": "2",
            "type": "Literal"
          },
          {
            "valueType": "{urn:hl7-org:elm-types:r1}Integer",
            "value": "3",
            "type": "Literal"
          }
        ]
      },
      {
        "type": "Query",
        "source": [
          {
            "alias": "X",
            "expression": {
              "name": "ToList",
              "type": "FunctionRef",
              "operand": [
                {
                  "name": "Foo",
                  "type": "ExpressionRef"
                }
              ]
            }
          }
        ],
        "return": {
          "distinct": false,
          "expression": {
            "asType": "{urn:hl7-org:elm-types:r1}Integer",
            "type": "As",
            "operand": {
              "name": "X",
              "type": "AliasRef"
            }
          }
        }
      }
    ]
  }
}
```

Now simply add an expression with the union in reverse order _before_ `NumsUnionFoo`:
```
define function "ToList"(Object "Any"):
  if Object is null then List{} else List{Object}

define Foo:
  Tuple{ Bar: 'Baz', Boo: null as Integer }

define FooUnionNums:
  ToList(Foo) union List{1, 2, 3}

define NumsUnionFoo:
  List{1, 2, 3} union ToList(Foo)
```

_NOW_ when running it through CQL-to-ELM, the translator does _not_ cast `ToList(Foo)` to an `Integer` in `NumsUnionFoo`:
```json
{
  "name": "NumsUnionFoo",
  "context": "Patient",
  "accessLevel": "Public",
  "expression": {
    "type": "Union",
    "operand": [
      {
        "type": "List",
        "element": [
          {
            "valueType": "{urn:hl7-org:elm-types:r1}Integer",
            "value": "1",
            "type": "Literal"
          },
          {
            "valueType": "{urn:hl7-org:elm-types:r1}Integer",
            "value": "2",
            "type": "Literal"
          },
          {
            "valueType": "{urn:hl7-org:elm-types:r1}Integer",
            "value": "3",
            "type": "Literal"
          }
        ]
      },
      {
        "name": "ToList",
        "type": "FunctionRef",
        "operand": [
          {
            "name": "Foo",
            "type": "ExpressionRef"
          }
        ]
      }
    ]
  }
}
```

JPercival, 2023-10-19:
Potentially resolved by #1243. Will retest.

JPercival, 2023-10-24:
Not fixed by #1243. :)

ddieppois, 2023-10-27:
Using the first CQL expression with the latest version of the translator gives me this XML for numsUnionFoo

`<def name="NumsUnionFoo" context="Patient" accessLevel="Public">
         <expression xsi:type="Union">
            <operand xsi:type="List">
               <element valueType="t:Integer" value="1" xsi:type="Literal"/>
               <element valueType="t:Integer" value="2" xsi:type="Literal"/>
               <element valueType="t:Integer" value="3" xsi:type="Literal"/>
            </operand>
            <operand xsi:type="Query">
               <source alias="X">
                  <expression name="ToList" xsi:type="FunctionRef">
                     <operand name="Foo" xsi:type="ExpressionRef"/>
                  </expression>
               </source>
               <return distinct="false">
                  <expression asType="t:Integer" xsi:type="As">
                     <operand name="X" xsi:type="AliasRef"/>
                  </expression>
               </return>
            </operand>
         </expression>
      </def>`

Using the second CQL expression I get

`<def name="NumsUnionFoo" context="Patient" accessLevel="Public">
         <expression xsi:type="Union">
            <operand xsi:type="List">
               <element valueType="t:Integer" value="1" xsi:type="Literal"/>
               <element valueType="t:Integer" value="2" xsi:type="Literal"/>
               <element valueType="t:Integer" value="3" xsi:type="Literal"/>
            </operand>
            <operand name="ToList" xsi:type="FunctionRef">
               <operand name="Foo" xsi:type="ExpressionRef"/>
            </operand>
         </expression>
      </def>`

I can reproduce this issue and confirm that indeed the translator does not cast ToList(Foo) to an Integer in NumsUnionFoo

Thread 1146 (2023-03-30):

ModelInfo issue with MedicationRequest

chubert-sb, 2023-03-30:
A issue occurs when a filter is used for a MedicationRequest profile retrieval in QI-Core. The MedicationRequest resource cannot be found even though the test case JSON contains the MedicationRequest resource, relevant meta.profile and uses the medication element either as a CodeableConcept or referenced Medication resource. For example, when provided the following CQL and correct test case JSON, the case passes:

CQL
```
define "Has ACEI or ARB or ARNI Ordered":
exists (
  [MedicationRequest] ACEIOrARBOrARNIOrdered
    where (
      ( ACEIOrARBOrARNIOrdered.medication as Concept ) in "ACE Inhibitor or ARB or ARNI"
        or ( ACEIOrARBOrARNIOrdered.medication as Reference ).reference.getId() in ( [Medication: "ACE Inhibitor or ARB or ARNI"] ACEIOrARBOrARNI return ACEIOrARBOrARNI.id )
         )
      and ACEIOrARBOrARNIOrdered.isOrderedDuringHeartFailureOutpatientEncounter()
           )
```

However, when the CQL is updated to use the primary code path for the MedicationRequest, the test case that was passing now fails:

updated CQL
```
define "Has ACEI or ARB or ARNI Ordered":
exists (
  [MedicationRequest: "ACE Inhibitor or ARB or ARNI"] ACEIOrARBOrARNIOrdered
    where ACEIOrARBOrARNIOrdered.isOrderedDuringHeartFailureOutpatientEncounter()
         )
```

Based on a brief review of the QI-Core 4.1.1 Model Info file, I'm speculating that the issue is stemming from it. The primary code path for MedicationRequest is provided as 'medication', but medication is a choice type:
```
<typeInfo xsi:type="ClassInfo" baseType="QICore.DomainResource" namespace="QICore" name="MedicationRequest" identifier="http://hl7.org/fhir/us/qicore/StructureDefinition/qicore-medicationrequest" label="MedicationRequest" retrievable="true" primaryCodePath="medication">
.....
  <element name="medication" target="FHIRHelpers.ToValue(%value)" description="..." mustSupport="true">
     <elementTypeSpecifier xsi:type="ChoiceTypeSpecifier">
        <choice namespace="System" name="Concept" xsi:type="NamedTypeSpecifier"/>
        <choice namespace="QICore" name="Reference" xsi:type="NamedTypeSpecifier"/>
     </elementTypeSpecifier>
     <binding description="Prescribable medications" strength="Extensible"/>
  </element>
```

brynrhodes, 2023-07-10:
The terminology target must be code-valued, so when it is used with the medication element, that resolves to the CodeableConcept choice, and there is no expectation that the retrieve would apply through the reference choice. In other words, when using the terminology target of the retrieve if the MedicationRequest.medication element is a reference, it would not be addressable through the retrieve. I've added a test to validate the MedicationRequest with a terminology target translates with the codeableconcept choice.

JSRankins, 2023-07-10:
@brynrhodes, I understand your explanation above. The patterns page for [Medication ordered](https://github.com/cqframework/CQL-Formatting-and-Usage-Wiki/wiki/Authoring-Patterns---QICore-v4.1.1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) uses this same approach - asserting medication as a CodeableConcept. But this makes me wonder if that limitation should be forced at the profile level, since the current profile (for QI-Core 4.1.1 and 5.0.0) allows the medication to be either a medicationCodeableConcept OR a medicationReference. Based on the profile, a compliant instance of MedicationRequest could be provided with a medicationReference, but that creates an execution issue. Is the patterns page just a recommendation or a requirement? Should the patterns page be addressing medication as either a medicationCodeableConcept OR a medicationReference? Thoughts?

brynrhodes, 2023-07-10:
@JSRankins , it would make sense to address this in the patterns page, but I'm hesitant to enforce it at the profile level since it is still possible to address (and we'll need to be able to since there are systems that do both). I'll add this as an item to address in the patterns.

jenseeman, 2023-07-14:
Reference: https://oncprojectracking.healthit.gov/support/browse/CQLIT-373

brynrhodes, 2023-07-25:
Proposed update to the patterns to address retrieving when medication requests are represented as references:

library MedicationRequestTest

using QICore version '4.1.1'

include FHIRHelpers version '4.2.000'
include QICoreCommon version '1.3.000'

valueset "Antithrombotic Therapy": 'http://cts.nlm.nih.gov/fhir/ValueSet/2.16.840.1.113762.1.4.1110.62'

context Patient

```cql
define "Antithrombotic Therapy at Discharge":
  ["MedicationRequest": medication in "Antithrombotic Therapy"] Antithrombotic
    where (Antithrombotic.isCommunity() or Antithrombotic.isDischarge())
      and Antithrombotic.status in { 'active', 'completed' }
      and Antithrombotic.intent = 'order'

// Proposed update to the pattern to address medications represented as references: https://github.com/cqframework/CQL-Formatting-and-Usage-Wiki/wiki/Authoring-Patterns---QICore-v4.1.1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

define "Antithrombotic Therapy at Discharge (by Reference)":
  ["MedicationRequest"] Antithrombotic
    where Antithrombotic.medication().code in "Antithrombotic Therapy"
      and (Antithrombotic.isCommunity() or Antithrombotic.isDischarge())
      and Antithrombotic.status in { 'active', 'completed' }
      and Antithrombotic.intent = 'order'

define fluent function medication(medicationRequest MedicationRequest):
  singleton from ([Medication: id = medicationRequest.medication.reference.getId()])

define fluent function medicationAlternate(medicationRequest MedicationRequest):
  singleton from ([Medication] M where M.id = medicationRequest.medication.reference.getId())
```

We should investigate whether it would make sense to support this more succinctly with the `.resolve()` function, and potentially as an implicit union by the translator when the terminology path is a choice of representations.

brynrhodes, 2023-10-03:
It is possible to support this in the translator, however, full support for this capability will require additional information about the reference to be captured in the ModelInfo. The initial exploratory implementation only supports the MedicationRequest scenario, full support is in development.

brynrhodes, 2023-10-11:
Included in release 3.2.0

birick1, 2023-11-02:
**Post 3.2.0 Issue**

I tested Stan's example CQL by converting to ELM with translator version 3.4.0-SNAPSHOT.  From there, I reproduced the reported error in the engine and worked to track down the root cause.

**Root Cause (Translator version 3.4.0)**

I believe the root cause is that the ELM being produced in version 3.4.0 is not correct.

The CQL at issue is:

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

When looking at the ELM, `medication.reference` needs to be converted to a CQL type (`System.string`) for the `Split` operator (red outline).  In other words, there should be a `.value` and `ToValue` in the clause to handle the type conversion for the `Split` operator.  Below is the ELM generated in 3.4.0 that results in an engine error:

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

**Expected ELM**

To get an expected version of the ELM, I created a CQL test case to replicate the operation sequence being performed.

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

Translating to ELM using v3.4.0, gives an expected form of ELM including a `value` and `ToValue` call.  This output runs as expected in the engine.

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

**Reference vs CodeableConcept choice**

The CodeableConcept choice does not seem to be handled.

**InValueSet Issue**

Looking at the valueset part of the produced ELM, the code section does not have a scope or source property.  The lack of scope is expected to lead to a engine error.

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

Closed 2023-10-11.

Thread 1148 (2023-04-04):

Refactor cql-engine to be an ELM Visitor

JPercival, 2023-04-04:
Currently, the cql-engine duplicates the cql-translator's ELM graph. Each of the nodes in the graph implements an `Executable` interface, each node in the graph calls its children. This essentially makes the cql-engine a self-executing ELM AST. This design has a nice property in that once the graph is produced, there is no reflection required in traversing the nodes. However, it also has a number of drawbacks:

1. Duplicate ELM model maintenance
2. Difficult to rewrite the ELM tree for optimizations at runtime (since relationship between nodes is set when the graph is created)
3. Multiple engine implementations required for partial evaluation, such as when doing `$data-requirements` analysis, since the analysis is done on the translator ELM graph, and the runtime execution is done on the engine ELM graph
4. Understanding of both the translator and engine design required to do end-to-end CQL development on the Java stack
5. Difficult to specialize return types on a per-node basis, since each engine node is `Executable`
    1. it'd be more natural, as an example, for a `Retrieve` node evaluation to return an `Iterable`
6. Pre-visit and post-visit behaviors are more difficult to implement (such as stopping on a breakpoint for a debugger, creating an execution trace, etc.)

The current engine implementation is the `Context` class that's here:
https://github.com/cqframework/clinical_quality_language/blob/master/Src/java/engine/src/main/java/org/opencds/cqf/cql/engine/execution/Context.java

This class has multiple responsibilities:
1. Storing current execution state in a series of stacks, maps, etc.
2. Setting up an initial execution state with a reference to current time, initial library, etc.
3. Executing evaluation requests and manipulating state
4. Caching evaluation results, function evaluations
5. Storing references to `LibraryManager`, `DataProvider`, `TerminologyProvider`, `UCUMService`, and `ExternalFunctionProvider`

These should be decomposed into smaller sets of functionality that can be tested and updated independently. The specific structure will take a little implementation effort to determine, but a high level design is something like:

```mermaid
---
title:  DRAFT CQL Engine design
---
classDiagram
    ElmVisitor <|-- CqlEngine
    class Environment {
      +DataProvider dataProvider
      +TerminologyProvider terminologyProvider
      +LibraryManager libraryManager
    }
    class State {
      +Stack currentContext
      +Stack currentLibrary
    }
    class Cache {
      +Map expressionCache
      +Map functionCache
    }
    class CqlEngine {
      +Environment environment
      +State state
      +Cache cache
      +CqlType evaluate(String expression)
    }
 ```

 The current set of `XYZEvaluator` classes can be reused. The internal implementation of `visitBinaryExpression` should be something like:

 ```java
 public T visitBinaryExpression(BinaryExpression exp) {
     varl left = visitExpression(exp.getLeft());
     var right = visitExpression(exp.getRight());
     return BinaryExpressionEvaluator.evaluate(exp, left, right);
 }
 ```
 That should be repeated for each node type.

 Once the conversion to be a visitor is complete, the engine ELM graph can be removed.

JPercival, 2023-08-16:
Resolved by #1174

Closed 2023-08-16.

Thread 1156 (2023-04-19):

Processor returns values for DataEntries that have no values

mcmcphillips, 2023-04-19:
https://oncprojectracking.healthit.gov/support/browse/BONNIEMAT-1428

@brynrhodes

In Madie we are able to perceive issues with data entries being returned with no values. We can check this by

`    log.info(
        "FHIR CONTEXT IS {}",
        fhirContext
            .newJsonParser()
            .setPrettyPrint(true)
            .encodeResourceToString(r4EffectiveDataRequirements));`
    
  This displays multiple entries without values

  `  }, {
    "profile": [ "http://hl7.org/fhir/ReferenceVersionRules" ],
    "mustSupport": [ "value" ]
  }, {
    "profile": [ "http://hl7.org/fhir/ReferredDocumentStatus" ],
    "mustSupport": [ "value" ]
  }, {
    "profile": [ "http://hl7.org/fhir/RelatedArtifactType" ],
    "mustSupport": [ "value" ]
  }, {`

  These additional values lead to multiple export lines with emp[ty values as displayed in BONNIEMAT-1428

JSRankins, 2023-04-19:
@brynrhodes, I think the issue is that Data Requirements Processor seems to provide all data requirements back from included libraries, even if they were not used in the primary library. Not saying that is the wrong design. But we are using Data Requirements Processor to do the type conversion between QI-Core and FHIR. As part of that process, is there something in the src code to tease out the data requirements that are not directly or indirectly used by the main library?

brynrhodes, 2023-07-10:
Yes, the dataRequirementsProcessor takes an optional parameter that indicates which expressions in the Library should be considered. In that case, only items that are referenced by the given expressions will be considered. For use in measures, this means the top-level expressions referenced by the measure should be given. I've added test cases for the CMS143 and CMS149 measure content in the linked bonnie ticket to confirm effective data requirements calculation.

brynrhodes, 2023-10-06:
Included in 2.11.0

Closed 2023-10-06.

Thread 1185 (2023-08-14):

cql-to-elm-cli crash on quantity '%' unit

sunshineco, 2023-08-14:
On `master`, currently at 8a041ba5 _(Fixes for list Unions (#1182), 2023-08-08)_, `cql-to-elm-cli` crashes when translating `CMS122-v11-0-000-QDM-5-6.cql` to ELM:

```
% cql-to-elm-cli --annotations --locators --disable-list-demotion --disable-list-promotion --disable-method-invocation -f JSON --input ./CMS122-v11-0-000-QDM-5-6.cql
TRANSLATE ./CMS122-v11-0-000-QDM-5-6.cql
SLF4J: Failed to load class "org.slf4j.impl.StaticLoggerBinder".
SLF4J: Defaulting to no-operation (NOP) logger implementation
SLF4J: See http://www.slf4j.org/codes.html#StaticLoggerBinder for further details.
Exception in thread "main" java.lang.NoClassDefFoundError: org/xmlpull/v1/XmlPullParserException
	at org.fhir.ucum.UcumEssenceService.<init>(UcumEssenceService.java:57)
	at org.cqframework.cql.cql2elm.LibraryManager.getDefaultUcumService(LibraryManager.java:118)
	at org.cqframework.cql.cql2elm.LibraryManager.getUcumService(LibraryManager.java:110)
	at org.cqframework.cql.cql2elm.LibraryBuilder.validateUcumUnit(LibraryBuilder.java:1902)
	at org.cqframework.cql.cql2elm.LibraryBuilder.validateUnit(LibraryBuilder.java:1861)
	at org.cqframework.cql.cql2elm.LibraryBuilder.createQuantity(LibraryBuilder.java:1913)
	at org.cqframework.cql.cql2elm.Cql2ElmVisitor.visitQuantity(Cql2ElmVisitor.java:1744)
	at org.cqframework.cql.cql2elm.Cql2ElmVisitor.visitQuantity(Cql2ElmVisitor.java:36)
	at org.cqframework.cql.gen.cqlParser$QuantityContext.accept(cqlParser.java:10382)
	at org.antlr.v4.runtime.tree.AbstractParseTreeVisitor.visitChildren(AbstractParseTreeVisitor.java:46)
	at org.cqframework.cql.gen.cqlBaseVisitor.visitQuantityLiteral(cqlBaseVisitor.java:1098)
	at org.cqframework.cql.gen.cqlParser$QuantityLiteralContext.accept(cqlParser.java:8643)
	at org.antlr.v4.runtime.tree.AbstractParseTreeVisitor.visitChildren(AbstractParseTreeVisitor.java:46)
	at org.cqframework.cql.gen.cqlBaseVisitor.visitLiteralTerm(cqlBaseVisitor.java:909)
	at org.cqframework.cql.gen.cqlParser$LiteralTermContext.accept(cqlParser.java:7803)
	at org.antlr.v4.runtime.tree.AbstractParseTreeVisitor.visitChildren(AbstractParseTreeVisitor.java:46)
	at org.cqframework.cql.gen.cqlBaseVisitor.visitTermExpressionTerm(cqlBaseVisitor.java:776)
	at org.cqframework.cql.gen.cqlParser$TermExpressionTermContext.accept(cqlParser.java:6129)
	at org.antlr.v4.runtime.tree.AbstractParseTreeVisitor.visitChildren(AbstractParseTreeVisitor.java:46)
	at org.cqframework.cql.gen.cqlBaseVisitor.visitTermExpression(cqlBaseVisitor.java:601)
	at org.cqframework.cql.cql2elm.Cql2ElmVisitor.visitTermExpression(Cql2ElmVisitor.java:2401)
	at org.cqframework.cql.gen.cqlParser$TermExpressionContext.accept(cqlParser.java:5075)
	at org.antlr.v4.runtime.tree.AbstractParseTreeVisitor.visit(AbstractParseTreeVisitor.java:18)
	at org.cqframework.cql.cql2elm.Cql2ElmVisitor.visit(Cql2ElmVisitor.java:649)
	at org.cqframework.cql.cql2elm.Cql2ElmVisitor.parseExpression(Cql2ElmVisitor.java:4639)
	at org.cqframework.cql.cql2elm.Cql2ElmVisitor.visitInequalityExpression(Cql2ElmVisitor.java:2350)
	at org.cqframework.cql.cql2elm.Cql2ElmVisitor.visitInequalityExpression(Cql2ElmVisitor.java:36)
	at org.cqframework.cql.gen.cqlParser$InequalityExpressionContext.accept(cqlParser.java:4993)
	at org.antlr.v4.runtime.tree.AbstractParseTreeVisitor.visit(AbstractParseTreeVisitor.java:18)
	at org.cqframework.cql.cql2elm.Cql2ElmVisitor.visit(Cql2ElmVisitor.java:649)
	at org.cqframework.cql.cql2elm.Cql2ElmVisitor.internalVisitExpressionDefinition(Cql2ElmVisitor.java:1246)
	at org.cqframework.cql.cql2elm.Cql2ElmVisitor.visitExpressionDefinition(Cql2ElmVisitor.java:1264)
	at org.cqframework.cql.cql2elm.Cql2ElmVisitor.visitExpressionDefinition(Cql2ElmVisitor.java:36)
	at org.cqframework.cql.gen.cqlParser$ExpressionDefinitionContext.accept(cqlParser.java:2227)
	at org.antlr.v4.runtime.tree.AbstractParseTreeVisitor.visitChildren(AbstractParseTreeVisitor.java:46)
	at org.cqframework.cql.gen.cqlBaseVisitor.visitStatement(cqlBaseVisitor.java:216)
	at org.cqframework.cql.gen.cqlParser$StatementContext.accept(cqlParser.java:2157)
	at org.antlr.v4.runtime.tree.AbstractParseTreeVisitor.visit(AbstractParseTreeVisitor.java:18)
	at org.cqframework.cql.cql2elm.Cql2ElmVisitor.visit(Cql2ElmVisitor.java:649)
	at org.cqframework.cql.cql2elm.Cql2ElmVisitor.visitLibrary(Cql2ElmVisitor.java:727)
	at org.cqframework.cql.gen.cqlParser$LibraryContext.accept(cqlParser.java:353)
	at org.antlr.v4.runtime.tree.AbstractParseTreeVisitor.visit(AbstractParseTreeVisitor.java:18)
	at org.cqframework.cql.cql2elm.Cql2ElmVisitor.visit(Cql2ElmVisitor.java:649)
	at org.cqframework.cql.cql2elm.CqlCompiler.run(CqlCompiler.java:196)
	at org.cqframework.cql.cql2elm.CqlTranslator.<init>(CqlTranslator.java:69)
	at org.cqframework.cql.cql2elm.CqlTranslator.fromFile(CqlTranslator.java:54)
	at org.cqframework.cql.cql2elm.cli.Main.writeELM(Main.java:70)
	at org.cqframework.cql.cql2elm.cli.Main.main(Main.java:204)
Caused by: java.lang.ClassNotFoundException: org.xmlpull.v1.XmlPullParserException
	at java.base/jdk.internal.loader.BuiltinClassLoader.loadClass(BuiltinClassLoader.java:581)
	at java.base/jdk.internal.loader.ClassLoaders$AppClassLoader.loadClass(ClassLoaders.java:178)
	at java.base/java.lang.ClassLoader.loadClass(ClassLoader.java:527)
	... 48 more
```

Using v2.11.0, _bd64bcd4 (Update version to 2.11.0, 2023-07-14)_, `cql-to-elm-cli` successfully compiles `CMS122-v11-0-000-QDM-5-6.cql`. `git bisect` places the blame for the crash on commit 69a7cd8e _(Follow-up items for 3.0.0-SNAPSHOT (#1178), 2023-07-12)_.

A minimum-reproduction, extracted directly from `CMS122-v11-0-000-QDM-5-6.cql`, is:

```cql
define "Has Most Recent Elevated HbA1c":
  "Most Recent HbA1c".result > 9 '%'
```

Using `master`, 8a041ba5 _(Fixes for list Unions (#1182), 2023-08-08)_, `cql-to-elm-cli` crashes, showing the above stack-trace. Using v2.11.0, `cql-to-elm-cli` correctly diagnoses that `Most Recent HbA1c` cannot be resolved in the minimum-reproduction fragment:

```
Translation failed due to errors:
Error:[2:3, 2:21] Could not resolve identifier Most Recent HbA1c in the current library.
```

brynrhodes, 2023-10-11:
@sunshineco , we are unable to reproduce this behavior with the latest translator. The error stack looks like a dependency issue that has since been addressed by an update to the UCUM dependency. Are you able to use the latest translator?

brynrhodes, 2023-10-12:
I take it back, this looks like it's still an issue because the cli project does not declare a runtime dependency on the xpp3, which is required for the UcumService to run (at least some implementation of an XmlPullParser is required, we use Xpp3 for the command-line). Reopening this and submitting a PR to address it

sunshineco, 2023-10-14:
Thank you for the response. I can confirm that the crash still occurred as of 69e010f2 (Handle overloaded forward function declarations, 2023-10-11), but was fixed by 6e944b69 (Added runtime dependency on XPP3 to the cli, 2023-10-12) which was merged by pull request #1242.

Closed 2023-10-14.

Thread 1194 (2023-08-21):

Build :cql-to-elm:installDist not founded

tibraga, 2023-08-21:
Hi, i'm trying to execute the command bellow, but happens some error:

```
./gradlew :cql-to-elm:installDist

FAILURE: Build failed with an exception.

* What went wrong:
Cannot locate tasks that match ':cql-to-elm:installDist' as task 'installDist' not found in project ':cql-to-elm'.
```

Anyone know how to fix it?

brynrhodes, 2023-08-31:
We recently switched from the gradle Distribution plugin to the Maven publishing plugin, so the commands there are different now. What are you trying to accomplish?

brynrhodes, 2023-10-11:
Closing this issue as stale, feel free to reopen or submit a new issue if you are still having problems

Closed 2023-10-11.

Thread 1223 (2023-09-06):

USCore 3.1.1 - Patient.name.given

jbyrdevans, 2023-09-06:
Error `Could not resolve data provider for package 'java.util'` encountered for `Execute CQL` for USCore v3.1.1 Patient.name.given[0].

CQL:
```
library Repro version '0.1.0'

using USCore version '3.1.1'
//using FHIR version '4.0.1'

include FHIRHelpers version '4.0.1'

context Patient

define "Name":
  Patient.name.given[0]
```

Patient:
```
{
  "resourceType": "Patient",
  "id": "USCorePatient-2",
  "meta": {
    "profile": [
      "http://hl7.org/fhir/us/core/StructureDefinition/us-core-patient"
    ]
  },
  "identifier": [
    {
      "use": "usual",
      "type": {
        "coding": [
          {
            "code": "MR",
            "system": "http://terminology.hl7.org/CodeSystem/v2-0203",
            "display": "Medical Record Number"
          }
        ]
      },
      "system": "urn:oid:1.2.36.146.595.217.0.1",
      "value": "12345",
      "period": {
        "start": "2001-05-06"
      },
      "assigner": {
        "display": "Acme Healthcare"
      }
    }
  ],
  "active": true,
  "name": [
    {
      "use": "official",
      "family": "Chalmers",
      "given": [
        "James"
      ]
    }
  ],
  "gender": "male",
  "birthDate": "1974-12-25",
  "deceasedBoolean": false,
  "maritalStatus": {
    "coding": [
      {
        "code": "M",
        "system": "http://terminology.hl7.org/CodeSystem/v3-MaritalStatus"
      }
    ]
  }
}
```

Result:
```
Evaluation logs:
15:58:11.736 [pool-2-thread-1] INFO  ca.uhn.fhir.context.FhirContext - Creating new FHIR context for FHIR version [R4]
Could not resolve data provider for package 'java.util'.
```

NataliaSmileDigital, 2023-10-04:
Created a new ticket for this work because I couldn't assign it to Inaam

p9g, 2023-10-05:
https://github.com/cqframework/clinical_quality_language/issues/1231

Closed 2023-10-04.

Thread 1225 (2023-09-06):

USCore 3.1.1 - Patient.address.line

jbyrdevans, 2023-09-06:
Error `Could not resolve data provider for package 'java.util'` encountered for `Execute CQL` for USCore v3.1.1 Patient.address.line.

CQL:
```
library Repro version '0.1.0'

using USCore version '3.1.1'
//using FHIR version '4.0.1'

include FHIRHelpers version '4.0.1'

context Patient

define "Address":
  Patient.address.line

define "Address Line 1":
  Patient.address.line[0]
```

Patient:
```
{
  "resourceType": "Patient",
  "id": "USCorePatient-2",
  "meta": {
    "profile": [
      "http://hl7.org/fhir/us/core/StructureDefinition/us-core-patient"
    ]
  },
  "identifier": [
    {
      "use": "usual",
      "type": {
        "coding": [
          {
            "code": "MR",
            "system": "http://terminology.hl7.org/CodeSystem/v2-0203",
            "display": "Medical Record Number"
          }
        ]
      },
      "system": "urn:oid:1.2.36.146.595.217.0.1",
      "value": "12345",
      "period": {
        "start": "2001-05-06"
      },
      "assigner": {
        "display": "Acme Healthcare"
      }
    }
  ],
  "active": true,
  "name": [
    {
      "use": "official",
      "family": "Chalmers",
      "given": [
        "James"
      ]
    }
  ],
  "gender": "male",
  "birthDate": "1974-12-25",
  "deceasedBoolean": false,
  "maritalStatus": {
    "coding": [
      {
        "code": "M",
        "system": "http://terminology.hl7.org/CodeSystem/v3-MaritalStatus"
      }
    ]
  },
  "address": [
    {
      "use": "home",
      "type": "both",
      "text": "534 Erewhon St PeasantVille, Utah 84414",
      "line": [
        "534 Erewhon St"
      ],
      "city": "PleasantVille",
      "district": "Rainbow",
      "state": "UT",
      "postalCode": "84414",
      "period": {
        "start": "1974-12-25"
      }
    }
  ]
}
```

Result:
```
Evaluation logs:
16:08:15.253 [pool-2-thread-1] INFO  ca.uhn.fhir.context.FhirContext - Creating new FHIR context for FHIR version [R4]
Could not resolve data provider for package 'java.util'.
```

JPercival, 2023-10-18:
Potential dup of https://github.com/cqframework/clinical_quality_language/issues/1231. Retest

ddieppois, 2023-10-26:
So I've been able to translate this using CQL-to-elm-cli

`================================================================================
TRANSLATE /Users/daviddieppois/Documents/git/clinical_quality_language/Examples/TestLibrary_1186.cql
SLF4J: Failed to load class "org.slf4j.impl.StaticLoggerBinder".
SLF4J: Defaulting to no-operation (NOP) logger implementation
SLF4J: See http://www.slf4j.org/codes.html#StaticLoggerBinder for further details.
Translation completed successfully.
ELM output written to: /Users/daviddieppois/Documents/git/clinical_quality_language/Examples/TestLibrary_1186.xml
`

XML coming back is

`<?xml version="1.0" encoding="UTF-8"?>
<library xmlns="urn:hl7-org:elm:r1" xmlns:t="urn:hl7-org:elm-types:r1" xmlns:xsi="http://www.w3.org/2001/XMLSchema-instance" xmlns:xsd="http://www.w3.org/2001/XMLSchema" xmlns:fhir="http://hl7.org/fhir" xmlns:qdm43="urn:healthit-gov:qdm:v4_3" xmlns:qdm53="urn:healthit-gov:qdm:v5_3" xmlns:a="urn:hl7-org:cql-annotations:r1">
   <annotation translatorVersion="3.3.0-SNAPSHOT" translatorOptions="" signatureLevel="None" xsi:type="a:CqlToElmInfo"/>
   <identifier id="Repro" version="0.1.0"/>
   <schemaIdentifier id="urn:hl7-org:elm" version="r1"/>
   <usings>
      <def localIdentifier="System" uri="urn:hl7-org:elm-types:r1"/>
      <def localIdentifier="USCore" uri="http://hl7.org/fhir"/>
   </usings>
   <includes>
      <def localIdentifier="FHIRHelpers" path="FHIRHelpers" version="4.0.1"/>
   </includes>
   <contexts>
      <def name="Patient"/>
   </contexts>
   <statements>
      <def name="Patient" context="Patient">
         <expression xsi:type="SingletonFrom">
            <operand dataType="fhir:Patient" templateId="http://hl7.org/fhir/us/core/StructureDefinition/us-core-patient" xsi:type="Retrieve"/>
         </expression>
      </def>
      <def name="Address" context="Patient" accessLevel="Public">
         <expression xsi:type="Flatten">
            <operand xsi:type="Query">
               <source alias="$this">
                  <expression path="address" xsi:type="Property">
                     <source name="Patient" xsi:type="ExpressionRef"/>
                  </expression>
               </source>
               <where xsi:type="Not">
                  <operand xsi:type="IsNull">
                     <operand path="value" xsi:type="Property">
                        <source path="line" xsi:type="Property">
                           <source name="$this" xsi:type="AliasRef"/>
                        </source>
                     </operand>
                  </operand>
               </where>
               <return distinct="false">
                  <expression path="value" xsi:type="Property">
                     <source path="line" xsi:type="Property">
                        <source name="$this" xsi:type="AliasRef"/>
                     </source>
                  </expression>
               </return>
            </operand>
         </expression>
      </def>
      <def name="Address Line 1" context="Patient" accessLevel="Public">
         <expression xsi:type="Indexer">
            <operand xsi:type="Flatten">
               <operand xsi:type="Query">
                  <source alias="$this">
                     <expression path="address" xsi:type="Property">
                        <source name="Patient" xsi:type="ExpressionRef"/>
                     </expression>
                  </source>
                  <where xsi:type="Not">
                     <operand xsi:type="IsNull">
                        <operand path="value" xsi:type="Property">
                           <source path="line" xsi:type="Property">
                              <source name="$this" xsi:type="AliasRef"/>
                           </source>
                        </operand>
                     </operand>
                  </where>
                  <return distinct="false">
                     <expression path="value" xsi:type="Property">
                        <source path="line" xsi:type="Property">
                           <source name="$this" xsi:type="AliasRef"/>
                        </source>
                     </expression>
                  </return>
               </operand>
            </operand>
            <operand valueType="t:Integer" value="0" xsi:type="Literal"/>
         </expression>
      </def>
   </statements>
</library>

`
@jbyrdevans what command did you use. ?

Closed 2023-11-09.

Thread 1219 (2023-09-27):

Add support for `id` and `idPath` in ELM

JPercival, 2023-09-27:
In CQL, you can retrieve an object via its id property by doing something like this:

```
[ Encounter ] E where E.id = '123`
```

or, alternatively:

```
[ Encounter: id in { '123' } ]
```

Currently, the CQL compiler emits that as a filter by `codes` and `codePath`.  In other words, the emitted ELM contains a Retrieve where `codes = { '123' }` and `codepath = 'id'` as if it were a terminology operation. Ideally, the CQL compiler would correctly detect this correct and emit ELM with `id = '123'` and `idPath = 'id'`.

There are several places we need to update to support this correctly:
1. ModelInfos (or at least ModelResolvers) need to have the idPath added (if absent)
2. The compiler needs to check the where the path that's accessed is an id, and if so emit `id` and `idPath` accordingly
3. The `RetrieveProvider` interface and the RetrieveEvaluator in the engine need to be updated to have `id` and `idPath`
4. The implementations of `RetrieveProvider` need to add support for that path.

Thread 1220 (2023-09-27):

Implement query restriction pushdown for Id

JPercival, 2023-09-27:
The CQL engine currently supports certain types of query restriction pushdowns, specifically for date filters. In other words, given the following CQL:

```
[ Condition ] C where C.onset starts 30 days or less before Today()
```

the CQL compiler can emit an ELM Retrieve that has that date filter captured in the `datePath` and `dateLow` elements.

Ideally, we could support the same type of push-downs for `Retrieve`s by id. In other words, these two statements _ought to be equivalent with respect to the ELM that's generated:

```
[Medication] M where M.id = `123`
```
```
[Medication: id in {'123'}]
```

And the ELM that's generated for the `Retrieve`  ought to have both the `id` and the `idProperty` populated in both cases.

brynrhodes, 2023-09-27:
Note that it's the DataRequirementsProcessor that does these types of optimizations as a post-processing step. There is some date range pushdown in the translator directly, but it's not as sophisticated as what the DataRequirementsProcessor is doing, and should be deprecated in favor of the DataRequirementsProcessor, IMHO.

JPercival, 2023-09-27:
Just to clarify, are you saying that we should always do pushdown as post-processing? Including for Ids?

Thread 1231 (2023-10-04):

USCore 3.1.1 - Patient.name.given

NataliaSmileDigital, 2023-10-04:
Error `Could not resolve data provider for package 'java.util'` encountered for `Execute CQL` for USCore v3.1.1 Patient.name.given[0].

CQL:
```
library Repro version '0.1.0'

using USCore version '3.1.1'
//using FHIR version '4.0.1'

include FHIRHelpers version '4.0.1'

context Patient

define "Name":
  Patient.name.given[0]
```

Patient:
```
{
  "resourceType": "Patient",
  "id": "USCorePatient-2",
  "meta": {
    "profile": [
      "http://hl7.org/fhir/us/core/StructureDefinition/us-core-patient"
    ]
  },
  "identifier": [
    {
      "use": "usual",
      "type": {
        "coding": [
          {
            "code": "MR",
            "system": "http://terminology.hl7.org/CodeSystem/v2-0203",
            "display": "Medical Record Number"
          }
        ]
      },
      "system": "urn:oid:1.2.36.146.595.217.0.1",
      "value": "12345",
      "period": {
        "start": "2001-05-06"
      },
      "assigner": {
        "display": "Acme Healthcare"
      }
    }
  ],
  "active": true,
  "name": [
    {
      "use": "official",
      "family": "Chalmers",
      "given": [
        "James"
      ]
    }
  ],
  "gender": "male",
  "birthDate": "1974-12-25",
  "deceasedBoolean": false,
  "maritalStatus": {
    "coding": [
      {
        "code": "M",
        "system": "http://terminology.hl7.org/CodeSystem/v3-MaritalStatus"
      }
    ]
  }
}
```

Result:
```
Evaluation logs:
15:58:11.736 [pool-2-thread-1] INFO  ca.uhn.fhir.context.FhirContext - Creating new FHIR context for FHIR version [R4]
Could not resolve data provider for package 'java.util'.
```

JPercival, 2023-10-13:
Closed by #1247

Closed 2023-10-13.

Thread 1243 (2023-10-12):

Change handling of potentially ambiguous method overloads

lukedegruchy, 2023-10-12:
See https://github.com/cqframework/clinical_quality_language/issues/1127

After this fix was merged, @brynrhodes suggested some fixes:

1. Leverage the OperatorMap to implement this check in `LibraryBuilder#resolveInvocation` instead of `validateAmbiguousOverloadedForwardDeclarationsSignatureNone()`, specifically, around the block that checks the SignatureLevel
2. Consider making this a warning and not an error
3. Consider checking this only if the function(s) in question are called, not if they merely exist in the CQL or in the library in question

brynrhodes, 2023-10-12:
Note that per some internal discussion, the implementation here is just to change this logic:

https://github.com/cqframework/clinical_quality_language/blob/master/Src/java/cql-to-elm/src/main/java/org/cqframework/cql/cql2elm/LibraryBuilder.java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

So that in the case that we have resolved an overload with a different invocation signature than the declaration signature and the signatureLevel is None, that we issue a warning, not an error.

The warning should say "Function invocation has a different signature than the declaration and the SignatureLevel is set to none. This may result in ambiguous function resolution at runtime, consider setting the SignatureLevel to higher than None."

Specifically, I'm trying to make sure the message doesn't say anything about forwards, because it's not about forwards, this happens regardless of whether the function is a forward declaration.

Also, the default options in the translator were changed to SignatureLevel.Overloads, and we should switch that back to None.

JPercival, 2023-10-23:
Resolved by #1251

Closed 2023-10-23.

Thread 1272 (2023-11-06):

Assistance required with Error message in CQL Library Editor

Svellanky1, 2023-11-06:
We are receiving the following errors in CQL Library Editor after editing the value set name for one of the value sets used:
ERRORS:
********************************************************************************************************************
Line 160: Could not validate reference to expression Active Exclusion Diagnosis at Start of ED Encounter because its definition contains errors.
Line 184: Could not resolve identifier Pregnancy (ICD10CM and SNOMEDCT) in the current library.
*******************************************************************************************************************/

The relevant lines from the CQL code are below:
156
157 define "Denominator Exclusions":
158   "Allergy or Intolerance to Thrombolytic Medications Overlaps ED Encounter"
159     union "Adverse Effect to Thrombolytic Medications Before End of ED Encounter"
**160     union "Active Exclusion Diagnosis at Start of ED Encounter"**
161     union "Active Oral Anticoagulant Medication at the Start of ED Encounter"
162     union "Exclusion Diagnosis During ED Encounter or Within 24 Hours of ED Encounter Start"
163     union "Major Surgical Procedure 21 Days or Less Before Start of or Starts During ED Encounter"
164     union "Intubation or Mechanical Circulatory Assist Procedure During ED Encounter or Within 24 Hours of ED Encounter Start"
165     union "Active Exclusion Diagnosis Within 90 Days Before or At the Start of ED Encounter"
166     union "Intracranial or Intraspinal Procedure 90 Days or Less Before Start of ED Encounter"
167     union "ED Encounter with Discharge Disposition as Patient Expired"
168
169 define "Active Oral Anticoagulant Medication at the Start of ED Encounter":
170   "ED Encounter with STEMI Diagnosis" EDwSTEMI
171     with ["Medication, Active": "Oral Anticoagulant Medications"] OralAnticoagulant
172       such that ( Global.HasStart ( OralAnticoagulant.relevantPeriod )
173           and OralAnticoagulant.relevantPeriod starts before or on start of EDwSTEMI.relevantPeriod
174           and OralAnticoagulant.relevantPeriod ends on or after start of EDwSTEMI.relevantPeriod
175       )
176         or ( OralAnticoagulant.relevantDatetime before or on EDwSTEMI.relevantPeriod )
177
178 define "Active Exclusion Diagnosis at Start of ED Encounter":
179   "ED Encounter with STEMI Diagnosis" EDwSTEMI
180     with ( ["Diagnosis": "Active Bleeding Excluding Menses or Bleeding Diathesis"]
181       union ["Diagnosis": "Malignant Intracranial Neoplasm Group"]
182       union ["Diagnosis": "Cerebral Vascular Lesion"]
183       union ["Diagnosis": "Dementia and Related Intracranial Pathologies"]
**184       union ["Diagnosis": "Pregnancy (ICD10CM and SNOMEDCT)"]**
185       union ["Diagnosis": "Allergy to thrombolytics"] ) ActiveExclusionDx
186       such that ActiveExclusionDx.prevalencePeriod overlaps before EDwSTEMI.relevantPeriod

Would you please let us know how to resolve this error? The value set has been updated in the workspace. Is there another step we are missing?

JPercival, 2023-11-06:
Hi @Svellanky1! Thanks for the report. What is the "CQL Library Editor" you are referring to? At first glance it looks like you're missing a Value Set definition. It will look something like the following, but replace the example URL below with the correct one for your scenario.

```
valueset "Pregnancy (ICD10CM and SNOMEDCT)" : 'example.com/valueset/123`
```

Svellanky1, 2023-11-06:
Hi @JPercival, thank you for your response. Apologies for the confusion, we are trying to edit the specifications for our measure in the MAT in the CQL workspace. This is where the error is showing up. Does that help?

In terms of the value set definition, we have that in the specifications already as:
**valueset "Pregnancy (ICD10 and SNOMEDCT)": 'urn:oid:2.16.840.1.113883.3.3157.4055'**
All other value sets are similarly defined but if there is anything additional that we need to do please let us know.

Thank you!

JPercival, 2023-11-06:
Hmm... It's not obvious to me where the issue is given that you've already defined the valueset. The MAT tool is actually "downstream" from this project. The Github org for MAT is here:

https://github.com/MeasureAuthoringTool

You may have better luck diagnosing the issue there.

Svellanky1, 2023-11-15:
Thank you for your assistance, @JPercival

Closed 2023-11-15.

Thread 1290 (2023-11-23):

Remove exceptions printing stack traces

JPercival, 2023-11-23:
At various places in the CQL libraries Exceptions are caught and stack traces are printed such as here:

https://github.com/cqframework/clinical_quality_language/blob/master/Src/java/quick/src/main/java/org/cqframework/cql/cql2elm/quick/FhirModelInfoProvider.java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

For a core library included in other components, this bypasses whatever other logging mechanisms may be in place (such as slf4j, log4j, etc) and prints directly to the std error output stream. This means some diagnostic logging may be lost, and it also pollutes the output stream in cases where that's not desirable. For example, with the use of CLI tools.

We should remove all instances of `Exception::printStackTrace()` and either rethrow exceptions, log via a logging API, or ignore as appropriately.

The one exception to that rule is in the case where we're intentionally building a CLI.

JPercival, 2023-11-23:
second exception to the rule: Test code. :)

Thread 1295 (2023-11-29):

Elm Translator: Missing localId for choice type properties

birick1, 2023-11-29:
This issue arises from ticket https://github.com/projecttacoma/fqm-execution/issues/290 coming from a MADiE user issue.

For this CQL:

```
define "Has Medical or Patient Reason for Not Ordering Beta Blocker for LVSD":
  exists ( ["MedicationNotRequested"] NoBetaBlockerOrdered
      with AHA."Heart Failure Outpatient Encounter with History of Moderate or Severe LVSD" ModerateOrSevereLVSDHFOutpatientEncounter
        such that NoBetaBlockerOrdered.authoredOn during ModerateOrSevereLVSDHFOutpatientEncounter.period
      where NoBetaBlockerOrdered.medication in "Beta Blocker Therapy for LVSD"
        and ( NoBetaBlockerOrdered.reasonCode in "Medical Reason"
            or NoBetaBlockerOrdered.reasonCode in "Patient Reason"
        )
  )
```

With the correct set of patients, we should see “NoBetaBlockerOrdered.medication” highlighted.  However, it is not highlighted as seen below:

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

The root cause for lack of highlighting is that the ELM is missing the localId for the expression.  To see this, the generated ELM for this expression is as follows:

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

With the arrows pointing at the location where a localId should be found.

What’s particularly odd is that a localId for this expression does exist in the annotations:

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

It is likely a bug that the localId exists in the annotation, but not the ELM expression.  If the annotation is added to the ELM as expected:

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

Then highlighting works as expected (Note: the localId could also be placed in the “code” clause):

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

Closed 2024-01-05.

Thread 1314 (2024-01-08):

Failed to load class "org.slf4j.impl.StaticLoggerBinder" during cql-to-elm-cli

MatthewDynamic, 2024-01-08:
I am getting a `Failed to load class "org.slf4j.impl.StaticLoggerBinder"`
Here is the command I am running
`.\cql-to-elm-cli\build\install\cql-to-elm-cli\bin\cql-to-elm-cli --input "..\..\Examples\ChlamydiaScreening_CQM.cql"`

The full output is as follows:

```
================================================================================
TRANSLATE ..\..\Examples\ChlamydiaScreening_CQM.cql
SLF4J: Failed to load class "org.slf4j.impl.StaticLoggerBinder".
SLF4J: Defaulting to no-operation (NOP) logger implementation
SLF4J: See http://www.slf4j.org/codes.html#StaticLoggerBinder for further details.
Translation failed due to errors:
Error:[1:1, 56:5] jakarta.xml.bind.JAXBException: Implementation of Jakarta XML Binding-API has not been found on module path or classpath.
 - with linked exception:
[java.lang.ClassNotFoundException: org.glassfish.jaxb.runtime.v2.ContextFactory]
Error:[5:1, 5:69] Could not resolve model name System
Error:[6:1, 6:91] Could not resolve model name System
Error:[7:1, 7:69] Could not resolve model name System
Error:[8:1, 8:98] Could not resolve model name System
Error:[9:1, 9:106] Could not resolve model name System
Error:[10:1, 10:64] Could not resolve model name System
Error:[11:1, 11:58] Could not resolve model name System
Error:[12:1, 12:63] Could not resolve model name System
Error:[13:1, 13:112] Could not resolve model name System
Error:[14:1, 14:69] Could not resolve model name System
Error:[15:1, 15:63] Could not resolve model name System
Error:[16:1, 16:81] Could not resolve model name System
Error:[17:1, 17:100] Could not resolve model name System
Error:[18:1, 18:74] Could not resolve model name System
Error:[20:55, 20:58] Could not resolve model name System
Error:[20:61, 20:61] Could not resolve model name System
Error:[20:64, 20:64] Could not resolve model name System
Error:[20:67, 20:67] Could not resolve model name System
Error:[20:70, 20:70] Could not resolve model name System
Error:[20:73, 20:73] Could not resolve model name System
Error:[20:76, 20:76] Could not resolve model name System
Error:[20:46, 20:77] Could not determine signature for invocation of operator DateTime.
Error:[20:89, 20:92] Could not resolve model name System
Error:[20:95, 20:95] Could not resolve model name System
Error:[20:98, 20:98] Could not resolve model name System
Error:[20:101, 20:101] Could not resolve model name System
Error:[20:104, 20:104] Could not resolve model name System
Error:[20:107, 20:107] Could not resolve model name System
Error:[20:110, 20:110] Could not resolve model name System
Error:[20:80, 20:111] Could not determine signature for invocation of operator DateTime.
Error:[20:37, 20:112] Internal translator error.
Error:[20:1, 20:112] Could not determine parameter type for parameter MeasurementPeriod.
Error:[22:1, 22:15] Internal translator error.
Error:[25:24, 25:40] Could not resolve identifier MeasurementPeriod in the current library.
Error:[29:10, 29:62] Could not resolve type name Condition.
Error:[43:2, 43:16] Could not validate reference to expression InDemographic because its definition contains errors.
Error:[46:2, 46:5] Could not resolve model name System
Error:[49:10, 49:52] Could not resolve type name DiagnosticReport.
Error:[51:1, 51:18] Internal translator error.
Error:[53:31, 53:37] Could not resolve identifier Patient in the current library.
```

I am new to this code and unsure whether the example files should actually work or not. But I cannot get any of my own CQL files to convert either.

Before this against the last code from master branch I was able to run
`gradlew build`
which only failed to build task :cql-to-elm:test
and
`gradlew installDist`
which executed successfully.

Any advice appreciated,
Matthew Dugal

MatthewDynamic, 2024-01-09:
On second thought, maybe this is the actual error.

```
jakarta.xml.bind.JAXBException: Implementation of Jakarta XML Binding-API has not been found on module path or classpath.
 - with linked exception:
[java.lang.ClassNotFoundException: org.glassfish.jaxb.runtime.v2.ContextFactory]
```

JPercival, 2024-01-20:
Thanks for the report! The slf4j and jaxb errors are fixed in this PR which should be reviewed and merged shortly:
https://github.com/cqframework/clinical_quality_language/pull/1319

I took a look at the CQL examples and they are quite out of date, written for an earlier version of the spec. We'll have to go through and update those. That said, this should run cleanly for you now:
`./cql-to-elm-cli/build/install/cql-to-elm-cli/bin/cql-to-elm-cli --input ../../Examples/CMS135_QDM.cql`

It's a different example than you were using previously.

JPercival, 2024-01-20:
See #462 for examples being out of date.

JPercival, 2024-01-22:
That changed has been merged to master. Try the following:

`gradlew build`
`./cql-to-elm-cli/build/install/cql-to-elm-cli/bin/cql-to-elm-cli --input ../../Examples/CMS135_QDM.cql`

Closed 2024-01-22.

Thread 1317 (2024-01-17):

Task :engine:compileTestJava FAILED

MatthewDynamic, 2024-01-17:
Performing
`gradlew build `
as per
[https://github.com/cqframework/clinical_quality_language/blob/master/Src/java/README.md](https://github.com/cqframework/clinical_quality_language/blob/master/Src/java/README.md)
produces

```
> Task :engine:compileTestJava
D:\Development\_CQF\clinical_quality_language\Src\java\engine\src\test\java\org\opencds\cqf\cql\engine\model\CachingModelResolverDecoratorTest.java:43: warning: [deprecation] getPackageName() in ModelResolver has been deprecated
        when(m.getPackageName()).thenReturn("test.package");
              ^
D:\Development\_CQF\clinical_quality_language\Src\java\engine\src\test\java\org\opencds\cqf\cql\engine\model\CachingModelResolverDecoratorTest.java:58: warning: [deprecation] getPackageName() in ModelResolver has been deprecated
        when(m.getPackageName()).thenReturn("test.package");
              ^
D:\Development\_CQF\clinical_quality_language\Src\java\engine\src\test\java\org\opencds\cqf\cql\engine\runtime\DateTimeTest.java:356: error: cannot find symbol
        dateTime2 = new DateTime(BigDecimal.TWO, 2020);
                                           ^
  symbol:   variable TWO
  location: class BigDecimal
1 error
2 warnings

> Task :engine:compileTestJava FAILED

FAILURE: Build failed with an exception.

* What went wrong:
Execution failed for task ':engine:compileTestJava'.
```

Hi. It's been a few weeks and I am still unable to compile this project.

Since I have been struggling to compile this code for multiple weeks now, is my approach incorrect? I am trying to follow the instructions at Src/java/README.md. Am I following the wrong path? Are there different resources I can use to get this stuff running?

Thank you,
Matthew Dugal

JPercival, 2024-01-18:
Looks like a Java 19 API snuck into the test code. Reverted to target 11. Changes are merged to `master`, give it go! :)

JPercival, 2024-01-19:
The build on the `master` branch is currently passing in CI:
https://github.com/cqframework/clinical_quality_language/actions/runs/7565120881/job/20600348682

Could you try a clean checkout?

JPercival, 2024-01-31:
Any updates here @MatthewDynamic ?

JPercival, 2024-02-12:
@MatthewDynamic - Do you happen to be on windows? We found a couple platform-specific issues with the tests that have been fixed.

Closed 2024-03-01.

Thread 1320 (2024-01-31):

cql-to-elm doesn't work

bkaney, 2024-01-31:
I checked out v3.6.0 tag and did the following per README:

```
./gradlew :cql-to-elm-cli:installDist
./cql-to-elm-cli/build/install/cql-to-elm-cli/bin/cql-to-elm-cli --input ../../Examples/ChlamydiaScreening_CQM.cql
```

I get this output:
```
================================================================================
TRANSLATE ../../Examples/ChlamydiaScreening_CQM.cql
SLF4J: Failed to load class "org.slf4j.impl.StaticLoggerBinder".
SLF4J: Defaulting to no-operation (NOP) logger implementation
SLF4J: See http://www.slf4j.org/codes.html#StaticLoggerBinder for further details.
Translation failed due to errors:
Error:[1:1, 56:5] jakarta.xml.bind.JAXBException: Implementation of Jakarta XML Binding-API has not been found on module path or classpath.
 - with linked exception:
[java.lang.ClassNotFoundException: org.glassfish.jaxb.runtime.v2.ContextFactory]
Error:[5:1, 5:69] Could not resolve model name System
Error:[6:1, 6:91] Could not resolve model name System
Error:[7:1, 7:69] Could not resolve model name System
Error:[8:1, 8:98] Could not resolve model name System
Error:[9:1, 9:106] Could not resolve model name System
Error:[10:1, 10:64] Could not resolve model name System
Error:[11:1, 11:58] Could not resolve model name System
Error:[12:1, 12:63] Could not resolve model name System
Error:[13:1, 13:112] Could not resolve model name System
Error:[14:1, 14:69] Could not resolve model name System
Error:[15:1, 15:63] Could not resolve model name System
Error:[16:1, 16:81] Could not resolve model name System
Error:[17:1, 17:100] Could not resolve model name System
Error:[18:1, 18:74] Could not resolve model name System
Error:[20:55, 20:58] Could not resolve model name System
Error:[20:61, 20:61] Could not resolve model name System
Error:[20:64, 20:64] Could not resolve model name System
Error:[20:67, 20:67] Could not resolve model name System
Error:[20:70, 20:70] Could not resolve model name System
Error:[20:73, 20:73] Could not resolve model name System
Error:[20:76, 20:76] Could not resolve model name System
Error:[20:46, 20:77] Could not determine signature for invocation of operator DateTime.
Error:[20:89, 20:92] Could not resolve model name System
Error:[20:95, 20:95] Could not resolve model name System
Error:[20:98, 20:98] Could not resolve model name System
Error:[20:101, 20:101] Could not resolve model name System
Error:[20:104, 20:104] Could not resolve model name System
Error:[20:107, 20:107] Could not resolve model name System
Error:[20:110, 20:110] Could not resolve model name System
Error:[20:80, 20:111] Could not determine signature for invocation of operator DateTime.
Error:[20:37, 20:112] Cannot invoke "org.hl7.cql.model.DataType.isSubTypeOf(org.hl7.cql.model.DataType)" because "second" is null
Error:[20:1, 20:112] Could not determine parameter type for parameter MeasurementPeriod.
Error:[22:1, 22:15] Cannot invoke "org.hl7.cql.model.ModelContext.getName()" because "modelContext" is null
Error:[25:24, 25:40] Could not resolve identifier MeasurementPeriod in the current library.
Error:[29:10, 29:62] Could not resolve type name Condition.
Error:[43:2, 43:16] Could not validate reference to expression InDemographic because its definition contains errors.
Error:[46:2, 46:5] Could not resolve model name System
Error:[49:10, 49:52] Could not resolve type name DiagnosticReport.
Error:[51:1, 51:18] Cannot invoke "org.hl7.cql.model.ModelContext.getName()" because "modelContext" is null
Error:[53:31, 53:37] Could not resolve identifier Patient in the current library.

```

richfirely, 2024-01-31:
I came here to report the same and found this:
https://github.com/cqframework/clinical_quality_language/issues/1314
https://github.com/cqframework/clinical_quality_language/pull/1319

JPercival, 2024-01-31:
Already fixed on master:
https://github.com/cqframework/clinical_quality_language/pull/1319

Closed 2024-01-31.

Thread 1336 (2024-03-05):

Issue a warning if ambiguous overloads are created using choice types

brynrhodes, 2024-03-05:
Allowing the following:

```
define function Foo(t Integer)
define function Foo(t Choice<Integer, Decimal>)
```

Results in a potentially ambiguous overload selection and should be discouraged. Add a warning to the translator when this case is detected (i.e. a function with a choice signature is overloaded in a way that one signature completely includes another)

brynrhodes, 2024-03-05:
There is a JIRA tracker to the specification to discourage this in the spec and consider deprecating the capability: https://jira.hl7.org/browse/FHIR-44879

Thread 1338 (2024-03-12):

LocalIds in annotations missing in ELM nodes

birick1, 2024-03-12:
While investigating coverage calculation and highlighting post ELM translator v3.6.0, we identified at least one case where there are localIds in the annotation but not in the ELM expression.  This leads to a problem in correctly highlighting statements for coverage.

This item is raised in JIRA at https://oncprojectracking.healthit.gov/support/browse/CQLIT-432

For example, we are finding this to be an issue with CQL Query relationships (i.e. `with`). In the ELM json for AHAOverall-2.6.000.json (in MAT6725-v0.0.000-FHIR4_Bad), the `localId` 309 that we need for highlighting of the `HeartFailure` alias is only present in the ELM annotation but not in the ELM expressions. We were able to replicate this error with a smaller CQL file that contained a with statement.

Attaching referenced file, and more info can be found in the JIRA ticket: [MAT6725-v0.0.000-FHIR4_Bad.zip](https://github.com/cqframework/clinical_quality_language/files/14578489/MAT6725-v0.0.000-FHIR4_Bad.zip)

JPercival, 2024-04-04:
The generated ELM for that with the latest CQL release includes a `localId` for that `HeartFailure` alias:

```xml
<relationship localId="81" locator="41:5-43:53" alias="HeartFailure" xsi:type="With">
               <resultTypeSpecifier xsi:type="ListTypeSpecifier">
                  <elementType name="fhir:Condition" xsi:type="NamedTypeSpecifier"/>
               </resultTypeSpecifier>
               <expression localId="41" locator="41:10-41:37" dataType="fhir:Condition" templateId="http://hl7.org/fhir/us/qicore/StructureDefinition/qicore-condition" codeProperty="code" codeComparator="in" xsi:type="Retrieve">
                  <resultTypeSpecifier xsi:type="ListTypeSpecifier">
                     <elementType name="fhir:Condition" xsi:type="NamedTypeSpecifier"/>
                  </resultTypeSpecifier>
                  <codes locator="41:22-41:36" resultTypeName="t:ValueSet" name="Heart Failure" preserve="true" xsi:type="ValueSetRef"/>
               </expression>
               <suchThat localId="80" locator="42:17-43:53" resultTypeName="t:Boolean" xsi:type="And">
                  <signature name="t:Boolean" xsi:type="NamedTypeSpecifier"/>
                  <signature name="t:Boolean" xsi:type="NamedTypeSpecifier"/>
                  <operand localId="47" locator="42:17-42:85" resultTypeName="t:Boolean" xsi:type="Overlaps">
                     <signature xsi:type="IntervalTypeSpecifier">
                        <pointType name="t:DateTime" xsi:type="NamedTypeSpecifier"/>
                     </signature>
                     <signature xsi:type="IntervalTypeSpecifier">
                        <pointType name="t:DateTime" xsi:type="NamedTypeSpecifier"/>
                     </signature>
                     <operand localId="44" locator="42:17-42:49" name="prevalenceInterval" libraryName="QICoreCommon" xsi:type="FunctionRef">
                        <resultTypeSpecifier xsi:type="IntervalTypeSpecifier">
                           <pointType name="t:DateTime" xsi:type="NamedTypeSpecifier"/>
                        </resultTypeSpecifier>
                        <signature name="fhir:Condition" xsi:type="NamedTypeSpecifier"/>
                        <operand localId="43" locator="42:17-42:28" resultTypeName="fhir:Condition" name="HeartFailure" xsi:type="AliasRef"/>
                     </operand>
                     <operand localId="46" locator="42:60-42:85" name="ToInterval" libraryName="FHIRHelpers" xsi:type="FunctionRef">
                        <resultTypeSpecifier xsi:type="IntervalTypeSpecifier">
                           <pointType name="t:DateTime" xsi:type="NamedTypeSpecifier"/>
                        </resultTypeSpecifier>
                        <operand path="period" scope="QualifyingEncounter" xsi:type="Property"/>
                     </operand>
                  </operand>
                  <operand localId="79" locator="43:13-43:53" resultTypeName="t:Boolean" name="isConfirmedActiveDiagnosis" xsi:type="FunctionRef">
                     <signature name="fhir:Condition" xsi:type="NamedTypeSpecifier"/>
                     <operand localId="48" locator="43:13-43:24" resultTypeName="fhir:Condition" name="HeartFailure" xsi:type="AliasRef"/>
                  </operand>
               </suchThat>
            </relationship>
```

Are you seeing this only on JSON?

birick1, 2024-04-05:
Yes - we are only looking at the JSON.

JPercival, 2024-04-09:
I've been unable to replicate the issue but perhaps I'm misunderstanding issue. Here's a simplified example CQL definition and a subset of the associated JSON being produced by the CQL compiler. Could you point out to me where you're expecting localId to appear?

```cql
define "Encounter with Condition":
  [Encounter] E
    with [Condition] C
      such that C.onset overlaps E.period
```

```json
    "statements" : {
      "type" : "Library$Statements",
      "def" : [ {
        "type" : "ExpressionDef",
        "expression" : {
          "type" : "Query",
          "source" : [ {
            "type" : "AliasedQuerySource",
            "expression" : {
              "type" : "Retrieve",
              "localId" : "211",
              "locator" : "8:3-8:13",
              "dataType" : "{http://hl7.org/fhir}Encounter",
              "templateId" : "http://hl7.org/fhir/StructureDefinition/Encounter"
            },
            "localId" : "210",
            "locator" : "8:3-8:15",
            "alias" : "E"
          } ],
          "relationship" : [ {
            "type" : "With",
            "expression" : {
              "type" : "Retrieve",
              "localId" : "213",
              "locator" : "9:10-9:20",
              "dataType" : "{http://hl7.org/fhir}Condition",
              "templateId" : "http://hl7.org/fhir/StructureDefinition/Condition"
            },
            "suchThat" : {
              "type" : "Overlaps",
              "signature" : [ {
                "type" : "IntervalTypeSpecifier",
                "pointType" : {
                  "type" : "NamedTypeSpecifier",
                  "localId" : "225",
                  "name" : "{urn:hl7-org:elm-types:r1}DateTime"
                },
                "localId" : "224"
              }, {
                "type" : "IntervalTypeSpecifier",
                "pointType" : {
                  "type" : "NamedTypeSpecifier",
                  "localId" : "227",
                  "name" : "{urn:hl7-org:elm-types:r1}DateTime"
                },
                "localId" : "226"
              } ],
              "operand" : [ {
                "type" : "FunctionRef",
                "signature" : [ {
                  "type" : "NamedTypeSpecifier",
                  "localId" : "221",
                  "name" : "{http://hl7.org/fhir}Period"
                } ],
                "operand" : [ {
                  "type" : "As",
                  "operand" : {
                    "type" : "Property",
                    "localId" : "215",
                    "locator" : "10:17-10:23",
                    "path" : "onset",
                    "scope" : "C"
                  },
                  "localId" : "219",
                  "asType" : "{http://hl7.org/fhir}Period"
                } ],
                "localId" : "220",
                "name" : "ToInterval",
                "libraryName" : "FHIRHelpers"
              }, {
                "type" : "FunctionRef",
                "signature" : [ {
                  "type" : "NamedTypeSpecifier",
                  "localId" : "223",
                  "name" : "{http://hl7.org/fhir}Period"
                } ],
                "operand" : [ {
                  "type" : "Property",
                  "localId" : "217",
                  "locator" : "10:34-10:41",
                  "path" : "period",
                  "scope" : "E"
                } ],
                "localId" : "222",
                "name" : "ToInterval",
                "libraryName" : "FHIRHelpers"
              } ],
              "localId" : "218",
              "locator" : "10:17-10:41"
            },
            "localId" : "228",
            "locator" : "9:5-10:41",
            "alias" : "C"
          } ],
          "localId" : "229",
          "locator" : "8:3-10:41"
        },
        "annotation" : [ {
          "type" : "Annotation",
          "s" : {
            "s" : [ {
              "name" : "{urn:hl7-org:cql-annotations:r1}s",
              "declaredType" : "org.hl7.cql_annotations.r1.Narrative",
              "scope" : "jakarta.xml.bind.JAXBElement$GlobalScope",
              "value" : {
                "s" : [ "// https://github.com/cqframework/clinical_quality_language/issues/1338\n", "define ", "\"Encounter with Condition\"", ":\n  " ]
              },
              "nil" : false,
              "globalScope" : true,
              "typeSubstituted" : false
            }, {
              "name" : "{urn:hl7-org:cql-annotations:r1}s",
              "declaredType" : "org.hl7.cql_annotations.r1.Narrative",
              "scope" : "jakarta.xml.bind.JAXBElement$GlobalScope",
              "value" : {
                "s" : [ {
                  "name" : "{urn:hl7-org:cql-annotations:r1}s",
                  "declaredType" : "org.hl7.cql_annotations.r1.Narrative",
                  "scope" : "jakarta.xml.bind.JAXBElement$GlobalScope",
                  "value" : {
                    "s" : [ {
                      "name" : "{urn:hl7-org:cql-annotations:r1}s",
                      "declaredType" : "org.hl7.cql_annotations.r1.Narrative",
                      "scope" : "jakarta.xml.bind.JAXBElement$GlobalScope",
                      "value" : {
                        "s" : [ {
                          "name" : "{urn:hl7-org:cql-annotations:r1}s",
                          "declaredType" : "org.hl7.cql_annotations.r1.Narrative",
                          "scope" : "jakarta.xml.bind.JAXBElement$GlobalScope",
                          "value" : {
                            "s" : [ {
                              "name" : "{urn:hl7-org:cql-annotations:r1}s",
                              "declaredType" : "org.hl7.cql_annotations.r1.Narrative",
                              "scope" : "jakarta.xml.bind.JAXBElement$GlobalScope",
                              "value" : {
                                "s" : [ {
                                  "name" : "{urn:hl7-org:cql-annotations:r1}s",
                                  "declaredType" : "org.hl7.cql_annotations.r1.Narrative",
                                  "scope" : "jakarta.xml.bind.JAXBElement$GlobalScope",
                                  "value" : {
                                    "s" : [ "[", "Encounter", "]" ]
                                  },
                                  "nil" : false,
                                  "globalScope" : true,
                                  "typeSubstituted" : false
                                } ],
                                "r" : "211"
                              },
                              "nil" : false,
                              "globalScope" : true,
                              "typeSubstituted" : false
                            } ],
                            "r" : "211"
                          },
                          "nil" : false,
                          "globalScope" : true,
                          "typeSubstituted" : false
                        }, {
                          "name" : "{urn:hl7-org:cql-annotations:r1}s",
                          "declaredType" : "org.hl7.cql_annotations.r1.Narrative",
                          "scope" : "jakarta.xml.bind.JAXBElement$GlobalScope",
                          "value" : {
                            "s" : [ " ", "E" ]
                          },
                          "nil" : false,
                          "globalScope" : true,
                          "typeSubstituted" : false
                        } ],
                        "r" : "210"
                      },
                      "nil" : false,
                      "globalScope" : true,
                      "typeSubstituted" : false
                    } ]
                  },
                  "nil" : false,
                  "globalScope" : true,
                  "typeSubstituted" : false
                }, {
                  "name" : "{urn:hl7-org:cql-annotations:r1}s",
                  "declaredType" : "org.hl7.cql_annotations.r1.Narrative",
                  "scope" : "jakarta.xml.bind.JAXBElement$GlobalScope",
                  "value" : {
                    "s" : [ "\n    " ]
                  },
                  "nil" : false,
                  "globalScope" : true,
                  "typeSubstituted" : false
                }, {
                  "name" : "{urn:hl7-org:cql-annotations:r1}s",
                  "declaredType" : "org.hl7.cql_annotations.r1.Narrative",
                  "scope" : "jakarta.xml.bind.JAXBElement$GlobalScope",
                  "value" : {
                    "s" : [ {
                      "name" : "{urn:hl7-org:cql-annotations:r1}s",
                      "declaredType" : "org.hl7.cql_annotations.r1.Narrative",
                      "scope" : "jakarta.xml.bind.JAXBElement$GlobalScope",
                      "value" : {
                        "s" : [ "with " ]
                      },
                      "nil" : false,
                      "globalScope" : true,
                      "typeSubstituted" : false
                    }, {
                      "name" : "{urn:hl7-org:cql-annotations:r1}s",
                      "declaredType" : "org.hl7.cql_annotations.r1.Narrative",
                      "scope" : "jakarta.xml.bind.JAXBElement$GlobalScope",
                      "value" : {
                        "s" : [ {
                          "name" : "{urn:hl7-org:cql-annotations:r1}s",
                          "declaredType" : "org.hl7.cql_annotations.r1.Narrative",
                          "scope" : "jakarta.xml.bind.JAXBElement$GlobalScope",
                          "value" : {
                            "s" : [ {
                              "name" : "{urn:hl7-org:cql-annotations:r1}s",
                              "declaredType" : "org.hl7.cql_annotations.r1.Narrative",
                              "scope" : "jakarta.xml.bind.JAXBElement$GlobalScope",
                              "value" : {
                                "s" : [ {
                                  "name" : "{urn:hl7-org:cql-annotations:r1}s",
                                  "declaredType" : "org.hl7.cql_annotations.r1.Narrative",
                                  "scope" : "jakarta.xml.bind.JAXBElement$GlobalScope",
                                  "value" : {
                                    "s" : [ "[", "Condition", "]" ]
                                  },
                                  "nil" : false,
                                  "globalScope" : true,
                                  "typeSubstituted" : false
                                } ],
                                "r" : "213"
                              },
                              "nil" : false,
                              "globalScope" : true,
                              "typeSubstituted" : false
                            } ],
                            "r" : "213"
                          },
                          "nil" : false,
                          "globalScope" : true,
                          "typeSubstituted" : false
                        }, {
                          "name" : "{urn:hl7-org:cql-annotations:r1}s",
                          "declaredType" : "org.hl7.cql_annotations.r1.Narrative",
                          "scope" : "jakarta.xml.bind.JAXBElement$GlobalScope",
                          "value" : {
                            "s" : [ " ", "C" ]
                          },
                          "nil" : false,
                          "globalScope" : true,
                          "typeSubstituted" : false
                        } ],
                        "r" : "212"
                      },
                      "nil" : false,
                      "globalScope" : true,
                      "typeSubstituted" : false
                    }, {
                      "name" : "{urn:hl7-org:cql-annotations:r1}s",
                      "declaredType" : "org.hl7.cql_annotations.r1.Narrative",
                      "scope" : "jakarta.xml.bind.JAXBElement$GlobalScope",
                      "value" : {
                        "s" : [ "\n      such that " ]
                      },
                      "nil" : false,
                      "globalScope" : true,
                      "typeSubstituted" : false
                    }, {
                      "name" : "{urn:hl7-org:cql-annotations:r1}s",
                      "declaredType" : "org.hl7.cql_annotations.r1.Narrative",
                      "scope" : "jakarta.xml.bind.JAXBElement$GlobalScope",
                      "value" : {
                        "s" : [ {
                          "name" : "{urn:hl7-org:cql-annotations:r1}s",
                          "declaredType" : "org.hl7.cql_annotations.r1.Narrative",
                          "scope" : "jakarta.xml.bind.JAXBElement$GlobalScope",
                          "value" : {
                            "s" : [ {
                              "name" : "{urn:hl7-org:cql-annotations:r1}s",
                              "declaredType" : "org.hl7.cql_annotations.r1.Narrative",
                              "scope" : "jakarta.xml.bind.JAXBElement$GlobalScope",
                              "value" : {
                                "s" : [ {
                                  "name" : "{urn:hl7-org:cql-annotations:r1}s",
                                  "declaredType" : "org.hl7.cql_annotations.r1.Narrative",
                                  "scope" : "jakarta.xml.bind.JAXBElement$GlobalScope",
                                  "value" : {
                                    "s" : [ "C" ]
                                  },
                                  "nil" : false,
                                  "globalScope" : true,
                                  "typeSubstituted" : false
                                } ],
                                "r" : "214"
                              },
                              "nil" : false,
                              "globalScope" : true,
                              "typeSubstituted" : false
                            }, {
                              "name" : "{urn:hl7-org:cql-annotations:r1}s",
                              "declaredType" : "org.hl7.cql_annotations.r1.Narrative",
                              "scope" : "jakarta.xml.bind.JAXBElement$GlobalScope",
                              "value" : {
                                "s" : [ "." ]
                              },
                              "nil" : false,
                              "globalScope" : true,
                              "typeSubstituted" : false
                            }, {
                              "name" : "{urn:hl7-org:cql-annotations:r1}s",
                              "declaredType" : "org.hl7.cql_annotations.r1.Narrative",
                              "scope" : "jakarta.xml.bind.JAXBElement$GlobalScope",
                              "value" : {
                                "s" : [ {
                                  "name" : "{urn:hl7-org:cql-annotations:r1}s",
                                  "declaredType" : "org.hl7.cql_annotations.r1.Narrative",
                                  "scope" : "jakarta.xml.bind.JAXBElement$GlobalScope",
                                  "value" : {
                                    "s" : [ "onset" ]
                                  },
                                  "nil" : false,
                                  "globalScope" : true,
                                  "typeSubstituted" : false
                                } ],
                                "r" : "215"
                              },
                              "nil" : false,
                              "globalScope" : true,
                              "typeSubstituted" : false
                            } ],
                            "r" : "215"
                          },
                          "nil" : false,
                          "globalScope" : true,
                          "typeSubstituted" : false
                        }, {
                          "name" : "{urn:hl7-org:cql-annotations:r1}s",
                          "declaredType" : "org.hl7.cql_annotations.r1.Narrative",
                          "scope" : "jakarta.xml.bind.JAXBElement$GlobalScope",
                          "value" : {
                            "s" : [ " ", "overlaps", " " ],
                            "r" : "218"
                          },
                          "nil" : false,
                          "globalScope" : true,
                          "typeSubstituted" : false
                        }, {
                          "name" : "{urn:hl7-org:cql-annotations:r1}s",
                          "declaredType" : "org.hl7.cql_annotations.r1.Narrative",
                          "scope" : "jakarta.xml.bind.JAXBElement$GlobalScope",
                          "value" : {
                            "s" : [ {
                              "name" : "{urn:hl7-org:cql-annotations:r1}s",
                              "declaredType" : "org.hl7.cql_annotations.r1.Narrative",
                              "scope" : "jakarta.xml.bind.JAXBElement$GlobalScope",
                              "value" : {
                                "s" : [ {
                                  "name" : "{urn:hl7-org:cql-annotations:r1}s",
                                  "declaredType" : "org.hl7.cql_annotations.r1.Narrative",
                                  "scope" : "jakarta.xml.bind.JAXBElement$GlobalScope",
                                  "value" : {
                                    "s" : [ "E" ]
                                  },
                                  "nil" : false,
                                  "globalScope" : true,
                                  "typeSubstituted" : false
                                } ],
                                "r" : "216"
                              },
                              "nil" : false,
                              "globalScope" : true,
                              "typeSubstituted" : false
                            }, {
                              "name" : "{urn:hl7-org:cql-annotations:r1}s",
                              "declaredType" : "org.hl7.cql_annotations.r1.Narrative",
                              "scope" : "jakarta.xml.bind.JAXBElement$GlobalScope",
                              "value" : {
                                "s" : [ "." ]
                              },
                              "nil" : false,
                              "globalScope" : true,
                              "typeSubstituted" : false
                            }, {
                              "name" : "{urn:hl7-org:cql-annotations:r1}s",
                              "declaredType" : "org.hl7.cql_annotations.r1.Narrative",
                              "scope" : "jakarta.xml.bind.JAXBElement$GlobalScope",
                              "value" : {
                                "s" : [ {
                                  "name" : "{urn:hl7-org:cql-annotations:r1}s",
                                  "declaredType" : "org.hl7.cql_annotations.r1.Narrative",
                                  "scope" : "jakarta.xml.bind.JAXBElement$GlobalScope",
                                  "value" : {
                                    "s" : [ "period" ]
                                  },
                                  "nil" : false,
                                  "globalScope" : true,
                                  "typeSubstituted" : false
                                } ],
                                "r" : "217"
                              },
                              "nil" : false,
                              "globalScope" : true,
                              "typeSubstituted" : false
                            } ],
                            "r" : "217"
                          },
                          "nil" : false,
                          "globalScope" : true,
                          "typeSubstituted" : false
                        } ],
                        "r" : "218"
                      },
                      "nil" : false,
                      "globalScope" : true,
                      "typeSubstituted" : false
                    } ],
                    "r" : "228"
                  },
                  "nil" : false,
                  "globalScope" : true,
                  "typeSubstituted" : false
                } ],
                "r" : "229"
              },
              "nil" : false,
              "globalScope" : true,
              "typeSubstituted" : false
            } ],
            "r" : "209"
          }
        } ],
        "localId" : "209",
        "locator" : "7:1-10:41",
        "name" : "Encounter with Condition",
        "context" : "Unfiltered",
        "accessLevel" : "Public"
      } ]
    }
```

birick1, 2024-04-12:
Hi @JPercival - thank you for the example.

That said, in the Bad.zip file, `localId` 309 that we need for highlighting of the HeartFailure alias is only present in the ELM annotation but not in the ELM expressions.  In addition, when this occurs a duplicate `localId` is placed within the annotation and used once in the ELM expressions - in the zip file case it is id 312 (see image)

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

Coming to the example you've provided, I think the issue is being replicated with `localId` 212 (only in the annotation) and `localId` 213 (occurs twice in the annotation).

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

What's throwing me off and giving me some uncertainty is the structure of the json you've provided seems different.  For example, in your example, there is `"value": {"s": ["with "]}`, whereas in Bad.zip it is `"s": [{"value": ["with "]}]`

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

JPercival, 2024-04-19:
For `213` it looks as though narrative chunks are not being collapsed correctly. I'll look at that.

For `212` I suspect the issue may be similar. The complete JSON has `localIds` assigned, but associated with a completely different ELM elements.

JPercival, 2024-04-22:
Hi @birick1, could you give the branch here a shot? I think we've got it resolved:
https://github.com/cqframework/clinical_quality_language/pull/1356

Closed 2024-04-23.

Thread 1349 (2024-03-29):

Incorrect tuple equality behavior

brynrhodes, 2024-03-29:
This expression currently returns false:

```cql
define Test1: Tuple { Id : 1, Name : 'John' } = Tuple { Id : 2, Name : null }
```

But tuples have no implied ordering, so this should be `null`

Test cases for this (and other tuple equality testing) are being considered for the cql-tests repository here:
https://github.com/cqframework/cql-tests/pull/3

When those tests are agreed and approved, they should be used as the source for the test for this issue

JPercival, 2024-04-11:
Are you certain this should be `null`? My reading of the spec here is that it would return false:

> For tuple types, this means that equality returns true if and only if the tuples are of the same type, and the values for all elements that have values, by name, are equal.

No mention of "null". The discussion for Codes and Concepts says it uses "tuple semantics" and the example shown implies it would be false, not null.

> The equal (=) operator for Codes and Concepts uses tuple equality semantics. This means that the operator will return true if and only if the values for each element by name are equal.

> If either argument is null, or has different components specified, the result is null.

```cql
define "Code1": Code { system: 'http://loinc.org', code: '8480-6', version: '1.0', display: 'Systolic blood pressure' }
define "Concept1": Concept { codes: { Code1 }, display: 'Concepts' }
define "Concept2": Concept { codes: { Code1 }, display: 'More Concepts' }
define "EqualIsTrue": Code1 = Code1
define "EqualIsFalse": Concept1 = Concept2
```

Notice how `Concept1` and `Concept2` vary only by the value of `display`. In the example you posted the only difference is value of `Name`. I suppose `Name` may also vary by type, since it's `System.Any` in the latter.

Thread 1380 (2024-07-09):

Duplicate Type attribute when using ElmLibraryWriter to generate JSON from Library

gregory-akins, 2024-07-09:
When using clinical_quality_language ElmLibraryWriter.java ( ./Src/java/elm/src/main/java/org/cqframework/cql/elm/serializing/ElmLibraryWriter.java ) to generate JSON from a Library that was created with org.cqframework.cql.cql2elm.CqlTranslator

In version 3.3.2, the resulting JSON was correct (ie., could be parsed by org.json.JSONObject). When using version 3.11.0, the resulting JSON is incorrect and yields the message  "Duplicate key 'type' encountered at line 308 column 20" ( Below, you can see the two "type" definitions under localId 263

```
"resultTypeSpecifier" : {
               "localId" : "262",
               "type" : "ListTypeSpecifier",
               "elementType" : {
                  "localId" : "263",
                  "type" : "ChoiceTypeSpecifier",
                  "type" : [ ],
                  "choice" : [ {
                     "localId" : "264",
                     "name" : "{urn:healthit-gov:qdm:v5_6}PositiveEncounterPerformed",
                     "type" : "NamedTypeSpecifier"
                  }, {
                     "localId" : "265",
                     "name" : "{urn:healthit-gov:qdm:v5_6}PositiveInterventionPerformed
[3.3.2-LibraryJson.json](https://github.com/user-attachments/files/16144388/3.3.2-LibraryJson.json)
[3.11.0-LibraryJson.json](https://github.com/user-attachments/files/16144389/3.11.0-LibraryJson.json)
[3.3.2-LibraryJson.json](https://github.com/user-attachments/files/16144406/3.3.2-LibraryJson.json)
[3.11.0-LibraryJson.json](https://github.com/user-attachments/files/16144407/3.11.0-LibraryJson.json)
",
                     "type" : "NamedTypeSpecifier"
                  } ]
               }
            },
```

I haven't determined whether the problem is with the translator, or the Writer.

The error seems to occur when CQL contains UNION

```
library MAT6463GenerateElmJSON version '2.0.000'

using QDM version '5.6'

parameter "Measurement Period" Interval<DateTime>

context Patient

define "IPP":
  true
define "Undefined Encounter":
 ["Encounter, Performed"]
define "Undefined Intervention":
 ["Intervention, Performed"]
 define "Union of UnDefined":
 ("Undefined Encounter" union "Undefined Intervention")

```

[3.3.2-LibraryJson.json](https://github.com/user-attachments/files/16144439/3.3.2-LibraryJson.json)
[3.11.0-LibraryJson.json](https://github.com/user-attachments/files/16144440/3.11.0-LibraryJson.json)

gregory-akins, 2024-07-31:
@hossenlopp I'm not seeing where this was mentioned in https://github.com/cqframework/cql-execution/pull/320

But it's impacting our ability to incorporate anything from cqframework 3.6.0 or greater into MADiE. Can I provide any additional information, or do any additional research to help debug this issue?

hossenlopp, 2024-07-31:
I mentioned this issue in https://github.com/cqframework/cql-execution/pull/320 since that PR updated our testing deck to be translated with cql-to-elm 3.12.0 this issue broke a handful of tests. I had to manually remove the duplicate `type` attributes, specifically around ChoiceTypes, in the translated ELM to get the tests to have valid data for input.

There is no way for us to create a workaround in `cql-execution` as it would require replacing the built in `JSON.parse()` function which would be an unreasonable amount of work. This fix needs to be made in the translator.

JSRankins, 2024-07-31:
@hossenlopp Do you know if this has been submitted as a ticket to https://github.com/cqframework/clinical_quality_language? cc @brynrhodes

Closed 2024-08-16.

Thread 1392 (2024-07-29):

Retrieval of DomainResource should warn/error

jbyrdevans, 2024-07-29:
Expectation is that DomainResource type should not be retrievable since it is an abstract resource. No warnings/errors encountered with the following CQL:

```cql
library Foo

using FHIR version '4.0.1'

include FHIRHelpers version '4.1.000'

context Patient

define "Bar":
  [DomainResource] // should be marked non-retrievable, should give error/warning in translator
```

Closed 2024-08-26.

Thread 1400 (2024-08-14):

patientBirthDatePropertyName marked as deprecated but still required for SystemFunctionResolver

Zylox, 2024-08-14:
Some time ago, https://github.com/cqframework/clinical_quality_language/pull/439/commits/7b8f43536555e7b75dc40bfd8eb959617382a44f marked `patientBirthDatePropertyName` as deprecated within the modelinfo schema.

As such, i would expect to be able to omit it from the model info header if i define the patient context in my model info:
```
    <ns4:contextInfo name="Patient" keyElement="id" birthDateElement="birthDatetime">
        <ns4:contextType modelName="Example" name="Patient"/>
    </ns4:contextInfo>
```
Compiled against cql like this:
```
library example_1

using example

context Patient

define "patients":
    AgeInYears() > 18
```
I would expect success.

However i get this instead
```
Error:[8:5, 8:16] Cannot invoke "String.indexOf(int)" because "birthDateProperty" is null
```

The problem seems to lie in this snippet here: https://github.com/cqframework/clinical_quality_language/blob/dfafdb933f23ab54ce750c4ed1d6d1bf910e9bed/Src/java/cql-to-elm/src/main/java/org/cqframework/cql/cql2elm/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

This code is still looking specifically at the information in the modelinfo header.

The "simple" fix seems like it would be to call getContextInfo() and retrieve the birthDateElement from one of the contexts returned. That would require it to be context aware to work properly, i think. Which is not information that i see readily available to the class right now.

Looking at the cql spec here: https://cql.hl7.org/07-physicalrepresentation.html
i do see a clause that seems to describe an alternate behavior to what is happening here, under "Context Information":
> For patient contexts, Patient Birth Date information must be supplied as well to allow the CQL-to-ELM translator to render references to patient-age-related functions (AgeInYears, AgeInYearsAt, etc.) into the non-patient-aware age-related functions in ELM (CalculateAgeInYears, CalculateAgeInYearsAt, etc.). This information is not required, but if it is not present, references to patient-age-related functions will be passed directly through to ELM as FunctionRefs.

I'm fairly green to the project, i fully admit i could be missing something, but i couldnt find any reference to this elsewhere so im logging this for at least a discussion/explanation of it.

JPercival, 2024-12-19:
I think your assessment is correct. The `FunctionRef` would need to have context information attached to it. That information is available in the compiler at the point the `FunctionRef` is created, but it's not on that class. That said, I'm going to noodle on this a bit. In cases where the `FunctionRef` points to a function that's _not_ system defined, the context is available on the corresponding `FunctionDef`. So this is something that impacts system-defined functions only. There also may be some implication here for cross-context function calls I need to think through.

Thread 1407 (2024-08-27):

CQL Expand Valueset Issue

SeenaFa, 2024-08-27:
The issue/error that I'm getting is the following:
Expected ExpandValueSet(ValueSet), Found ExpandValueSet(java.util.ArrayList)

What I'm trying to do is check an Observation.code against the ValueSet via a function call. The function calls/uses fluent functions to do the check but the function arguments are taking a List<System.Code>

`library IssueExpandValueSet

using FHIR version '4.0.1'

include FHIRHelpers version '4.0.1' called FHIRHelpers
include IssueExpandValueSet_Concepts called Concepts

context Patient

define "Valueset": Concepts."Garb"

define "Garb Test Fails": "Has Garb Test Fails"([Observation])

define "Garb Test Works": "Has Garb Test Workaround"([Observation])

define function "Has Garb Test Fails" (obs List<Observation>):
    obs."With any code"(Concepts."Garb")

define function "Has Garb Test Workaround" (obs List<Observation>):
    obs."With any code"(Concepts."Garb" as System.ValueSet)

define fluent function "With any code"(observations List<FHIR.Observation>, codes List<System.Code>):
    if observations is null or codes is null then null
    else
        (observations) observation
        where observation.code."Has"(codes)

define fluent function "Has"(codeableConcept FHIR.CodeableConcept, codes List<System.Code>):
    if codeableConcept is null or codes is null then null
    else
        exists(
            (codeableConcept.coding) coding
            where coding in codes
        )`

I discovered a workaround, that isn't ideal, but is demonstrated in the define called "Has Garb Test Workaround"

I'm not sure what is happening and why the error is occurring.

I also attached a zip file containing the cql libraries, valueset, and test case to reproduce the error and also demonstrate the workaround.

[IssueExpandValueSet.zip](https://github.com/user-attachments/files/16767508/IssueExpandValueSet.zip)

Closed 2024-08-30.

Thread 1408 (2024-08-27):

CQL Fluent Functions Overload function name

SeenaFa, 2024-08-27:
When overloading a fluent function, using the same function name but different arguments, it seems that the order in which the functions appear in the CQL library matters.

Below is an example showing how you get different results when ordering the fluent functions:

`library IssueFluentFunctions

using FHIR version '4.0.1'

context Patient

define "EobFluentFunctionError": ([ExplanationOfBenefit]).ffoverload()

define fluent function ffoverload(eob List<ExplanationOfBenefit>):
    eob.item.serviced.value

define fluent function ffoverload(obs List<Observation>):
    obs.effective.value

////////////////////////////////////////////////////////////////////////////////////

define "EobFluentFunctionError2": ([ExplanationOfBenefit]).ffoverload2()

define fluent function ffoverload2(obs List<Observation>):
    obs.effective.value

define fluent function ffoverload2(eob List<ExplanationOfBenefit>):
    eob.item.serviced.value`

The results are as follows:

Patient=Patient(id=SamplePatient1)
EobFluentFunctionError=[]
EobFluentFunctionError2=[2023-03-31]

Not sure what the expected behavior is but the expected result is that the date should be returned for both.

[IssueFluentFunctions.zip](https://github.com/user-attachments/files/16769375/IssueFluentFunctions.zip)

Closed 2024-09-16.

Thread 1412 (2024-09-11):

CQL Has Code in ValueSet issue

SeenaFa, 2024-09-11:
The issue I'm encountering is that I'm getting a **false** value but should be getting **true** when checking if a code is in a ValueSet or not.

What I'm trying to do is check an Observation.code against the ValueSet via a function call. The function calls/uses fluent functions to do the check. I tried breaking down each step of the function calls to see if I can isolate the problem but was unable to.
I found that when I call the fluent function(s) directly, I get a "null" value and not sure why that is. Below is a snippet of the CQL but have also attached a zip file containing the CQL library and test case.

`library IssueObservationCode

using FHIR version '4.0.1'

include FHIRHelpers version '4.0.1' called FHIRHelpers
include IssueExpandValueSet_Concepts called Concepts

context Patient

define "ObservationsList": [Observation]

define "Observations Garb": [Observation: Concepts."Garb"]

define "test function": "Has garb"("ObservationsList")

define "test fluent": "ObservationsList"."Obs garb during"()

define "test fluent has": "ObservationsList"[0].code."Has"(Concepts."Garb" as System.ValueSet)

define function "Has garb"(obs List<Observation>):
    exists(obs."Obs garb during"())

define fluent function "Obs garb during"(observations List<FHIR.Observation>):
        observations
            ."With any code"(Concepts."Garb" as System.ValueSet)

define fluent function "With any code"(observations List<FHIR.Observation>, codes List<System.Code>):
    if observations is null or codes is null then null
    else
        (observations) observation
        where observation.code."Has"(codes)

define fluent function "Has"(codeableConcept FHIR.CodeableConcept, codes List<System.Code>):
    if codeableConcept is null or codes is null then null
    else
        exists(
            (codeableConcept.coding) coding
            where coding in codes
        )`

[IssueObservationCode.zip](https://github.com/user-attachments/files/16969563/IssueObservationCode.zip)

antvaset, 2024-10-02:
Hi @SeenaFa, I can replicate this issue using the latest version of the extension, and it's related to https://github.com/cqframework/clinical_quality_language/issues/1407 (which we fixed in https://github.com/cqframework/clinical_quality_language/pull/1409).

The issue had to do with the imported valueset being expanded prematurely during execution. Only external valuesets were affected and not the ones defined in the library. So if I bring `valueset "Garb": 'garb'` into the `IssueObservationCode` library and re-run the CQL, I get
```
Patient=Patient(id=Patient1)
ObservationsList=[Observation(id=lead-observation-1)]
Observations Garb=[Observation(id=lead-observation-1)]
test function=true
test fluent=[Observation(id=lead-observation-1)]
test fluent has=true
```
as expected.

Once the extension is updated, external valuesets should work as intended.

antvaset, 2024-11-06:
Resolved in version 0.7.3 of the extension.

Closed 2024-11-06.

Thread 1429 (2024-10-29):

Feature request to make LibraryManager.tryCompiledLibraryElm public, not an issue

justin-A6, 2024-10-29:
If it will not cause a problem, is there any way [LibraryManager.tryCompiledLibraryElm](https://github.com/cqframework/clinical_quality_language/blob/master/Src/java/cql-to-elm/src/main/java/org/cqframework/cql/cql2elm/LibraryManager.java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) can be made public so that we can use the precompiled elm in the Library resources to populate the LibraryManager and not have to translate the cql? Thanks!

JPercival, 2024-12-19:
Apologies for the delay. Are you seeing a scenario where the ELM is not used or ignored? It's _supposed to_ prioritize using the ELM if it's present current.

Thread 1441 (2024-11-12):

CQL Union operator appears to be broken.

dand9959, 2024-11-12:
There appears to be an issue with how Union works...

The scenario below was created in VSCode using the CQL Extension v0.6.0  (The latest version of the extension doesn't work on my environment, so someone needs to try to reproduce in v0.7.3, and/or also outside of VSCode  to determine if this behavior is because of the CQL extension or is in the language itself. )

The measure and test case used are arbitrary, but should have a single Procedure resource that can be referenced by the selector as such:

` ["Procedure"]`

Below are two defines, one that selects Procedures and one that selects Observations.  In this scenario, there
is a single Procedure resource and no Observation resources.  Also note the define that is a simple a Union of those two define results:

    define "ORIG-Proc1":
	  ["Procedure"]

	define "ORIG-Assess1":
	  ["Observation"]

	define "ORIG-UnionOfProc1AndAssess1":
	  "ORIG-Proc1"
	  union "ORIG-Assess1"

and here is the output when doing 'Execute CQL' on the measure cql file:

	ORIG-Proc1=[Procedure(id=Procedure-1)]
	ORIG-Assess1=[]
	ORIG-UnionOfProc1AndAssess1=null

The result of the union returns null, even though it should be a list of the single procedure.

Now here is a "fixed" version of those same defines. The ONLY difference is that the procedure and observation selects bind
their results to a local variable (notp and nota, respectively).

```
        define "FIXED-Proc1":
	  ["Procedure"] notp

	define "FIXED-Assess1":
	  ["Observation"] nota

	define "FIXED-UnionOfProc1AndAssess1":
	  "FIXED-Proc1"
	  union "FIXED-Assess1"
```

Here is the output:

```
        FIXED-Proc1=[Procedure(id=Procedure-1)]
	FIXED-Assess1=[]
	FIXED-UnionOfProc1AndAssess1=[Procedure(id=Procedure-1)]
```

Here, the above Union operation returns a list with the procedure, as expected.

But things are not as fixed, as they seem. The Procedure returned in the union operation is malformed.

Consider the following define that uses the above "fixed" union result to get the Procedure and returns a tuple of that procedure's elements:

	define MalformedProcedure:
	  (singleton from "FIXED-UnionOfProc1AndAssess1") theProcedure
	  return  Tuple {
		  resource: theProcedure,
		  id: theProcedure.id,
		  code: theProcedure.code,
		  performed:theProcedure.performed
		}

Here is the output:

	MalformedProcedure=Tuple {
		"resource": org.hl7.fhir.r4.model.Procedure@41ef649
		"id": null
		"code": null
		"performed": null
	}

Now consider the following, similar, define that instead of accessing the "Procedure" from the Union result, accesses the Procedure resource directly from the ["Procedure"] selector:

```
      define WellFormedProcedure:
	  ["Procedure" ] theProcedure
	 return  Tuple {
		  resource: theProcedure,
		  id: theProcedure.id,
		  code: theProcedure.code,
		  performed:theProcedure.performed
		}
```

and note the output:

```
        WellFormedProcedure=[Tuple {
		"resource": org.hl7.fhir.r4.model.Procedure@41ef649
		"id": Procedure-1
		"code": Concept {
		Code { code: 112943005, system: http://snomed.info/sct, version: null, display: Epidural injection of anesthetic substance, diagnostic, caudal, continuous }
	}
		"performed": Interval[2026-04-11T08:00:00, 2026-04-11T10:15:00]
	}]
```

The Procedure resources selected from both of the defines above are the same (note the internal "resource" identifier), but the first version is malformed, the latter is correct.

Note: it doesn't matter what resource type(s) we are selecting.  In the above scenario we are selecting "Procedure" resources. But you could use "Patient", or "Encounter" or whatever.

antvaset, 2024-11-18:
I have v0.7.3 of the extension and can reproduce the issue with `union`. E.g. this
```
define x:
  [Observation] a
    union [Procedure] b
```
evaluates to
```
x=[Observation(id=obs-1), Procedure(id=proc-1)]
```
while this
```
define x:
  [Observation]
    union [Procedure]
```
gives
```
x=[]
```
However I can successfully create a Tuple with the elements from the procedure from the union. E.g.
```
define x:
  [Observation]
    union [Procedure] b

define y:
  (singleton from x) z
    return Tuple {
      resource: z,
      id: z.id,
      code: z.code,
      performed: z.performed
    }
```
gives
```
x=[Procedure(id=proc-1)]
y=Tuple {
	"resource": org.hl7.fhir.r4.model.Procedure@172c09c5
	"id": Procedure/proc-1
	"code": org.hl7.fhir.r4.model.CodeableConcept@5bfe90b4
	"performed": org.hl7.fhir.r4.model.Period@35ab1ab4
}
```

JPercival, 2024-12-19:
Resolved by #1480

Closed 2024-12-19.

Thread 1454 (2024-11-25):

BaseFhirTypeConverter Does Not Support Integer Intervals

jreyno77, 2024-11-25:
toFhirInterval does not support Integer Intervals:

Cql: `define "AnyInterval": Interval[2, 7]`

```
switch (getSimpleName(value.getPointType().getTypeName())) {
            case "Date":
            case "DateTime":
                return toFhirPeriod(value);
            case "Quantity":
                return toFhirRange(value);
            default:
                throw new IllegalArgumentException(String.format(
                        "Unsupported interval point type for FHIR conversion %s",
                        value.getPointType().getTypeName()));
        }
```

JPercival, 2024-12-02:
There's no mapping defined for an FHIR Period or Range using FHIR Integers. See the mapping spec here:
https://build.fhir.org/ig/HL7/cql-ig/conformance.html#conformance-requirement-4-3

Closed 2024-12-02.

Thread 1460 (2024-12-03):

RetrieveEvaluator doesnt pass on valueset version to DataProvider/RetrieveProvider

Zylox, 2024-12-03:
The retrieve evaluator has access to the valueset version when it resolves the valuesetRef here: https://github.com/cqframework/clinical_quality_language/blob/dfafdb933f23ab54ce750c4ed1d6d1bf910e9bed/Src/java/engine/src/main/java/org/opencds/cqf/cql/engine/elm/e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

As that code shows, it then extracts ONLY the id when passed to the DataProvider below: https://github.com/cqframework/clinical_quality_language/blob/dfafdb933f23ab54ce750c4ed1d6d1bf910e9bed/Src/java/engine/src/main/java/org/opencds/cqf/cql/engine/elm/e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

This leads to a situation where it is ambiguous what version of the valueset is to be used by the retreive/data provider.

It is NOT ambigious when referenced as part of an expression: https://github.com/cqframework/clinical_quality_language/blob/542c919aa271fcb393be2b803814355763ab7633/Src/java/engine/src/main/java/org/opencds/cqf/cql/engine/elm/e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

It seems the simplest solution would be to pass the ValueSet object in place of the valuesetId string, the retreiveprovider can strip it down to just the id if that is desired.

JPercival, 2024-12-19:
Yes. This is a change we'd like to the `DataProvider` API.

My current thinking on this is to convert the long list of method arguments into a `RetrieveParams` object:

```
class RetrieveParams {
   get/set context,
   get/set contextPath,
   etc..
}

List<Object> retrieve(RetrieveParams params);
```

Same for the terminology where applicable. That will make it easier to expand and/or modify the parameters going forward, and to add a batch/multi retrieve overload:

```
List<List<Object>> retrieve(List<RetrieveParams> params);
```

Probably wouldn't literally use a list of lists. That's just conceptual. But the point is that we could batch data requests to the underlying platform for fewer round-trips.

Zylox, 2024-12-19:
Being able to batch those could really benefit my use case's performance, I like that a lot.

Thread 1469 (2024-12-13):

InValueSetEvaluator and AnyInValueset return null when a passed in code is null, contrary to the current cql spec

Zylox, 2024-12-13:
Looking through the version history, returning null in this case was the spec at one point. The last reference i could find to that was in STU2: https://cql.hl7.org/STU2/09-b-cqlreference.html#in-valueset

Since the version below however, the spec says it should return false in the situation where the code is null: https://cql.hl7.org/2018May/09-b-cqlreference.html#in-valueset

The effected areas, to the best of my knowledge, would be here: https://github.com/cqframework/clinical_quality_language/blob/master/Src/java/engine/src/main/java/org/opencds/cqf/cql/engine/elm/executing/InValueSetEvaluator.java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

and here: https://github.com/cqframework/clinical_quality_language/blob/master/Src/java/engine/src/main/java/org/opencds/cqf/cql/engine/elm/executing/AnyInValueSetEvaluator.ja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

The change itself would be minor, but the effect could be larger. Though it would seemingly be more in line with the cql spec.

JPercival, 2024-12-13:
Thanks for the report! Related to #1048

JPercival, 2024-12-13:
Most recent published spec: https://cql.hl7.org/09-b-cqlreference.html#in-valueset

Closed 2024-12-16.

Thread 1486 (2025-01-09):

Allow a custom implementation of the State Cache

Zylox, 2025-01-09:
I was investigating the performance characteristic of a cql algorithm we had authored, and noticed that if i passed in a particularly ordered list of expressions to the cqlengine's `evaluate`, i would get better performance characteristics for the same results.

Looking into it more deeply, i realized that the `Cache` implementation used for expression caching is ONLY caching the 15 most recent expressions(per library). Source: https://github.com/cqframework/clinical_quality_language/blob/master/Src/java/engine/src/main/java/org/opencds/cqf/cql/engine/execution/Cache.java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

We have many algorithms that have dozens of defines calculating sub-sections of logic that are then needed in a final "culmination statement" (usually a long boolean expression). The intermediate defines also have to be queried for operational and support reasons. So for our use case, an unbounded cache gives optimal performance for very little actual effect on our memory profile.

I repackaged my jar to manually override the class with a `Cache` implementation with unbounded maps, and it produced the expected results in a significantly faster timeline.

The problem i face is that i have no way to configure the state with my version of the cache, i had to resort to class loading shenanigans since the State object directly instantiates the cache: https://github.com/cqframework/clinical_quality_language/blob/master/Src/java/engine/src/main/java/org/opencds/cqf/cql/engine/execution/State.java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

One solution could be allowing the cache to have its backing maps configured, but i think the best solution would be to refactor the Cache to be an interface, with the current implementation being the default impl. This would allow users to back this cache with whatever technologies make the most sense for the stack they are running with, and also encode other logic in if needed.

I'm very open to discussion on the topic, and am interested in providing a pull if refactoring as an interface makes sense to others.

Thread 1497 (2025-02-06):

Unexpected behavior for Quantity without a code

brynrhodes, 2025-02-06:
In the following library:

```cql
library TestQuantity

using FHIR version '4.0.1'

include FHIRHelpers version '4.0.1'

context Patient

define TestQuantity: FHIRHelpers.ToValue(FHIR.Quantity { value: FHIR.decimal { value: 1001 }, unit: FHIR.string { value: 'mg/dL' } }) >= 200 'mg/dL'
```

The TestQuantity expression unexpectedly returns `null`, when according to the logic in the FHIRHelpers library, the `unit` element should be treated as a UCUM unit unless there is explicit declaration that it is not.

brynrhodes, 2025-02-06:
Note that this is somewhat related to this issue:

https://github.com/cqframework/clinical_quality_language/issues/961

The proposed fix is to ensure that when casting Quantity values to Quantity-sub-type values, all the elements of the Quantity are considered (as opposed to just the value and code, which is what it currently does).

This is an improvement on, but still not a complete fix for issue 961. The full fix is documented as TODOs in the FHIRModelResolver classes.

brynrhodes, 2025-02-18:
Included in 3.22.0

Closed 2025-02-18.

Thread 1504 (2025-02-25):

CqlSyntaxExceptions are not producing Library Version info

RohitKandimalla, 2025-02-25:
This is observed for a CQL that has a Syntax error, Following is the basic CQL with syntax error.

`library CMSFHIR844HybridHospitalWideMortality version '2.0.000'
using QICore version '4.1.1'
include FHIRHelpers version '4.4.000' called FHIRHelpers
parameter "Measurement Period" Interval<DateTime>
context Patient
define "Initial Population": `

Response from translator:
1. **Exception 1 - CqlSyntaxException:** cqlTranslator.compiler.exceptions.get(0).getLocator().getLibrary() has id = "CMSFHIR844HybridHospitalWideMortality" but the version field is null. Is this intentional ?
2. **Exception 2 - CqlCompilerException:** with the same error message and event that didn't have version information of the library.

Prviously MAT and current MADiE relies on this Locator information to identify the source library of the exception.

Attached a screenshot fo the above information in debugging mode

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

brynrhodes, 2025-05-20:
Included in 3.25.0

Closed 2025-05-20.

Thread 1547 (2025-05-07):

Ensure that the translator respects the specification requirement that library references are not transitive

brynrhodes, 2025-05-07:
The specification is clear that library references are not transitive:

https://cql.hl7.org/03-developersguide.html#libraries-1

The translator currently respects this by resolving through the include list in the library being compiled. However, fluent function resolution goes directly to the operator map, so it may actually be circumventing this requirement.

Add tests to ensure that both of these cases are respected appropriately by the translator, and fix the fluent function resolution if it is not respecting this requirement.

Thread 1572 (2025-06-25):

Duplicate Error Reporting: CqlSyntaxException and CqlCompilerException for Same Issue

RohitKandimalla, 2025-06-25:
MADiE team observed that for the attached CQL input, the translator is currently showing the same error message twice — once labeled as a CqlSyntaxException and again as a CqlCompilerException. Although the error itself is expected, MADiE was not anticipating this duplication and currently displays both, leading to confusion.

Could you please clarify if this behavior is expected from the library? If so, how should the MADiE team handle it to appropriately filter out duplicate exceptions without losing meaningful information?

[QiCore_CQL.txt](https://github.com/user-attachments/files/20903646/QiCore_CQL.txt)

brynrhodes, 2025-07-09:
@RohitKandimalla,  can you tell me what options you are compiling this with?
