cqframework/clinical_quality_language/shared/src/commonMain/kotlin/org/cqframework/cql/shared/serializing/BigDecimalSerializer.kt

package org.cqframework.cql.shared.serializing

import kotlinx.serialization.ExperimentalSerializationApi
import kotlinx.serialization.KSerializer
import kotlinx.serialization.descriptors.PrimitiveKind
import kotlinx.serialization.descriptors.PrimitiveSerialDescriptor
import kotlinx.serialization.descriptors.SerialDescriptor
import kotlinx.serialization.encoding.Decoder
import kotlinx.serialization.encoding.Encoder
import org.cqframework.cql.shared.BigDecimal

/** A serializer for [BigDecimal] as a string. */
object BigDecimalSerializer : KSerializer<BigDecimal> {
    override val descriptor: SerialDescriptor =
        PrimitiveSerialDescriptor("org.cqframework.cql.shared.BigDecimal", PrimitiveKind.STRING)

    @OptIn(ExperimentalSerializationApi::class)
    override fun serialize(encoder: Encoder, value: BigDecimal) {
        encoder.encodeString(value.toPlainString())
    }

    override fun deserialize(decoder: Decoder): BigDecimal {
        return BigDecimal(decoder.decodeString())
    }
}
