cqframework/clinical_quality_language/(commit log)

2014-07-18 Add sample HQMF document that references the CQL definitions of IPP and NUMER
2014-07-18 Slightly more convincing test case
2014-07-28 Update CMS146 example to be valid against current grammar
2014-08-04 Project fixes for CQL .NET prototypes for ballot submission.
2014-10-14 Remove explicit grammar rule for ValueSet constructor, implement support for ValueSetDef/ValueSetRef in CQL execution framework
2014-10-21 Add support for simple clinical requests to CQL Execution Framework
2014-10-24 Refactor CQL Execution Framework - Extracted "native" datatypes to their own coffee library - Created CodeService for interation w/ codes and value sets - Created wrapper around patient records to co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
2014-11-04 Fix age example in coffeescript execution framework
2014-11-07 updating Context class to have notion of parent so contexts can be chained while maintaing scope. Added mutlisource query implementation
2014-11-07 fixing a few stylistic issues and implementing ExpressDef caching on root patient context
2014-11-07 Adding With and Without filters to queries. Tests are a bit odd currently as Date range functions are integrated yet
2014-11-10 Add CQL execution support for milliseconds in CQL dates
2014-11-13 Refined context handling for patient information. Added patientBirthdatePropertyName to modelinfo. Added default Patient expression for Patient context. Added CqlTranslator class and refactored cql-t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
2014-11-24 Fix CQL Execution Framework to work correctly with latest CQL, ELM, and QUICK FHIR Profile work.
2014-12-02 Modify coffeescript patient to use Array.shift rather than indices.
2014-12-02 Refactored java execution engine and patient source.
2014-12-03 Fix bug with checking current patient for null when it was really undefined
2014-12-03 Remove support for primary date attributes and update QUICK model info to reflect all current Quality FHIR Profiles
2014-12-04 Add CQL Execution Framework Overview doc
2014-12-10 updating fhir modles based off of latest generation code and spec. Modified PatientSource to operate off of FHIR bundles. Updated ValueSet class to search arrays of codes. Patched FHIR.Base class wit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
2014-12-10 adding a couple of missing expressions, IsNull and NotEqual
2014-12-30 implementing arithmatic, aggregation and conditional expressions and tests Mode test is currently being skipped because instead of returning numbers when required it is returning strings. Need to fig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
2015-02-17 Update CQL execution tests to work with the new type resolution based ELMs. This means disabling some tests due to current limitations of the cql-to-elm (literal nulls don't resolve in operation sign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
2015-03-18 Tightened definition of invocation expressions in the grammar to simplify operator name resolution. Recursive expression definitions now result in an error instead of a stack overflow.
2015-03-24 Fixed an issue with implicit conversions not functioning correctly in the case that an implicit conversion could not be found. Added a test case for Code instance selector.
2015-03-30 Tightening system-defined functions based on CQL specification updates. Updating ELM function documentation.
2015-04-16 Hand-modify QUICK modelinfo w/ retrievable, identifier, primaryCode, patient info, etc. Fix tests that were broken due to changes in the model. Coffeescript execution code has NOT been updated yet-- 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
2015-04-17 Fix wrong patientClassIdentifier in QUICK modelinfo.
2015-04-17 Update/Fix coffeescript execution framework and tests to use the new QUICK model.
2015-04-20 Fix ELM outputs in examples (using wrong patient class)
2015-05-18 Remove printlns that were only for debugging
2015-07-10 ensuring that if a date before a patients birth date is evaluated for calculateAge the result will be 0
2015-07-20 Refactoring the execution Context class to support CQL Population contexts and provide additional support for included libraries in CQL documents when evaluating CQL Patient context statements.
    The execution engines Context class has been subclassed into PopulationContext and PatientContext. The PatientContext class is used as the root context when evaluating individual patients. As the PatientContext is evaluated for a single patient this allows for included libraries to cache execution results on a patient basis in the PatientContext eliminating the need to re-evaluate the statements if called upon more then once in a document.
    The PopulationContext acts as the root context for evaluati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
2015-07-23 adding a couple of addtional include library tests. Also found that functions were not completely implemented so I added the few bits that were left for those to work
2015-07-29 Improved handling of context when no using definitions are specified. Instead of being an error condition, this now results in the Patient expression being defined as null. This allows expressions th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
2015-08-25 Adding using definitions to Library object. This information can be helpful to match an arbitray json document to a PatientSource provider that supports a given model. For instance if the library in 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
2016-02-10 Fix issue where records were preserved across patients when processing queries
2016-03-29 All conversions use Convert ELM operator (instead of 'ToX' functions). Also add tests for other type operators. NOTE: This breaks the execution engine because it doesn't currently support Convert.
2016-03-29 Rebased on master. Generated ELM JSON now includes any error encountered when parsing test CQL. Fixed new CQL to ELM test case to work with rescoped LibraryManager.
2016-07-21 anatomicalLocationSite typo under DeviceApplied
    changed "anatomialLocationSite" to "anatomicalLocationSite"
2016-08-25 Added support for FHIR v1.6 (STU3 Ballot) Added support for implicit conversions in the model info. Fixed several issues with implicit conversion resolution. Added FHIRHelpers library to facilitate e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
    [account.sch, activitydefinition.sch, allergyintolerance.sch, appointment.sch, appointmentresponse.sch, auditevent.sch, basic.sch, binary.sch]
2016-09-14 Update qdm-modelinfo-5.0.xml
    Added reason element (type System.Code) to PatientCharacteristicClinicalTrialParticipant. Per QDM 5.0, this is an attribute for this datatype.
    For EncounterActive datatype, changed retrievable from "false" to "true"
2016-09-14 Update qdm-modelinfo-5.0.1.xml
    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
2016-09-29 Added reason element to PatientCharacteristicClinicalTrialParticipant in the QDM xsds.
2016-12-09 Expanding choice type support. Added case sensitivity support for models. Added FHIR 1.8 support and helpers.
    [account.sch, activitydefinition.sch, allergyintolerance.sch, appointment.sch, appointmentresponse.sch, auditevent.sch, basic.sch, binary.sch]
2017-01-09 Added support for FHIR 1.8.
    [account.sch, activitydefinition.sch, allergyintolerance.sch, appointment.sch, appointmentresponse.sch, auditevent.sch, basic.sch, binary.sch]
2017-05-24 Added locators and result type information to ELM, with switches to control output from the translator.
2017-05-24 Added Message operator to ELM and CQL to support run-time messages, warnings, traces, and errors.
2017-06-12 Fix Null Detection and Null Variable Retrieval
    Previously, if undefined was executed against IsNull it would return false. Not it returns true.
    Also fixed an issue in Context.get. Previously, if you did a get on a variable, and it *was* in the context with a value of null, the context would instead look for the variable in the parent context. Now it only looks at the parent if the variable is *undefined* in the current context. Variables that are literal null should be returned as null.
2017-06-12 Add disabled exec tests for function overloading
    The execution framework doesn't properly handle overloaded functions. This will be tricky because we'll need to discern the type of data being passed in at run-time. Will require much thought. For now, adding the test, but disabling it.
2017-06-12 Update Exec Test Cases for 1.2 Translator
    Re-built all the CQL-based test cases using the new CQL-to-ELM translator. This uncovered an issue with the execution framework's string concatenation implementation (was previously called Concat instead of Concatenation) and a bug in the translator's conversion from Quantity to Quantity. All tests pass.
2017-06-17 #127: Fixed aliases allowed to be referenced in sorts. Added $this iterator to sorts to enable sorting by the current element.
2017-07-03 Remove Java Rhino JS Execution Module
    The current source contains a Java module that wraps the javascript execution using Java Rhino. This was originally done as a proof-of-concept, but never went beyond that for a variety of reasons.
    We are now removing that module for the following reasons:
    - there is now a native Java solution at DBCG/cql_engine
    - the Rhino-based solution is no longer maintained and has broken tests
    - there are likely better approaches to wrapping JS in Java now anyway, so even as a proof-of-concept, this is now behind the times and not the recommended approach.
    See: https://github.com/cqframework/clinical_quality_language/issues/134
2017-07-07 Add logic for handling Quantity intervals When doing a compare on Quantities with a duration convert that duration to milliseconds so that different durations can be compared.
2017-07-07 Address pull request comments Moved logic for dealing with freetext to cql_qdm_patientapi. Added missing durations. Added the use of new function to all comparisons.
    Few tweaks from PR comments
    See http://download.hl7.de/documents/ucum/ucumdata.html for list of UCUM units.
    Handles CQL spec requirement that units be case-insensitive as best as possible for time units. Mega/Milli seconds pose a special challenge.
    Being explicit with converting to milliseconds
    Fix typo
2017-07-16 Additional Week-related tests
    Add tests for AgeInWeeks and SameAs with weeks. The AgeInWeeks test is currently disabled since the current cql-to-elm in this branch doesn't translate it correctly.
2017-08-07 Refactored formatter to return syntaxt errors when found in code instead of trying to correctly format every case - comment support has been limited as a result
2017-08-24 Fix bad CalculateAge unit test
    This test has been plagueing us for a while. It passes on days 1 - 16 of the current month, but fails after that. I *think* we were just off by one, so this fix should do it.
2017-08-25 #221: Changed QDM.BaseType patientId, reporter, and recorder elements to use the new QDM.Id type.
2017-08-25 minor tweak to scope just in case
2017-10-30 CQL Exec: Fixes (?) to difference and duration
    These changes fix the use case for a recent Bonnie bug, but break seven tests that were previously passing. (sigh).
2018-01-29 Bring in moment.js for DateTime DifferenceBetween
    To deal with the daylight savings time spring forward/fall back issue,
    I brought in the moment.js library. We still use the existing logic if
    the unitField is year or month, because moment.js does not use the
    boundary for those fields as its way (it is instead more like CQL's
    duration).
    Had to update one test that was assuming a timezone offset that it
    shouldn't have been.
2018-02-02 Fix example in CQL Execution Framework README
    Fixes #294, reporting that the example in the README does not work. The main issue was the format of the patient data, but other minor issues were found as well.
2018-02-02 Add primaryCodePath to FHIR 1.0.2 MedicationStatement
    Fixes #296 by setting MedicationStatement's primaryCodePath to medicationCodeableConcept. This aligns with the current definitions in FHIR 3.0.0 and 3.2.0.
2018-03-05 Fixed a readability/maintainability issue with the switch statement in Version comparisons.
2018-03-12 Bump cql-execution to v1.2.0
    Bump cql-execution version to 1.2.0 to reflect the targeted CQL
    specification version. This also reflects a jump in maturity from the
    previous 0.0.6 version. The current version is now used in the
    production Bonnie application.
2018-03-12 #195: Added UCUM unit validation to the translator. Enable on the command-line with the --validate-units switch. To enable in the translator component, pass a valid UcumService to the CqlTranslator, 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
2018-03-23 Added formatting for case statement ... small edit to build.gradle to run regression tests within IntelliJ
2018-03-29 STU1552: Clarified that ELM and CQL do not prescribe short-circuit evaluation.
2018-04-23 #332: Fixed an issue with explicit Patient definition not replacing the implicit Patient.
2018-05-03 fix patientBirthDatePropertyName instead
2018-08-19 #346: Added daysSupplied attribute to Medication, Order, Medication, Dispensed, and Medication, Discharge; Added prescriberIdentifier attribute to Medication, Order and Medication, Dispensed Added di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
2018-08-22 STU3#214: Added support for backticks as an identifier delimiter, as well as an escape character in strings and identifiers. Tightened up tests around escaping and identifiers.
2018-08-25 STU3#47: AgeInYears() function now uses the Date overload (and will force the patient birth datetime attribute to a date if it isn't already). AgeInXXX() other than years now uses the DateTime overlo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
2018-08-26 STU3#167: Switched default behavior to disable interval promotion/demotion, so that it must be enabled with translator switches, rather than disabled.
2019-04-19 STU3#1725: Noted that implies may use short-circuit evaluation.
2019-04-19 STU3#1723: Seconds and milliseconds are considered a single precision
2019-04-19 #408: Fixed retrieve incorrectly inserting a list promotion for a direct-code reference in some cases.
2019-04-19 #408: Fixed retrieve incorrectly inserting a list promotion for a dir… (#414)
    * #408: Fixed retrieve incorrectly inserting a list promotion for a direct-code reference in some cases.
2019-05-31 STU4B#22: Tightened up keyword and reserved handling in the grammar to remove ambiguity.
2019-06-09 STU4B#69: Improved description of valueSetProperty and intended use case.
2019-06-09 STU4B#54: Clarified second/millisecond precision behavior for datetime comparison.
2019-10-09 Switch to openjdk
2020-01-06 Fix issue #436 - Translator Options flow down
2020-02-27 Reverting to current FHIR 4.0.0 model
2020-03-29 STU4#1912: Noted handling of seconds and milliseconds as a combined precision for the purposes of comparison in the DateTime and Time documentation.
2020-06-16 Added code to attempt to extract the library identifier from the parsed input so far in the case of a syntax error.
2020-09-15 #567: Switched to XML 1.1 to ensure character reference for form feed is valid
2021-03-02 #587: Added a test to verify current behavior
2021-03-08 Made FHIR, QICore, QUICKFHIR, and USCore case insensitive to ensure backwards compatibility with UsingDefinitions that specify the URI and ModelInfo name as equivalent.
2021-03-22 #601: Additional updates to ELM visitor framework for 1.5 support
2022-05-04 Fixing Case Sensitive primaryCOdePath
2022-05-26 Fixing The test case to use the new annotations base type
2022-07-01 #759: Added service loader pattern for serialization frameworks (#760)
    * #759: Added service loader pattern for serialization frameworks
    * Moving moxy to cql-to-elm testImplementation
    * Adjusting the Write functions to match the style of read functions.
    * Reverting jaxb2 to 0.13.1 its newer than 1.11.1
    * Reducing XML files by not exporting null objects.
    * Added publishing configuration for new packages
2022-08-18 Fix tag parsing (#790)
    * update tag parsing
    * remove redundent
    * fix failed build
    * fix issue with last tag value ending with no space or newline
    * parameter parsing, add tests
    * fix duplicates and invalid tag
    * add invalid tag test, remove redundancy
    * refactor rename
    * update typo, add more tests
    * update tag name logic
    * add a tag test case
    * fix block comments test with preceding asterisk
    * update regex to fix space
2022-09-15 Support compiling CQL on multiple threads (#808)
2022-09-27 Fix qicore modelinfo 20 (#812)
    * #724,#789: Fixed diagnosis cardinality;fixed missing primary code paths
    # Conflicts:
    # Src/java/quick/src/main/resources/org/hl7/fhir/qicore-modelinfo-4.1.1.xml
    * Expanded retrieve translation to support the case that a primary code path is a choice of Concept and ValueSet, resulting in the union of retrieves against the code element as a Concept and the code element as a ValueSet.
    Expanded retrieve translation to support the case that a primary code path is a ValueSet, resulting in the use of a "contains" codeComparator.
    Added a special-case exception to the use of the ValueSet type for FHIRHelpers in 1.4. It won't actually use it, but it has to be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
2022-12-20 Merging the engine repository into this repository to reduce overall … (#854)
    Merging the engine repository into this repository to reduce overall number of repositories in the CQF stack
2023-01-18 Feature 850 datetime datarequirements (#1111)
    * #850: Adding optimization of datetime filters to data requirements analysis.
    * release -v2.4.0 (#844)
    * Snapshot v2.5.0 (#846)
    * release -v2.4.0
    * snapshot -v2.5.0
    * Merging the engine repository into this repository to reduce overall … (#854)
    * Create add-to-platform-project.yml (#1105)
    * #850: Enhanced data requirements analysis/gather with compile-time evaluation of date filter comparand targets. Also fixed parameter resolution issues, FHIR-CQL quantity conversion issues, and added support for parameterizatio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
2023-03-28 #1126: Fixed incorrect mapping application when expanding mappings th… (#1140)
    #1125: Fixed incorrect mapping application when expanding mappings through choice types
2023-03-28 #1134: Fixed AdverseEvent and DeviceUseStatement primary code paths i… (#1141)
    #1134: Fixed AdverseEvent and DeviceUseStatement primary code paths in QICore 4.1.1 and 5.0.0 model info
2023-03-28 #1136: Updated reasonCode to plural for MedicationNotRequested in 4.1… (#1142)
    #1136: Updated reasonCode to plural for MedicationNotRequested in 4.1.1 and 5.0.0 model info
2023-03-28 #1138: Fixed encounterProcedure sub-element extension mapping in QICo… (#1143)
    #1138: Fixed encounterProcedure sub-element extension mapping in QICore 4.1.1
2023-05-02 Nested NPM package support (#1149)
    * Updated hapi versions and data requirements provider; added nested dependency loading for npm package manager class
    * rollback hapi version update
    * Implemented logging, improved reporting (error and debug), duplication checks, and enhanced testing
    * Applying feedback - cleanup and supporting package manager injection
    * Update build.gradle
    * Updated NPMPackageManagerTest for SampleContentIG
    * Undo change, was a newer local cache issue
    ---------
2023-10-03 #1146: Added support for terminology filtering through a reference (#1228)
2023-10-13 #1243: The translator will now return a warning if a function with ov… (#1248)
    * #1243: The translator will now return a warning if a function with overloads is invoked when signature level is none
    * Renamed test
2023-10-13 #1231: Fixed target mapping not being applied correctly for plural el… (#1247)
    #1231: Fixed target mapping not being applied correctly for plural elements.
2023-10-24 Support related contexts in the CQL Engine. (#1250)
    * First commit with partial test defined.
    * Latest tweeks with suggestions from JP.
    * Fix tests with new scenario: Patient > General Practitioner > Patients from GP.
    * Changes to unit test and TODO comments in production code.
    * Correct test scenario including CQL and mock RetrieveProvider.
    * Very very very crude working implementation that probably has a bunch of edge case failures.
    * Tweak the hacky solution and do some minor refactoring.
    * Fixes worked on with JP. TODOs for more work required.
    * Optimize safety for State.enterContext and State.exitContext. Also, optimize performance for State.setContextValue.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
2023-10-25 Br fix datarequirements (#1256)
    * #1203: Fixed function references missing from logic definitions in data-requirements
    * #1202: Fixed extension access reporting as a code filter instead of a property access
    #1202: Fixed property access not being reported correctly when it occurred after the initial query context for a retrieve
    #1202: Fixed data requirements not being reported correctly when a query source was itself a nested query
    #1202: Fixed duplicate data requirements being reported for property access not directly related to a retrieve
    #1202: Fixed enableResultTypes not working in some cases
2023-10-26 #1202: Fixed collapsing data requirements not fixing up references to… (#1262)
    #1202: Fixed collapsing data requirements not fixing up references to collapsed data requirements
2023-11-15 Full implementation of detection of identifier hiding (#1277)
    * Full implementation of detection of identifier hiding, including exact and case-insensitive matches as well as a lot of new unit tests.
    * Add test that proves that 1254 is fixed.
    * Code review suggestions.
    * More code review suggestions.
2023-11-27 Remove exceptions printing stack traces (#1291)
2023-11-28 Fix DateTime initialization to always use offset from State and never from null (#1269)
    * First commit.
    * More changes with experiments.
    * Small change to test.
    * Add logging to try to figure out why the test passes on the github pipeline.
    * More logging.
    * Even more logging.
    * Refactor DateTime constructor code to enable unit tests using custom timezones and default offset dates.
    * Get rid of all known code that relies on the default timezone and instead rely on either the default offsetdatetime.
    * Run CqlInternalTypeRepresentationSuiteTest with multiple current times and timezones.
    * Throw Exceptions for null offsets in DateTime. Pass in offsets from State whene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
2024-01-18 Set up checkstyle to enforce current conventions
2024-02-16 Add Windows to PR check (#1328)
    * Add Windows to PR check
    * Script updates
    * run PR check only on code changes to PR
    * Match name of format check
    * Relax performance testing threshold for windows server
    * Whoops, fat finger
2024-08-30 Use conditional logic to select the error message for an unmatched identifier based on whether it was a case-insensitive match (#1406)
    * Copy changes in 598-non-resolved-case-mismatch-warning into a fresh branch.
    * Spotless.
    * Move inner class to outer. New enum. Factory methods. Optionals.
    * Spotless.
    * More optimization.
    * More optimization. Spotless.
    * Don't return a warning. Only use conditional logic to determine what the error message should be based on whether it's due to a case insensitive match.
    * Reverse change to make warning public, since this is no longer needed.
    * Small tweak.
2024-10-02 Enable SonarQube
2024-10-02 Add Sonarlint settings
2024-10-10 Add support for converting CQL Tuples to FHIR Parameters (#1422)
    * Adding Tuple conversion and tests
    * Conversion for CQL tuples to FHIR Parameters
    * Fix types
    * Fix some mistakes on the tests. Whoops
    * Use data-absent extension
    * Tuple updates
    * Address SonarCloud warnings
    * Added nested tuple and empty tuple handling
    * Nested and empty tuple tests
    * Updated formatting
    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
2024-11-05 Make sure `per` is set to something when visiting `expand` and `collapse` (#1425)
    * Make sure `per` is set to something when visiting `expand` and `collapse`
    * Fix test case
    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
2024-12-02 Add support for CQL Longs (#1459)
    * Add support for CQL Longs
    * Add more tests
    * Fix formatting
    * More tests
    * Fix Sonar issues
2024-12-02 Fix exception printing Stacktrace
2024-12-02 Fix stack trace
2024-12-18 #1475: Fixed mapping expansions for profile-informed authoring not re… (#1476)
    #1475: Fixed mapping expansions for profile-informed authoring not respecting signature level
2025-02-11 #1497: Fixed Quantity sub-type casting behavior removing unit and com… (#1498)
    #1497: Fixed Quantity sub-type casting behavior removing unit and comparator elements from Quantity values.
2025-04-02 #1525: Corrected inconsistency with FHIRPath comparison of empty coll… (#1526)
    * #1525: Corrected inconsistency with FHIRPath comparison of empty collections
    * Fixed engine tests
    * Fix a Sonar warning
    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
2025-04-02 Enhanced Debug Logging for Multiple Resources and Tuple Types (#1510)
    * #1509: enhanced toDebugString function to use built in join operation for Iterable types. Added pretty printing for Tuple types to make nested Tuples more readable
    * Applied Spotless
    * Fix for AnimalSniffer enforcing Java 8 (#1527)
    * Fixing RuntimeTests test
    * Cleaning up empty Tuple string representation
    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
2025-05-02 Fixed duplicate namespace loading issue when using the ig option with… (#1540)
    * Fixed duplicate namespace loading issue when using the ig option with the CLI
    * Spotless apply
    * Spotless apply
2025-05-09 #1492: Fixed the hiding and case mismatch warnings not having error l… (#1545)
    #1492: Fixed the hiding and case mismatch warnings not having error locators
2025-05-14 Support fluent functions in query sort clauses (#1549)
    * Add an alias to implicit variables to support fluent functions in sort clauses
    * Fix Sonar warnings
2025-05-22 Minor improvements and possible change for ToString(Datetime) (#1551)
    * Handle return value of Collection.binarySearch() correctly
    If the element is not found, the return value is not constantly -1 but
    instead an encoding of the position at which the element should be
    inserted.
    * When reporting invalid Interval bounds, include offending bounds
    * For DateTime, include timezone offset in printed representations
    This change affects two printed representations of the DateTime class:
    1. On the Java level, DateTime.toString() now includes the timezone
    offset
    2. On the CQL level, ToString(<DateTime>) now includes the timezone
    offset as well
    Of these two, 2. is clearly the important cha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
2025-06-05 Refactor TestFhirPath (#1567)
    * Refactor TestFhirPath
    * Enable some more tests
    * Sonar warnings
    * Further refinement of error messages
    * Mas sonar fixes
2025-07-03 Fix QR context path (#1579)
    * Fix QR context path
    * Fix sonar issues
    * Fix sonar errors
2025-07-17 Ensure IDs within CQL files match the library identifiers used. (#1586)
    * Ensure IDs within CQL files match the library identifiers used. Fix all tests to comply with this new edict. Add another test class toe exercise this logic specifically.
    * Validate identifiers for ELM as well.
    * Add debug for failing tests.
    * Try again to add debugging.
    * Resolve CQL file casing issues that only manifest themselves on Linux.
    * Add ELM tests for the versioned identifier logic with a simple ELM JSON file.
    * Fix sonar issues.
    * More sonar.
    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
2025-07-22 Ensure private access levels are checked (#1588)
    * Fixed check access level being called on null result
    * Add tests, change fix
    * Add a test for a private codesystem reference
    * fixed bad master merge
    * Fix sonar warnings
    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
2025-08-07 Use IdentityHashMaps instead of HashMaps where keys are mutated after insertion (#1593)
    * Use IdentityHashMaps instead of HashMaps where keys are mutated after insertion
    * Use IdentityHashMaps instead of HashMaps where keys are mutated after insertion
    * Use IdentityHashMaps instead of HashMaps where keys are mutated after insertion
2025-08-11 Support expression evaluation for multiple libraries at once (#1584)
    * First attempt to evaluate mulitple libraries without a cache refresh, namely, by initializing them in order and then evaluating their expressions in reverse order.
    * Remove duplicate initializeState and setParameters that was wrongly resulting in correct results. Ensure that when evaluating expressions that we pop the current library off the deque but not too soon, so the reverse order evaluation actually works. Add more TODOs.
    * Make use of the new evaluate measure code from at least one single library call. Fixed invalid error handling before. All tests pass.
    * Leave the existing single library evaluation the sa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
2025-08-11 Updated the ELM schema from the 1.5.3 errata publication. (#1594)
    * Updated the ELM schema from the 1.5.3 errata publication.
    * Add support for Descendants to compiler/engine
    * Remove accidental stack overflow
    * Add some sonar fixes
    * Updates for sonar
    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
2025-08-28 CQL Engine: Seggregate CQL compile errors from warnings and infos (#1601)
    * First attempt to segregate CQL errors and warnings/infos. No tests yet.
    * Add TODO.
    * Capture warning/hiding scenario with a proper test and change the production code to make it pass. All tests pass.
    * Code review feedback: remove dangling TODO and fix bad line number reference.
    * Rename test and add another assertion.
    * Increase test coverage and small tweaks.
    * More test coverage and sonar.
2025-10-07 Engine warning cleanup (#1624)
    * Add rewrite framework, fix detekt warnings
    * Remove checkstyle config
    * More warnings, fix tests on windows
    * Clean up ExpandEvaluator
    * Few more fixes
    * More warning cleanup
    * more fixes
    * more fixes
    * More warnings
2025-10-21 Include currentLibrary VersionedIdentifier in CQL backtrace (#1635)
    * Include currentLibrary VersionedIdentifier in cql backtrace
    * spotless updates for backtrace changes
    * detekt fixes
2025-11-17 Add a `bom` for the CQL modules. (#1642)
    * Add a bom for the CQL modules
    * Undo version bump
2025-12-04 Update the engine's evaluate API. Evaluation of expressions and functions from multiple libraries. (#1646)
    * Update the engine's evaluate API. Evaluation of expressions and functions from multiple libraries.
    * Merge fix
    * Improve test
    * Address Sonar warnings
    * Address Sonar warnings
    * Associate expression names with libraries
    * Use EvaluationResult as a map
    * Simplify list reversing
    * Comments clarifying library identifier usage
2026-01-13 Evaluation tracing (#1663)
    * Evaluation tracing WIP
    * Trace generation test
    * Small fixes
    * Refactor backtrace and evaluation trace.
2026-01-27 Perform unit conversion in equality, comparison and arithmetic operators for Quantity (and Ratio) (#1578)
    * Add another test case for equivalence of Ratios
    * Fix Equal, Equivalent for Quantity
    If the Quantity.equal method indicates that the units of the supplied
    Quantity instances are not comparable by returning null, try to
    convert the value of the "right" Quantity to the unit of the "left"
    Quantity using the UCUM service.
    And similarly for the Quantity.equivalent method with the difference
    that the Equivalent evaluator returns false if the units are not
    comparable.
    A new method Ratio.fullEquivalent accepts a State and passes it to
    EquivalentEvaluator.equivalent so that unit conversion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
2026-02-10 Expose API method to CqlEngine to allow callers to resolve the CQL-defined default value of a named parameter (#1674)
    * Claude-generated change to CqlEngine.kt to resolve the default value of a named parameter in a library. To be used by client projects that current use low-level CQL APIs to accomplish the same objective.
    * Code review change to respect idiomatic kotlin.
2026-02-11 Initial implementation of AST for CQL (#1640)
    * Checkpoint
    * Checkpoint
    * WIP
    * WIP
    * WIP
    * WIP
    * Remove some experiments that didin't work
    * WIP
    * Agents.md
    * WIP emitter
    * Remove accidentally committed file
    * Fixes for AST classes. Add parse tree and AST inspectors. (AST feature branch) (#1637)
    Fixes for AST classes. Add parse tree and AST inspectors.
    * Serialize BigDecimals as JSON strings in AST JSONs
    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
    [BigDecimalSerializer.kt]
2026-02-19 Upgrade to Gradle 9.3.1 (#1680)
    Upgrade to Gradle 9.3.1 and migrate buildSrc to build-logic
    Migrate convention plugins from buildSrc to an included build (build-logic)
    for better build cache behavior. Upgrade animalsniffer plugin to 2.0.1,
    sonarqube plugin to 7.2.2.6593, and detekt to 1.23.8 for Gradle 9
    compatibility. Handle failOnNoDiscoveredTests in tools:rewrite. Regenerate
    detekt baselines and apply spotless formatting fix.
2026-03-04 Sub-expression level detailed tracing and fix CachingModelResolverDecorator null cache bug (#1696)
    * Add sub-expression level detailed tracing and fix CachingModelResolverDecorator null cache bug
    Add EnableDetailedTracing engine option that captures every sub-expression's result in the trace tree. When enabled, visitExpression() wraps each non-filtered expression evaluation with sub-expression frame push/pop, producing a full trace of intermediate computations. A configurable filter skips trivial leaf nodes (Literal, Null, OperandRef, etc.) by default.
    * Spotless
    * Addressing detekt issues
2026-03-18 Fix: ChoiceType serialization is now deterministic (#1708)
    Fix: ChoiceType serialization is now deterministic (alphabetical order)
    ChoiceType stored its types in insertion order, making toString() and
    equality non-deterministic. Sort types alphabetically by toString() in
    flattenChoices() so serialization is stable regardless of construction order.
2026-03-18 Fix: broaden interval constant-folding to handle As-wrapped literals (#1709)
    #1707 constant-folds interval conversions for bare Interval literals,
    but some operator paths (e.g., `ends`) route through a cast+interval
    conversion chain where convertExpression wraps the Interval in an As
    cast before the interval conversion. The `expression is Interval`
    check then fails, falling back to runtime Property extraction.
    Unwrap As casts to find the inner Interval literal, enabling constant
    folding for all operator paths that produce Interval(null, null) or
    similar literal interval conversions.
    Extracted constantFoldIntervalConversion and unwrapIntervalLiteral
    helpers to keep convertIntervalExpression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
2026-03-25 ChoiceTypeSpecifier built in source order breaks signature matching after #1708 (#1711)
    * ChoiceTypeSpecifier matching should be order-independent
    * ChoiceTypeSpecifier ordering match ChoiceType sort order
    * Addressing sonar issue
    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
2026-04-23 Derive project version from git state (#1746)
    Replace the hardcoded version in gradle.properties with a git-derived
    version resolved at configuration time:
    - Tag vX.Y.Z at HEAD -> X.Y.Z (release, signed on publish)
    - On main with no tag -> latest tag's minor bumped, patch reset, -SNAPSHOT
    - Any other branch / detached -> <bumped>-<sanitized-branch>-<shortsha>-SNAPSHOT
    Also add .claude to .gitignore so Claude Code worktree state is not
    accidentally staged.
2026-05-05 Fix multi-level sort. Report test coverage for KMP projects. (#1756)
    * #1745: A secondary sort in the opposite direction shouldn't reverse the primary sort
    * Collect test coverage in KMP projects
    * Generate XML report as part of the check task
    * Generate XML report as part of the check task
    * Set report paths for SonarQube
    * Combine coverage info from relevant subprojects
2026-05-06 Treat `null`s as empty lists in the list passed to `flatten()` (#1758)
    * #1748: Treat nulls as empty lists in the list passed to `flatten()`
    * Fix `flatten()` test
    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
2026-05-08 Added selective requirements implementation (#1757)
    * Added support for parameterized terminology-valued data requirements
    * Improved data requirements inference and reporting, especially for non-valueset terminology filters.
    Added query selectivity determination
    Added an CqlCompilerOption to support whether or not to report query selectivity
    Added query selectivity extension output to DataRequirementProcessor
    * Apply suggestion from @antvaset
    * Update Src/java/elm-fhir/src/main/kotlin/org/cqframework/cql/elm/requirements/ElmQuerySelectivity.kt
    * Added implicit context query when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
2026-06-10 Feature/add debugger support (#1786)
    * add support for breakpoint handling to the engine EvaulationVistitor
    * add breakpoint handler hooks with onExpressionDefEvaluated callback
    * remove the redundant onAfterExpression override
    * revert State parameters/contextValues to v4.8 Any? signatures
    6b082c3cc cleanly merged v5 type changes (Value? and String?) into State.kt.
    Revert to Any? to stay compatible with cqf-fhir-cr on v4.8 signatures.
    * add onExpressionDefEntered callback with call-site tracking
    * wire onExpressionDefEntered/Evaluated callbacks into FunctionRef evaluation and State
    * spotless apply
2026-07-08 Fix Round for negative half-way values (#1769) (#1802)
    Removed the negative-operand HALF_DOWN special case
2026-07-08 ADR 004: Promote `Src/java` to repository root and other changes (#1797)
    * ADR 004: Move Src/cql-lm and Src/grammar to schemas and grammar
    * Move Src/java to root
    * Move Src/js to js
    * Update relative paths
    * Move Examples to examples
    * Move Examples to examples
    * Update links in README.md
    [account.sch, activitydefinition.sch, allergyintolerance.sch, appointment.sch, appointmentresponse.sch, auditevent.sch, basic.sch, binary.sch]
2026-09-05 Track evaluated resources by identity, leaving deduplication to the caller (#1837)
    * Key evaluated resources by IDs
    * Track evaluated resources by identity, leaving deduplication to the caller
    * Test fixes
    * Add unit tests for identity-based evaluated resource collection
    * Make createIdentityHashMap an identity map on JS and wasm
    * Adding tests for coverage
    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
2026-10-08 Fix ClassCastException in cql-to-elm-cli with modelinfo (#1805)
    rework anonymous object to fix ClassCastException
    [Main.kt]
2026-10-08 Enhance CLI error handling: process exit code + new flag to write even if errors (#1813)
    Use process exit code 1 if translation errors occur; add flag to write output even if errors
    [Main.kt]
2026-10-22 Fix Negate special case for the minimum Long literal (#1867)
    The special case meant to negate the Long minimum literal without
    overflow checked "9223372036854775807" (Long.MAX) instead of
    "9223372036854775808", unlike the Integer case's "2147483648". So
    -9223372036854775807L returned Long.MIN and -9223372036854775808L
    failed with "Bad format for Long literal".
    Adds Long boundary literals to CqlValueLiteralsAndSelectorsTest and
    removes LongMinValue from CQLOperationsR4Test.SKIP.
    Closes #1865.
2026-10-27 Memoize function results and fix expression cache invalidation (#1887)
    * Memoize function results and fix expression cache invalidation
    Queries that call a function inside a join (e.g. a fluent function in a
    `with`/`without ... such that`) evaluated the function body once per pair
    of rows. Function results are now memoized, keyed by the function
    definition, the current context and context value (which can change
    mid-evaluation via related-context retrieves), the caller-supplied
    parameters and evaluation date/time, and the arguments. Simple values
    and intervals are compared structurally; FHIR resources, tuples and
    lists by reference. External functions, calls that log a Message (and
    their ca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
2026-10-28 Name converted R4/R5 backbone elements by their model info type (#1892)
    * Add failing tests reproducing wrong type names for converted backbone elements
    FhirModelResolver.toCqlValue gives backbone elements the simple HAPI class
    name as their type (e.g. ContactComponent, ObservationReferenceRangeComponent)
    instead of the model info name (Patient.Contact, Observation.ReferenceRange).
    The HAPI names are not unique across resources. Claim and
    ExplanationOfBenefit both have an ItemComponent, so their items convert to the
    same type, and resolving that type back to a class depends on which match the
    FHIR context finds first. As a result, `is` tests on those elements return
    false for their own typ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
2026-10-29 Time activation frames with a monotonic clock (#1898)
    Activation frames were timed with the wall clock. When the system clock
    stepped backward during an evaluation (for example on wake from sleep), a
    frame's duration came out negative and Profile.Node.addInvocation's check
    failed. The failed pop left its frame on the stack, so every enclosing pop
    failed too, and endEvaluation's stack check replaced the original error with
    a bare "Check failed.".
    Time frames with TimeSource.Monotonic, offset from a wall-clock origin so
    times stay in epoch milliseconds, and remove the frame (and its profile node)
    in a finally so a profiling failure can't corrupt the stack.
2026-11-05 Read milliseconds correctly from time and date time literals (#1701)
    * Read milliseconds correctly from time and date time literals
    * Restrict number of millisecond digits in time and date time literals
    * Remove unnecessary `.substring()`
    * Allow any number of fractional second digits
    * Update test to illustrate that ``@T10:30:15.1238` is read as `T10:30:15.123`
    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
2026-11-13 Keep identifier positions and quoting, and parentheses, in the AST
    An Identifier is now a node with its source position and how it was quoted
    (plain, "quoted" or `delimited`), and a QualifiedIdentifier holds Identifier
    parts and its own position. Parenthesized expressions are kept as a
    ParenthesizedExpression rather than dropped. Both are needed to print the
    source back as it was written.
    The test-only NormalizingTransformer cleared locators one node type at a time
    and missed some; tests now compare trees through JSON without locators or
    identifier quoting.
2026-11-13 Print the AST back as CQL
    Printer writes a library or expression as CQL that parses to the same tree,
    apart from source positions. What the AST keeps of how the source was written
    is written the same way; the rest has one fixed layout, so printing is stable.
    Parentheses are added only where the tree needs them. Precedence follows the
    order of the grammar's alternatives; a prefix operator's operand takes the
    operators that bind at least as tightly, and `if`, `distinct`, `expand` and
    query clauses take whatever follows, so those get parentheses only when
    something follows that they would take.
    Each comment is written before the code that followed it, or before the
    closing delimiter it preced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
2026-11-13 Test the AST's traversal and the paths left untested
    AstWalker had no tests and Transformer few. Both are now checked against the
    expressions found independently in a tree's JSON: the walker must visit each
    one, and a transformer that wraps each expression it visits must leave none
    unwrapped, so it both visits them and keeps what it returns. The CQL the
    printer tests use moves to CqlSamples so these tests share it.
    Also tests the Builder, Printer and TagParser paths no test reached, and
    removes code that could never run: TemporalRelationshipPhrase.leadingQualifier,
    which the grammar never sets, and unquoting of double-quoted text, which is
    never passed in.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
2026-11-13 Report the parse trees the Builder has no case for as internal errors
    The Builder's branches for parse trees the grammar cannot produce made up
    placeholder nodes, such as a `without` clause aliased `it` whose condition is
    `true`, or an `Any` type for a type specifier it did not recognize. Each is now
    one line, `unexpected(ctx)`, which the recovery boundaries report as a Problem
    marked `internal` and turn into the same incomplete node a syntax error gives.
    The Builder still never throws, its trees contain only what the source says,
    and a change to the grammar the Builder misses shows up as a labelled internal
    error. The malformed-input and recovery tests assert that none occurs; the
    tests of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
2026-11-13 Keep a retrieve's code path as a path, with its indexes
    A code path such as `reason.coding[0]` was a qualified name, so an index
    became a name part (`0`) that printed as `reason.coding."0"`. It is now a
    SimplePath of property and index segments, each index the string or number
    literal written; the walker, transformer and printer handle it.
    The new segment kinds first took the serial name `index`, which an index
    expression already has; a test now checks that no other node shares an
    expression's kind, since expressions are found in the JSON by kind. The query
    tests move to BuilderQueryTest, as BuilderExpressionTest grew too large.
